cononinator/GeecPE2526/Simulation/LTSpice Hierarchical Design.docx

# LTSpice Hierarchical Design

I talked in the meeting about making a simulation for the Geec that can be expanded as need. Here’s a quick guide to how to make a hierarchical model in LTSpice (I’ve just spent the last 2 hours hitting my head against the wall for different parts).

# 1 Goal

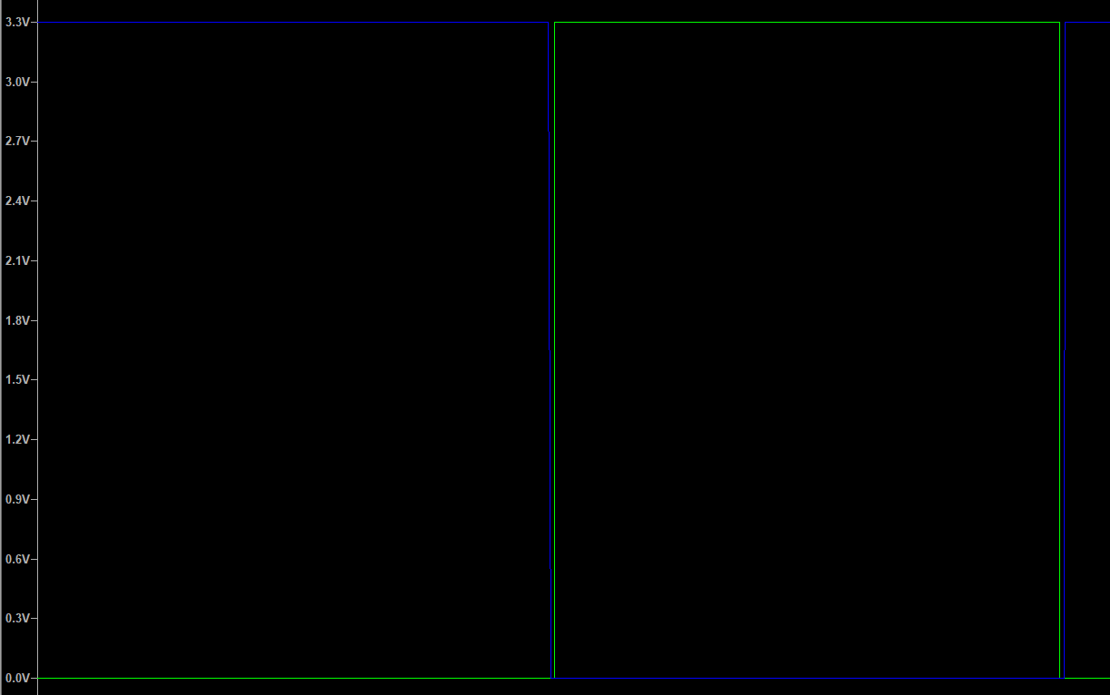
[picture p17: figure]

The goal for this part is to create a PWM generator, that will separate the high and low output signal by a short period of time (called Deadtime). This Electronic Stack Exchange (https://electronics.stackexchange.com/questions/644743/how-to-create-pwm-with-dead-time-on-ltspice) question details how the schematic should look.

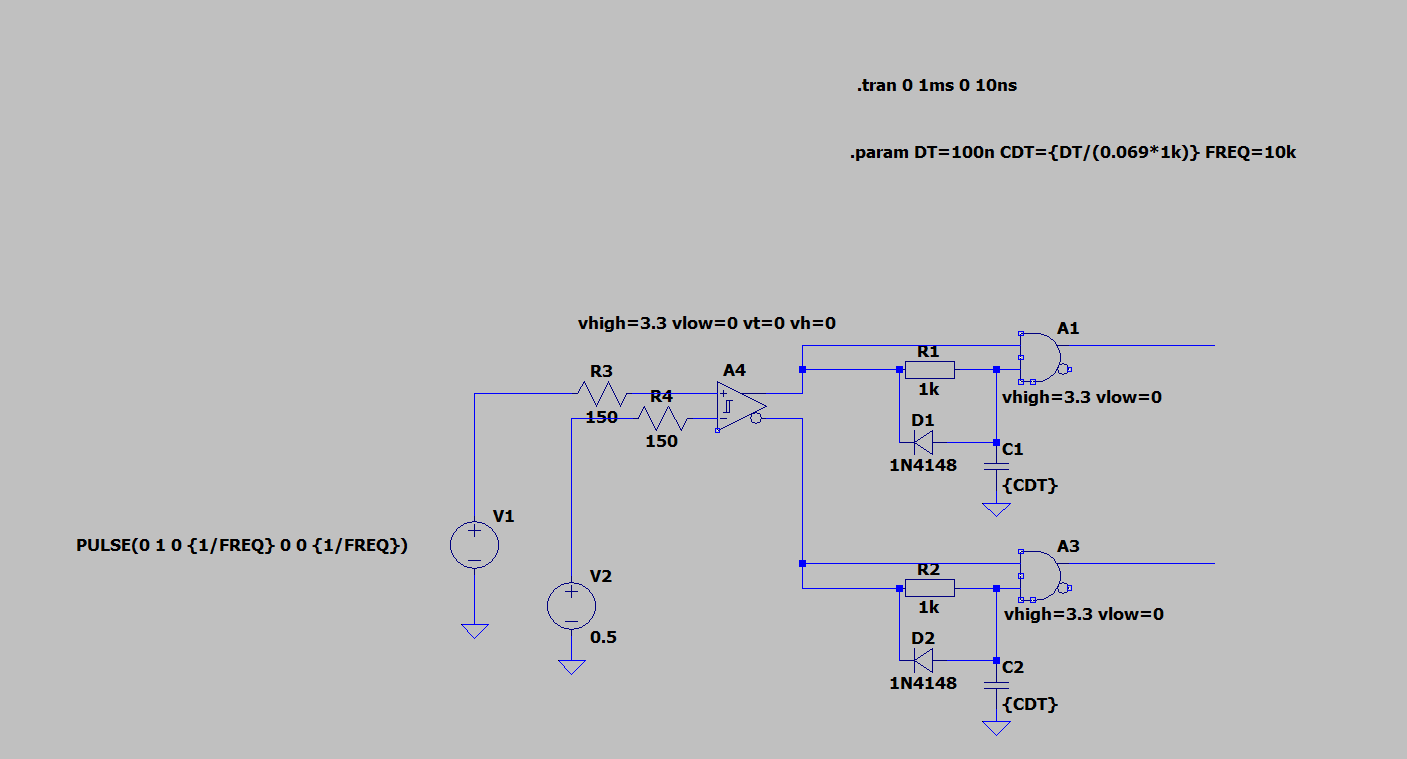
[picture p18: figure]

Here’s my implementation. V1 is a sawtooth wave, starting at 0V and going to 1V over a time of 1/FREQ. This connects to a comparator, where if V+ is greater than V- the output will be high. V2 connects to V- and sets the low limit.

Copy that file or create your own similar file. This one is called “PWMGen.asc”

FREQ is defined using the .PARAM SPICE directive.

# 2 Method

## 2.1 Replace inputs and outputs with net labels

In our case V2 should be replaced with an input pin that can go from 0-1V. Delete V2 and add a net label

Change the Port Type to input/output and change the name to something appropriate like Vset.

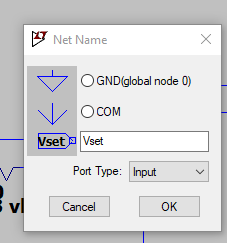
[picture p19: figure]

Repeat for PWMH and PWML

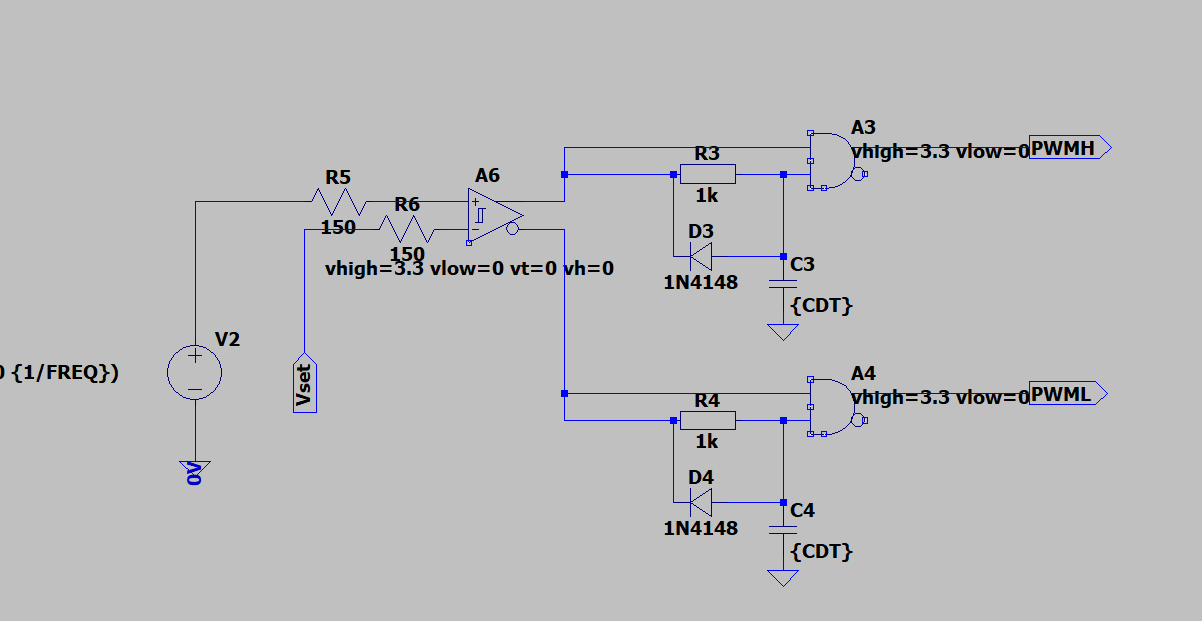
[picture p20: figure]

Resulting circuit should look like this.

## 2.2 Create a Symbol

Open or Generate this Sheet’s Symbol

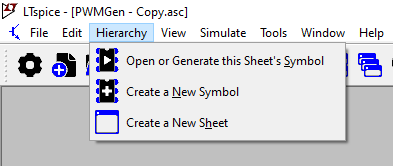
[picture p21: figure]

If you’re just creating a symbol a menu will appear, click Yes./

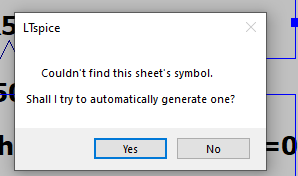
[picture p22: figure]

The auto generated symbol will appear like so:

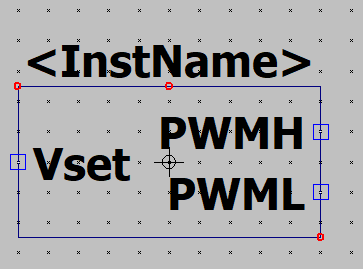
[picture p23: figure]

This is a little non-descript, so you can use the Draw menu to add some description or details to the symbol. I modified my symbol to look like so:

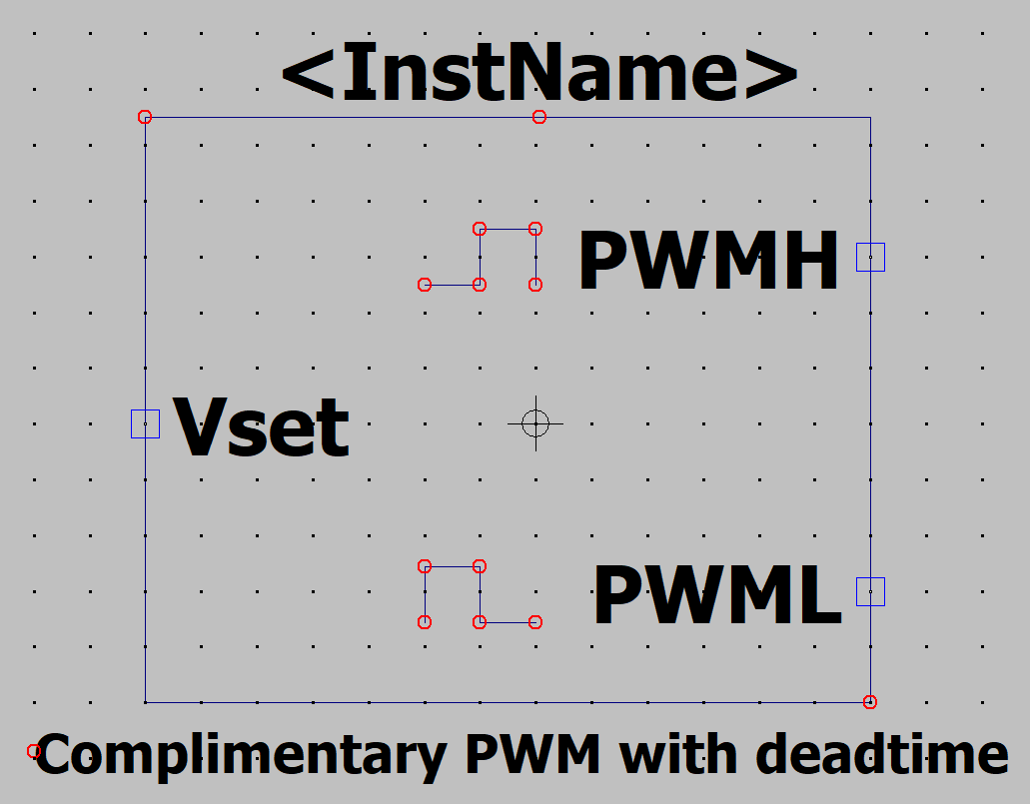
[picture p24: figure]

## 2.3 Importing into a new schematic

To add this block into a new schematic in LTSpice, create a new schematic in the same directory as the file created above. Add a part (shortcut P or the chip symbol in the hotbar).

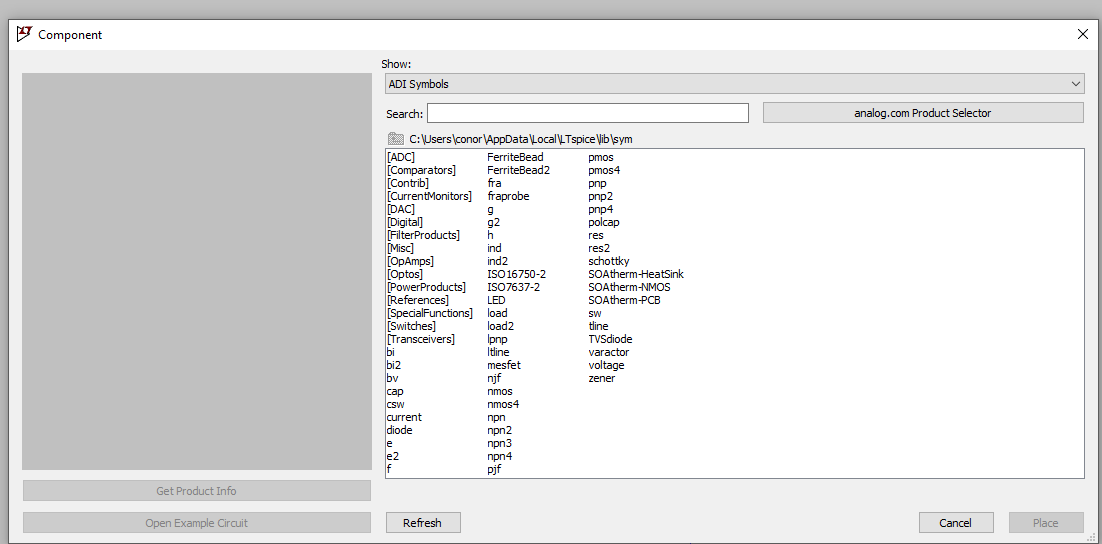
[picture p25: figure]

A menu like above will appear,

Change the Show menu to schematic directory.

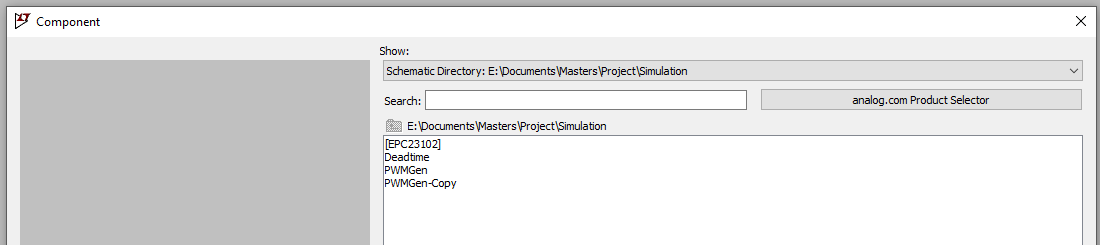
[picture p26: figure]

The part designed above should be available to add. You can then add the part to you schematic. I created this simple test schematic:

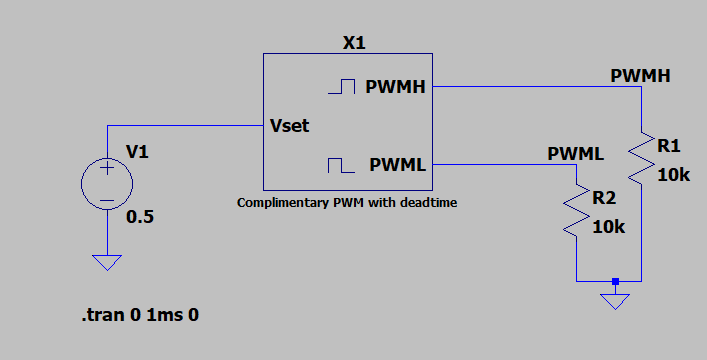
[picture p27: figure]

Which created the following graph:

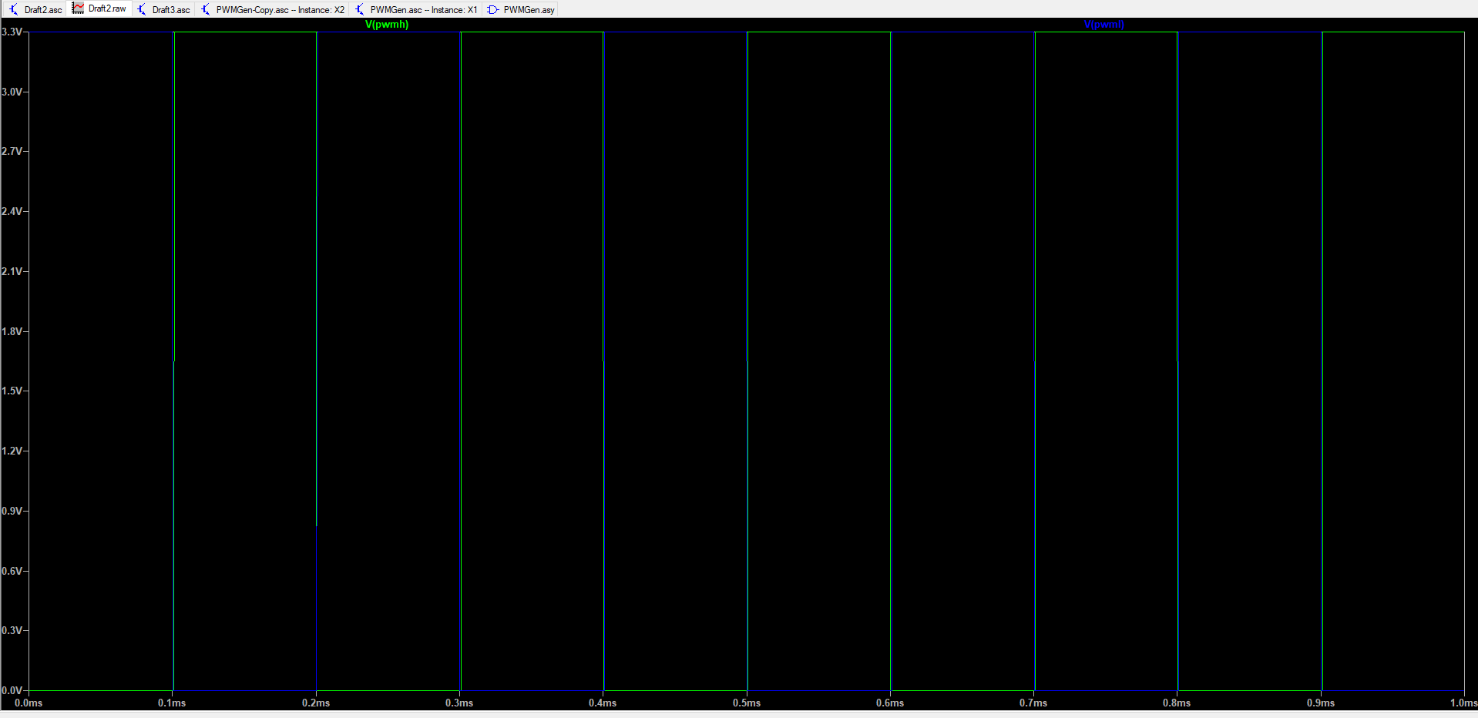
[picture p28: figure]

To keep files clearer you can also move the blocks to sub folders and still import them into LTSpice

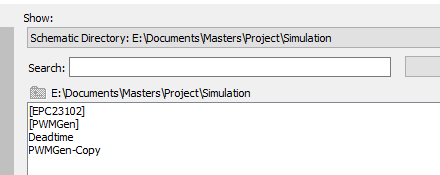
[picture p29: figure]

You need to move the symbol and schematic file into the sub folder i.e. “PWMGen.asc” & “PWMGen.asy”.
