cononinator/GeecPE2526/Write Ups/Conor Farrell Weekly Progress-07-02-26.pptx

## Conor Farrell Weekly Progress

06/02/26

## Power Electronics Bring Up

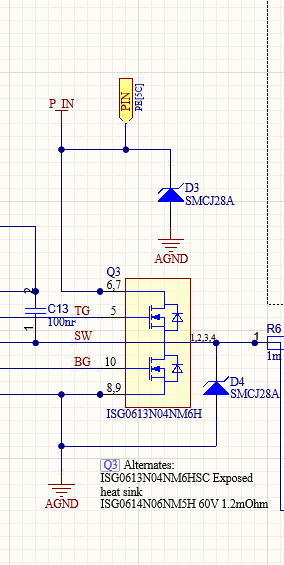
[picture p31: figure]

Problem
On power up, board went to constant current
~0.8V, 250mA(current limit)
Investigation
Checked hotspots with thermal camera. Saw U9 (Soft Start Gate Driver) was heating up.
Desoldered IC and the issue still appeared.
Checked Diode drop across TVS diodes (D3, D4) with multimeter. P_in -> AGND had a 0.6V drop, AGND->P_in was open circuit.
Solution
D3 and D4 desoldered and reorientated.

## LED Turn On

Power Rail LEDs:
- Red LEDs indicate 3.3V and 11V rails
- Power Supply drew 2mA on power up (with LEDs disconnected) @ 18V
Damage:
1 board missing U9 soft start IC. Shorted Soft Start resistor. Will use for testing as a sacrificial board.

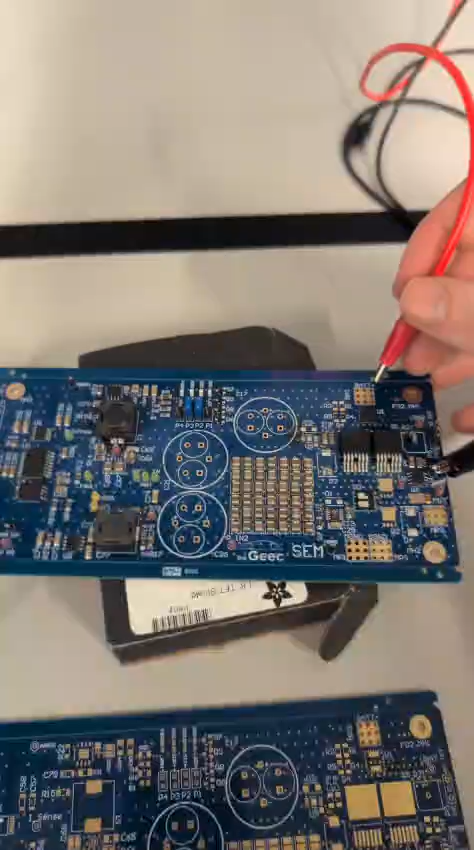
[picture p32: figure]
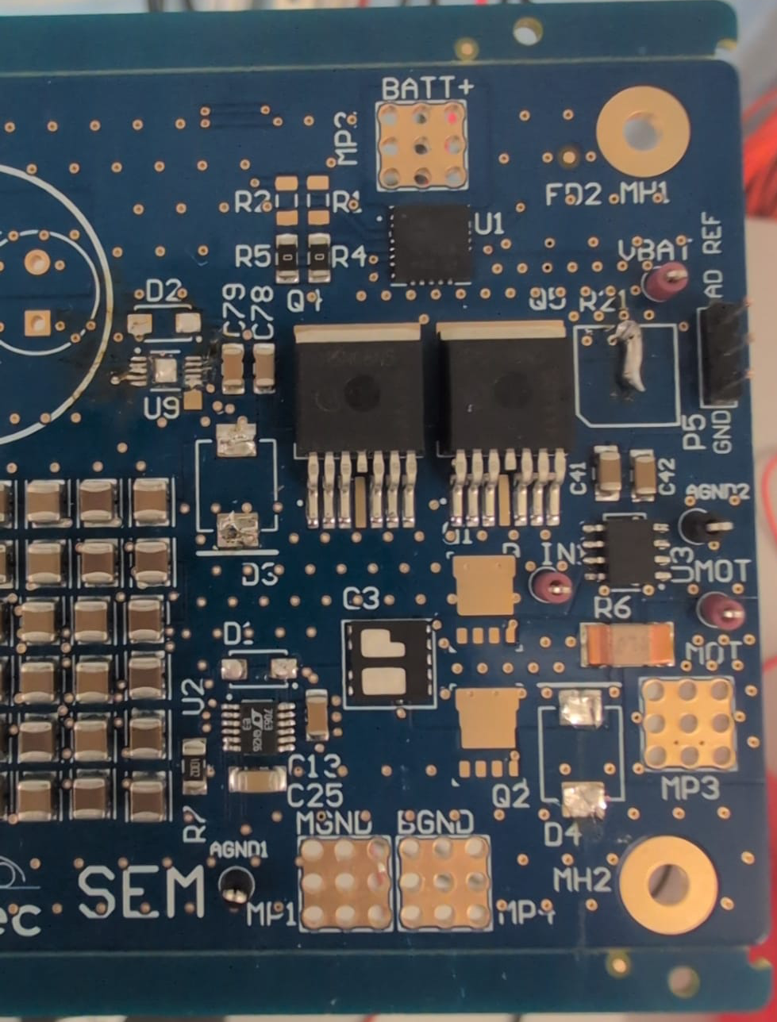
[picture p33: figure]

## Power Controller

- Circuit Design
- Altium Schematic Started, all components imported.

## Goal for Next Week

1. Track Test – (Monday) - No goals beside running the car well
2. Test Gate Drivers – Tuesday – No load Testing
3. Test Current Sensors – Thursday Morning – Minimum 2A load required
4. Build Current Controller on Breadboard – Tuesday, Wednesday, Thursday
5. Schematic Design – Finished End of Next Week
