cononinator/GeecPE2526/Write Ups/Midway Presentation.pptx

## Power Electronics For The Geec

Conor Farrell
2025-2026
MECE - 21359763

## Project Overview

- The GEEC (Galway Energy Efficient Car) is a participant in the Shell Eco Marathon.
- It’s entered in the prototype lithium-ion class.
- The highest score GEEC achieved was 354km/kWh or 23c to drive from here to Dublin.
Power Electronics Requirements:
- Drive an Electric Motor.
- Take Throttle input from the driver
- Fail Safe

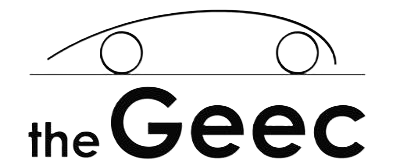
[picture p34: figure]
GEEC Logo

Notes: BG
GEEC – SEM prototype lithium ion
DAQ – voltage current power speed temp gps
Driver display
Benefit to mechanicals

## Current Power Electronics

- Inflexible
- Obsolete Components
- 2 Layer Design
- Large Loop Area, resulting in LC resonator
- Field Modifications

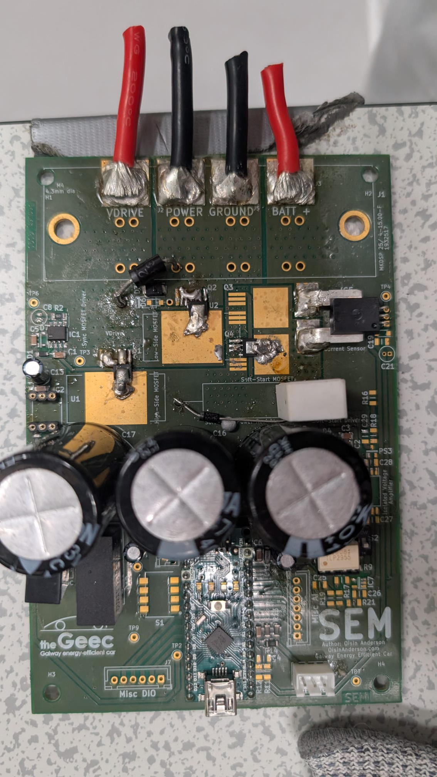
[picture p35: figure]

## The Project Scope

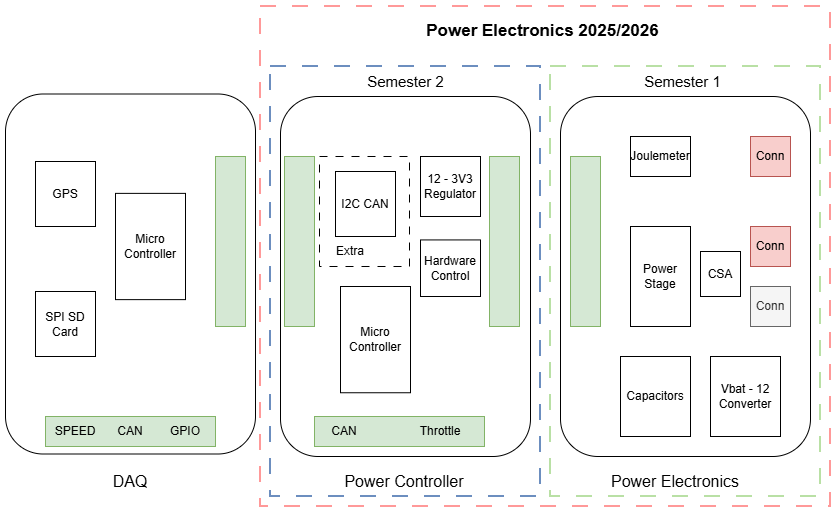
[picture p36: figure]

Semester 1:
Power Electronics
- 4 layer SMD
- Full isolation
Semester 2:
Power Controller
- 2 layer THT
- Closed Loop Feedback

## Brushless Motors

- Previous Projects Investigated Brushless Controllers & 48V control
- Theoretical Calculations show worse performance ~2%

## Current Control

- Hardware Limiting:
  - Cycle-by-Cycle (10-30kHz)
  - Latching
- Software Control:
  - ~10Hz
  - PID loop

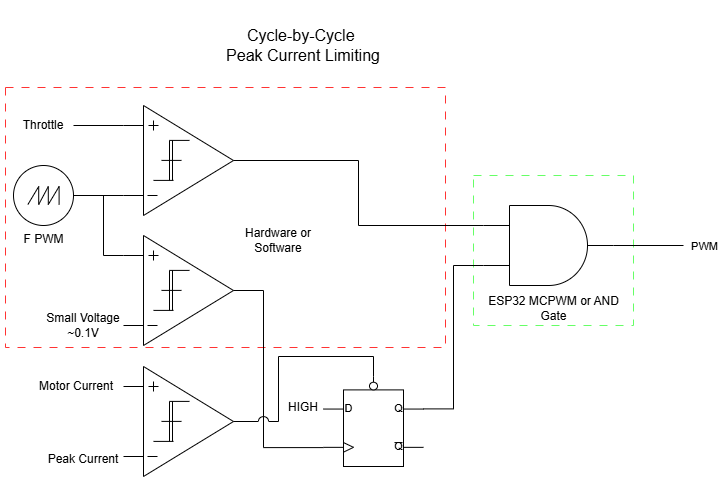
[picture p37: figure]
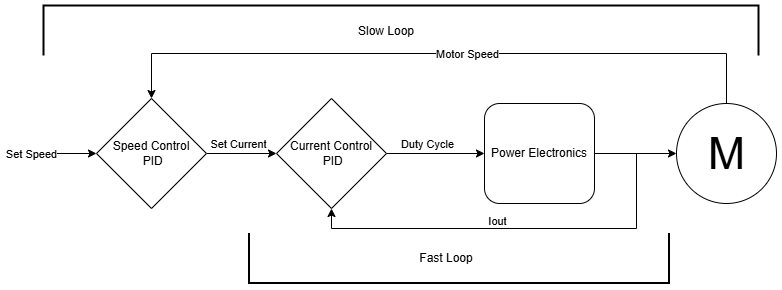
[picture p38: figure]

## Simulation

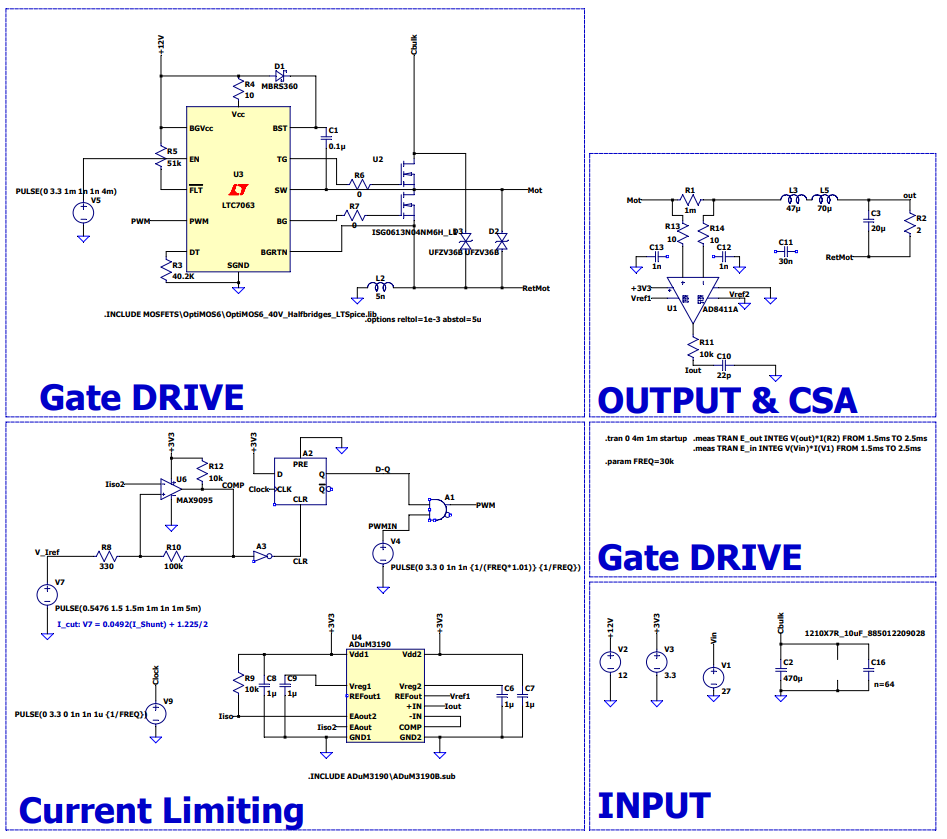
[picture p39: figure]

- Closed Loop Current Control
- Variable Current Limit

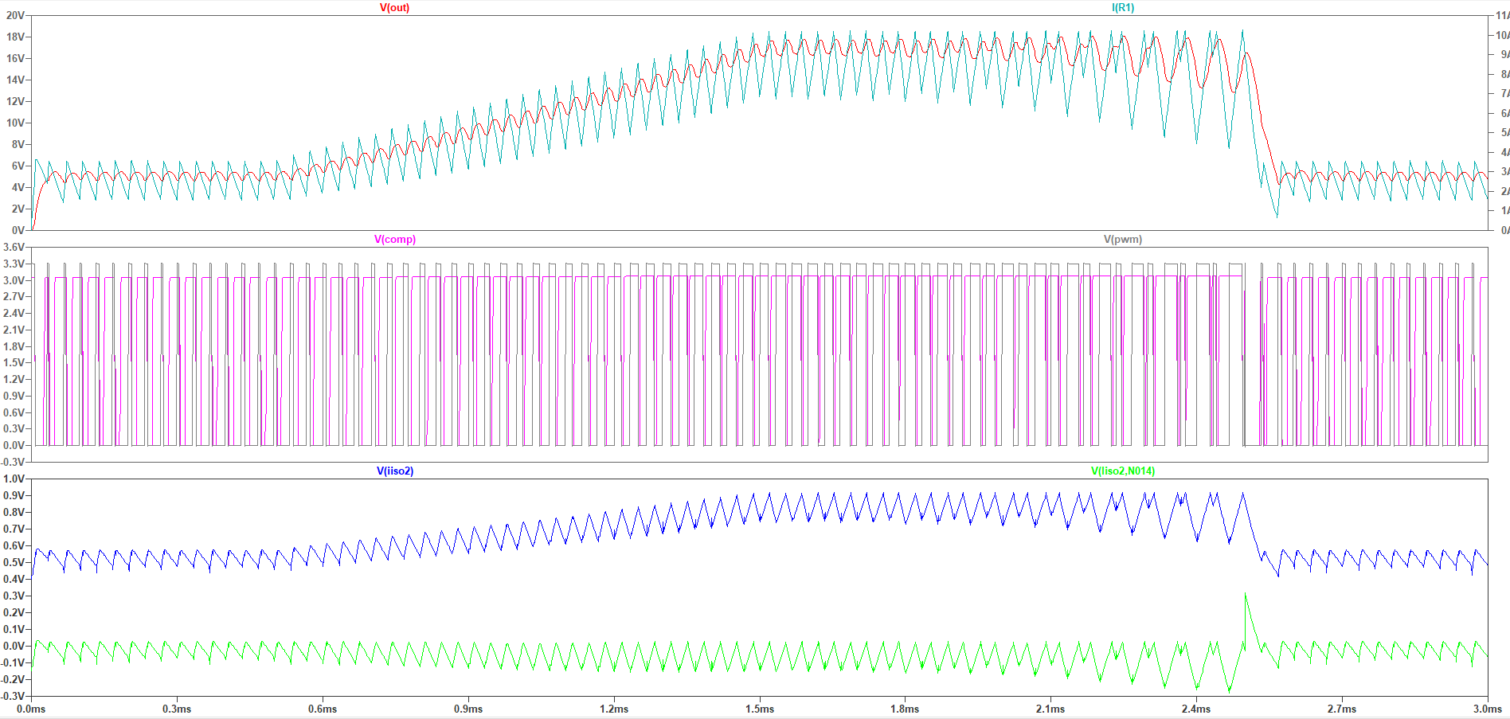
[picture p40: figure]

## Testing

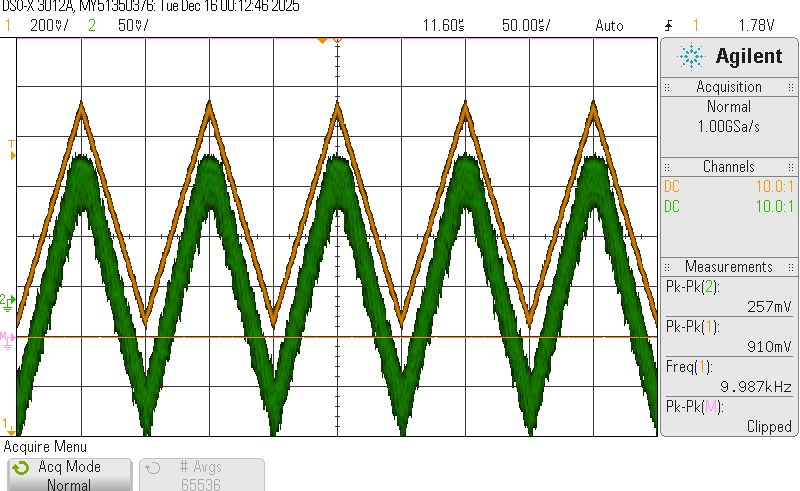
[picture p41: figure]

- Orange: AD8411A
- Green: ADuM3190  Expected AV: 1 Actual AV: 0.33
- Solution: Op-Amp (AV 2) and 800kHz low pass filter on Power Controller.

## Protection

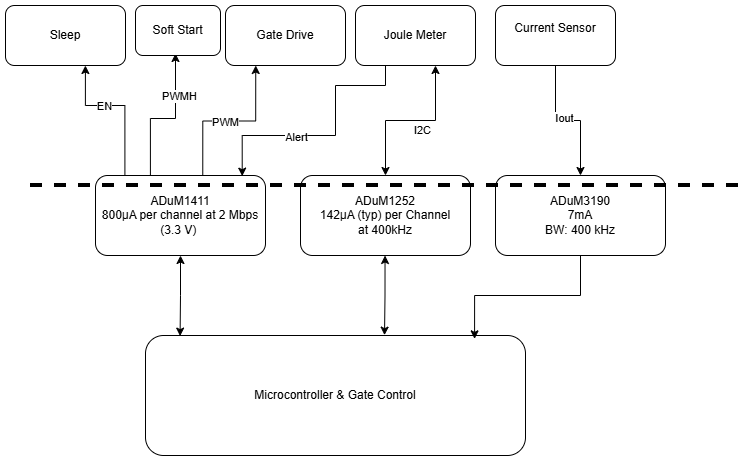
[picture p42: figure]

- Low power digital and analogue isolators.
  - Consumes 46mW
- TVS Diodes to shunt 15A at 38V

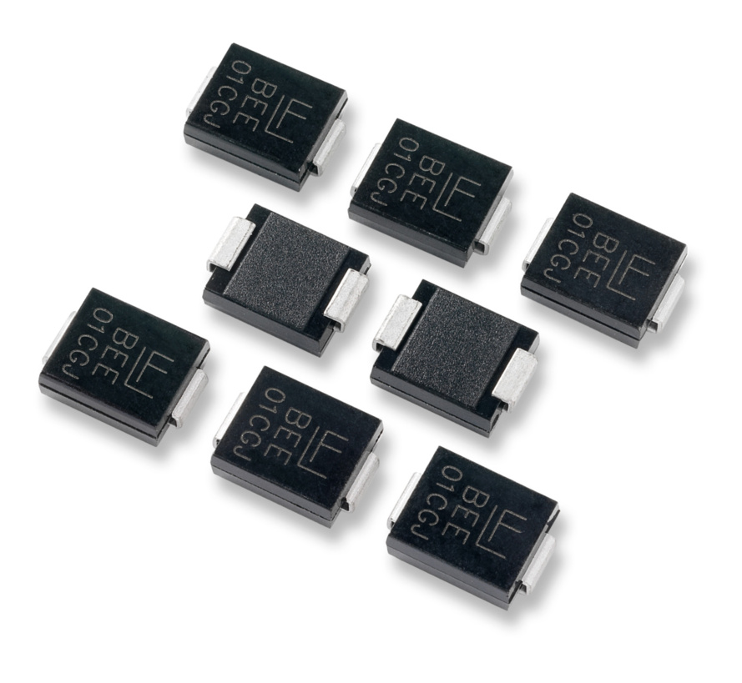
[picture p43: figure]
SMCJ30 | SMCJ Series Surface Mount | Littelfuse

## Schematic

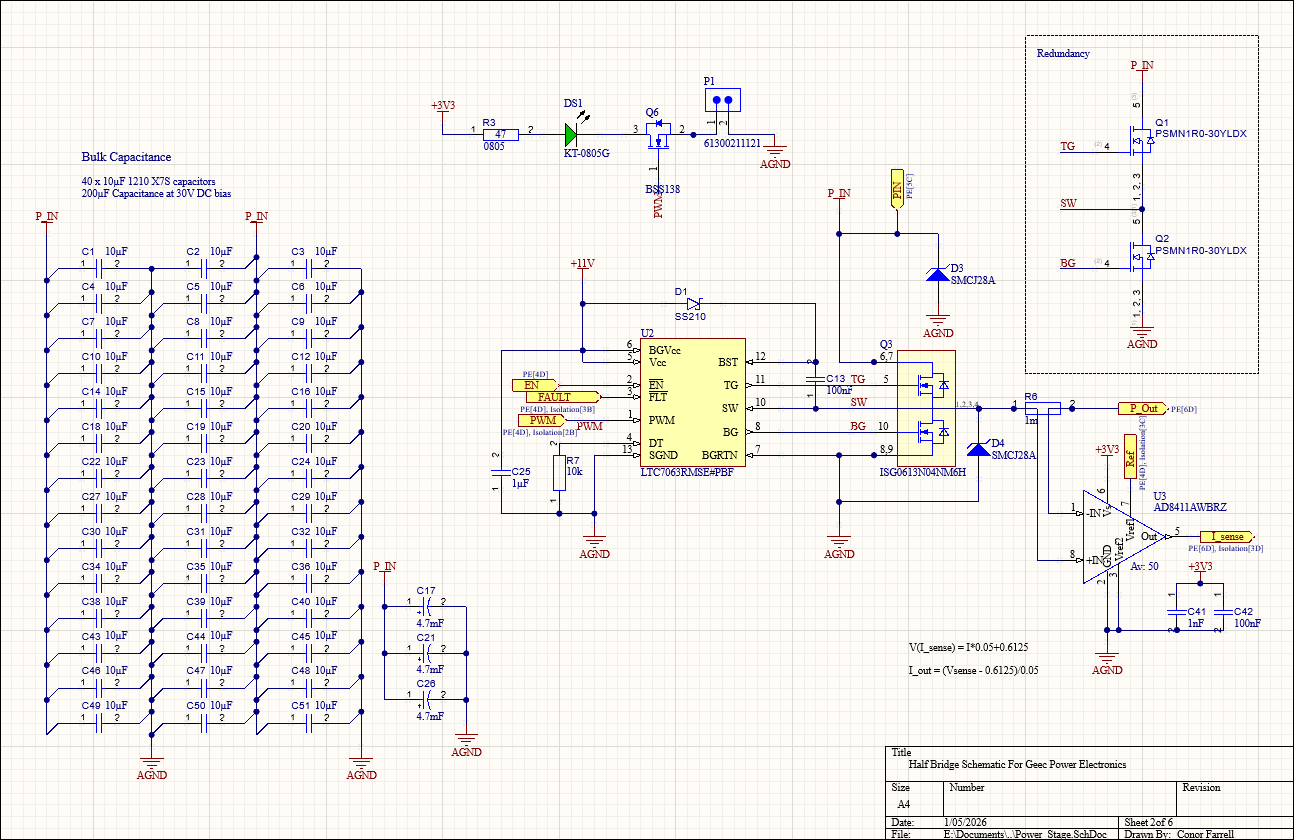
[picture p44: figure]

- Half Bridge Design
  - 40 10µF MLCC Capacitors & 3 4.7mF Electrolytic Capacitors
  - Redundant MOSFETS for easy Replacement
  - TVS Diodes Capable of shunting 15A @ 38V
  - Indicator LED with removable jumper.

## PCB Design

- 4 Layer Board, Isolated Ground planes
- Via Stitching on High current planes
- Minimisation of loop area and change in loop area
- Preliminary Design

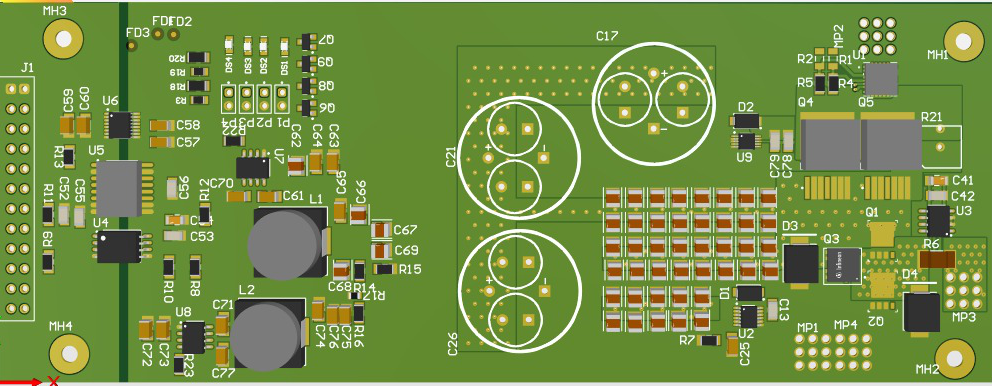
[picture p45: figure]

## This Semester

- Design Power Controller Board
- Assist in Design of DAQ Board
- Testing of Hardware
- Implement Control System
- Integrate the Design into the DAQ
- Determine Performance Improvement

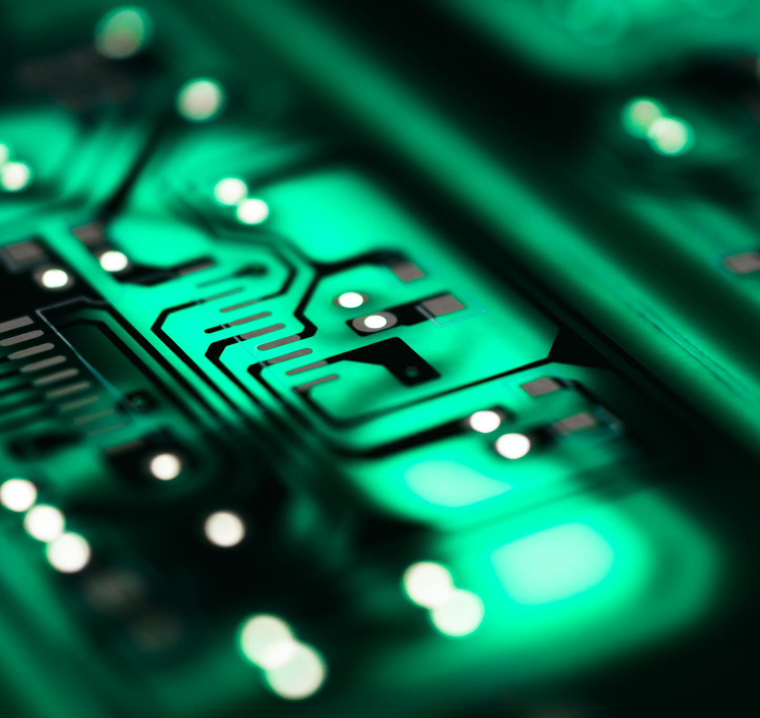
[picture p46: figure]
Close up of circuit board

## Thanks For Listening

Any Questions?
