cononinator/GeecPE2526/Simulation/ADuM3190/Notes for use of ADuM3190 LT Spice Improved Model.docx

ADuM3190.asy is the schematic symbol for ADuM3190.

ADuM3190B.sub is the sub-circuit model file.

Please store ADuM3190.asy in the LTspiceInstalledPath\lib\sym folder and ADuM3190.sub in LTspiceInstalledPath\lib\sub folder.

Open ADuM3190.asy with LTspice and click Edit Attributes button under Edit menu. Fill the path of ADuM3190.sub to the row of ModelFile.

Then ADuM3190 model can be selected and simulated with LTSpice.
