cononinator/GeecPE2526/Write Ups/Poster/Project Poster.pdf

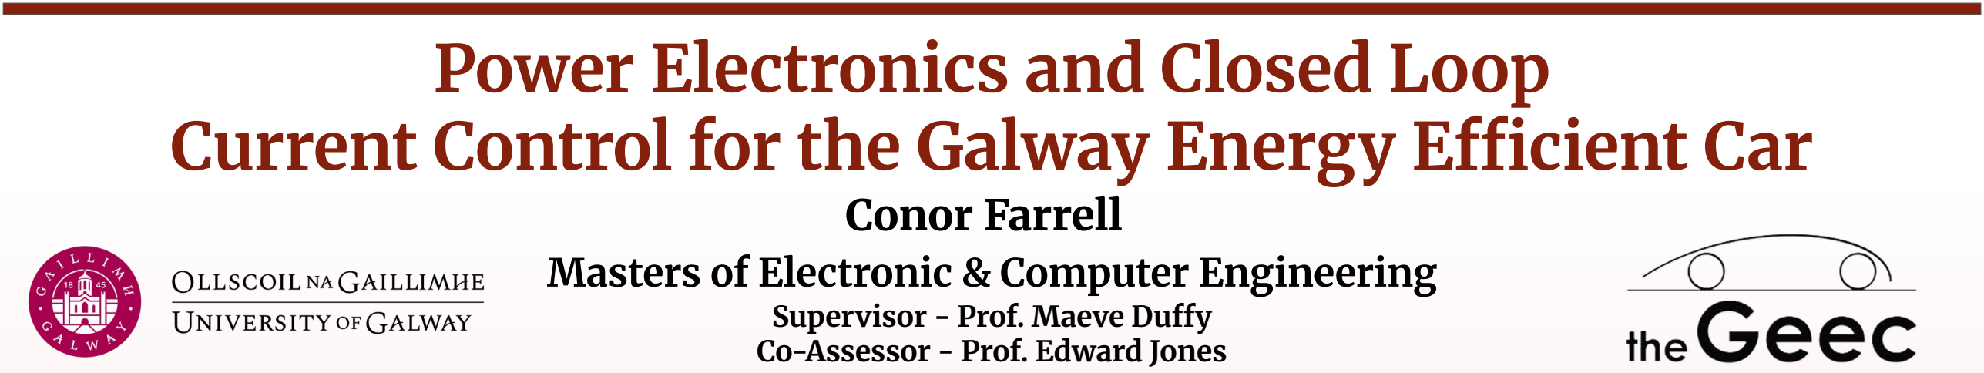
[picture p116: figure]
Power Electronics and Closed Loop; Conor Farrell; Supervisor - Prof. Maeve Duffy Co-Assessor - Prof. Edward Jones

# Current Control for the Galway Energy Efficient Car

## Masters of Electronic & Computer Engineering

Abstract | Hardware Current Control The Geec previously used open loop control with a fixed ramp rate to limit peak current. This relied on the driver to monitor the acceleration and caused high peak currents during acceleration. The new design uses a variable limit with a latching function to implement cycle-by-cycle peak current limiting. In real terms this allows for the removal of the ramp rate for acceleration, and relys on the peak current limit instead. The DC motor directly converts current to torque based on: Nm = Kt I

Working Principle
Instrument Amplifier: A high bandwidth current amplifier over a small resistor.
Comparator: Uses a fixed
hysteresis with VTL

: 1V and VTH

: 0.7V.

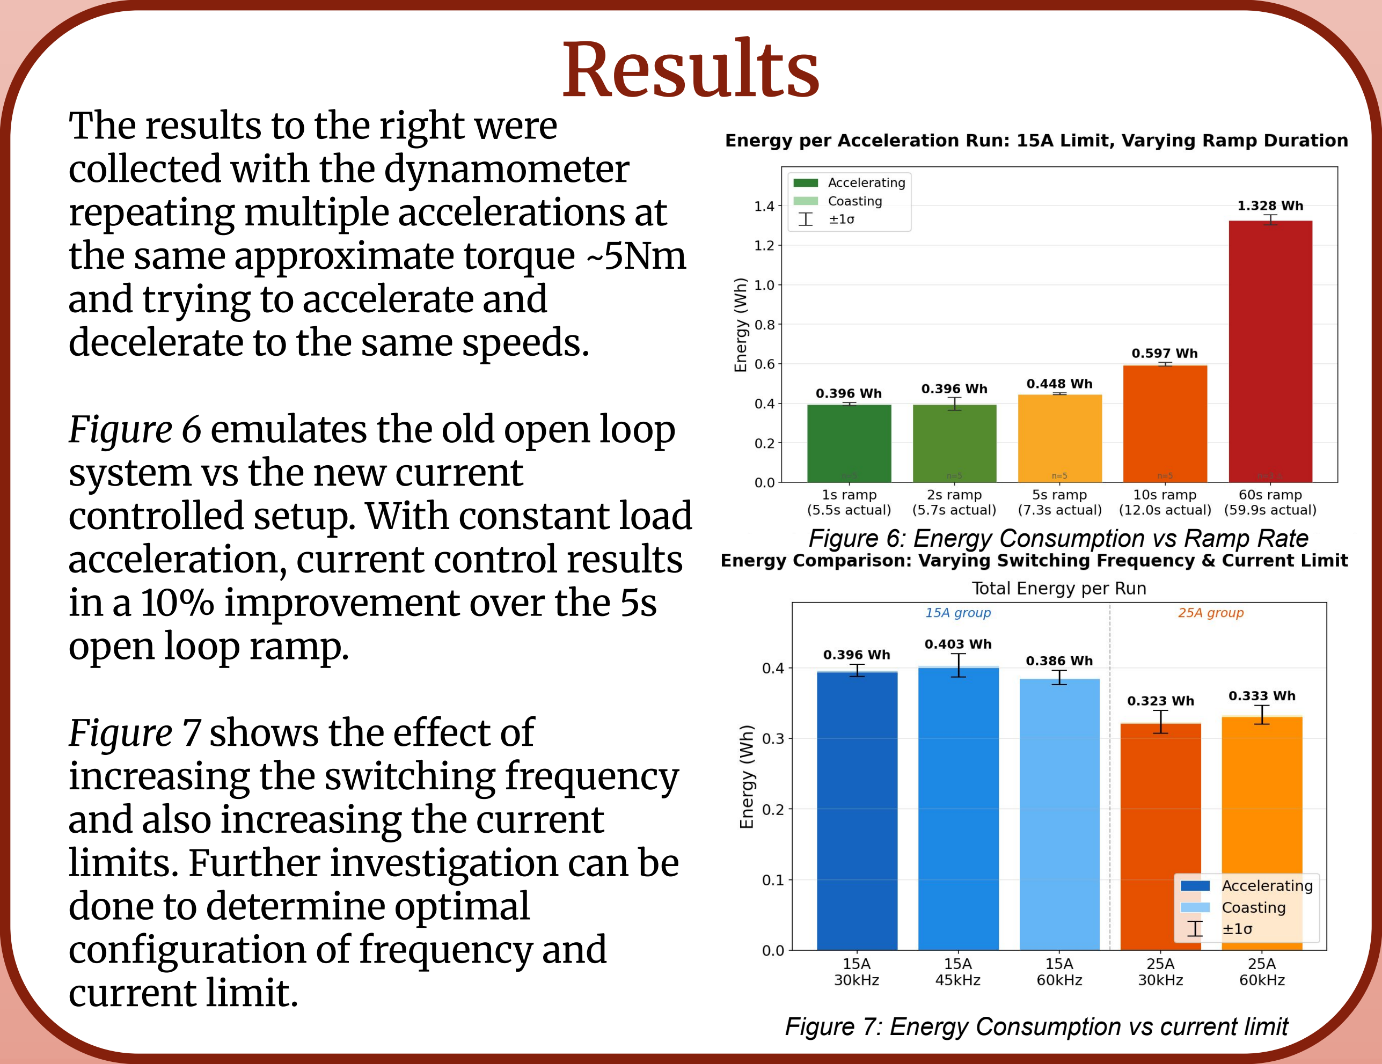
[picture p117: figure]
Results; The results to the right were collected with the dynamometer repeating multiple accelerations at the same approximate torque ~5Nm and trying to accelerate and decelerate to the same speeds.; Figure 6 emulates the old open loop system vs the new current controlled setup. With constant load acceleration, current control results in a 10% improvement over the 5s open loop ramp.; Figure 7 shows the effect of increasing the switching frequency and also increasing the current limits. Further investigation can be done to determine optimal configuration of frequency and current limit.
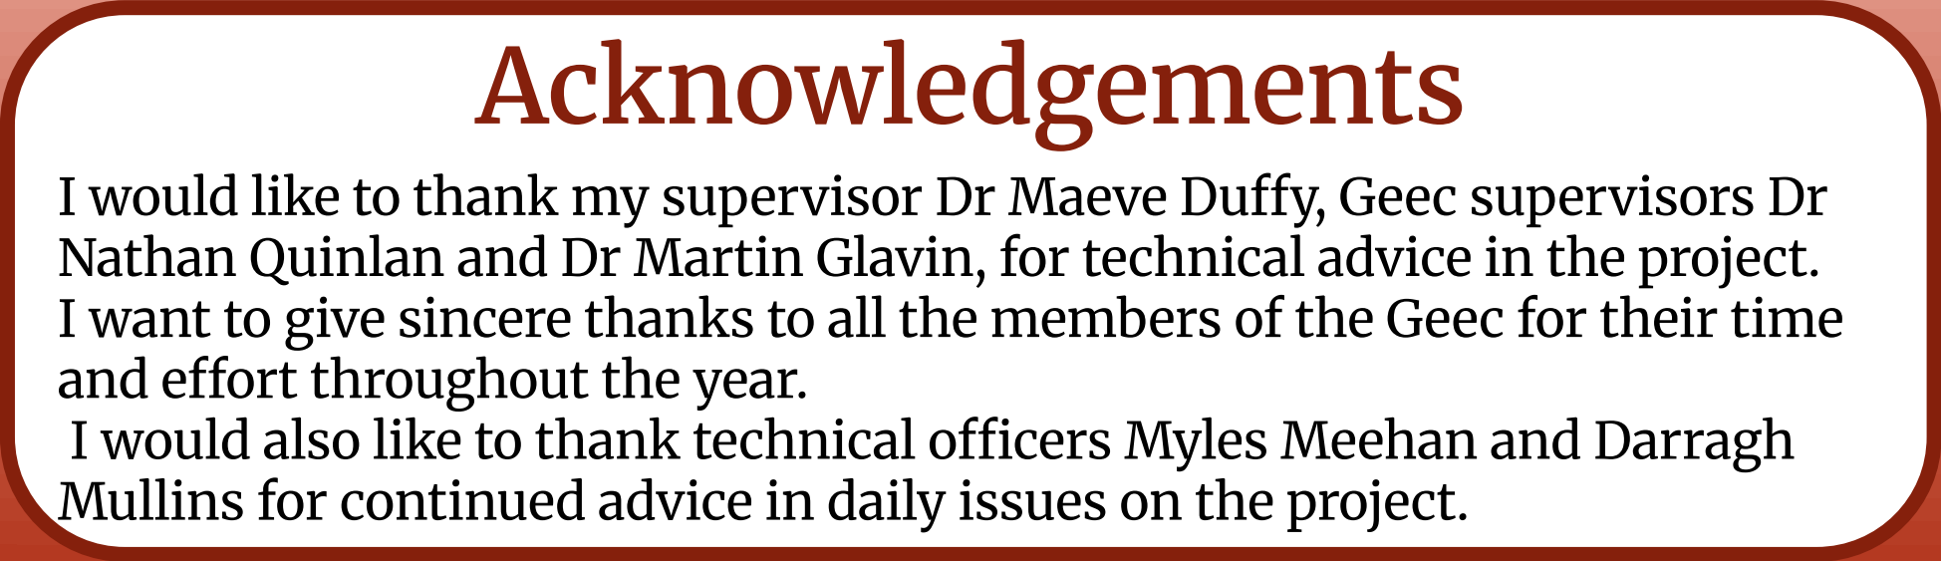
[picture p118: figure]
Acknowledgements; and effort throughout the year.

I would like to thank my supervisor Dr Maeve Duffy, Geec supervisors Dr Nathan Quinlan and Dr Martin Glavin, for technical advice in the project. I want to give sincere thanks to all the members of the Geec for their time

I would also like to thank technical officers Myles Meehan and Darragh Mullins for continued advice in daily issues on the project.

# PCB Design

Power Controller Board
The power controller primarily handles the implementation of hardware-based current control, and it also integrates:
CAN: This allows for messages to the DAQ and Steering Wheel, improving data analysis, feedback from sensors and improvements to driver information.
Motor Voltage Sensor: Another isolated amplifier with a low pass filter allows for an accurate voltage at the motor terminals.

Power Electronics Board
The power electronics board is a 4 layer PCB with several key elements: Press Fit Connector: High power M5 screw connector for ring terminals rated for 60-80A, chosen for its low-resistance.
Digital Joulemeter: I²C joulemeter with an integrated shunt resistor, allowing for immediate and constant measurement of energy, power current etc.
Functional Isolation: Using both digital and analog isolators to create a functional isolation between the microcontroller and the primary power electronics.
Indicator LED & Test Points: Optional LEDs to indicate power integrity and the activity of PWM and startup, important signals expose a testpoint

Throttle: The driver can directly control the duty cycle by the throttle. ESP32: This high performance μC integrates a hardware PWM controller with an 80MHz clock, a CAN peripheral and FreeRTOS integration allowing multiple concurrent tasks for CAN, throttle, data collection, etc.

Half-Bridge MOSFET:
Infineon MOSFET that
integrates both the high and low side MOSFET into one
IC.
Soft Start: 10Ω resistor to charge capacitor bank, with parallel MOSFETs.

Finished PCBs

Figure 1: Power Electronics Stackup

Figure 2: Power Controller Stackup.

Figure 3: Finished PCBs

Figure 5: PWM limited by comparator with latch.

Figure 4: Current Control Schematic.

Figure 6: Energy Consumption vs Ramp Rate

Figure 7: Energy Consumption vs current limit

Conclusion
On the race track the Geec will have to accelerate in a on flat ground, up hills and around corners. The fixed limit will regulate acceleration, even in dynamic conditions.

This project introduces a closed-loop current control system for the Galway Energy Efficient Car (Geec), in order to improve efficiency and create repeatable and improved accelerations.
This design is a buck-based brushed DC motor controller. It uses a high-frequency current sensor to implement cycle-by-cycle peak current limiting with a variable, latching limit, enabling dynamic regulation of motor current.
The hardware is divided between two PCBs, the power electronics board primarily a buck converter and the power controller board an isolated control board allowing communication with further devices in the vehicle.

Differential Amplifier: The rail-to-rail Op Amp, outputs 0V when DAC > Isense, and a gain of 6.8 on the difference between Isense and DAC.

DAC: The DAC can provide an output voltage up to 4V.

Flip Flop: The comparator pulls Reset low, Output Q is latched low, on the next clock cycle Q returns high, D is tied high.
