cononinator/GeecPE2526/Orders/PowerElectronicPCB.pdf

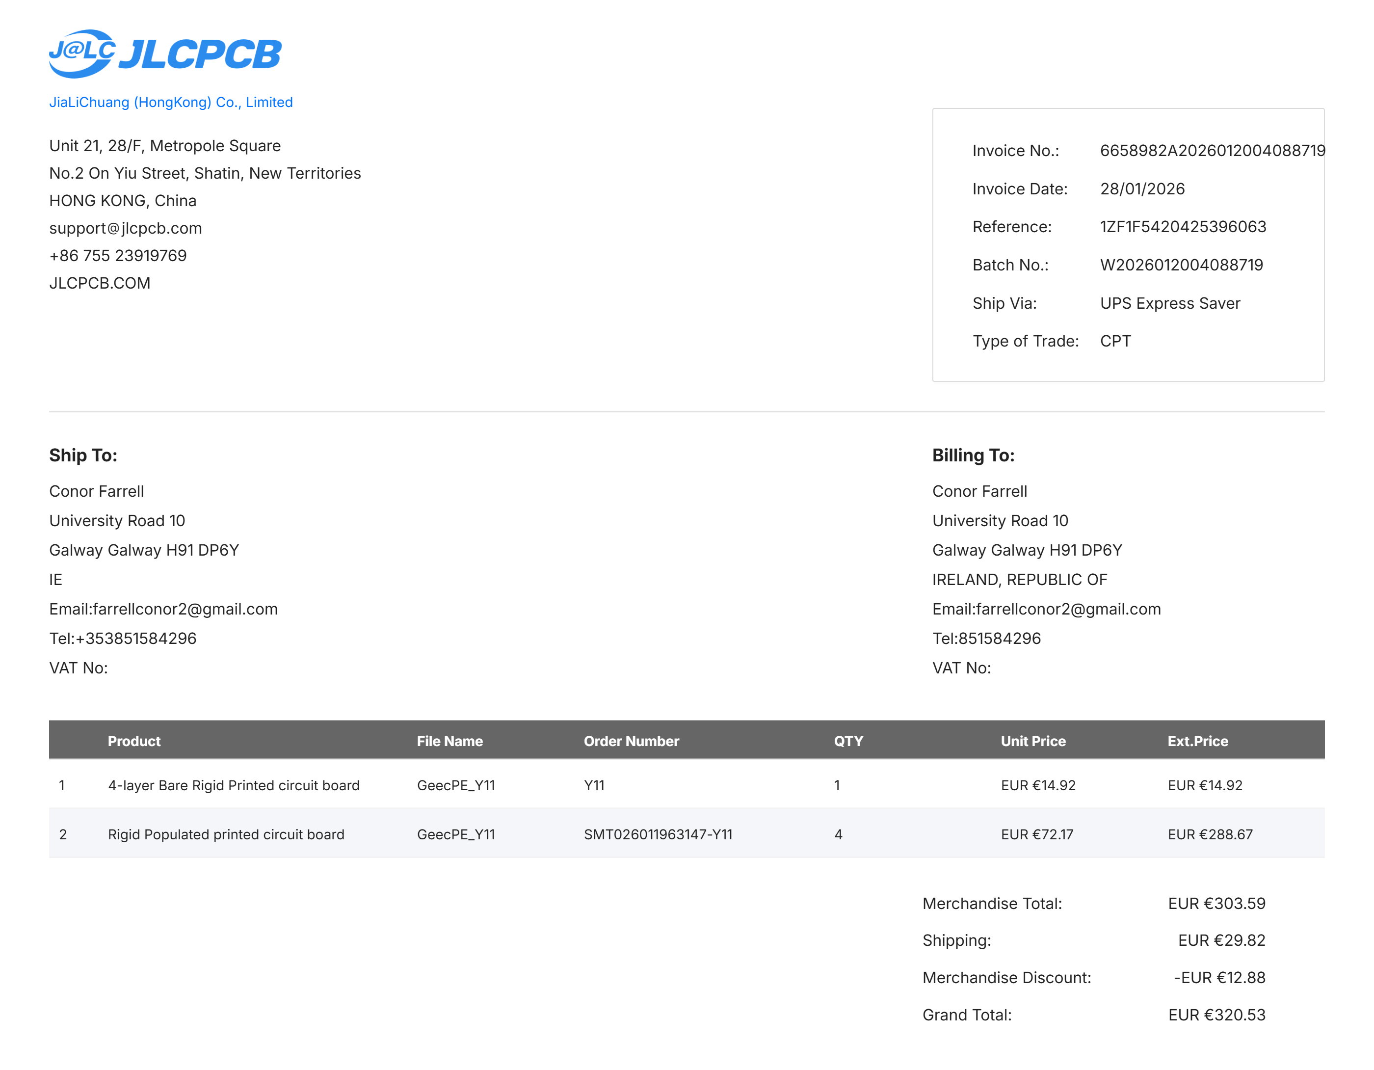
[picture p124: figure]
