cononinator/GeecPE2526/Write Ups/Poster/dyno_sweep_20260408-095354.csv

Voltage | Current | Power | Energy | Temperature | MotorVoltage | MotorCurrent | MeasuredDutyCycle | TargetDutyCycle | WheelSpeed | Phase | Repeat | CurrentLimit_A | Timestamp_s | Dyno_Timestamp_ms | Dyno_Speed_kmh | Car_Speed_kmh | Dyno_Torque_Nm | Dyno_Power_W
28.341 | 0.072 | 2.091 | 3185.871 | 17.62 | 0.204 | 3.8644 | 0.0 | 0.0 | 0.0 | Accelerating | 1.0 | 20.0 | 0.11863899230957031
28.341 | 0.067 | 1.904 | 3186.086 | 17.62 | 0.174 | 3.8529 | 0.0 | 0.0 | 0.0 | Accelerating | 1.0 | 20.0 | 0.21995139122009277
28.341 | 0.07 | 1.964 | 3186.301 | 17.62 | 0.174 | 3.8644 | 0.0 | 0.0 | 0.0 | Accelerating | 1.0 | 20.0 | 0.24214887619018555
28.341 | 0.067 | 1.883 | 0.169 | 17.62 | 0.279 | 3.8644 | 0.0 | 0.0 | 0.0 | Accelerating | 1.0 | 20.0 | 0.29845643043518066
28.328 | 0.329 | 9.306 | 0.737 | 17.62 | 2.707 | 5.7497 | 9.0 | 100.0 | 0.0 | Accelerating | 1.0 | 20.0 | 0.3592236042022705
28.256 | 2.093 | 56.101 | 5.384 | 17.62 | 4.521 | 18.3722 | 20.0 | 100.0 | 0.0 | Accelerating | 1.0 | 20.0 | 0.389859676361084
28.234 | 2.616 | 74.396 | 12.618 | 17.62 | 6.049 | 18.1537 | 30.0 | 100.0 | 0.0 | Accelerating | 1.0 | 20.0 | 0.4437415599822998
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
