cononinator/GeecPE2526/Write Ups/Poster/dyno_sweep_20260408-095658.csv

Voltage | Current | Power | Energy | Temperature | MotorVoltage | MotorCurrent | MeasuredDutyCycle | TargetDutyCycle | WheelSpeed | Phase | Repeat | CurrentLimit_A | Timestamp_s | Dyno_Timestamp_ms | Dyno_Speed_kmh | Car_Speed_kmh | Dyno_Torque_Nm | Dyno_Power_W
28.244 | 0.079 | 2.254 | 1987.476 | 17.87 | 0.264 | 3.8414 | 0.0 | 0.0 | 0.0 | Accelerating | 1.0 | 25.0 | 0.11753678321838379
28.244 | 0.067 | 1.915 | 1987.699 | 17.87 | 0.878 | 4.192 | 0.0 | 0.0 | 0.0 | Accelerating | 1.0 | 25.0 | 0.24315881729125977
28.244 | 0.072 | 2.063 | 1987.907 | 17.87 | -0.111 | 3.8644 | 0.0 | 0.0 | 0.0 | Accelerating | 1.0 | 25.0 | 0.28787708282470703
28.244 | 0.065 | 1.851 | 0.1 | 17.87 | 0.204 | 3.8529 | 0.0 | 0.0 | 0.0 | Accelerating | 1.0 | 25.0 | 0.3274381160736084
28.241 | 0.242 | 6.845 | 0.415 | 18.0 | 2.512 | 5.2439 | 5.0 | 100.0 | 0.0 | Accelerating | 1.0 | 25.0 | 0.3751547336578369
28.138 | 2.688 | 75.645 | 3.333 | 17.87 | 4.251 | 21.9129 | 16.0 | 100.0 | 0.0 | Accelerating | 1.0 | 25.0 | 0.4094715118408203
28.075 | 4.046 | 113.612 | 13.486 | 18.0 | 7.473 | 23.2004 | 27.0 | 100.0 | 0.0 | Accelerating | 1.0 | 25.0 | 0.4733703136444092
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
