cononinator/GeecPE2526/Write Ups/PowerElectronics/Current_Sense_Amplifier_Comparison_and_Error_Tool.xlsm

Sheet: Table of Contents
Worksheet | Description
Comparison | Allows the user to select between 2 and 5 of Texas Instruments standard current sense amplifiers
 | The tool will provide a table comparing the selected devices on basic parameters as well
 | as plotting the root-sum-square error based on user-provided system parameters
TI Parametric | Expanded parametric selection table listing the key accuracy and performance parameters
Selection | for each gain option of the products this tool supports.
About | General information about the calculator.
Help | How to use the calculator and where to get further support.
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
