cononinator/GeecPE2526/Write Ups/PowerElectronics/Efficiency Comparison.xlsx

Output Current | LMR33630 Vin=21.0V | LMR33630 Vin=28.5V | LMR33630 Vin=36.0V | LMR551625 Vin=21.0V | LMR551625 Vin=28.5V | LMR551625 Vin=36.0V
0.001 | 85.576 | 83.758 | 82.023 | 84.819 | 82.425 | 79.973
0.0015 | 89.454 | 87.854 | 86.318 | 88.772 | 86.557 | 84.239
0.002 | 91.528 | 90.056 | 88.639 | 90.89 | 88.783 | 86.548
0.0025 | 92.82 | 91.431 | 90.092 | 92.21 | 90.174 | 87.995
0.003 | 93.701 | 92.372 | 91.088 | 93.112 | 91.125 | 88.986
0.0035 | 94.341 | 93.055 | 91.813 | 93.766 | 91.818 | 89.709
0.004 | 94.827 | 93.575 | 92.364 | 94.263 | 92.344 | 90.258
0.0045 | 95.208 | 93.982 | 92.797 | 94.654 | 92.757 | 90.69
0.005 | 95.515 | 94.311 | 93.147 | 94.968 | 93.09 | 91.038
0.0055 | 95.768 | 94.582 | 93.435 | 95.227 | 93.365 | 91.326
0.006 | 95.979 | 94.809 | 93.676 | 95.444 | 93.595 | 91.566
0.0065 | 96.159 | 95.002 | 93.881 | 95.629 | 93.79 | 91.771
0.007 | 96.314 | 95.168 | 94.058 | 95.787 | 93.959 | 91.947
0.0075 | 96.448 | 95.312 | 94.212 | 95.925 | 94.105 | 92.1
0.008 | 96.566 | 95.439 | 94.346 | 96.046 | 94.233 | 92.235
0.0085 | 96.671 | 95.551 | 94.466 | 96.153 | 94.347 | 92.354
0.009 | 96.764 | 95.651 | 94.572 | 96.248 | 94.448 | 92.46
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
