cononinator/GeecPE2526/Write Ups/PowerElectronics/LoadRegulation.xlsx

xVout1 | Vout1 | Vin1 | xVin1 | Vin2 | xVin2 | Vout2 | xVout2
0 | 12.14643669 | 21 | 0 | 20.99811935 | 0 | 12.00610065 | 0
3.763940185 | 12.13871765 | 21 | 100.0000047 | 21 | 100.0000047 | 12.00557518 | 0.4659523256
4.164117854 | 12.13822937 | 26.40455818 | 103.6125468 | 21.1415596 | 100.1043711 | 12.0067091 | 1.080450602
4.264467862 | 12.13824558 | 26.40846443 | 103.6151662 | 21.42354965 | 100.2919744 | 12.00791073 | 1.464155503
5.073961802 | 12.14042091 | 26.41229439 | 103.6177273 | 21.42777061 | 100.2947683 | 12.00810528 | 1.736567356
5.842011888 | 12.1458149 | 26.4165802 | 103.6205795 | 21.43169022 | 100.2973877 | 12.00711727 | 2.199842129
6.32298179 | 12.15083027 | 26.42082977 | 103.6234316 | 21.43591499 | 100.3001817 | 12.00558567 | 2.837157808
7.092021406 | 12.15937901 | 26.42518997 | 103.6262838 | 21.44004822 | 100.3029174 | 12.00679016 | 3.623194061
7.765076589 | 12.16332436 | 26.42691231 | 103.627448 | 21.44432068 | 100.3057696 | 12.00808811 | 4.251196515
8.143659215 | 12.16401196 | 26.43488693 | 103.6328031 | 21.44831085 | 100.3084471 | 12.00596237 | 5.070993211
8.49267235 | 12.16367531 | 26.43640709 | 103.6337926 | 21.45279121 | 100.3114157 | 12.0055685 | 5.352310836
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
