cononinator/GeecPE2526/Investigations/Capacitor Requirements - Copy.xlsx

Sheet: Sheet1
Frequency | 50000 |  | Capacitance (F) | 0.004002 |  | Suitable Cap
Inductance | 7e-05 |  | Num 10uF @ 29V DC Bias | 800.3402807 |  | GCM32EC71H106KA03L |  |  |  |  |  |  |  | +80% Duty Cycle @ 10A 15kHz
Vin | 29.4 |  | Area of 1210 package | 14.7 |  |  |  |  |  |  |  |  |  | 0.5V Ripple
Irms | 20 |  | Board Area (mm2) | 11765.00213 |  |  |  |  |  |  |  |  |  | 200uF
Ripple Voltage | 0.025 |  |  |  |  |  |  |  |  |  |  |  |  | 40 Capacitors
Duty | Vout | Ripple Current (A) | Imin | Imax | Pout | Energy/Cycle | Time On | Idc | Edc | E Capacitor | Capacitor | Ein vs Eout | RMS Capacitor Current
0.005 | 0.147 | 0.04179 | 19.95821 | 20.04179 | 2.94 | 5.88e-05 | 1e-07 | 0.1 | 2.94e-07 | 5.8506e-05 | 7.963385793e-05 | 0 | 1.410672566
0.01 | 0.294 | 0.08316 | 19.91684 | 20.08316 | 5.88 | 0.0001176 | 2e-07 | 0.2 | 1.176e-06 | 0.000116424 | 0.0001584673756 | 0 | 1.989969082
0.015 | 0.441 | 0.12411 | 19.87589 | 20.12411 | 8.82 | 0.0001764 | 3e-07 | 0.3 | 2.646e-06 | 0.000173754 | 0.000236500553 | 0 | 2.431033316
0.02 | 0.588 | 0.16464 | 19.83536 | 20.16464 | 11.76 | 0.0002352 | 4e-07 | 0.4 | 4.704e-06 | 0.000230496 | 0.00031373339 | 0 | 2.79996773
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
