cononinator/GeecPE2526/Write Ups/PowerElectronics/amCharts (1).xlsx

Output Current | Efficiency (Log-Scale)@ Vin=21.0V | Efficiency (Log-Scale)@ Vin=28.5V | Efficiency (Log-Scale)@ Vin=36.0V
0.001 | 84.819 | 82.425 | 79.973
0.0015 | 88.772 | 86.557 | 84.239
0.002 | 90.89 | 88.783 | 86.548
0.0025 | 92.21 | 90.174 | 87.995
0.003 | 93.112 | 91.125 | 88.986
0.0035 | 93.766 | 91.818 | 89.709
0.004 | 94.263 | 92.344 | 90.258
0.0045 | 94.654 | 92.757 | 90.69
0.005 | 94.968 | 93.09 | 91.038
0.0055 | 95.227 | 93.365 | 91.326
0.006 | 95.444 | 93.595 | 91.566
0.0065 | 95.629 | 93.79 | 91.771
0.007 | 95.787 | 93.959 | 91.947
0.0075 | 95.925 | 94.105 | 92.1
0.008 | 96.046 | 94.233 | 92.235
0.0085 | 96.153 | 94.347 | 92.354
0.009 | 96.248 | 94.448 | 92.46
0.0095 | 96.333 | 94.539 | 92.555
0.01 | 96.41 | 94.621 | 92.64
0.015 | 96.901 | 95.142 | 93.187
0.02 | 97.148 | 95.404 | 93.462
0.025 | 97.297 | 95.563 | 93.628
0.03 | 97.396 | 95.668 | 93.739
0.035 | 97.467 | 95.744 | 93.818
0.04 | 97.521 | 95.801 | 93.877
0.045 | 97.563 | 95.845 | 93.924
0.05 | 97.596 | 95.88 | 93.96
0.055 | 97.623 | 95.909 | 93.99
0.06 | 97.646 | 95.933 | 94.016
0.065 | 97.665 | 95.953 | 94.037
0.07 | 97.682 | 95.971 | 94.055
0.075 | 97.696 | 95.986 | 94.07
0.08 | 97.709 | 95.999 | 94.084
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
