cononinator/GeecPE2526/Investigations/Power Electronics Delay/PrtSc019_view.png

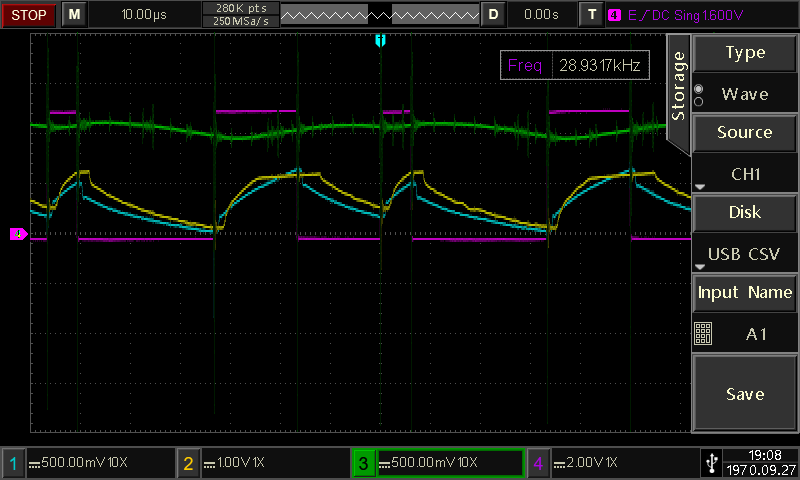
Investigations/Power Electronics Delay/PrtSc019_view.png
