cononinator/GeecPE2526/Investigations/Power Electronics Delay/PrtSc021.bmp

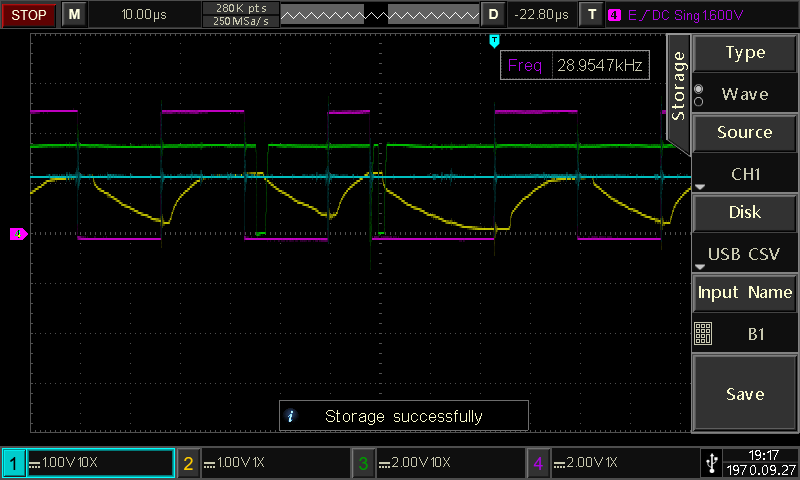
Investigations/Power Electronics Delay/PrtSc021.bmp
