cononinator/GeecPE2526/Investigations/Power Electronics Delay/PrtSc022.bmp

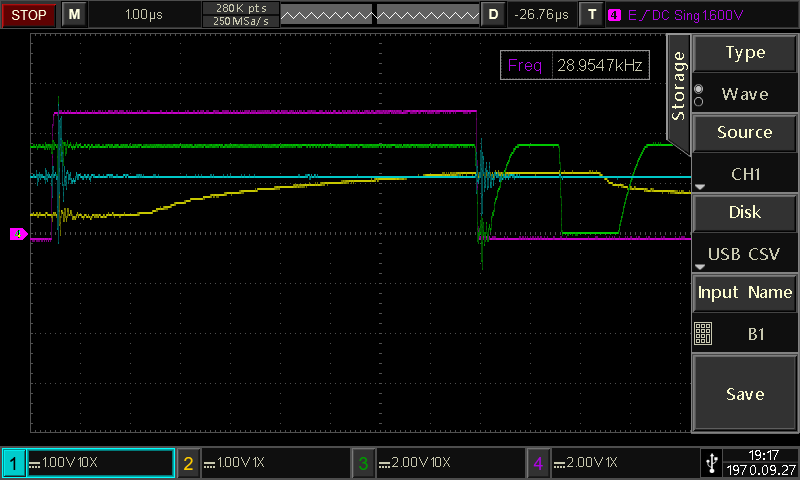
Investigations/Power Electronics Delay/PrtSc022.bmp
