cononinator/GeecPE2526/Investigations/Power Electronics Delay/PrtSc023.bmp

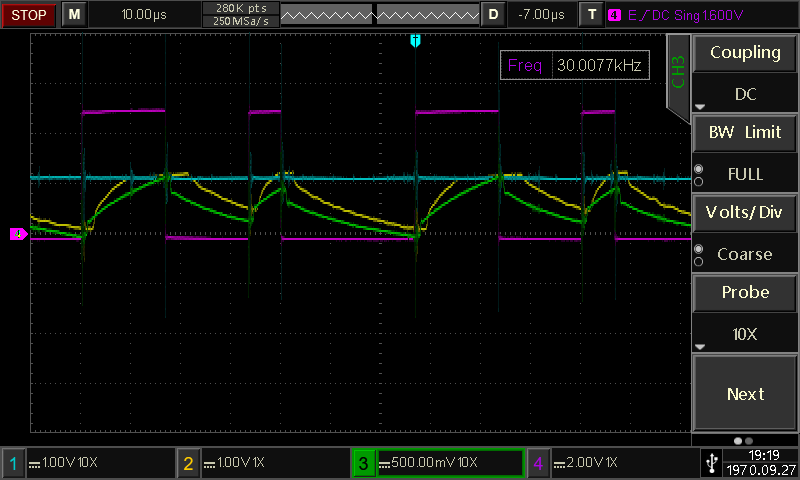
Investigations/Power Electronics Delay/PrtSc023.bmp
