cononinator/GeecPE2526/Oscilliscope/New Power Electronics/scope_25.png

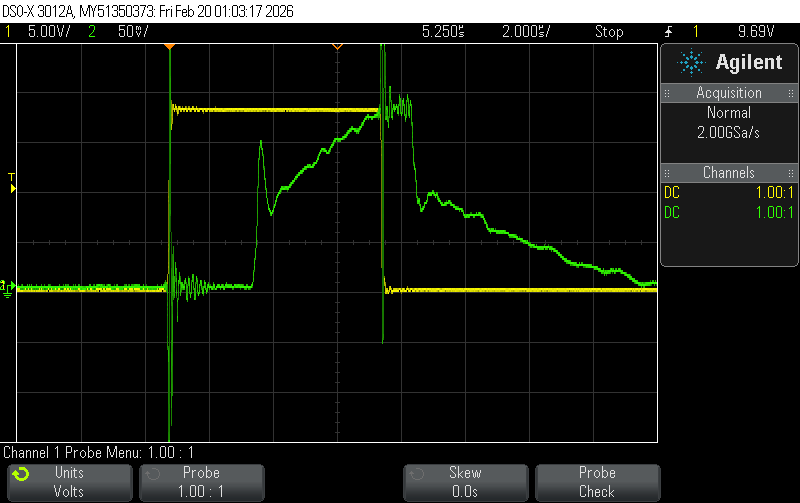
Oscilliscope/New Power Electronics/scope_25.png
