cononinator/GeecPE2526/Oscilliscope/New Power Electronics/Switching1.bmp

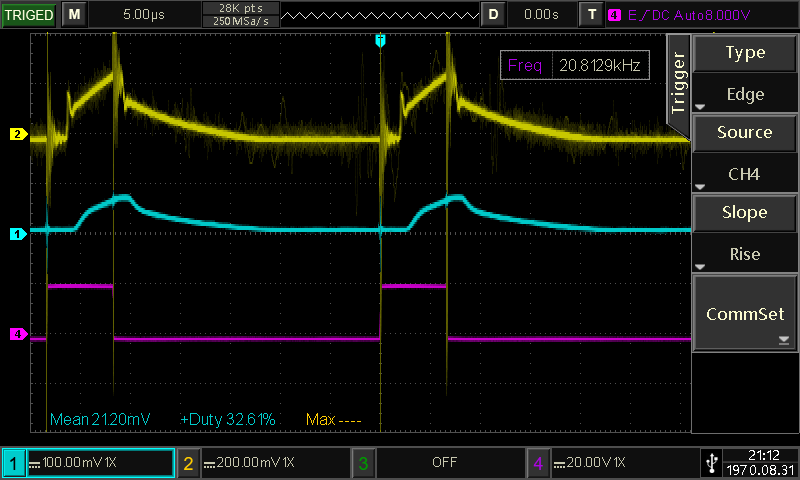
Oscilliscope/New Power Electronics/Switching1.bmp
