cononinator/GeecPE2526/Oscilliscope/New Power Electronics/Switching_1.bmp

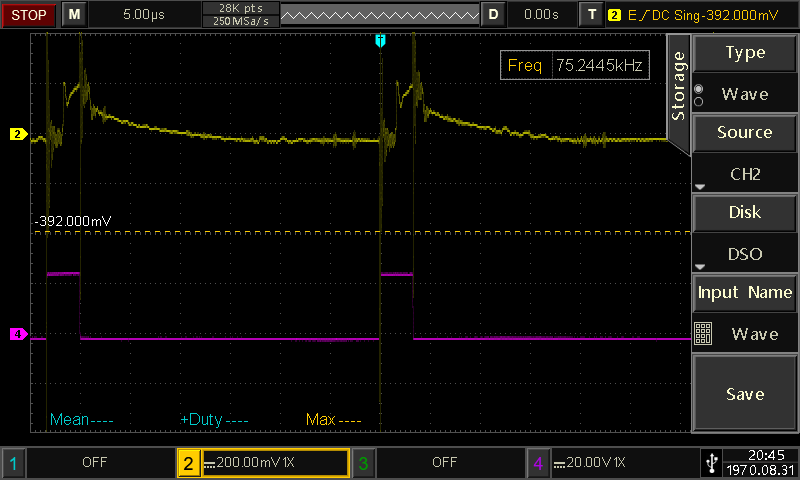
Oscilliscope/New Power Electronics/Switching_1.bmp
