cononinator/GeecPE2526/Oscilliscope/New Power Electronics/Switching_2.bmp

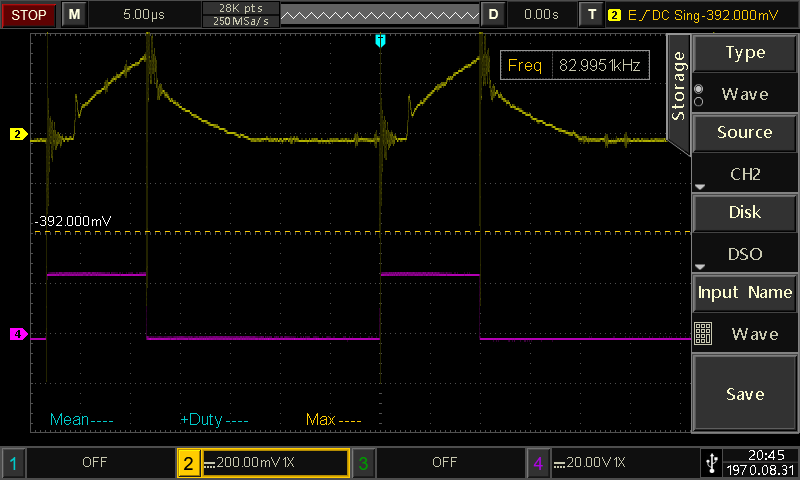
Oscilliscope/New Power Electronics/Switching_2.bmp
