cononinator/GeecPE2526/Oscilliscope/New Power Electronics/Switching_3.bmp

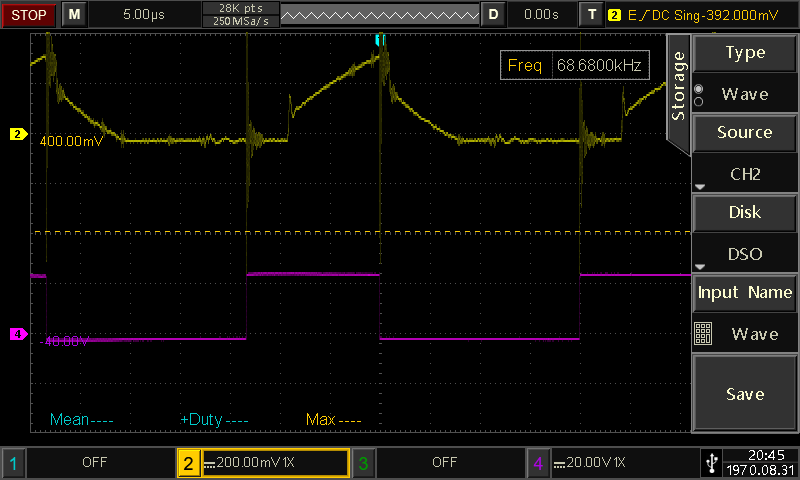
Oscilliscope/New Power Electronics/Switching_3.bmp
