cononinator/GeecPE2526/Oscilliscope/New Power Electronics/Switching_6.bmp

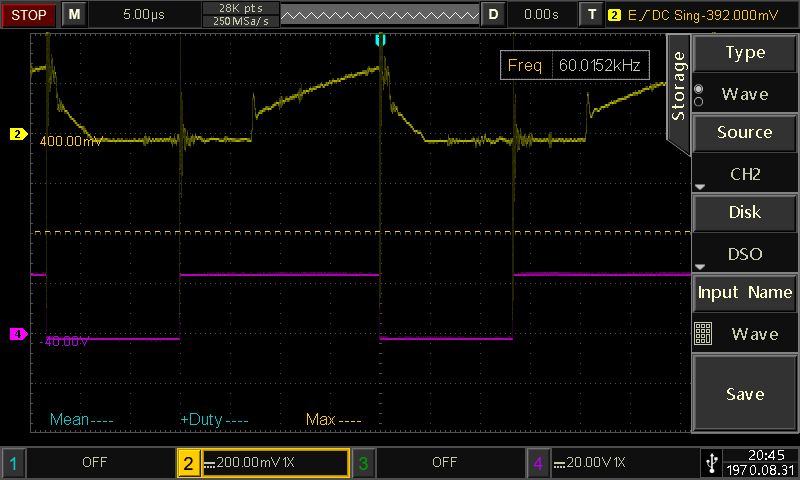
Oscilliscope/New Power Electronics/Switching_6.bmp
