cononinator/GeecPE2526/Oscilliscope/New Power Electronics/Switching_8.bmp

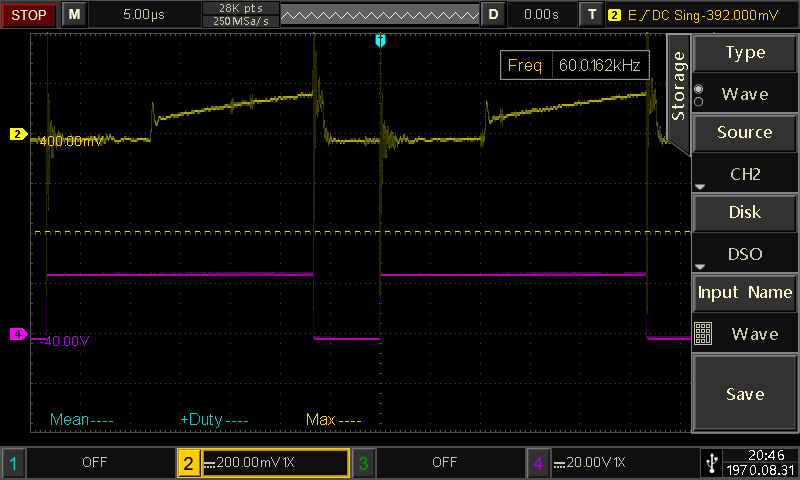
Oscilliscope/New Power Electronics/Switching_8.bmp
