cononinator/GeecPE2526/Oscilliscope/New Power Electronics/Switching_9.bmp

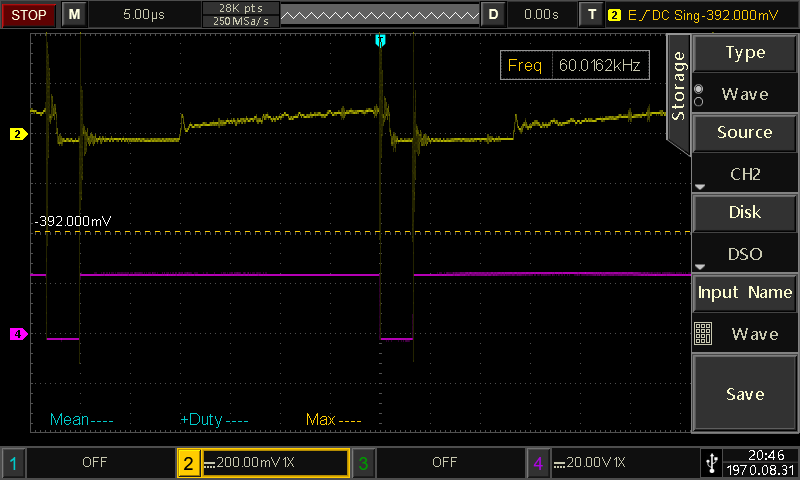
Oscilliscope/New Power Electronics/Switching_9.bmp
