cononinator/GeecPE2526/Oscilliscope/New Power Electronics/Switching_10.bmp

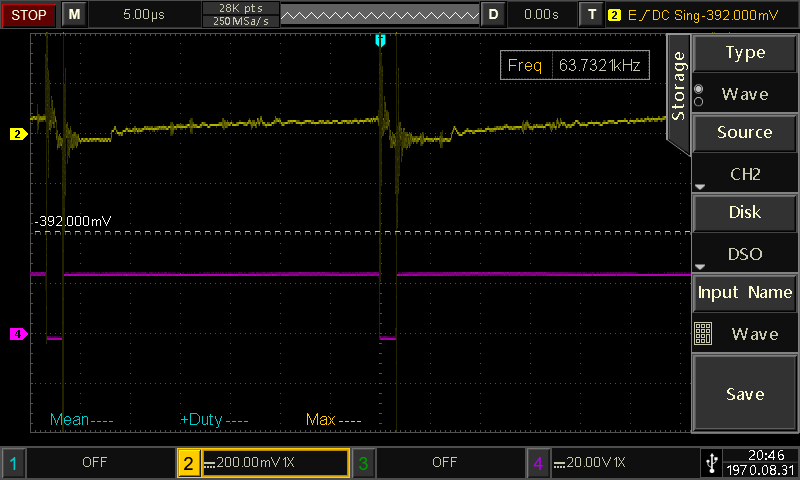
Oscilliscope/New Power Electronics/Switching_10.bmp
