cononinator/GeecPE2526/Oscilliscope/New Power Electronics/Switching_11.bmp

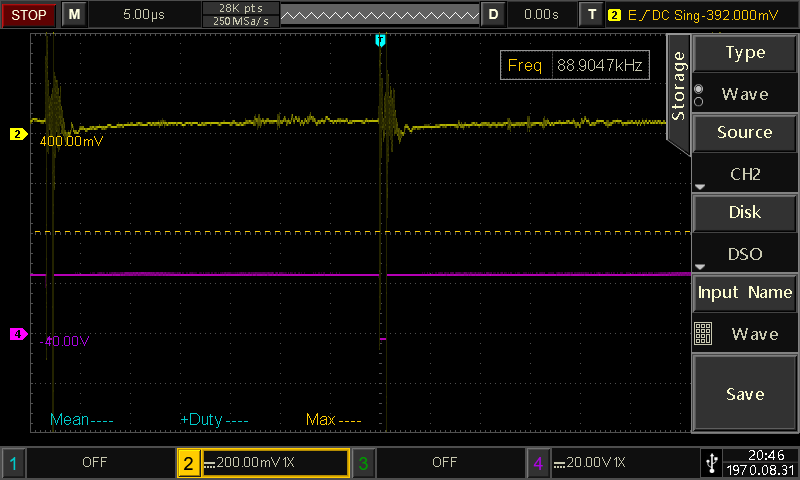
Oscilliscope/New Power Electronics/Switching_11.bmp
