cononinator/GeecPE2526/Write Ups/Hardware Current.drawio.png

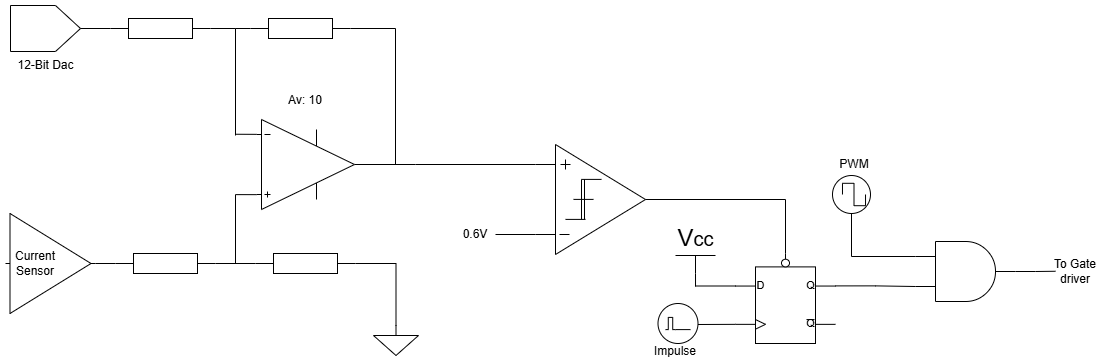
Write Ups/Hardware Current.drawio.png
