cononinator/GeecPE2526/Write Ups/Poster/dyno_sweep_20260408-095354_dyno_torque.png

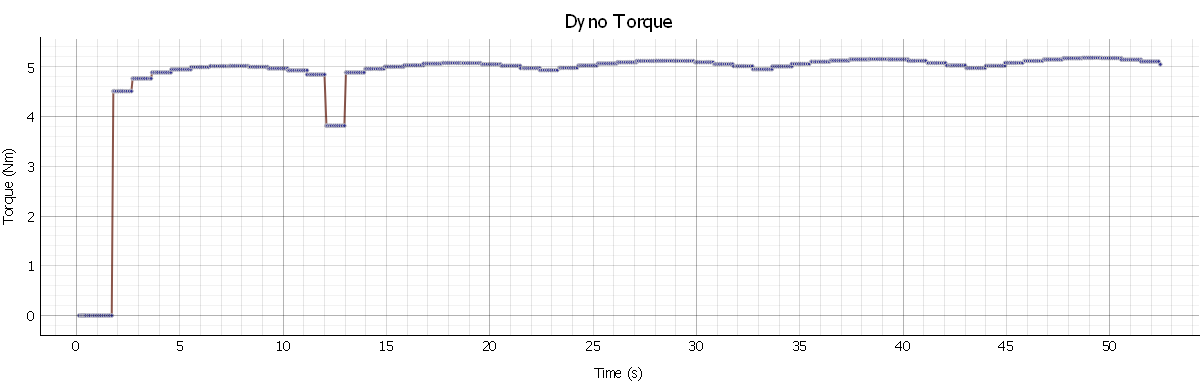
Write Ups/Poster/dyno_sweep_20260408-095354_dyno_torque.png
