cononinator/GeecPE2526/Write Ups/Poster/dyno_sweep_20260408-095354_power.png

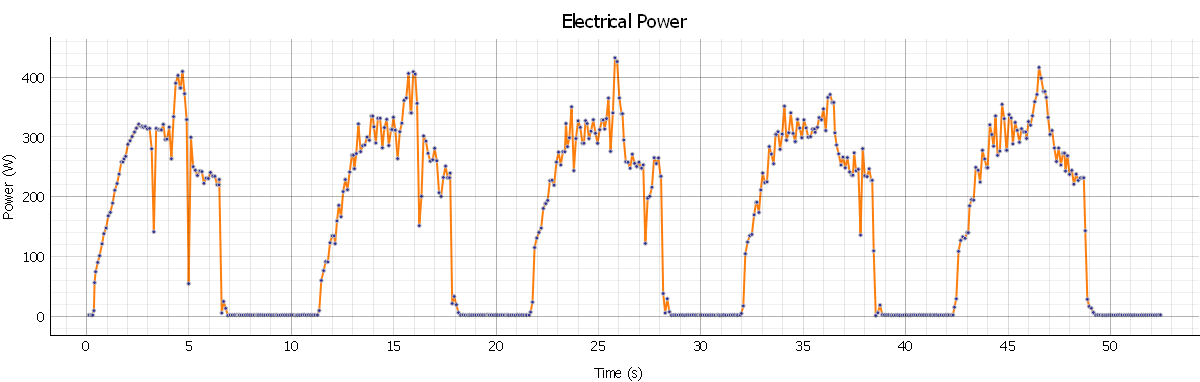
Write Ups/Poster/dyno_sweep_20260408-095354_power.png
