cononinator/GeecPE2526/Write Ups/Poster/dyno_sweep_20260408-095354_speed.png

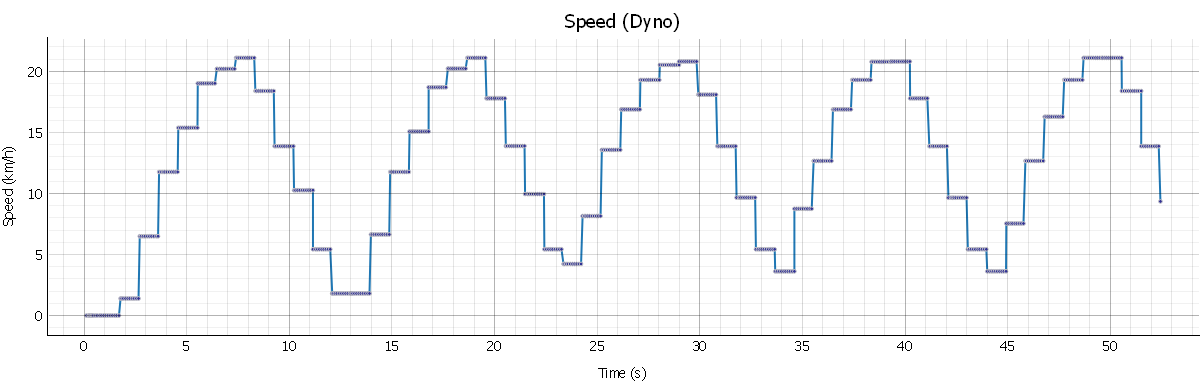
Write Ups/Poster/dyno_sweep_20260408-095354_speed.png
