cononinator/GeecPE2526/Write Ups/Poster/dyno_sweep_20260408-095658_power.png

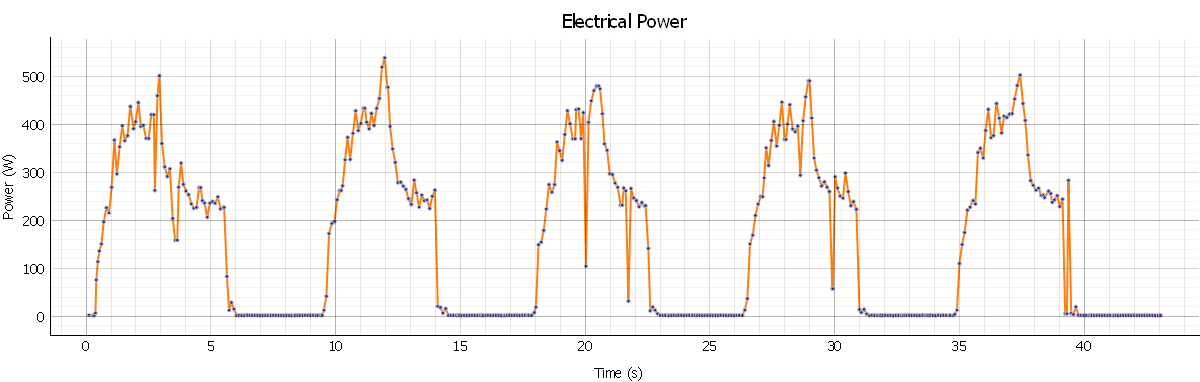
Write Ups/Poster/dyno_sweep_20260408-095658_power.png
