cononinator/GeecPE2526/Write Ups/PowerElectronics/Isolation Diagram.drawio.png

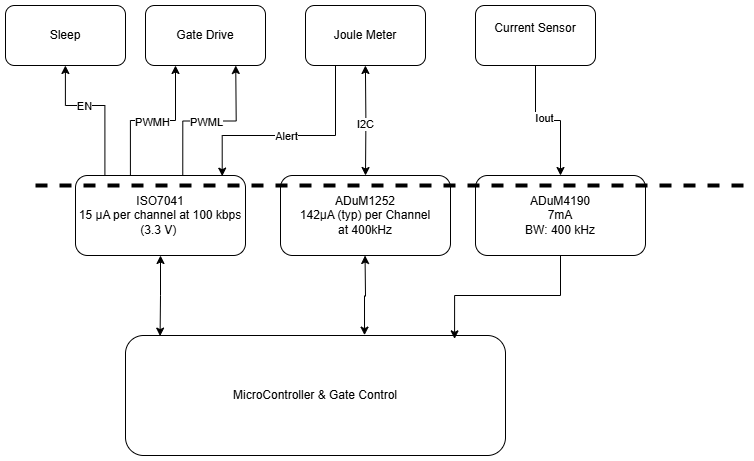
Write Ups/PowerElectronics/Isolation Diagram.drawio.png
