cononinator/GeecPE2526/Simulation/LM1210/LMG1210 Component Design Calculator and Schematic Review.xlsx

Sheet: Schematic Review Checklist
Texas Instruments
LMG1210 Schematic and Layout Checklist
Use this document as a supplemental checklist to be used with the driver's datasheet
System | Component | Purpose | Component Required | Typical Value | Additional Considerations | Connections | Layout Recommendations | Check if Complete | Comments
Bootstrap | Cboot | Build charge to drive high side gate | Yes | Based on system specs (sizing of Cboot and Cvdd is based on Qtot - check Sec 3.1 in link at the bottom) | 10V, Feedthru, SMD recommended | HS, HB | Place close to HS, HB pins | Open |  | Typical Application Schematic
 | Rboot | Limit Dboot current | No | 1Ω - 20Ω | Rboot must be able to withstand high power dissipation during the first charging sequence of the bootstrap capacitor (calculations can be found in Sec 3.4 in link at the bottom) | HB, Dboot | Minimize path length from supply to Cboot | Open
 | Dboot | Allow charging of Cboot when forward biased, and prevent Cboot charges flowing back to VDD when reverse biased | Yes |  | High Voltage (Voltage rating should be higher than the DC link), fast recovery diode or SiC Schottky diode with a low forward drop voltage and low junction capacitance | Rboot, VDD | Minimize path length from supply to Cboot | Open
Power supply | Vdd Large Bypass cap | Reduce VDD drop at switch on and replenish Cboot | Yes | 220nF - 10μF | 25V, MLCC, X7R recommended | VDD,GND | Place as close to VDD pin as possible, connect to Vss | Open
 | Vdd Small Bypass cap | Reduce noise on VDD pin | Yes | 100nF | 10V, Feedthru, SMD recommended | VDD,GND | Place as close to VDD pin as possible, connect to Vss | Open
 | Vin Bypass Capacitor | Reduce noise on Vin pin | Yes | 10μF | 25V - 50V, MLCC, X7R recommended |  | Place as close to Vin pin as possible, connect to Vss | Open
Dead Time Selection | DHL dead time resistor | Sets the dead time for a high-to-low transition in PWM mode | Yes (only in PWM mode) | 20kΩ - 1.8MΩ | For a desired dead time (tdt), the corresponding required resistance can be calculated with tdt in ns and Rext in kΩ by this formula: Rext = (900/tdt ) – 25 | DHL,VSS | DHL, GND (If using IIM this pin can be left floating, tied to GND, tied to VDD) | Open
 | DLH dead time resistor | Sets the dead time for a low-to-high transition in PWM mode | Yes (only in PWM mode) | 20kΩ - 1.8MΩ | For a desired dead time (tdt), the corresponding required resistance can be calculated with tdt in ns and Rext in kΩ by this formula: Rext = (900/tdt ) – 25 | DLH,VSS | DLH, GND (Tie to VDD to select IIM) | Open
Input Filtering | HI Resistor | Filter input noise | No | 0Ω - 100Ω | Have symetrical traces/component placement between HI and LI circuit. For applications with pulse widths in the single digit ns range avoid input filtering. | HI, Input | Place close to HI pin | Open
 | HI Cap | Filter input noise | No | 10pF-100pF |  | HI, GND | Place close to HI pin, connect to GND | Open
 | LI Resistor | Filter input noise | No | 0Ω - 100Ω |  | LI, Input | Place close to LI pin | Open
 | LI Cap | Filter input noise | No | 10pF-100pF |  | LI, GND | Place close to LI pin, connect to GND | Open
Outputs | HO Rgate | Adjust switching speed and reduce ringing | No | 0 - 5Ω |  | HO, High gate | Place between HO and gate with trace as short and wide as possible to minimize group loop | Open
 | LO Rgate | Adjust switching speed and reduce ringing | No | 0 - 5Ω |  | LO, Low Gate | Place between LO and gate with trace as short and wide as possible to minimize group loop | Open
Bootstrap Circuitry Selection for Half Bridge Configurations (https://www.ti.com/lit/an/slua887/slua887.pdf?ts=1655134470967)

Sheet: Bootstrap
 | Spec |  | Value | Unit | Spec |  | Value | Unit
User Inputs | Vdd | VDD | 7 | V | Vdd | VDD | 7 | V | Bootstrap resistance
Driver Datasheet Values | Bootstrap Diode Forward Voltage Drop | VDH | 1 | V | Bootstrap Diode Forward Voltage Drop | VDH | 1 | V
Outputs | HB Falling Threshold | VHBL | 4 | V | Bootstrap Diode peak current | Ipk | 2 | A
 | FET Gate Charge | QG | 52 | nC | Min Bootsrap resistance (if using external bootstrap diode) | Rboot | 3 | Ω
 | HB to VSS Leakage Current | IHBS | 2 | μA
 | Max duty cycle | DMAX | 80 | % | Bootstrap Voltage Change
 | switching frequency | fSW | 300 | kHz
 | HB quiescent current | IHB | 0.4 | mA
 | Max bootstrap ripple | ΔVHB | 2 | V | Bootstrap charge
 | Bootstrap charge | QTOTAL | 54 | nC
 | Min Bootstrap Capacitance | CBOOT(min) | 27 | nF
 | Target bootstrap ripple | ΔVHB | 0.5 | V | Bootstrap Capacitance
 | Recommended bootstrap capacitance | CBOOT | 108 | nF

Sheet: Power Dissipation
 | Spec |  | Value | Unit
Input System Value | Vdd | VDD | 7 | V
Input Datasheet Value | Gate Charge (Total) | QG | 52 | nC | Switching Power Loss
Output | Switching Frequency | fSW | 300 | kHz
 | FET internal gate resistance | RFET(int) | 0.75 | Ω
 | Driver pull up resistance | RDriver(int)(on) | 1 | Ω
 | Gate resistance (on) | RGATE(on) | 5 | Ω
 | Driver pull down resistance | RDriver(int)(off) | 0.85 | Ω | Quiescent Current Power Loss
 | Gate resistance (off) | RGATE(off) | 2 | Ω
 | Vdd quiescent current | IDD | 0.3 | mA
 | Diode voltage drop | VDH | 0.7 | V | Leakage Current Power Loss
 | HB quiescent current | IHB | 0.2 | mA
 | Is diode integrated in driver |  | yes
 | Diode reverse recovery current | IRR | 1 | mA | Diode Power Loss
 | Diode reverse recovery time | tRR | 1 | ns
 | Diode reverse voltage | VRR | 10 | V
 | HB to VSS quiescent current | IHBS | 2 | μA
 | HB max voltage | VHB(max) | 82 | V
 | duty cycle | DMAX | 50 | %
 | Switching Power Loss | PQG | 83.92 | mW
 | Quiescent Current Power Loss | PQC | 3.36 | mW
 | Diode Power Loss | PDF | 0.01092014 | mW
 | Low Side Leakage Power Loss | PIHBS | 8.2 | mW
 | Total Device Power Loss |  | 95.49 | mW
 | Thermal Resistance | Rθ | 118.3 | °C/W
 | Estimated Driver Temperature Increase | T | 11.296467 | °C

Sheet: Switching Times
 | Spec |  | Value | Unit
Input System Value | Gate Charge | QG | 52 | nC
Input Datasheet Value | Gate Charge Measurement Voltage | VQG | 10 | V
Output | FET internal gate resistance | RFET(int) | 0.75 | Ω | Switch time
 | Driver pull up resistance | RDriver(int)(on) | 1 | Ω
 | Gate resistance (on) | RGATE(on) | 5 | Ω
 | Driver pull down resistance | RDriver(int)(off) | 0.85 | Ω
 | Gate resistance (off) | RGATE(off) | 2 | Ω
 | turn on time | tON | 70 | ns
 | turn off time | tOFF | 37 | ns
