cononinator/GeecPE2526/Altium/NewPowerElec/GeecPE/Project Outputs for GeecPE/BOM/Bill of Materials-GeecPE(Assembly Variant).xlsx

Comment | Description | Designator | Footprint | LibRef | Quantity | Fitted | JLCPN
5000 | Cable Wrap, 1/2 Inch, Polyethylene, Natural, 50 Ft, Spirap Series | +3V3, +11V, 5V ISO, MOT, P IN1, P IN2, VBAT | FP-5000-MFG | CMP-00030-00004-2 | 1 | Not Fitted, Fitted
5001 | Test Point, Mini, Thm, Pc, .300 L, .100 Od, Heat Resistant Nylon 46, Black | AGND1, AGND2, AGND3, GND ISO | FP-5001-MFG | CMP-00030-00001-2 | 1 | Not Fitted, Fitted
GCM32EC71H106KA03L | 50V 10uF X7S ±10% 1210 Multilayer Ceramic Capacitors MLCC - SMD/SMT ROHS | C1, C2, C3, C4, C5, C6, C7, C8, C9, C10, C11, C12, C14, C15, C16, C18, C19, C20, C22, C23, C24, C27, C28, C29, C30, C31, C32, C34, C35, C36, C38, C39, C40, C43, C44, C45, C46, C47, C48, C49, C50, C51, C62, C66, C67, C68, C69 | FP-GCM32E-0_3-IPC_C | CMP-001-00085-1 | 47 | Fitted
C1206C104K1RACTU | Ceramic Capacitor, Multilayer, Ceramic, 200V, 10% +Tol, 10% -Tol, X7R, 15% TC, 0.01uF, 1206 | C13, C42, C52, C53, C55, C56, C78, C79 | CAPC3216X06N | CMP-001-00083-1 | 8 | Fitted
UVR1J472MRD | Radial Can ALUMINUM ELECTROLYTIC CAPACITOR UVR 63V 4700muF ±20% 0.866Dia 22.00mm | C17, C21, C26 | UVR1J472MRD-Footprint-1 | CMP-001-00084-4 | 0 | Not Fitted
CL31B105KBHNNNE | Ceramic Capacitor, Multilayer, Ceramic, 50V, 10% +Tol, 10% -Tol, X7R, +-15% TC, 1uF, Surface Mount, 1206 inch | C25, C57, C58, C59, C60, C70, C77 | CAPC3216X180X20ML20 | CMP-001-00086-1 | 7 | Fitted | C1848
CL31B102KGFNNNE | Ceramic Capacitor, Multilayer, Ceramic, 500V, 10% +Tol, 10% -Tol, X7R, +-15% TC, 1nF, Surface Mount, 1206 inch | C41, C54 | FP-CL31-IPC_A | CMP-001-00090-1 | 2 | Fitted
CL31B104KBCNNNC | 50V 100nF X7R ±10% 1206 Multilayer Ceramic Capacitors MLCC - SMD/SMT ROHS | C61, C63, C64, C65, C71, C72, C73, C74 | CAPC3216X190X55ML30T25 | CMP-001-00089-1 | 8 | Fitted | C24497
CL31A476MPHNNNE | Ceramic Capacitor, Multilayer, Ceramic, 10V, 20% +Tol, 20% -Tol, X5R, +-15% TC, 47uF, Surface Mount, 1206 inch | C75, C76 | CAPC3216X190X55LL30T25 | CMP-001-00087-1 | 2 | Fitted | C96123
SS210 | Rectifier Diode, Schottky, 1 Phase, 1 Element, 2A, 100V V(RRM), Silicon, DO-214AA | D1, D2 | DIOM4226X24N | CMP-004-00033-2 | 2 | Fitted | C14996
SMCJ28A | SMCJ Series 45.4 V 1.5 kW Surface Mount Uni-Directional TVS Diode - DO-214AB | D3, D4 | FAIR-DO-214AB-2_V | CMP-004-00035-1 | 2 | Fitted | C42371538
KT-0805G | -40℃~+85℃ 100mW 120° 2.6V~3.1V 430mcd 513nm~528nm 525nm 5mA Emerald Green 0805 LED Indication - Discrete ROHS | DS1, DS4 | WL-SMCW_0805_150080xx75000 | CMP-007-00037-1 | 2 | Fitted | C2297
NCD0805R1 | 25mA Colorless Transparent Lens 67mcd~195mcd -30℃~+85℃ 615nm~630nm Independent Diode Red 130° 65mW 1.6V~2.6V 0805 LED... | DS2, DS3 | Copy of WL-SMCW_0805_150080xx75000 | CMP-002-00586-1 | 2 | Fitted | C84256
5002 | Test Point, Mini, Thm, Pc, .300 L, .100 Od, Heat Resistant Nylon 46, White | EN, FAULT, I_Sense, PWM, SCL, SDA, SOFT | FP-5002-MFG | CMP-00030-00002-2 | 0 | Not Fitted
691309310012 | Terminal Block, 3.81MM Pitch, Horizontal With Coding Finger, Tht, 12 Pins | J1 | 691309310012 | CMP-002-00074-3 | 0 | Not Fitted
SRR1208-220ML | Inductor Power Shielded Wirewound 22uH 20% 1KHz 23Q-Factor Ferrite 3.5A 0.043Ohm DCR T/R | L1 | INDP127127X85N | CMP-006-00022-1 | 1 | Fitted | C2041332
SRR1260A-5R6Y | Ind Power Shielded Wirewound 5.6uH 30% 100KHz 19Q-Factor Ferrite 6.7A T/R | L2 | INDP125125X60N | CMP-006-00023-1 | 1 | Fitted | C2042812
SEM LOGO | SEM Logo Required for Power Electronics | LG1 | SEM LOGO-Footprint-1 | CMP-00028-00008-2 | 1 | Fitted
Geec Logo |  | LG2, LG2. | Geec Logo-Footprint-1 | CMP-00028-00009-2 | 2 | Fitted
7461001 | Pcb Terminal, Brass, Press-Fit Rohs Compliant: Yes | MP1, MP2, MP3, MP4 | 7461001_chemical surface | CMP-002-00075-3 | 0 | Not Fitted
61300211121 | WR-PHD Pin Header, THT, Vertical, pitch 2.54mm, 1 Row, 2P | P1, P2, P3, P4 | 61300211121 | CMP-002-00208-1 | 0 | Not Fitted
61300311121 | WR-PHD Pin Header, THT, Vertical, pitch 2.54mm, 1 Row, 3P | P5 | 61300311121 | CMP-002-00212-1 | 0 | Not Fitted
PSMN1R0-30YLDX | N-channel Logic Level MOSFET, 30 V, 300 A, -55 to 175 degC, 5-Pin SOT669, RoHS, Tape and Reel | Q1, Q2 | NXP-SOT669_L | CMP-013-00029-7 | 0 | Not Fitted
ISG0613N04NM6H | Small Signal Dual N-Channel Enhancement Transistor, Pin 1 Source, 2 Source, 3 Drain, 4 Drain, 5 Gate, 6 Drain, 7 Drain, 8 Source, 9 Source 10 Gate, 10 Pins | Q3 | IFX-PG-VITFN-10-1-V | CMP-007-000000-2 | 1 | Fitted
IPB014N06NATMA1 | Power MOSFET, N Channel, 60 V, 180 A, 0.0012 ohm, TO-263 (D2PAK), Surface Mount | Q4, Q5 | INF-PG-TO263-7-1_M | CMP-00000-5 | 2 | Fitted
BSS138 | N-Channel Logic Level Enhancement Mode Field Effect Transistor, 220 mA, 50 V, -55 to 150 degC, 3-Pin SOT-23, RoHS, Tape and Reel | Q6, Q7, Q8, Q9 | FAIR-SOT23-3_V | CMP-013-00021-4 | 4 | Fitted
1206W4F0000T5E | Thick Film Resistors - SMD RMC 1206 1/4W 1% T/R-5000 | R1, R2, R4, R5 | RESC3216X60X45NL15T20 | CMP-009-00183-1 | 2 | Not Fitted, Fitted | C17888
0805W8F470JT5E | Thick Film Resistors - SMD RMC 0805 1/8W 1% T/R-5000 | R3 | RESC2013X70X40ML20T20 | CMP-009-00191-2 | 1 | Fitted | C17714
CHSA2512R0010F | Fixed Resistor, Metal Strip, 5W, 1ohm, 0.0707V, 1% +/-Tol, 100ppm/Cel, Surface Mount, 2512 | R6 | RESC6331X09N | CMP-009-00182-2 | 1 | Fitted
1206W4F1002T5E | Res Thick Film 1206 10K Ohm 1% 0.25W(1/4W) ±100ppm/C Pad SMD T/R | R7, R8, R9, R10, R11, R12, R13, R15 | RESC3216X60X45ML15T20 | CMP-009-00184-2 | 8 | Fitted | C17902
1206W4F1003T5E | Fixed Resistor, Metal Glaze/thick Film, 0.25W, 100000ohm, 200V, 1% +/-Tol, 100ppm/Cel, Surface Mount, 1206 | R14, R16, R22, R23 | RESC3216X60X45NL15T20 | CMP-009-00185-1 | 4 | Fitted
0805W8F4302T5E | 125mW Thick Film Resistors 150V ±100ppm/℃ ±1% 43kΩ 0805 Chip Resistor - Surface Mount ROHS | R17 | RESC0805(2012)_L | CMP-009-00188-1 | 1 | Fitted | C17695
1206W4F3000T5E | 250mW Thick Film Resistors 200V ±100ppm/℃ ±1% 300Ω 1206 Chip Resistor - Surface Mount ROHS | R18, R20 | RESC3216X89X51NL25T25 | CMP-009-00190-1 | 2 | Fitted
0805W8F3901T5E | Res Thick Film 0805 3.9K Ohm 1% 0.125W(1/8W) ±100ppm/C Pad SMD T/R | R19 | RESC2013X60X35ML10T20 | CMP-009-00193-2 | 1 | Fitted | C17614
1623730-2 | Fixed Resistor, Wire Wound, 4W, 10ohm, 6.3246V, 5% +/-Tol, 400ppm/Cel, Through Hole Mount, 3228 | R21 | 1623730-2-Footprint-1 | CMP-009-00189-1 | 0 | Not Fitted
INA780BIDEKR | 85-V 16-bit I²C-output digital power monitor with 400-ÂµOhm EZShunt Technology 15-VQFN -40 to 125 | U1 | VQFN15_DEK_TEX | CMP-004-000000-8 | 1 | Fitted | C34740774
LTC7063RMSE#PBF | Driver 6A 2-OUT High Side/Low Side Half Brdg Inv/Non-Inv 12-Pin MSOP EP Tube | U2 | TSOP65P490X110_HS-13N | CMP-00024-00008-3 | 1 | Fitted
AD8411AWBRZ | SP Amp Current Sense Amp Single 5.5V 8-Pin SOIC N Tube Automotive AEC-Q100 | U3 | SOIC127P600X175-8N | CMP-014-00003-5 | 1 | Fitted | C20047590
ADUM1252AWA+ | Ultra-Low Power, Bidirectional I2C Isolator with Extended VDD, Idle-Bus Hot-Swap and Low VOL | U4 | SOIC127P1030X265-8N | CMP-016-00010-2 | 1 | Fitted | C44197888
ADUM1411BRWZ | Digital Isolator CMOS 4-CH 10Mbps 16-Pin SOIC W Tube / DGTL ISO 3.75KV GEN PURP 16SOIC | U5 | ADI-RW-16_M | CMP-015-00009-2 | 1 | Fitted | C660417
ADUM3190BRQZ | High Stability Isolated Error Amplifier | U6 | SOP64P600X175-16N | CMP-014-00002-3 | 1 | Fitted
LMR33630ADDAR | SIMPLE SWITCHER® 3.8V to 36V, 3A Synchronous Buck Converter With Ultra-Low EMI 8-SO PowerPAD -40 to 125 | U7, U8 | SOIC127P600X170_HS-9N | CMP-019-00051-2 | 2 | Fitted
LTC7004EMSE#PBF | RoHS Compliant PRODUCTION (Last Updated: 2weeks ago) MSOP IC Gate Driver | U9 | TSSOP50P490X110_HS-11N | CMP-00024-00007-2 | 1 | Fitted
