cononinator/GeecPE2526/Investigations/CFProject Budget.xlsx

Project Budget |  | Inc VAT | Inc Delivery | Ordered
BMS | €70.50 | Yes | Yes | TRUE
Geec Power Electronics | €320.35 | No | Yes | TRUE
Geec Power Controller | €100.00 | No |  | FALSE
Other PE Components | €40.00 | Yes | Yes | FALSE
Battery
3.5Ah | €208.00 | No |  | FALSE
4.5Ah | €244.00 | No |  | FALSE
4Ah | €244.00 | No |  | FALSE
5.2Ah Graphene | €316.00 | No |  | FALSE
5.45Ah | €316.00 | No |  | FALSE
 |  |  |  | FALSE
Motor |  |  |  | FALSE
RE50 | 614 | No |  | FALSE
