cononinator/GeecPE2526/Code/TestCode/CAD/Geec PE - Bottom Cover.dxf

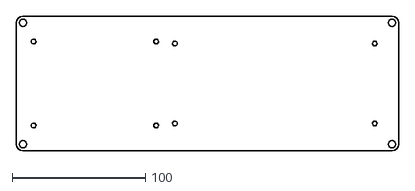
[picture p150: CAD file, 2026-03-26]
Code/TestCode/CAD/Geec PE - Bottom Cover.dxf
287.0 x 101.0
