cononinator/GeecPE2526/Code/TestCode/CAD/GeecPE - Top Cover.dxf

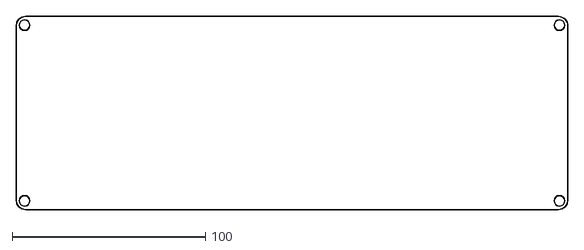
[picture p151: CAD file, 2026-03-26]
Code/TestCode/CAD/GeecPE - Top Cover.dxf
285.8 x 100.0
