cononinator/GeecPE2526/Altium/NewPowerElec/GeecPE/Project Outputs for GeecPE/AssemblyData/PCB 3D Print/PowerElec(Assembly Variant).png

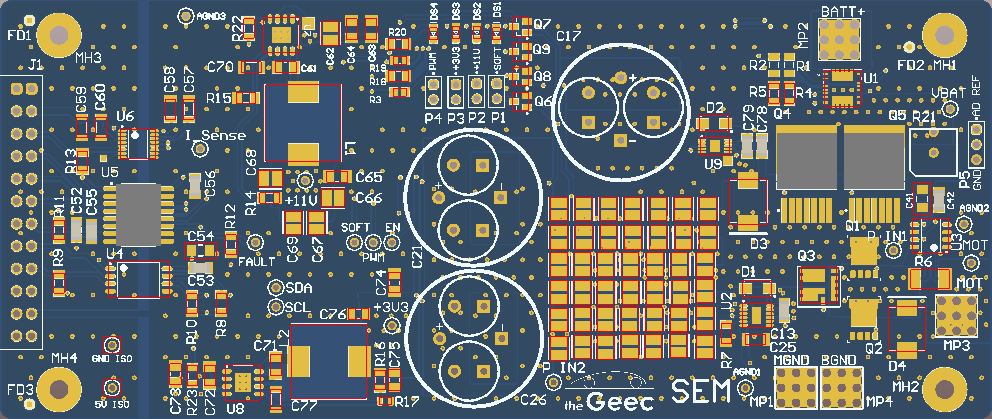
Altium/NewPowerElec/GeecPE/Project Outputs for GeecPE/AssemblyData/PCB 3D Print/PowerElec(Assembly Variant).png
