cononinator/GeecPE2526/Altium/NewPowerElec/GeecPE/Project Outputs for GeecPE/PCB 3D Print/PowerElec.png

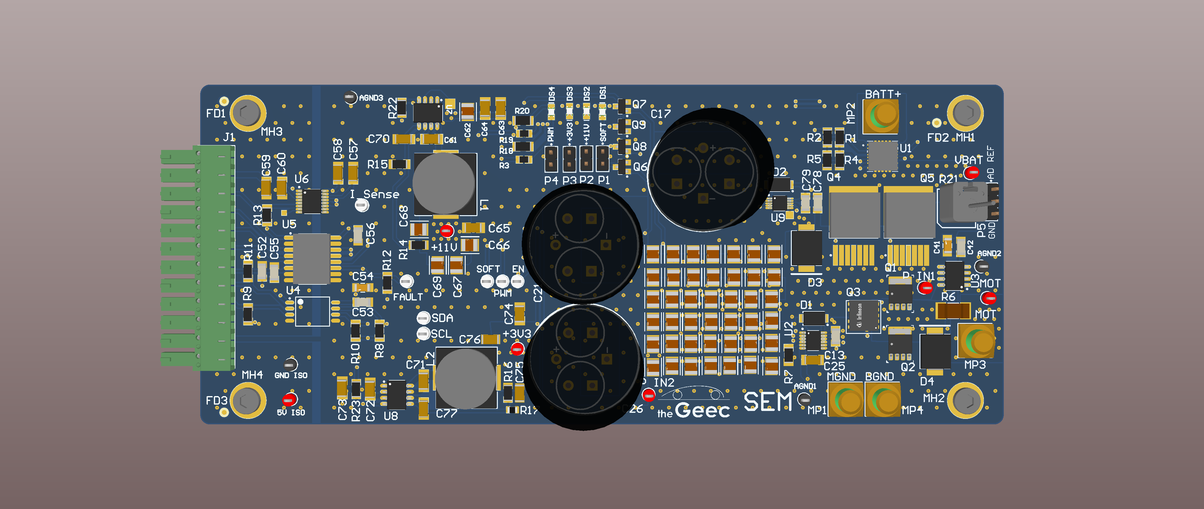
Altium/NewPowerElec/GeecPE/Project Outputs for GeecPE/PCB 3D Print/PowerElec.png
