cononinator/GeecPE2526/Investigations/ADuM3190 Performance.xlsx

Vin | 3.3
Vin Iso | 5V
Configuration | Voltage Follower
Output R | 12000
Equiv Current | Vin | EAOut2
0 | 0 | 0.392
2.14 | 0.107 | 0.401
3.52 | 0.176 | 0.493
4.02 | 0.201 | 0.554
5.28 | 0.264 | 0.719
5.96 | 0.298 | 0.8
7.04 | 0.352 | 0.94
8.02 | 0.401 | 1.06
9.14 | 0.457 | 1.203
10.04 | 0.502 | 1.32
11.14 | 0.557 | 1.459
11.82 | 0.591 | 1.54
14.4 | 0.72 | 1.89
15.8 | 0.79 | 2.05
17.88 | 0.894 | 2.32
19.8 | 0.99 | 2.56
22.44 | 1.122 | 2.9
24.2 | 1.21 | 3.12
26 | 1.3 | 3.36
28.4 | 1.42 | 3.65
30 | 1.5 | 3.87
32.2 | 1.61 | 4.16
33.8 | 1.69 | 4.35
36.2 | 1.81 | 4.66
38.2 | 1.91 | 4.9
39.8 | 1.99 | 4.938
42.8 | 2.14 | 4.939
