cononinator/GeecPE2526/Investigations/Motor Voltage Calibration.xlsx

vin | vout
0 | 0.153
0.25 | 0.16
0.34 | 0.165
1.75 | 0.222
2.65 | 0.26
3.93 | 0.305
5.37 | 0.361
6.81 | 0.42
7.21 | 0.437
8.04 | 0.474
9.51 | 0.546
10.75 | 0.621
12.17 | 0.719
14.18 | 0.897
15.72 | 0.974
17.53 | 1.054
18.81 | 1.157
19.54 | 1.213
21.14 | 1.262
22.1 | 1.32
24 | 1.427
25.94 | 1.538
27.29 | 1.6147
28.88 | 1.706
29.25 | 1.7216
