cononinator/GeecPE2526/Code/TestCode/Dyno Investigation/Dyno Test 2 Plan.xlsx

Sheet: Test structure
 | kn | 237.3
 | km | 40.3
 | R | 0.103
 | G | 22 |  |  |  |  |  |  |  |  |  | Above Motor Nominal Current / Torque!
 | Current [A]
Voltage [V] | 0.88 | 1.76 | 2.64 | 3.52 | 4.4 | 5.28 | 6.16 | 7.04 | 7.92 | 8.8 | 9.68 | 10.56 | 11.44 | 12.32 | 13.2 | 14.08 | 14.96 | 15.84 | 16.72 | 17.6
5
10
15
20
22
24
26
28
 | Motor Torque [mNm]
No LoadMotor Speed [rpm] | 35.464 | 70.928 | 106.392 | 141.856 | 177.32 | 212.784 | 248.248 | 283.712 | 319.176 | 354.64 | 390.104 | 425.568 | 461.032 | 496.496 | 531.96 | 567.424 | 602.888 | 638.352 | 673.816 | 709.28
1165.022376
2351.522376
3538.022376
4724.522376
5199.122376
5673.722376
6148.322376
6622.922376
 | Dyno Torque [Nm]
No Load Speed [rpm] | 0.780208 | 1.560416 | 2.340624 | 3.120832 | 3.90104 | 4.681248 | 5.461456 | 6.241664 | 7.021872 | 7.80208 | 8.582288 | 9.362496 | 10.142704 | 10.922912 | 11.70312 | 12.483328 | 13.263536 | 14.043744 | 14.823952 | 15.60416
52.95556255
106.8873807
160.8191989
214.7510171
236.3237444
257.8964716
279.4691989
301.0419262
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
