cononinator/GeecPE2526/Code/TestCode/Dyno Investigation/SummaryResults.csv

Run | Throttle % | Current [A] | Tacho speed | Torque [Nm] | Line start accel | Line Finish accel | Line start ss | Line Finish ss | File
1 | 20 | 0.85 | 59 | 0.56 | 4690 | 4704 | 4705 | 4946 | ILTESTr016.txt
2 | 20 | 0.9 | 59 | 0.66 | 388 | 401 | 402 | 547 | ILTESTr017.txt
3 | 20 | 1 | 57.5 | 1.12 | 771 | 784 | 785 | 1004 | ILTESTr017.txt
4 | 20 | 1.05 | 56.7 | 1.41 | 1232 | 1245 | 1246 | 1401 | ILTESTr017.txt
5 | 20 | 1.2 | 55.4 | 1.84 | 2009 | 2023 | 2024 | 2174 | ILTESTr017.txt
6 | 20 | 1.3 | 54.5 | 2.24 | 2268 | 2283 | 2284 | 2402 | ILTESTr017.txt
7 | 20 | 1.35 | 53.7 | 2.53 | 2517 | 2531 | 2532 | 2663 | ILTESTr017.txt
8 | 20 | 1.4 | 53 | 2.77 | 176 | 194 | 195 | 287 | ILTESTr018.txt
9 | 20 | 1.4 | 52.4 | 2.99 | 578 | 594 | 595 | 676 | ILTESTr018.txt
10 | 20 | 1.6 | 51.4 | 3.38 | 1214 | 1228 | 1229 | 1308 | ILTESTr018.txt
11 | 20 | 1.7 | 50 | 3.99 | 137 | 150 | 151 | 228 | ILTESTr019.txt
12 | 20 | 2 | 47 | 5.2 | 32 | 45 | 46 | 99 | ILTESTr020.txt
13 | 20 | 2.2 | 43.7 | 6.4 | 57 | 71 | 72 | 181 | ILTESTr021.txt
14 | 20 | 2.6 | 37.2 | 9 | 114 | 126 | 127 | 178 | ILTESTr022.txt
15 | 41 | 1.65 | 126.1 | 0.49 | 1605 | 1633 | 1634 | 1678 | ILTESTr022.txt
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
