cononinator/GeecPE2526/Code/DynoTesting/dist/dyno_sweep_20260407-170950.csv

Voltage | Current | Power | Energy | Temperature | MotorVoltage | MotorCurrent | MeasuredDutyCycle | TargetDutyCycle | WheelSpeed | Phase | Repeat | CurrentLimit_A | Timestamp_s | Dyno_Timestamp_ms | Dyno_Speed_kmh | Car_Speed_kmh | Dyno_Torque_Nm | Dyno_Power_W
26.869 | 0.082 | 2.168 | 4779.333 | 20.37 | 0.204 | 0.61 | 0.0 | 0.0 | 0.0 | Accelerating | 1.0 | 20.0 | 0.11531329154968262
26.872 | 0.077 | 2.088 | 4779.525 | 20.37 | 0.309 | 0.5875 | 0.0 | 0.0 | 0.0 | Accelerating | 1.0 | 20.0 | 0.27353763580322266
26.872 | 0.07 | 1.991 | 4779.74 | 20.37 | 0.204 | 0.5842 | 0.0 | 0.0 | 0.0 | Accelerating | 1.0 | 20.0 | 0.3211207389831543
26.872 | 0.072 | 1.91 | 0.192 | 20.5 | 0.219 | 0.5842 | 0.0 | 0.0 | 0.0 | Accelerating | 1.0 | 20.0 | 0.3810863494873047
26.856 | 0.482 | 12.94 | 0.891 | 20.37 | 3.217 | 0.797 | 10.0 | 100.0 | 0.0 | Accelerating | 1.0 | 20.0 | 0.47939181327819824
26.775 | 2.755 | 73.732 | 4.493 | 20.37 | 4.401 | 2.5199 | 21.0 | 100.0 | 0.0 | Accelerating | 1.0 | 20.0 | 0.5091102123260498
26.775 | 2.767 | 68.235 | 10.399 | 20.5 | 2.092 | 0.8486 | 32.0 | 100.0 | 0.0 | Accelerating | 1.0 | 20.0 | 0.5528745651245117
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
