cononinator/GeecPE2526/Code/DynoTesting/dist/dyno_sweep_20260420-132728.csv

Voltage | Current | Power | Energy | Temperature | MotorVoltage | MotorCurrent | MeasuredDutyCycle | TargetDutyCycle | WheelSpeed | Phase | Repeat | CurrentLimit_A | Timestamp_s | Dyno_Timestamp_ms | Dyno_Speed_kmh | Car_Speed_kmh | Dyno_Torque_Nm | Dyno_Power_W
28.522 | 0.07 | 2.013 | 678.597 | 17.12 | -0.036 | 3.5885 | 0.0 | 0.0 | 0.0 | Accelerating | 1.0 | 20.0 | 0.11415600776672363
28.522 | 0.07 | 2.013 | 678.812 | 17.12 | 0.144 | 3.8529 | 0.0 | 0.0 | 0.0 | Accelerating | 1.0 | 20.0 | 0.28572845458984375
28.522 | 0.07 | 1.968 | 679.02 | 17.12 | -0.336 | 3.8529 | 0.0 | 0.0 | 0.0 | Accelerating | 1.0 | 20.0 | 0.3351578712463379
28.522 | 0.074 | 2.088 | 0.169 | 17.12 | 0.204 | 3.8701 | 0.0 | 0.0 | 0.0 | Accelerating | 1.0 | 20.0 | 0.38610172271728516
28.5 | 0.42 | 11.99 | 0.684 | 17.12 | 2.542 | 5.2094 | 8.0 | 100.0 | 0.0 | Accelerating | 1.0 | 20.0 | 0.43337488174438477
28.366 | 2.146 | 60.848 | 4.792 | 17.25 | 4.835 | 18.1537 | 19.0 | 100.0 | 0.0 | Accelerating | 1.0 | 20.0 | 0.45314574241638184
28.322 | 2.83 | 80.117 | 11.973 | 17.25 | 5.54 | 18.3952 | 29.0 | 100.0 | 0.0 | Accelerating | 1.0 | 20.0 | 0.5006809234619141
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
