cononinator/GeecPE2526/Code/DynoTesting/dist/dyno_sweep_20260420-134159.csv

Voltage | Current | Power | Energy | Temperature | MotorVoltage | MotorCurrent | MeasuredDutyCycle | TargetDutyCycle | WheelSpeed | Phase | Repeat | CurrentLimit_A | Timestamp_s | Dyno_Timestamp_ms | Dyno_Speed_kmh | Car_Speed_kmh | Dyno_Torque_Nm | Dyno_Power_W
28.413 | 0.074 | 2.097 | 2920.765 | 17.62 | 0.174 | 3.8586 | 0.0 | 0.0 | 0.0 | Accelerating | 1.0 | 20.0 | 0.11813545227050781
28.416 | 0.072 | 1.781 | 2920.973 | 17.62 | 0.099 | 3.8471 | 0.0 | 0.0 | 0.0 | Accelerating | 1.0 | 20.0 | 0.24546241760253906
28.416 | 0.074 | 2.118 | 2921.18 | 17.62 | 0.174 | 3.8414 | 0.0 | 0.0 | 0.0 | Accelerating | 1.0 | 20.0 | 0.4306755065917969
28.413 | 0.065 | 1.824 | 0.031 | 17.62 | 0.084 | 3.8529 | 0.0 | 0.0 | 0.0 | Accelerating | 1.0 | 20.0 | 0.49488162994384766
28.413 | 0.134 | 3.835 | 0.261 | 17.62 | 0.668 | 4.7495 | 2.0 | 100.0 | 0.0 | Accelerating | 1.0 | 20.0 | 0.5927133560180664
28.378 | 0.607 | 17.223 | 1.229 | 17.62 | 3.321 | 6.0543 | 13.0 | 100.0 | 0.0 | Accelerating | 1.0 | 20.0 | 0.6440062522888184
28.247 | 2.386 | 67.355 | 7.043 | 17.62 | 4.461 | 17.9123 | 23.0 | 100.0 | 0.0 | Accelerating | 1.0 | 20.0 | 0.6999354362487793
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
