cononinator/GeecPE2526/Code/DynoTesting/dist/dyno_sweep_20260420-142344.csv

Voltage | Current | Power | Energy | Temperature | MotorVoltage | MotorCurrent | MeasuredDutyCycle | TargetDutyCycle | WheelSpeed | Phase | Repeat | CurrentLimit_A | Timestamp_s | Dyno_Timestamp_ms | Dyno_Speed_kmh | Car_Speed_kmh | Dyno_Torque_Nm | Dyno_Power_W
28.263 | 0.043 | 1.195 | 3840.791 | 18.62 | 0.054 | 3.7781 | 0.0 | 0.0 | 0.0 | Accelerating | 1.0 | 15.0 | 0.11601519584655762
28.263 | 0.041 | 1.051 | 3840.914 | 18.62 | 0.174 | 3.7839 | 0.0 | 0.0 | 0.0 | Accelerating | 1.0 | 15.0 | 0.3023543357849121
28.263 | 0.046 | 1.28 | 3841.021 | 18.62 | -0.111 | 3.8471 | 0.0 | 0.0 | 0.0 | Accelerating | 1.0 | 15.0 | 0.3502678871154785
28.263 | 0.038 | 1.072 | 0.084 | 18.62 | 0.084 | 3.7954 | 0.0 | 0.0 | 0.0 | Accelerating | 1.0 | 15.0 | 0.42559099197387695
28.247 | 0.247 | 6.961 | 0.392 | 18.62 | 2.092 | 6.0831 | 7.0 | 100.0 | 0.0 | Accelerating | 1.0 | 15.0 | 0.495577335357666
28.163 | 1.44 | 40.576 | 3.41 | 18.62 | 3.157 | 13.8888 | 17.0 | 100.0 | 0.0 | Accelerating | 1.0 | 15.0 | 0.53452467918396
28.156 | 1.529 | 43.031 | 7.956 | 18.75 | 4.73 | 13.8428 | 28.0 | 100.0 | 0.0 | Accelerating | 1.0 | 15.0 | 0.6066162586212158
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
