cononinator/GeecPE2526/Code/DynoTesting/dyno_sweep_20260327-153340.csv

Voltage | Current | Power | Energy | Temperature | MotorVoltage | MotorCurrent | MeasuredDutyCycle | TargetDutyCycle | WheelSpeed | Phase | Repeat | CurrentLimit_A | Timestamp_s
28.228 | 0.072 | 2.053 | 781.21 | 20.0 | 6.449 | 0.5842 | 0.0 | 0.0 | 0.0 | Accelerating | 1 | 15.0 | 0.11547160148620605
28.228 | 0.074 | 2.074 | 781.425 | 20.0 | 6.754 | 0.6084 | 0.0 | 0.0 | 0.0 | Accelerating | 1 | 15.0 | 0.1961193084716797
28.228 | 0.072 | 2.022 | 781.632 | 20.0 | 6.74 | 0.6052 | 0.0 | 0.0 | 0.0 | Accelerating | 1 | 15.0 | 0.32340049743652344
28.228 | 0.062 | 1.787 | 0.023 | 20.0 | 6.841 | 0.61 | 0.0 | 0.0 | 0.0 | Accelerating | 1 | 15.0 | 0.3800089359283447
28.228 | 0.086 | 2.426 | 0.238 | 20.0 | 6.856 | 0.6777 | 1.0 | 100.0 | 0.0 | Accelerating | 1 | 15.0 | 0.42670106887817383
28.197 | 0.97 | 27.341 | 1.16 | 20.0 | 10.231 | 1.1725 | 12.0 | 100.0 | 0.0 | Accelerating | 1 | 15.0 | 0.43869519233703613
28.181 | 1.253 | 35.316 | 4.362 | 20.0 | 12.98 | 1.0726 | 22.0 | 100.0 | 0.0 | Accelerating | 1 | 15.0 | 0.46555233001708984
28.159 | 2.016 | 56.771 | 9.638 | 20.12 | 15.802 | 1.0259 | 33.0 | 100.0 | 0.0 | Accelerating | 1 | 15.0 | 0.4963715076446533
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
