cononinator/GeecPE2526/Code/DynoTesting/dyno_sweep_20260407-162331.csv

Voltage | Current | Power | Energy | Temperature | MotorVoltage | MotorCurrent | MeasuredDutyCycle | TargetDutyCycle | WheelSpeed | Phase | Repeat | CurrentLimit_A | Timestamp_s | Dyno_Timestamp_ms | Dyno_Speed_kmh | Car_Speed_kmh | Dyno_Torque_Nm | Dyno_Power_W
27.1 | 0.084 | 2.26 | 3155.336 | 18.62 | 0.189 | 0.5826 | 0.0 | 0.0 | 0.0 | Accelerating | 1.0 | 20.0 | 0.11707019805908203
27.1 | 0.079 | 1.833 | 3155.543 | 18.62 | 0.294 | 0.5842 | 0.0 | 0.0 | 0.0 | Accelerating | 1.0 | 20.0 | 0.26383090019226074
27.1 | 0.06 | 1.654 | 3155.75 | 18.62 | 0.174 | 0.5923 | 0.0 | 0.0 | 0.0 | Accelerating | 1.0 | 20.0 | 0.2838139533996582
27.1 | 0.082 | 2.199 | 0.131 | 18.5 | 0.264 | 0.5875 | 0.0 | 0.0 | 0.0 | Accelerating | 1.0 | 20.0 | 0.3357813358306885
27.094 | 0.293 | 7.949 | 0.476 | 18.62 | 1.613 | 0.7124 | 6.0 | 100.0 | 0.0 | Accelerating | 1.0 | 20.0 | 0.37238073348999023
27.025 | 2.062 | 53.258 | 3.218 | 18.5 | 4.101 | 2.5457 | 17.0 | 100.0 | 0.0 | Accelerating | 1.0 | 20.0 | 0.4113881587982178
26.984 | 2.83 | 76.367 | 9.976 | 18.62 | 6.499 | 2.6424 | 27.0 | 100.0 | 0.0 | Accelerating | 1.0 | 20.0 | 0.43869543075561523
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
