cononinator/GeecPE2526/Code/DynoTesting/dist/dyno_sweep_20260407-170950_motor_voltage.png

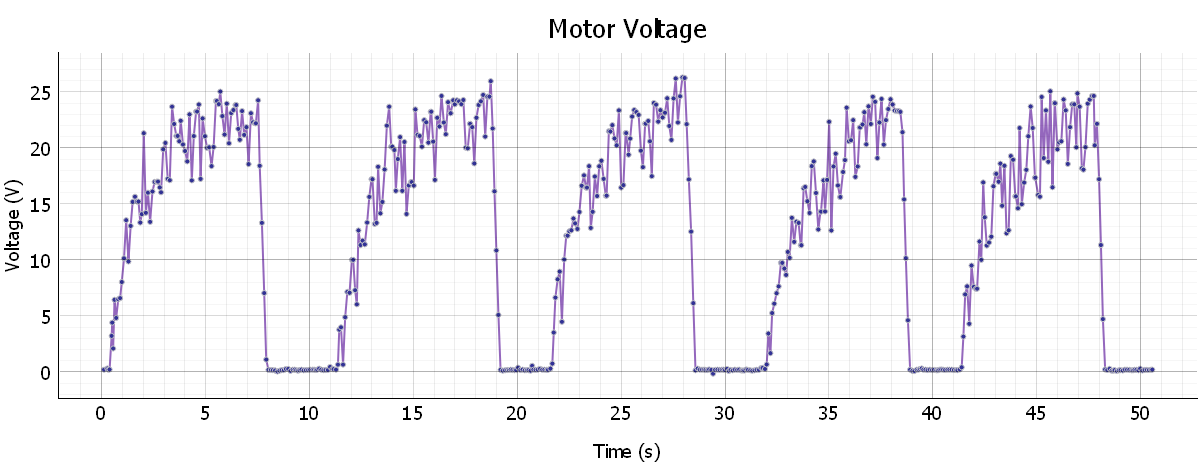
Code/DynoTesting/dist/dyno_sweep_20260407-170950_motor_voltage.png
