cononinator/GeecPE2526/Code/DynoTesting/dist/dyno_sweep_20260407-170950_speed.png

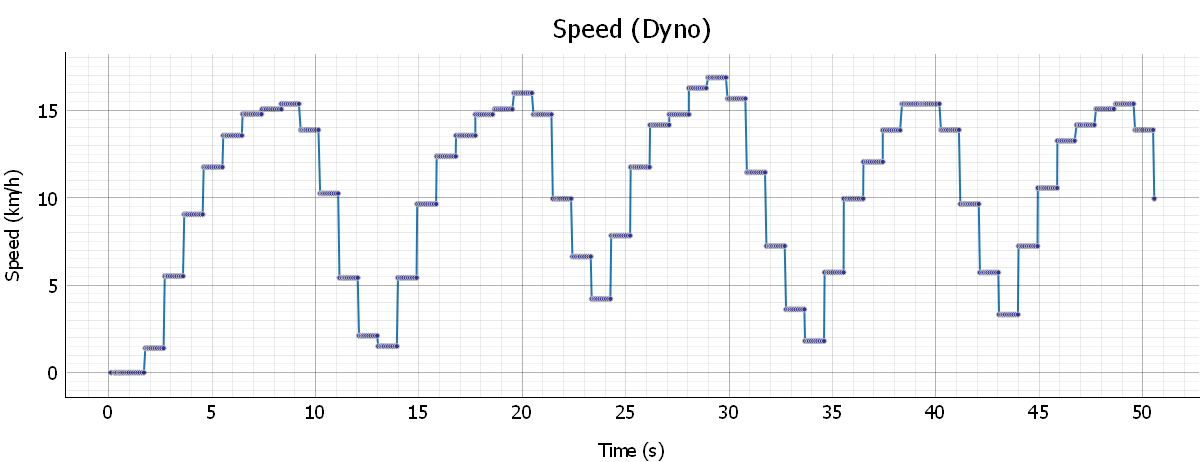
Code/DynoTesting/dist/dyno_sweep_20260407-170950_speed.png
