cononinator/GeecPE2526/Code/DynoTesting/dist/dyno_sweep_20260420-132728_motor_voltage.png

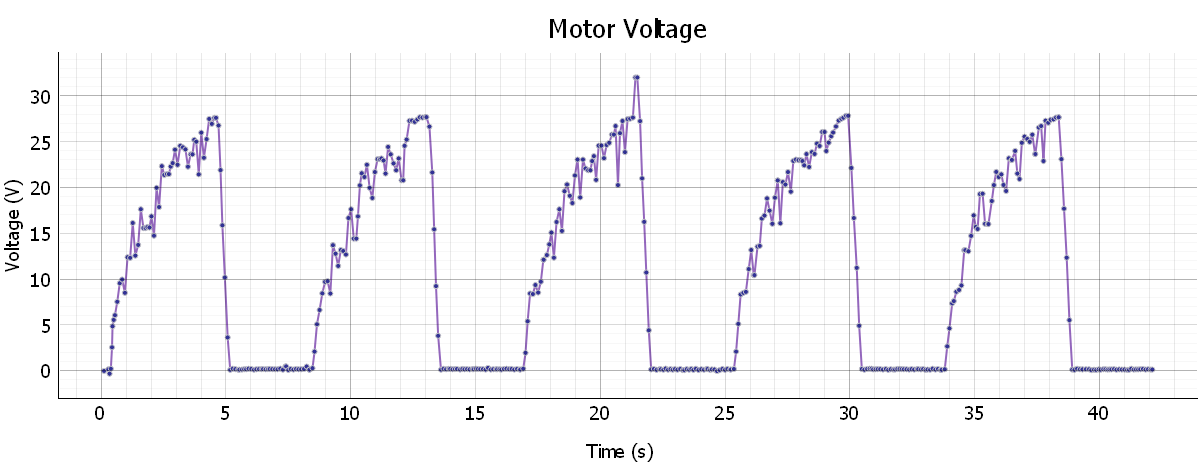
Code/DynoTesting/dist/dyno_sweep_20260420-132728_motor_voltage.png
