cononinator/GeecPE2526/Code/DynoTesting/dist/dyno_sweep_20260420-132728_speed.png

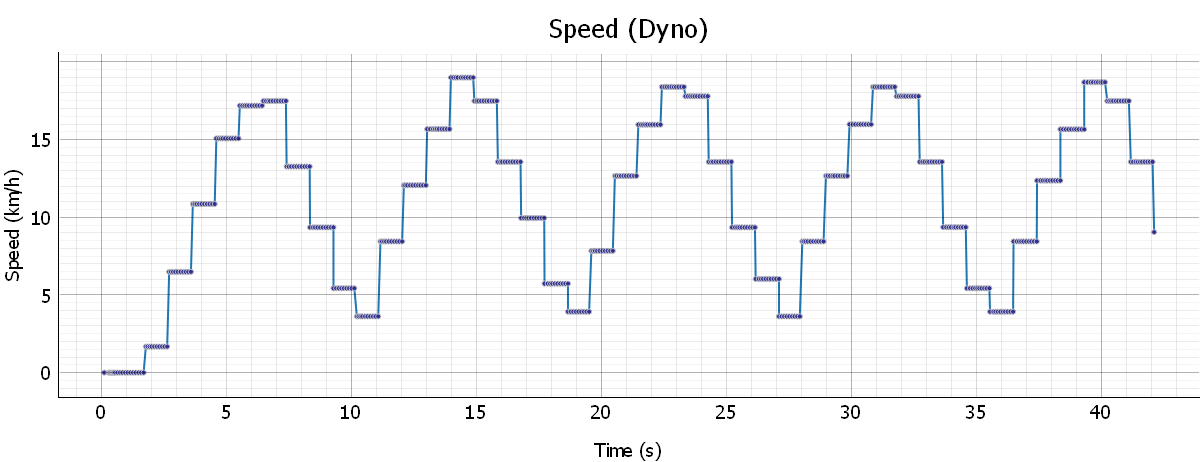
Code/DynoTesting/dist/dyno_sweep_20260420-132728_speed.png
