cononinator/GeecPE2526/Code/DynoTesting/dist/dyno_sweep_20260420-142344_power.png

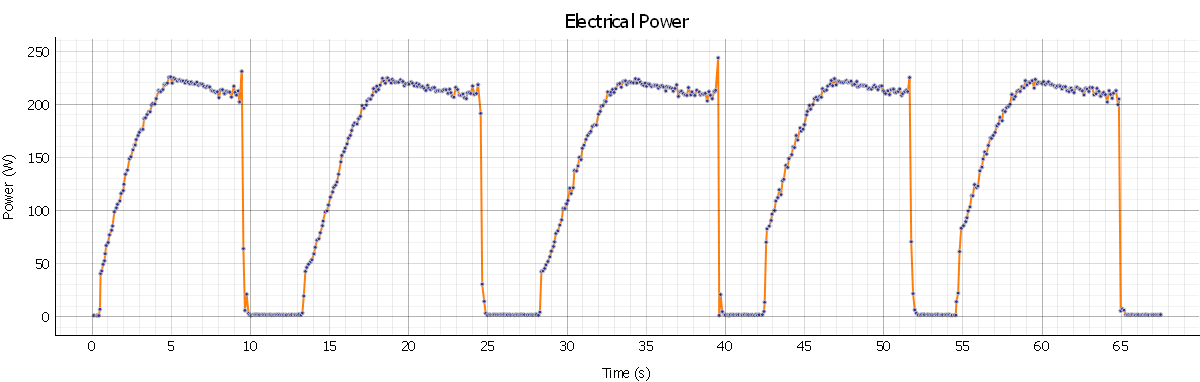
Code/DynoTesting/dist/dyno_sweep_20260420-142344_power.png
