cononinator/GeecPE2526/Code/DynoTesting/dist/run_dyno_sweep_gui/dyno_sweep_20260326-201657_dyno_power.png

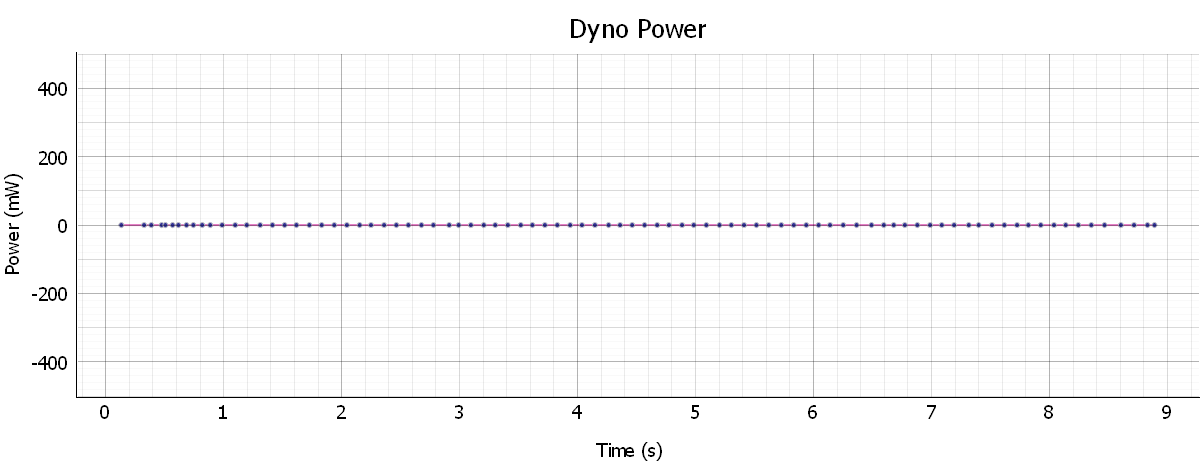
Code/DynoTesting/dist/run_dyno_sweep_gui/dyno_sweep_20260326-201657_dyno_power.png
