cononinator/GeecPE2526/Code/DynoTesting/dyno_sweep_20260327-153340_dyno_torque.png

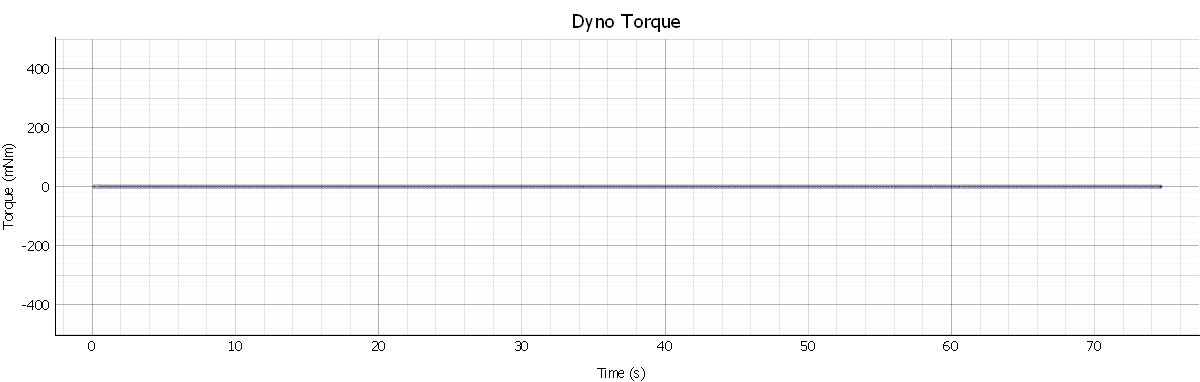
Code/DynoTesting/dyno_sweep_20260327-153340_dyno_torque.png
