cononinator/GeecPE2526/Code/DynoTesting/dyno_sweep_20260327-153340_speed.png

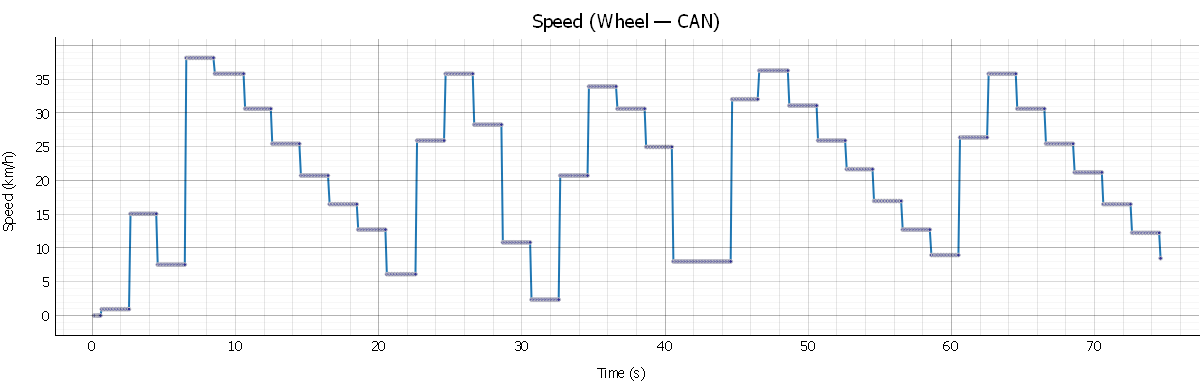
Code/DynoTesting/dyno_sweep_20260327-153340_speed.png
