cononinator/GeecPE2526/Code/DynoTesting/dyno_sweep_20260407-162331_dyno_torque.png

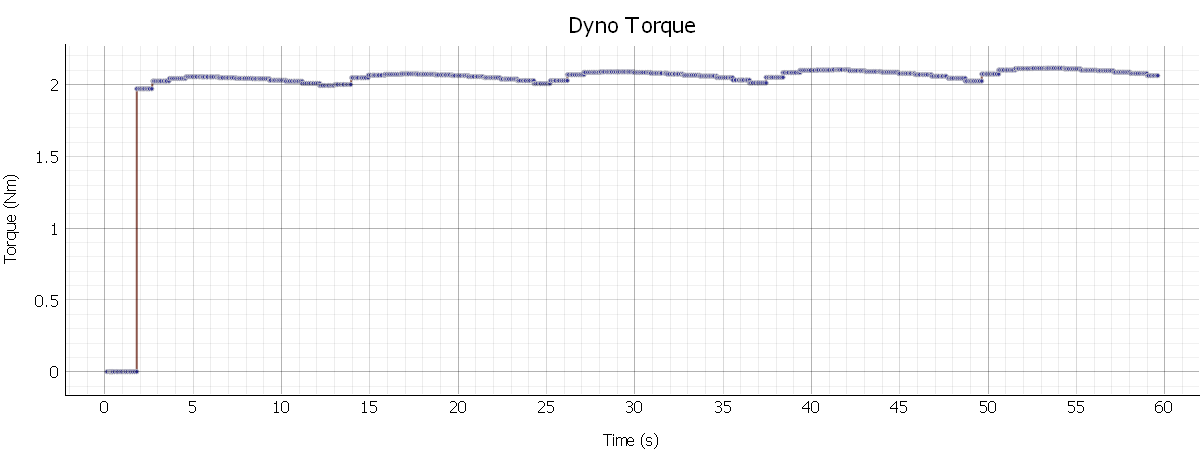
Code/DynoTesting/dyno_sweep_20260407-162331_dyno_torque.png
