cononinator/GeecPE2526/Code/DynoTesting/dyno_sweep_20260407-162331_power.png

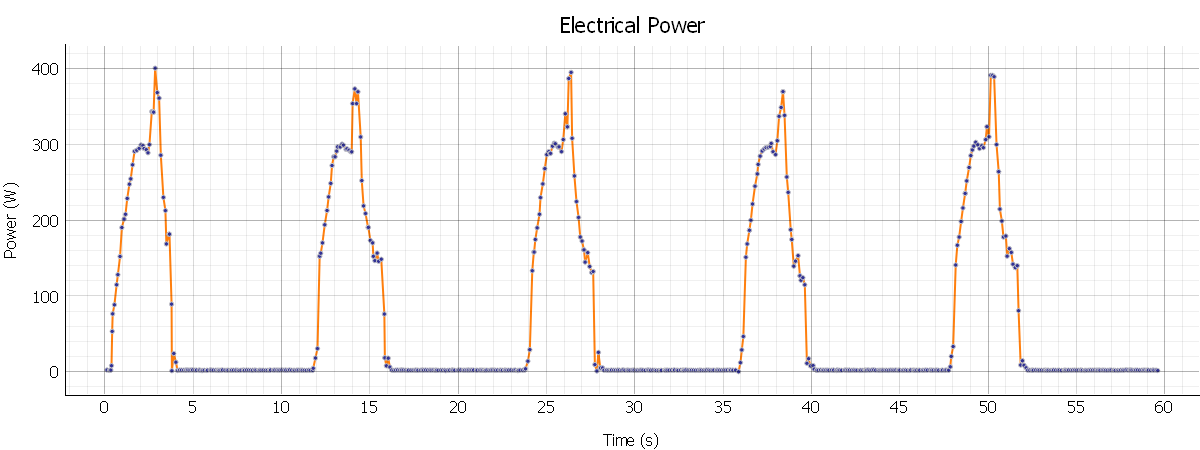
Code/DynoTesting/dyno_sweep_20260407-162331_power.png
