cononinator/GeecPE2526/Code/DynoTesting/dyno_sweep_20260407-163411_motor_voltage.png

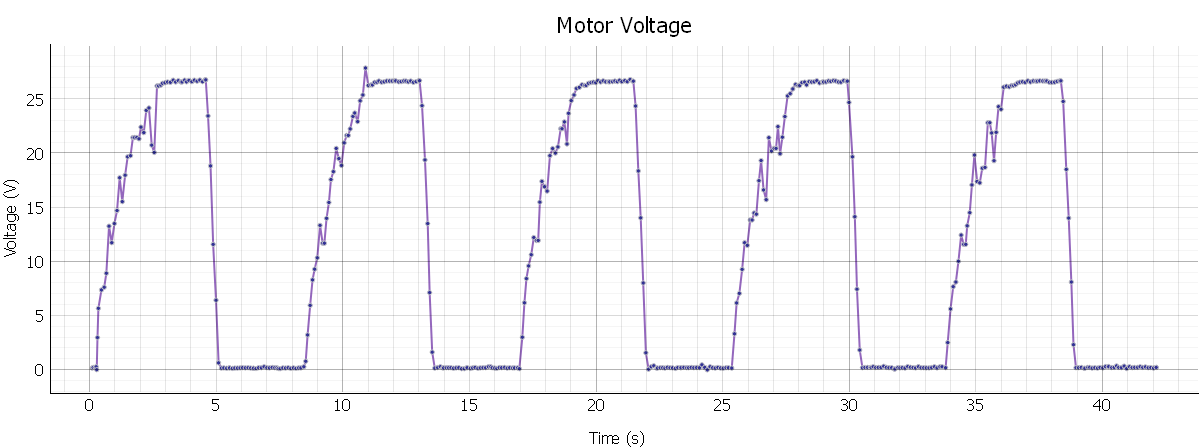
Code/DynoTesting/dyno_sweep_20260407-163411_motor_voltage.png
