cononinator/GeecPE2526/Code/DynoTesting/dyno_sweep_20260407-163411_power.png

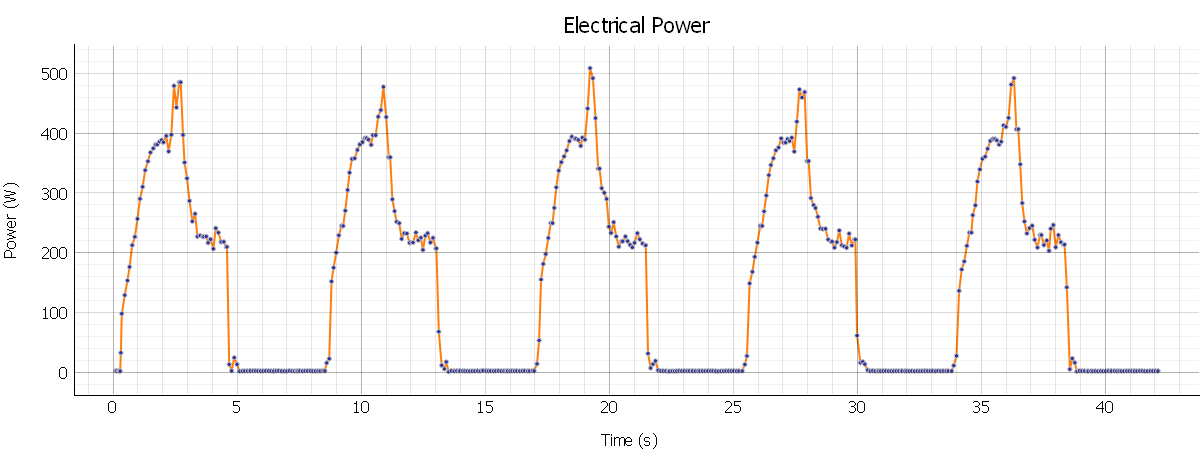
Code/DynoTesting/dyno_sweep_20260407-163411_power.png
