cononinator/GeecPE2526/Code/DynoTesting/dyno_sweep_20260408-094049_current.png

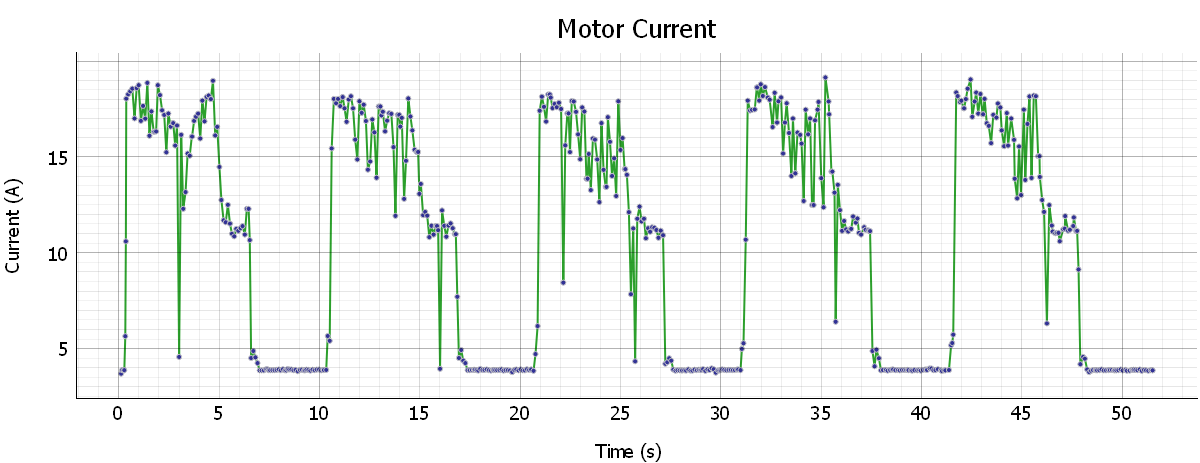
Code/DynoTesting/dyno_sweep_20260408-094049_current.png
