cononinator/GeecPE2526/Code/DynoTesting/dyno_sweep_20260408-094049_dyno_power.png

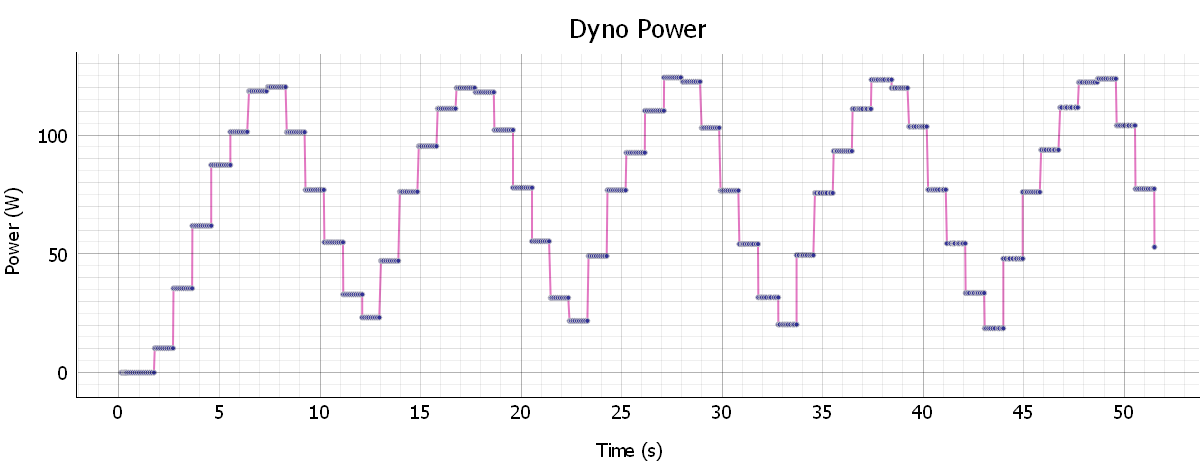
Code/DynoTesting/dyno_sweep_20260408-094049_dyno_power.png
