cononinator/GeecPE2526/Code/TestCode/ClosedLoopTest/Other_Results/dyno_sweep_20260320-165921_temp.png

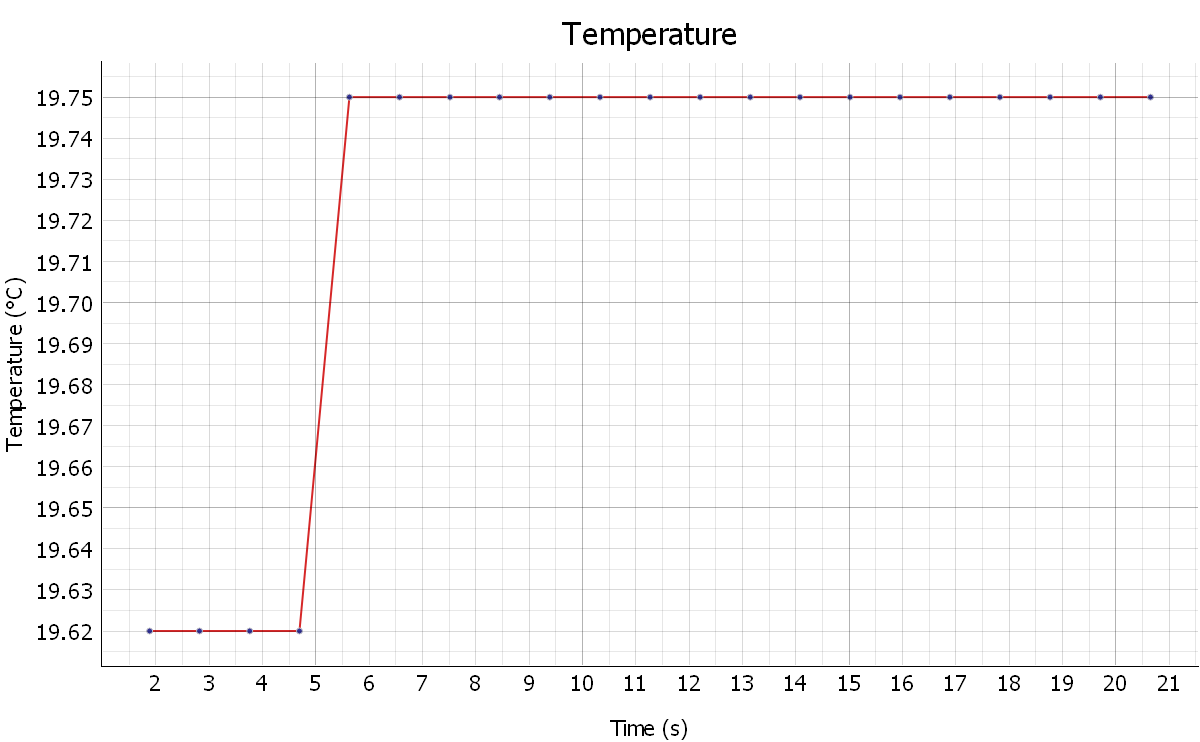
Code/TestCode/ClosedLoopTest/Other_Results/dyno_sweep_20260320-165921_temp.png
