cononinator/GeecPE2526/Code/TestCode/ClosedLoopTest/Other_Results/dyno_sweep_20260320-165957_power.png

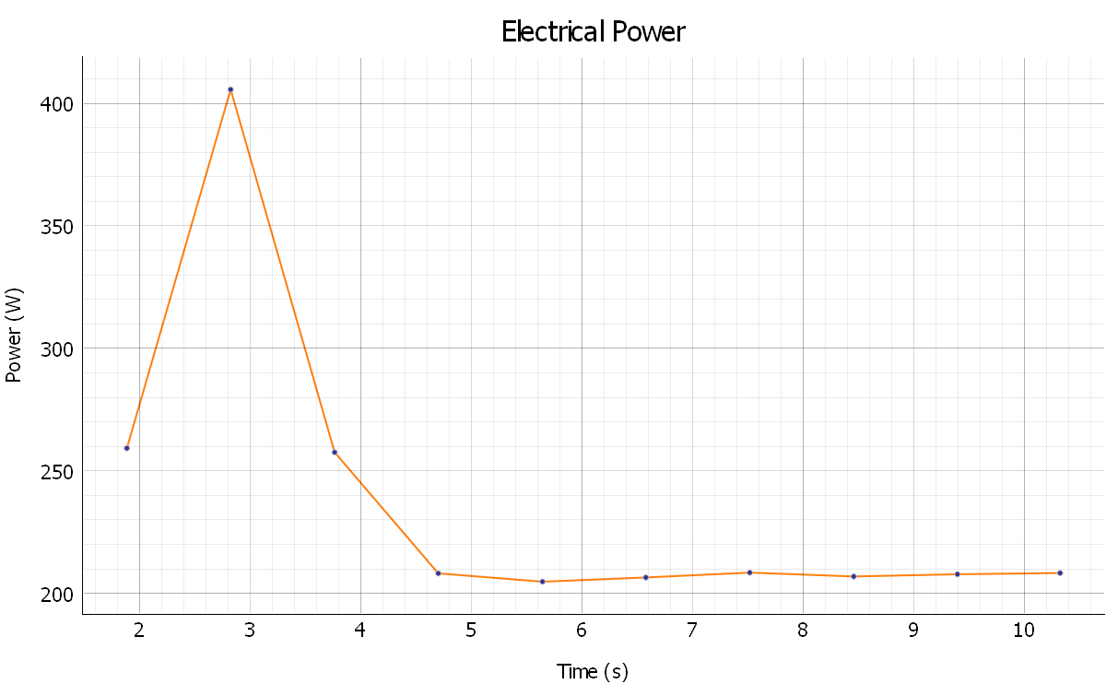
Code/TestCode/ClosedLoopTest/Other_Results/dyno_sweep_20260320-165957_power.png
