cononinator/GeecPE2526/Code/TestCode/ClosedLoopTest/Other_Results/dyno_sweep_20260320-170233_power.png

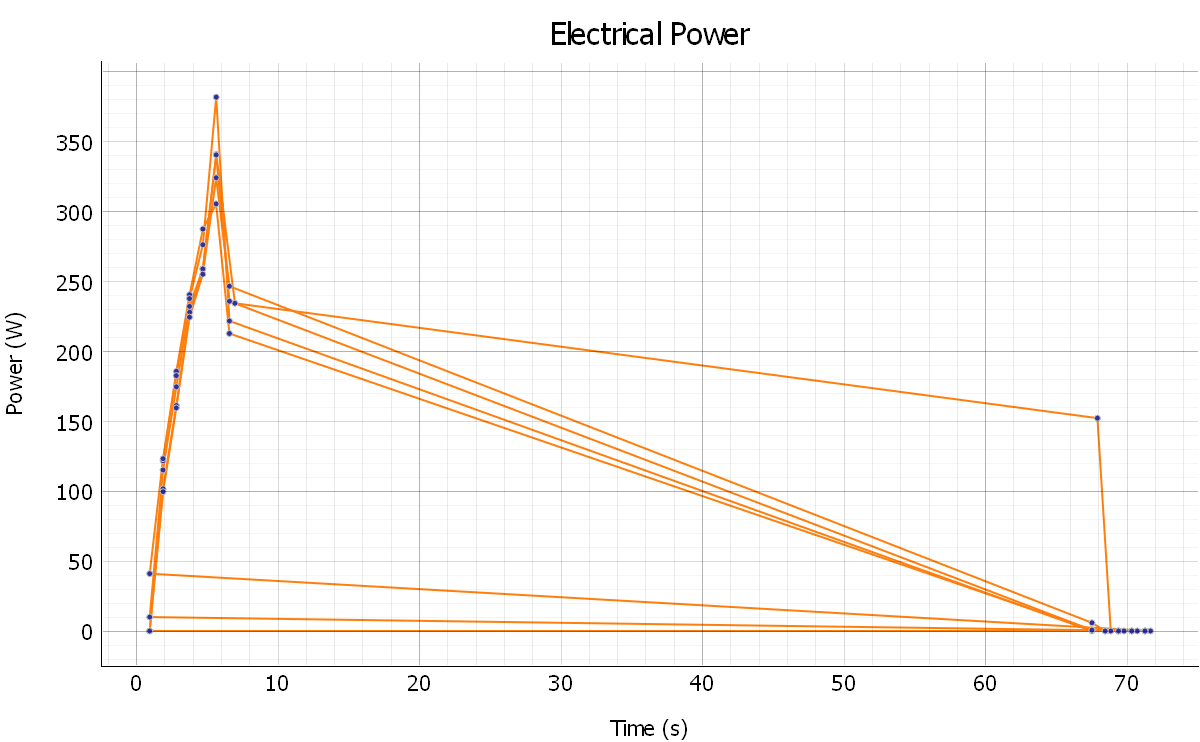
Code/TestCode/ClosedLoopTest/Other_Results/dyno_sweep_20260320-170233_power.png
