cononinator/GeecPE2526/Code/TestCode/ClosedLoopTest/Other_Results/dyno_sweep_20260320-170233_speed.png

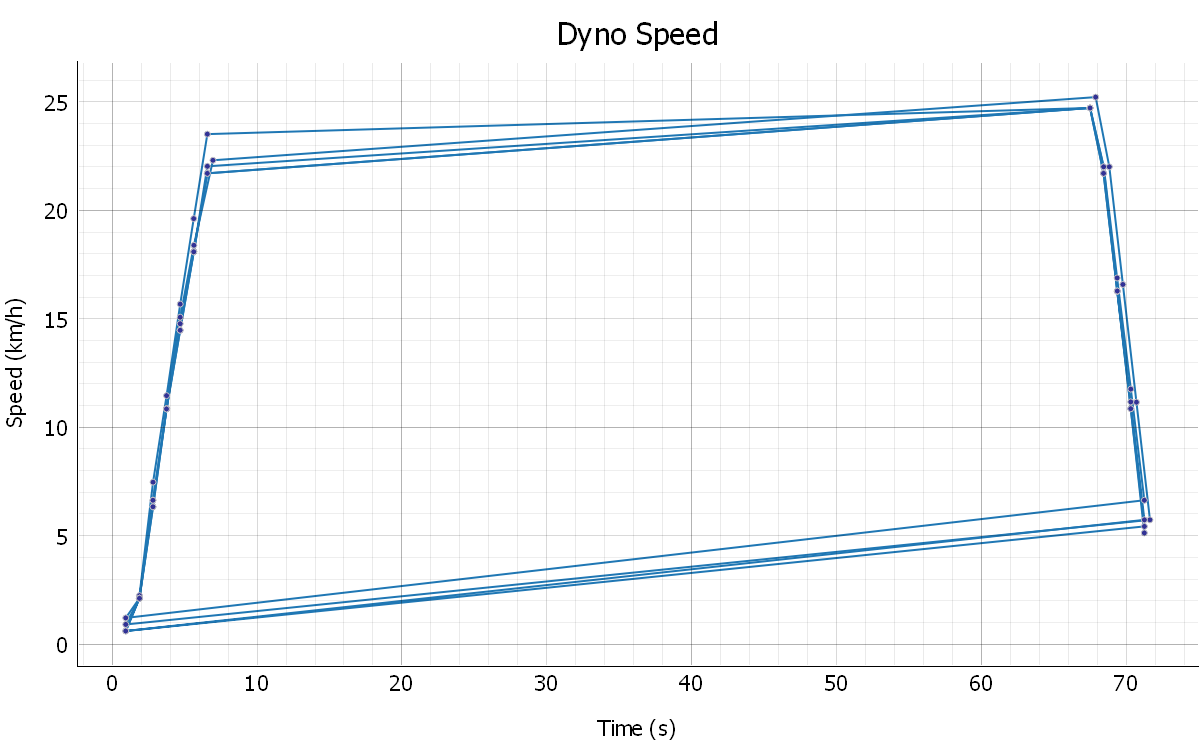
Code/TestCode/ClosedLoopTest/Other_Results/dyno_sweep_20260320-170233_speed.png
