cononinator/GeecPE2526/Code/TestCode/ClosedLoopTest/Other_Results/dyno_sweep_20260323-113517_current.png

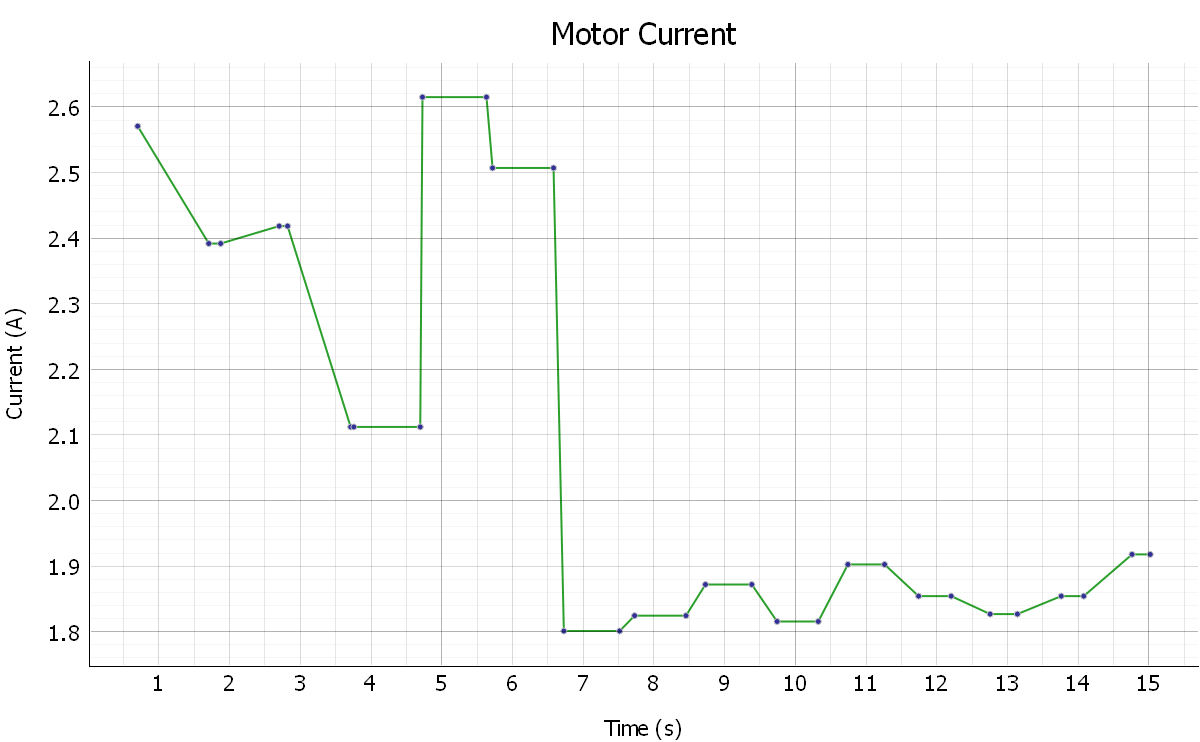
Code/TestCode/ClosedLoopTest/Other_Results/dyno_sweep_20260323-113517_current.png
