cononinator/GeecPE2526/Code/TestCode/ClosedLoopTest/Other_Results/dyno_sweep_20260323-113628_speed.png

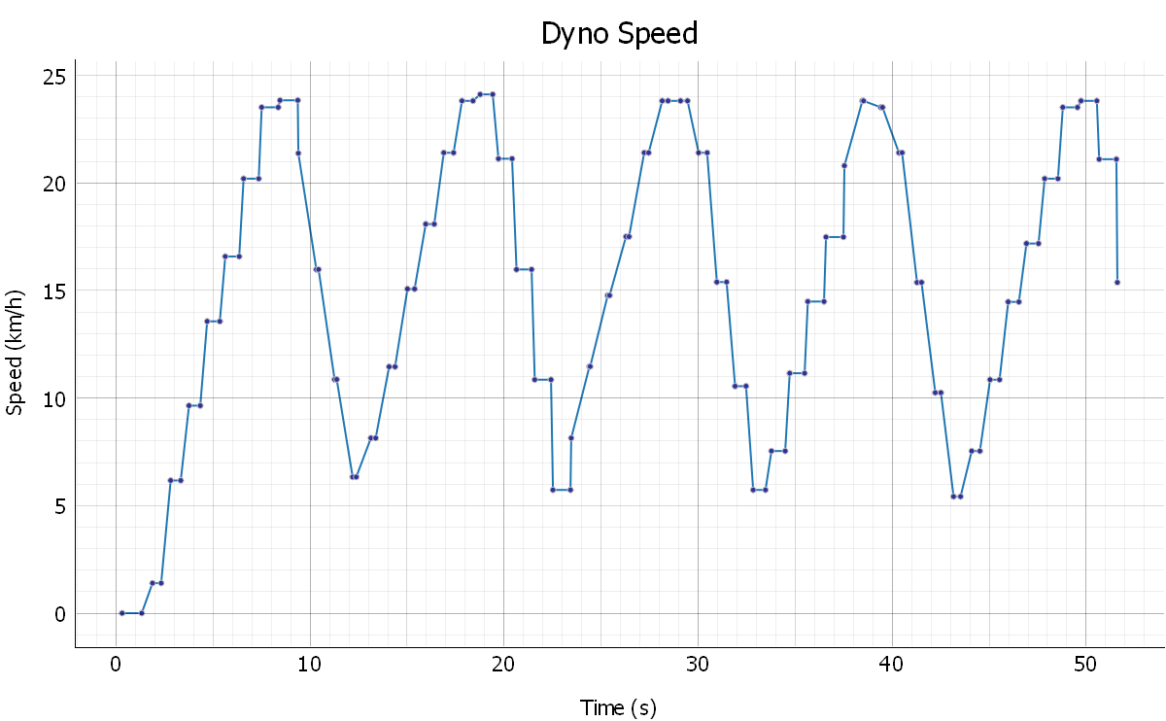
Code/TestCode/ClosedLoopTest/Other_Results/dyno_sweep_20260323-113628_speed.png
