cononinator/GeecPE2526/Code/TestCode/ClosedLoopTest/Other_Results/dyno_sweep_20260323-114722_temp.png

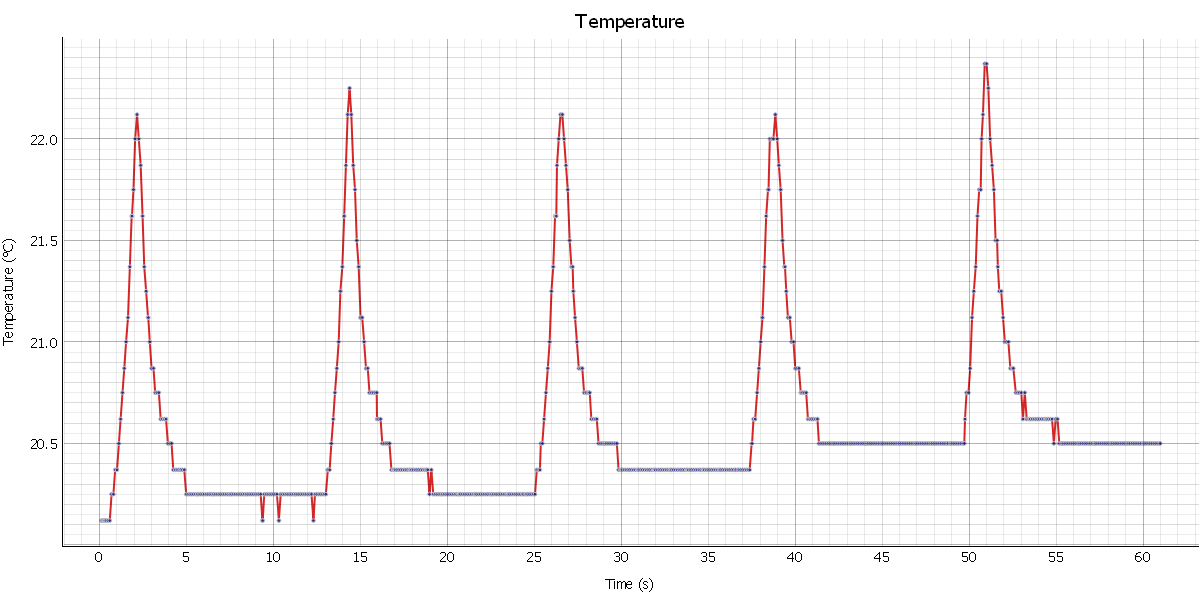
Code/TestCode/ClosedLoopTest/Other_Results/dyno_sweep_20260323-114722_temp.png
