cononinator/GeecPE2526/Code/TestCode/ClosedLoopTest/Other_Results/dyno_sweep_20260323-114831_power.png

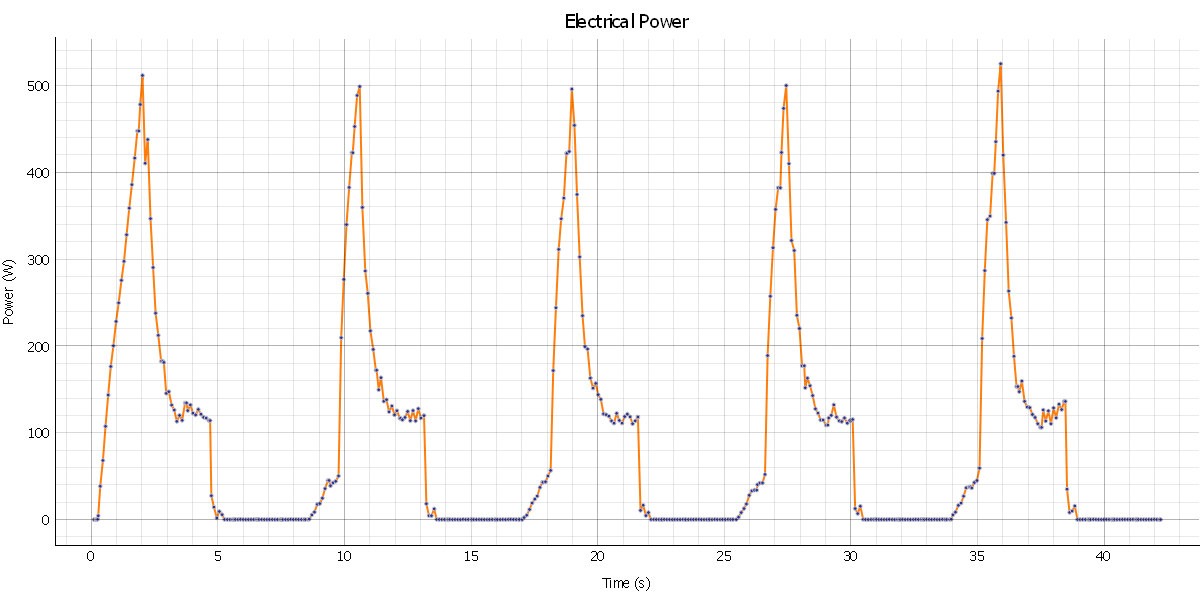
Code/TestCode/ClosedLoopTest/Other_Results/dyno_sweep_20260323-114831_power.png
