cononinator/GeecPE2526/Code/TestCode/ClosedLoopTest/Other_Results/dyno_sweep_20260323-114946_current.png

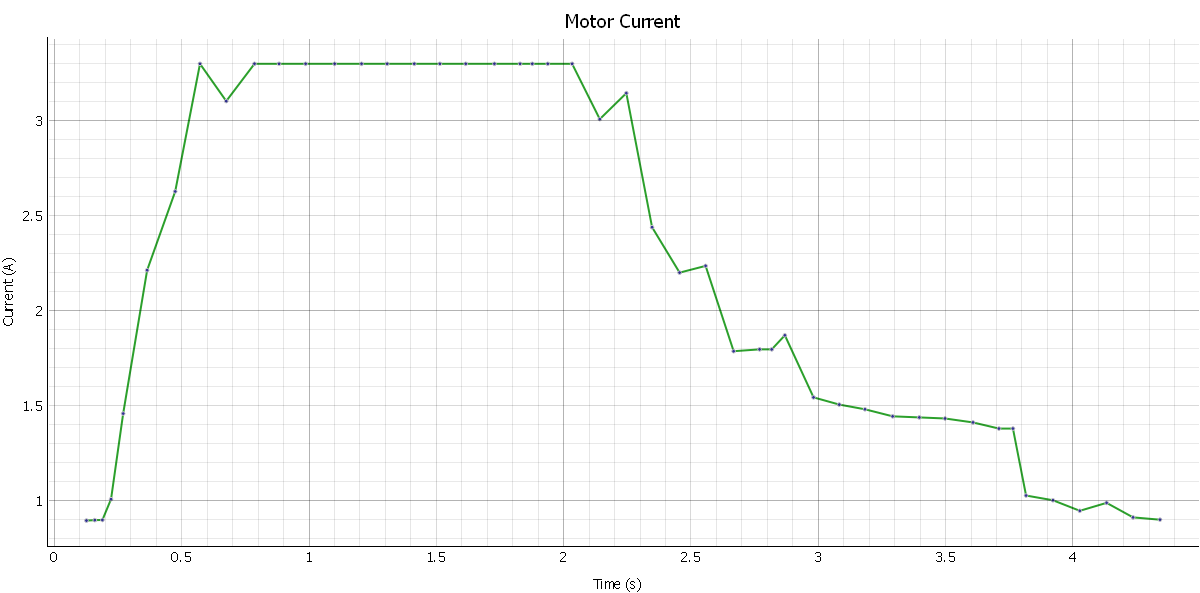
Code/TestCode/ClosedLoopTest/Other_Results/dyno_sweep_20260323-114946_current.png
