cononinator/GeecPE2526/Code/TestCode/ClosedLoopTest/Other_Results/dyno_sweep_20260323-115205_temp.png

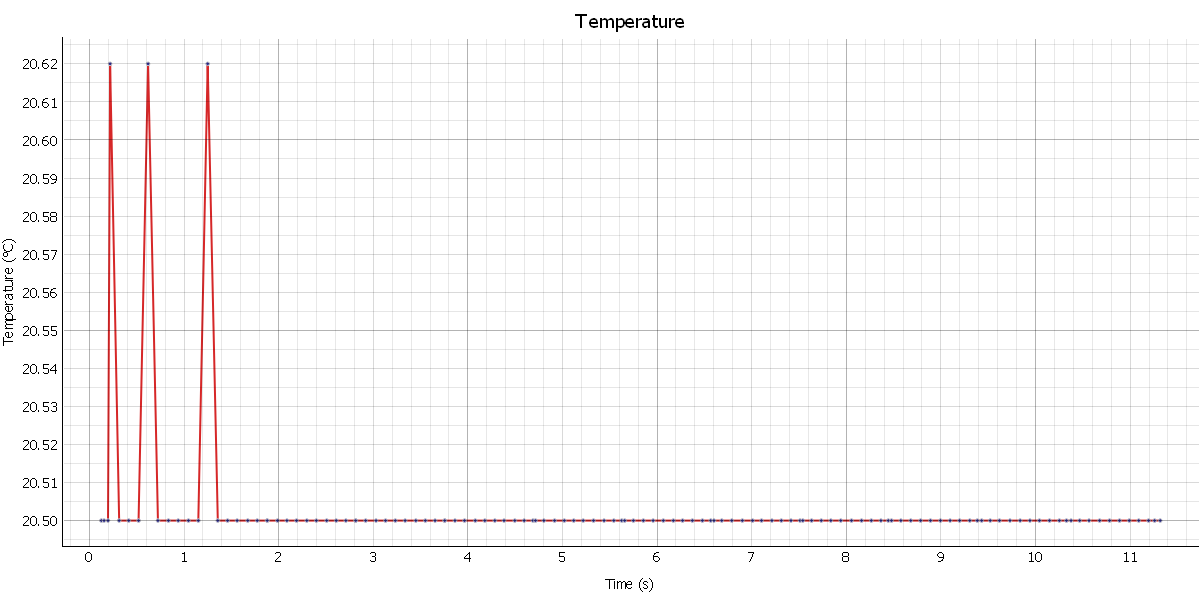
Code/TestCode/ClosedLoopTest/Other_Results/dyno_sweep_20260323-115205_temp.png
