cononinator/GeecPE2526/Code/TestCode/ClosedLoopTest/Other_Results/dyno_sweep_20260323-120101_current.png

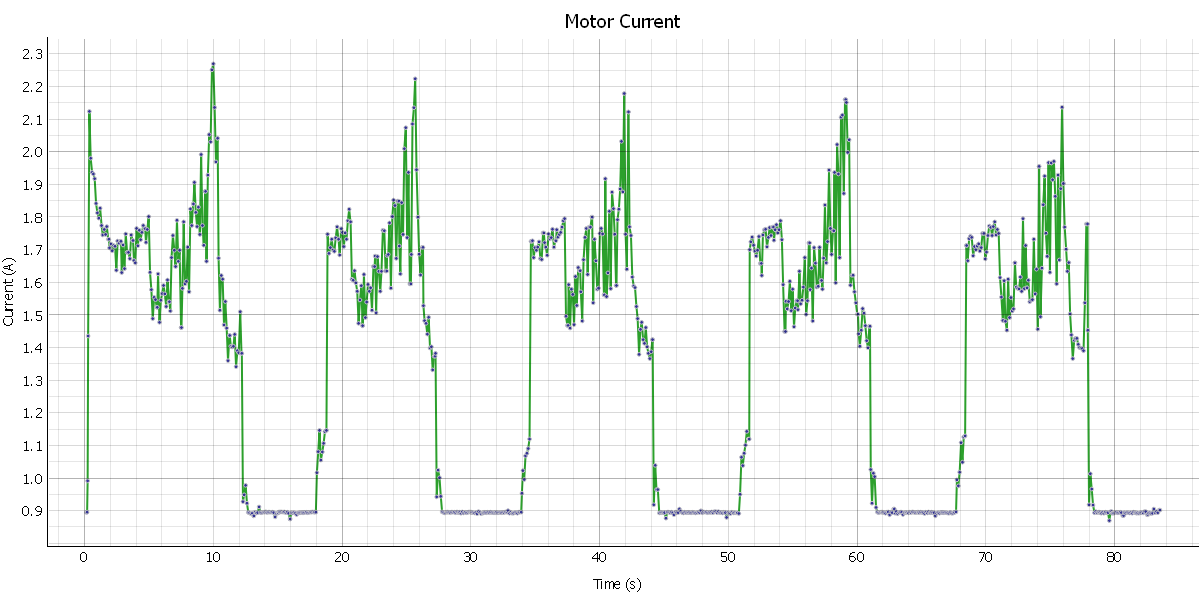
Code/TestCode/ClosedLoopTest/Other_Results/dyno_sweep_20260323-120101_current.png
