cononinator/GeecPE2526/Code/TestCode/ClosedLoopTest/Other_Results/dyno_sweep_20260323-120808_temp.png

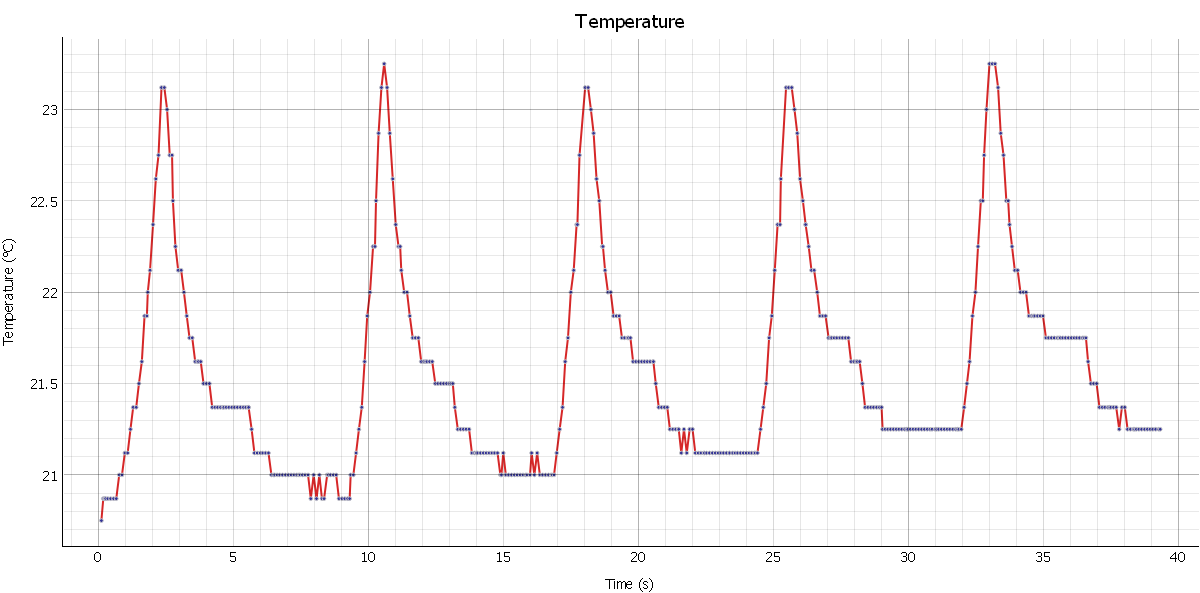
Code/TestCode/ClosedLoopTest/Other_Results/dyno_sweep_20260323-120808_temp.png
