cononinator/GeecPE2526/Code/TestCode/ClosedLoopTest/TestScript/dyno_sweep_20260324-094810_temp.png

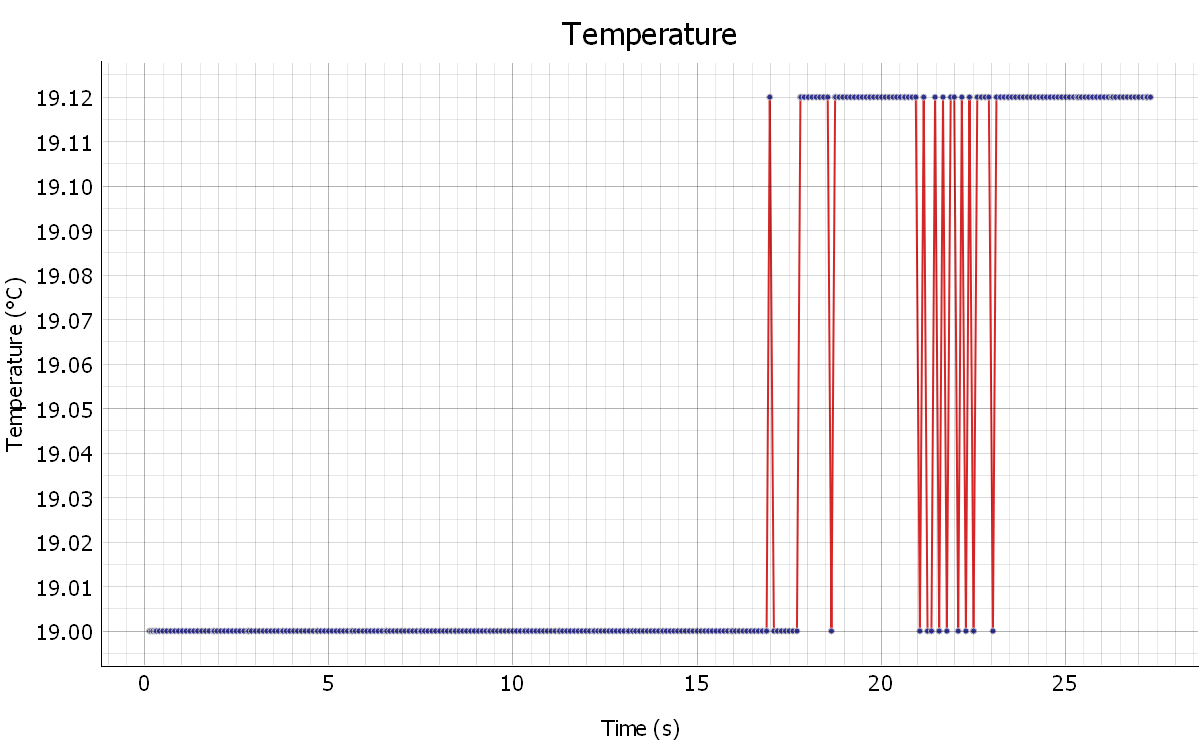
Code/TestCode/ClosedLoopTest/TestScript/dyno_sweep_20260324-094810_temp.png
