cononinator/GeecPE2526/Code/TestCode/ClosedLoopTest/TestScript/dyno_sweep_20260324-095655_temp.png

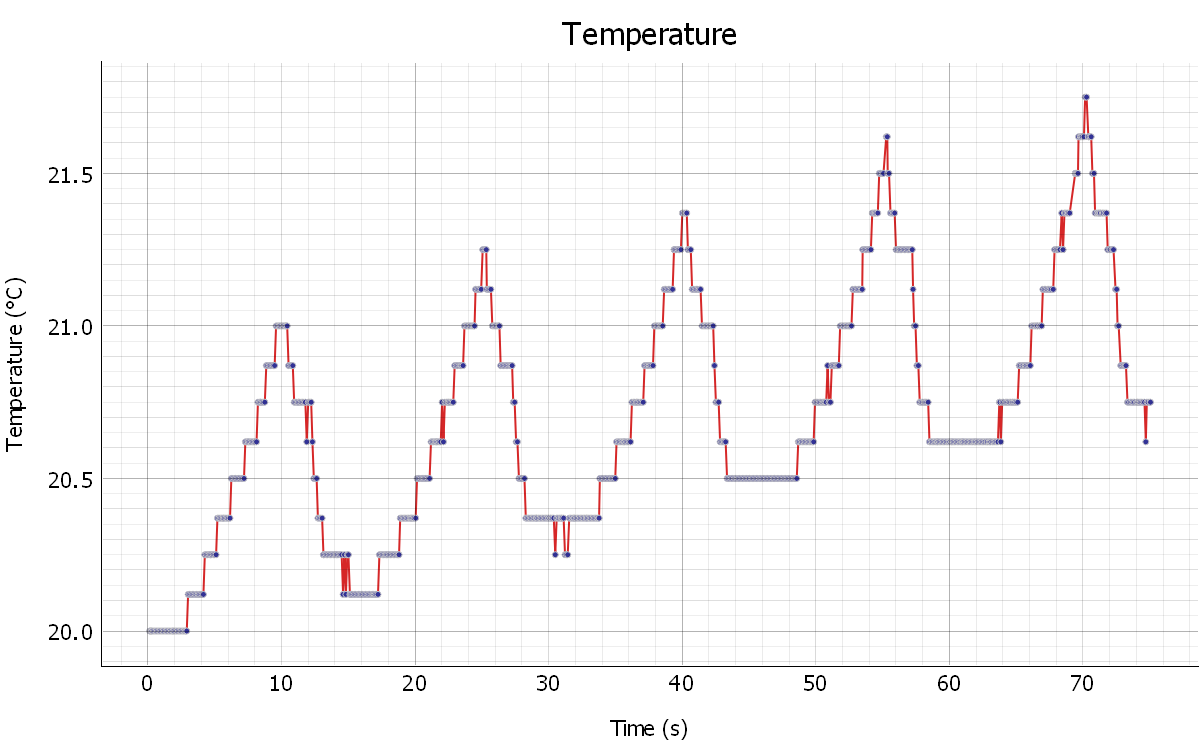
Code/TestCode/ClosedLoopTest/TestScript/dyno_sweep_20260324-095655_temp.png
