cononinator/GeecPE2526/Code/TestCode/ClosedLoopTest/TestScript/dyno_sweep_20260324-095732_power.png

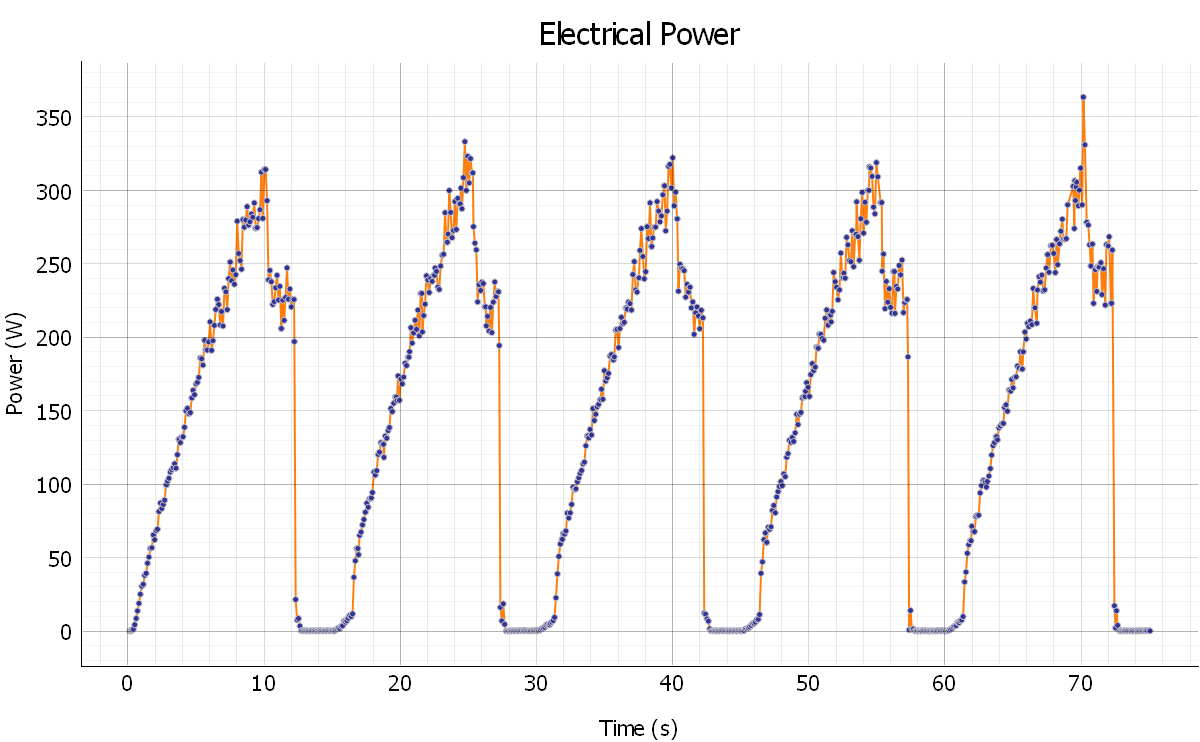
Code/TestCode/ClosedLoopTest/TestScript/dyno_sweep_20260324-095732_power.png
