cononinator/GeecPE2526/Code/TestCode/ClosedLoopTest/TestScript/dyno_sweep_20260324-095732_speed.png

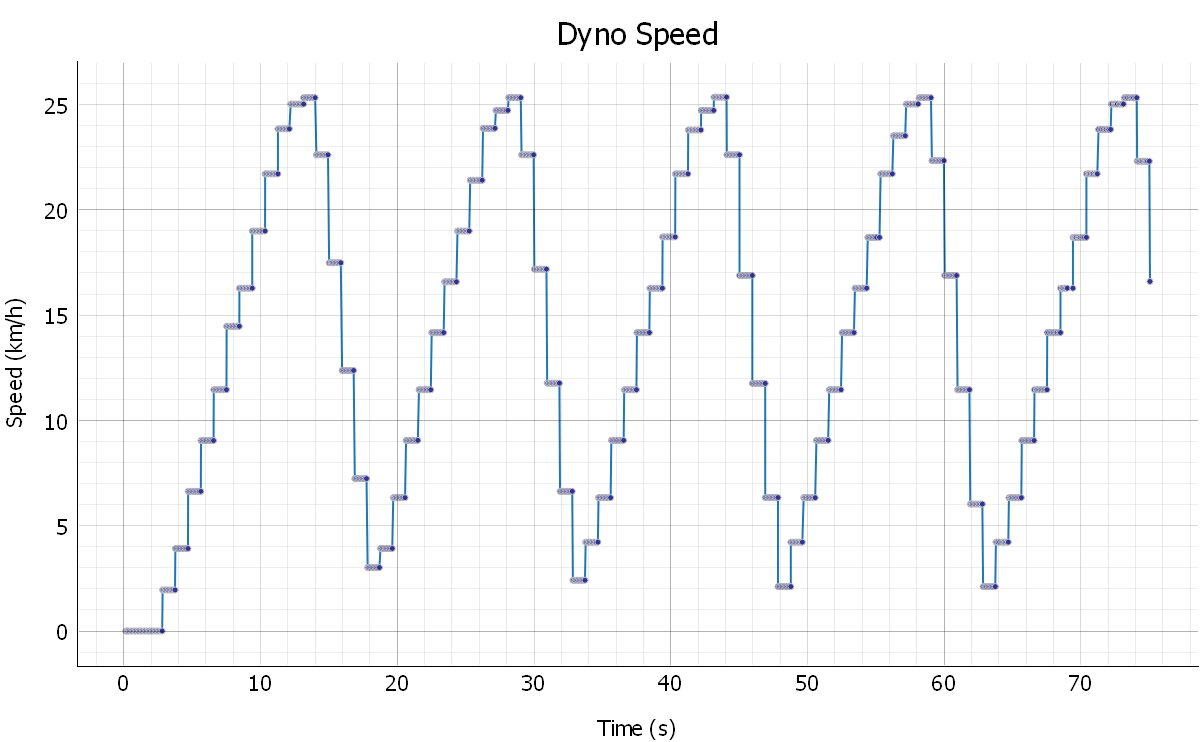
Code/TestCode/ClosedLoopTest/TestScript/dyno_sweep_20260324-095732_speed.png
