cononinator/GeecPE2526/Code/TestCode/ClosedLoopTest/TestScript/ramp_energy_comparison.png

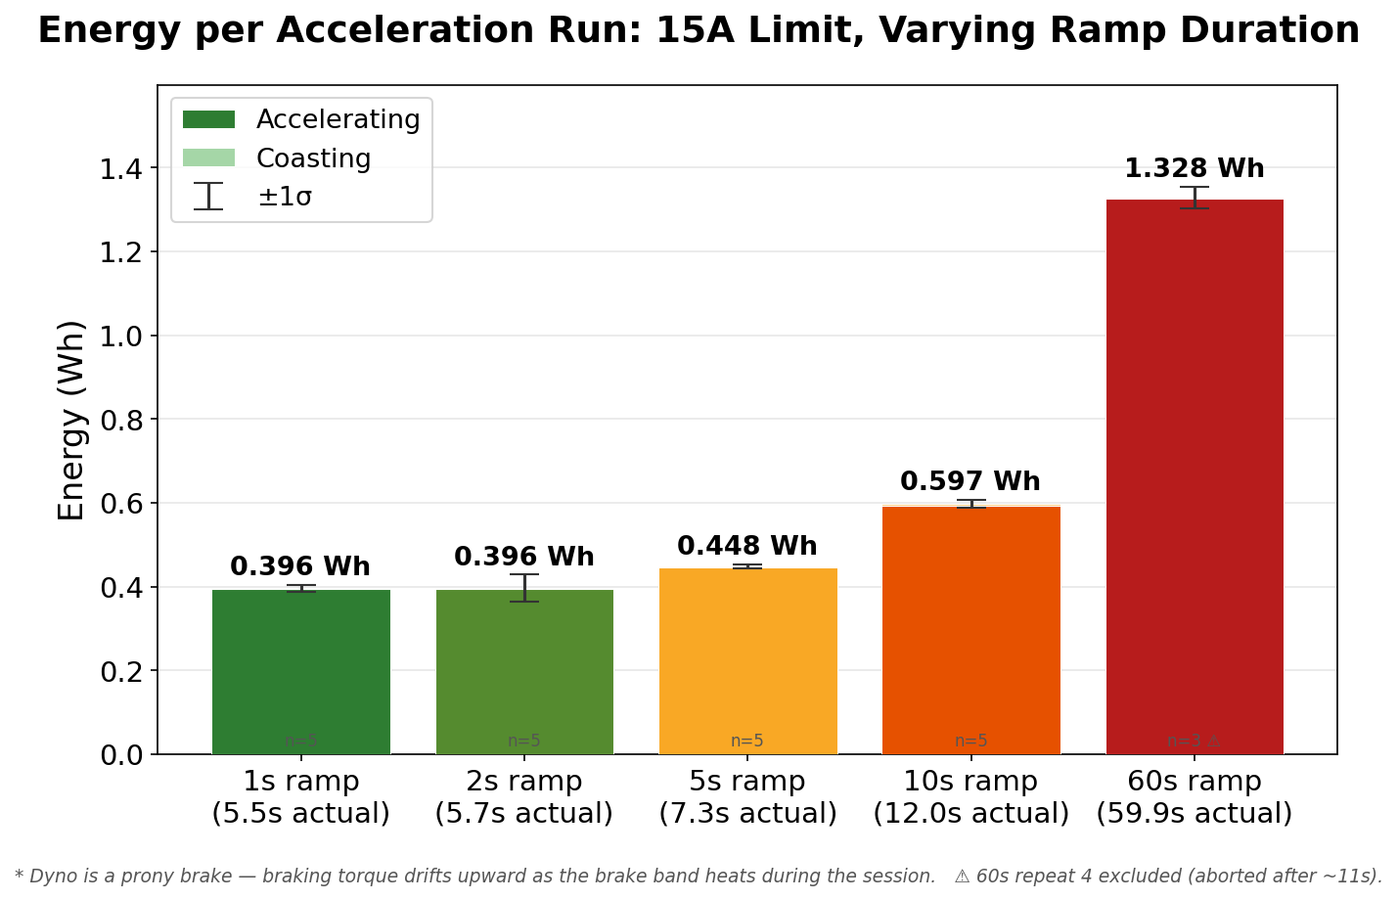
Code/TestCode/ClosedLoopTest/TestScript/ramp_energy_comparison.png
