cononinator/GeecPE2526/Code/TestCode/ClosedLoopTest/TestScript/Test-1s_ramp_15A_45kHz_power.png

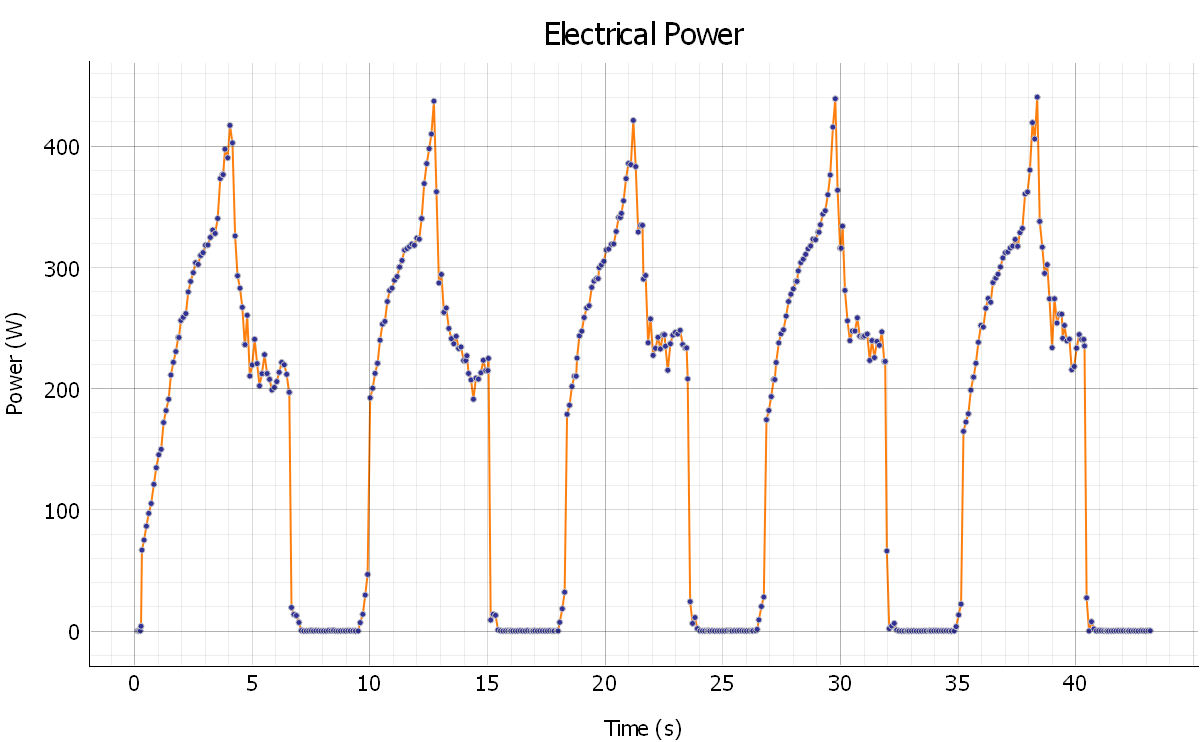
Code/TestCode/ClosedLoopTest/TestScript/Test-1s_ramp_15A_45kHz_power.png
