cononinator/GeecPE2526/Code/TestCode/ClosedLoopTest/TestScript/Test-1s_ramp_15A_60kHz_speed.png

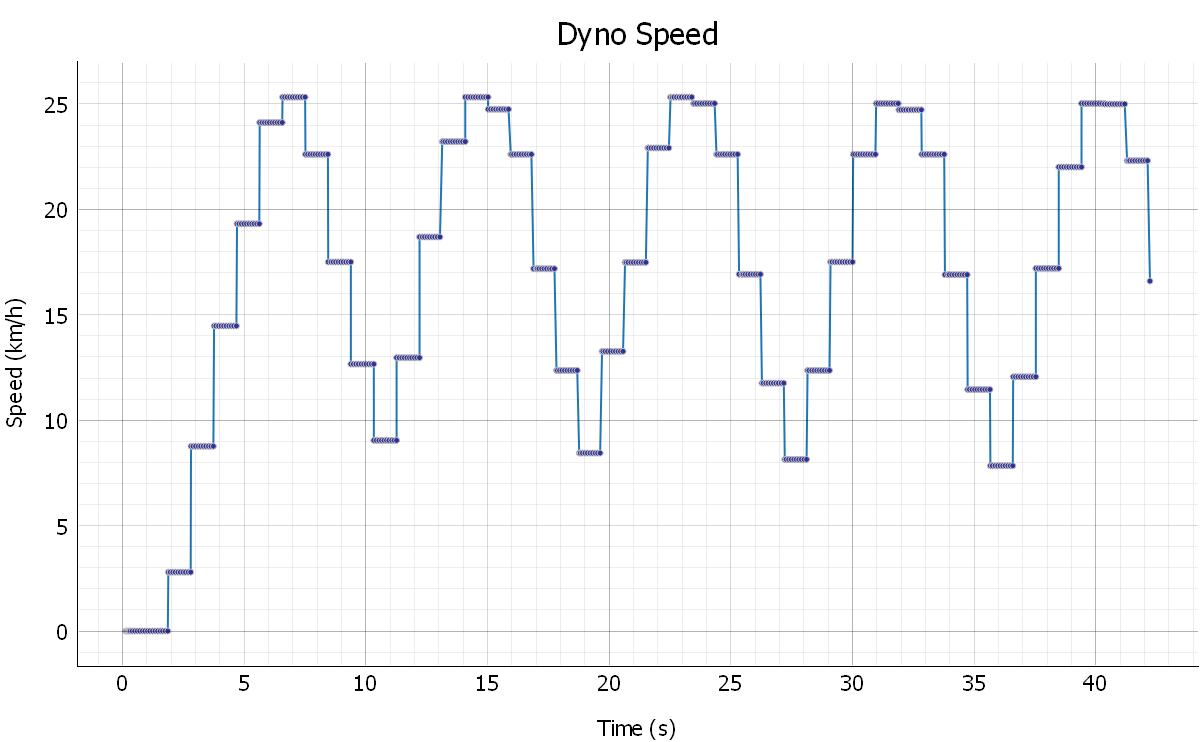
Code/TestCode/ClosedLoopTest/TestScript/Test-1s_ramp_15A_60kHz_speed.png
