cononinator/GeecPE2526/Code/TestCode/ClosedLoopTest/TestScript/Test-1s_ramp_25A_30kHzz_current.png

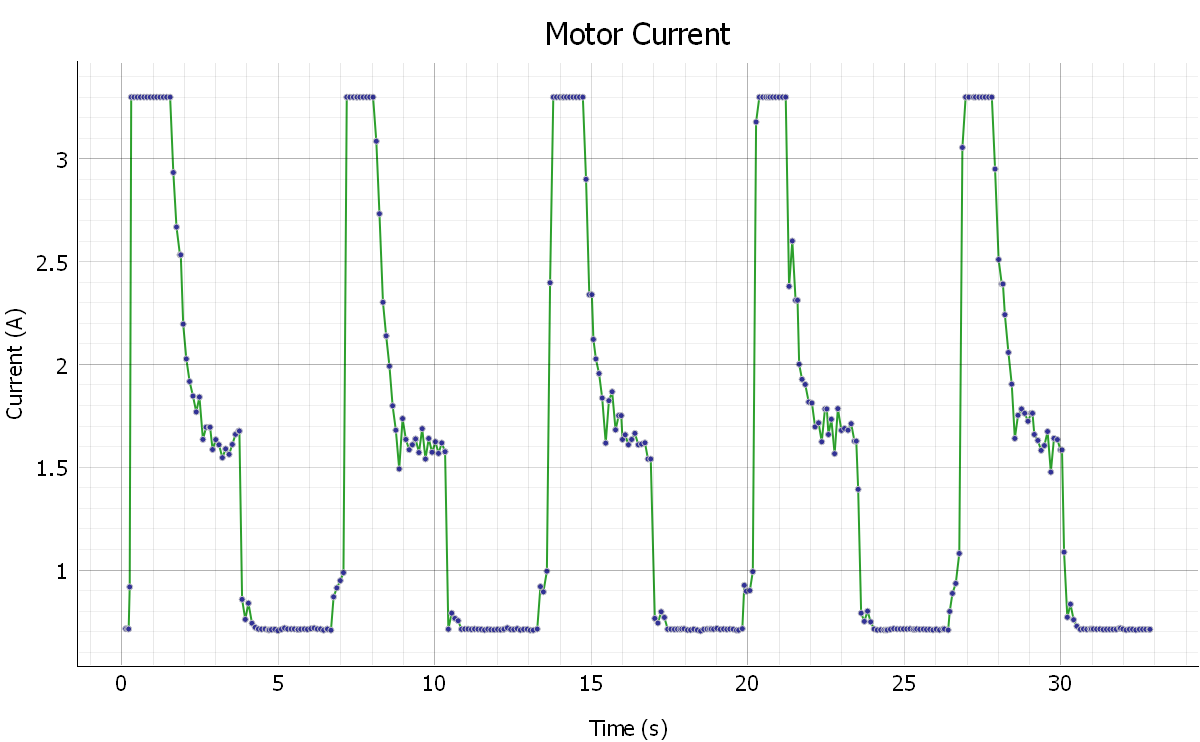
Code/TestCode/ClosedLoopTest/TestScript/Test-1s_ramp_25A_30kHzz_current.png
