cononinator/GeecPE2526/Code/TestCode/ClosedLoopTest/TestScript/Test-1s_ramp_25A_60kHz_power.png

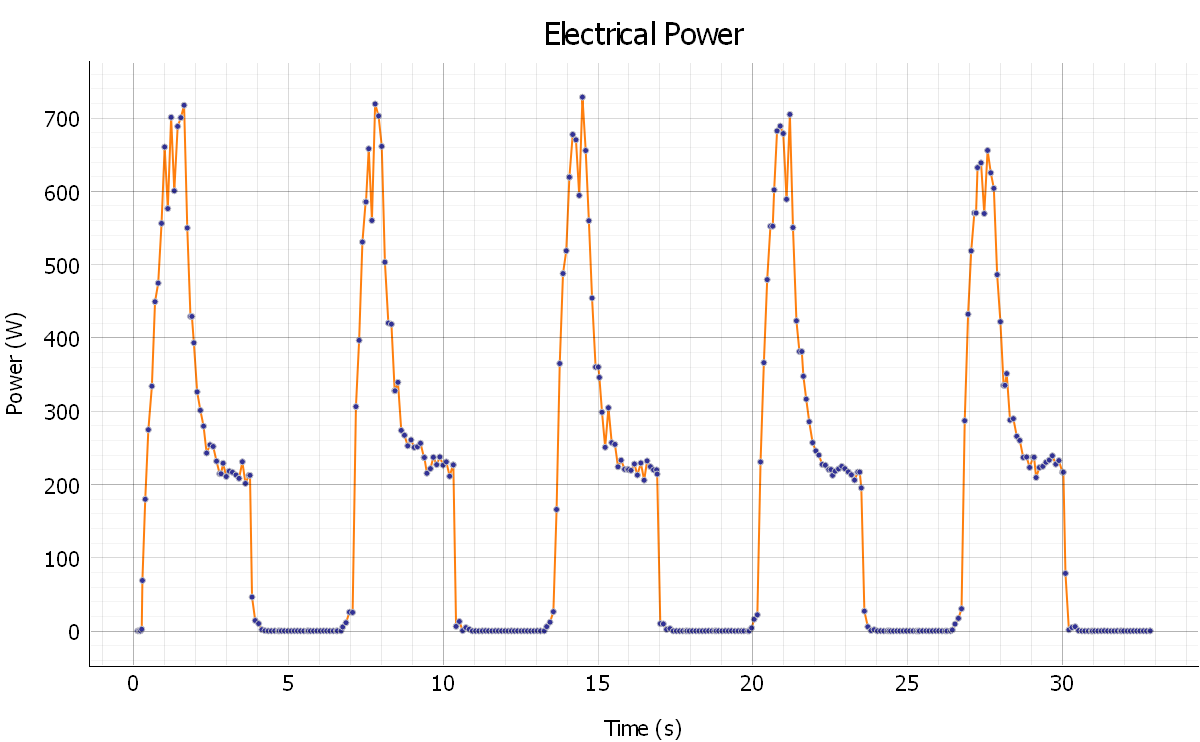
Code/TestCode/ClosedLoopTest/TestScript/Test-1s_ramp_25A_60kHz_power.png
