cononinator/GeecPE2526/Code/TestCode/ClosedLoopTest/TestScript/Test-2s_ramp_15A_current.png

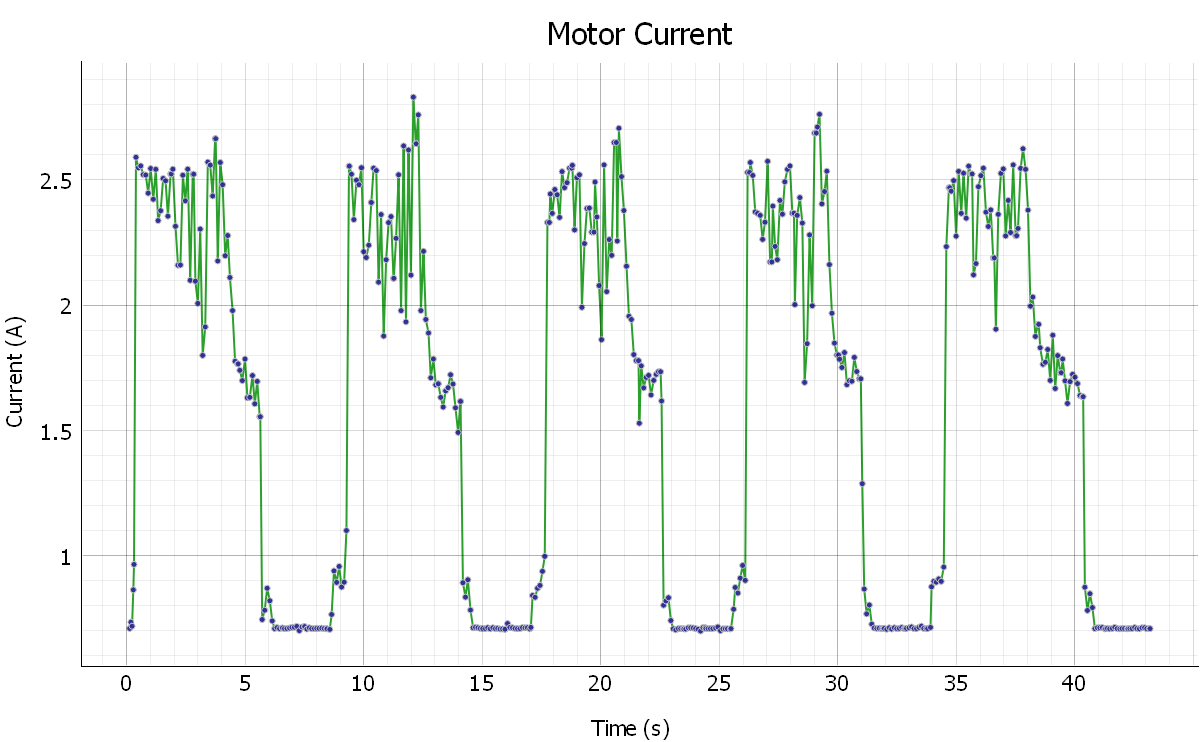
Code/TestCode/ClosedLoopTest/TestScript/Test-2s_ramp_15A_current.png
