cononinator/GeecPE2526/Code/TestCode/ClosedLoopTest/TestScript/Test-5s_ramp_15A_temp.png

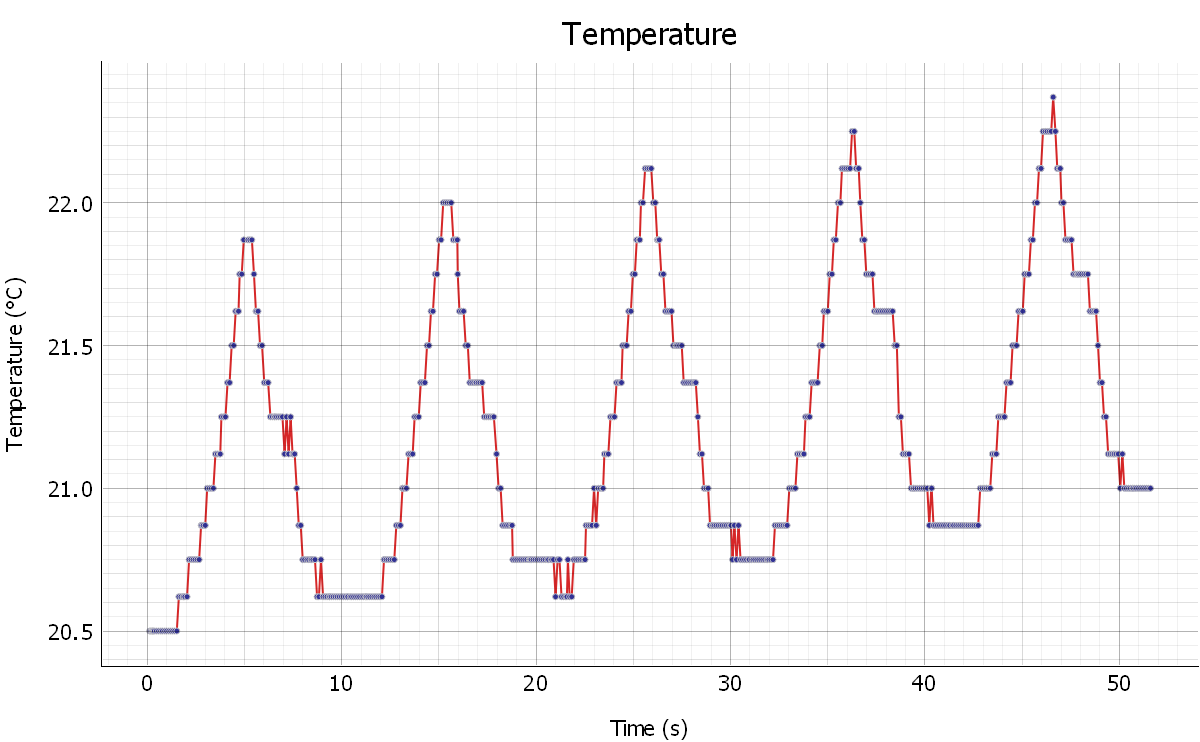
Code/TestCode/ClosedLoopTest/TestScript/Test-5s_ramp_15A_temp.png
