cononinator/GeecPE2526/Code/TestCode/ClosedLoopTest/TestScript/Test-60s_ramp_15A_speed.png

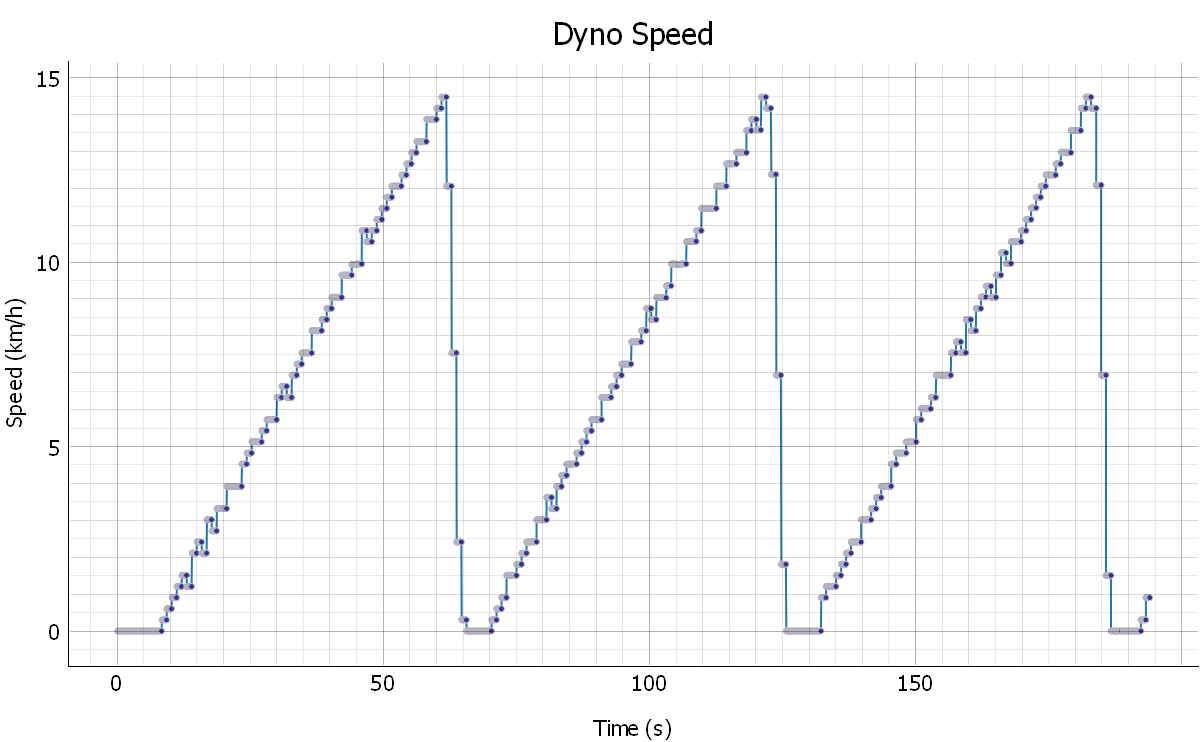
Code/TestCode/ClosedLoopTest/TestScript/Test-60s_ramp_15A_speed.png
