cononinator/GeecPE2526/Code/TestCode/ClosedLoopTest/TestScript/torque_all_ramps.png

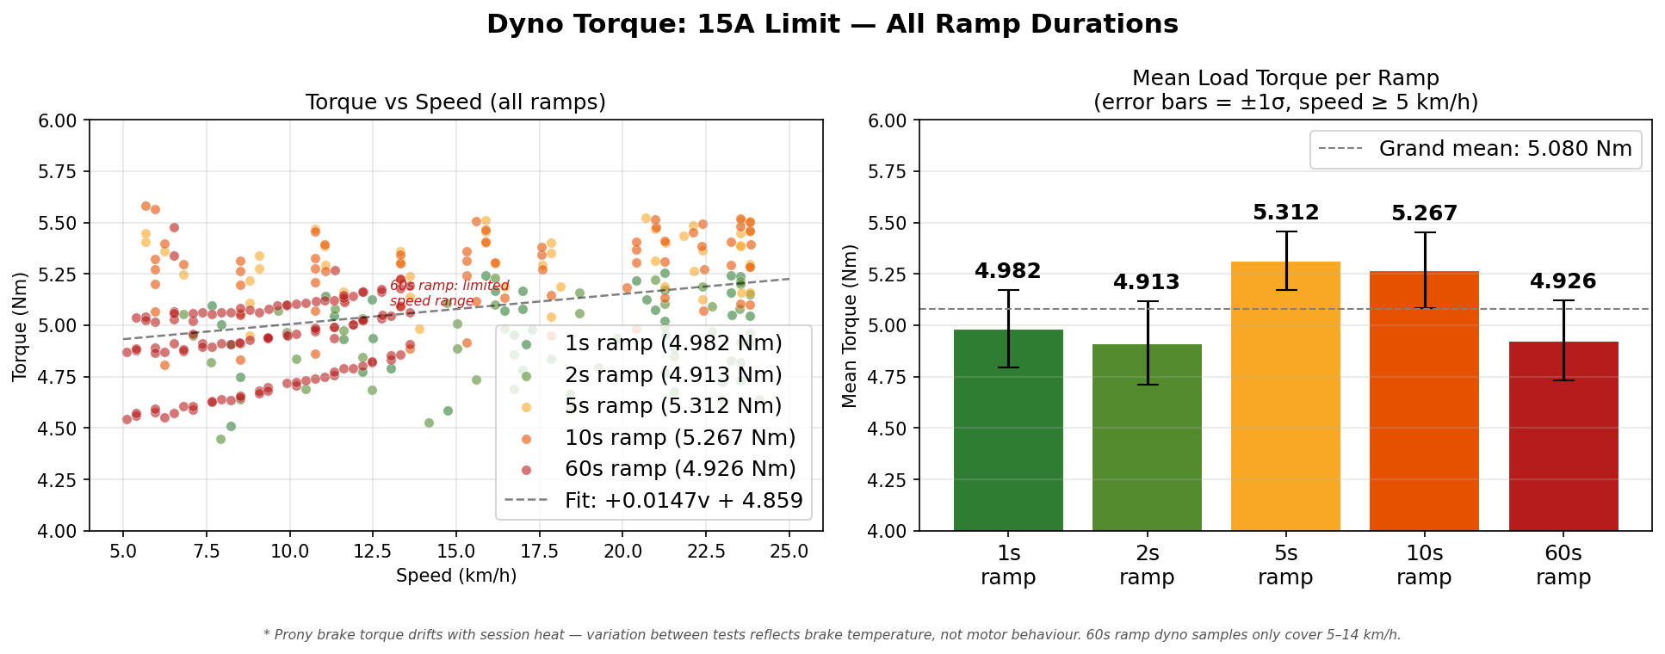
Code/TestCode/ClosedLoopTest/TestScript/torque_all_ramps.png
