cononinator/GeecPE2526/Code/TestCode/ClosedLoopTest/TestScript/torque_comparison.png

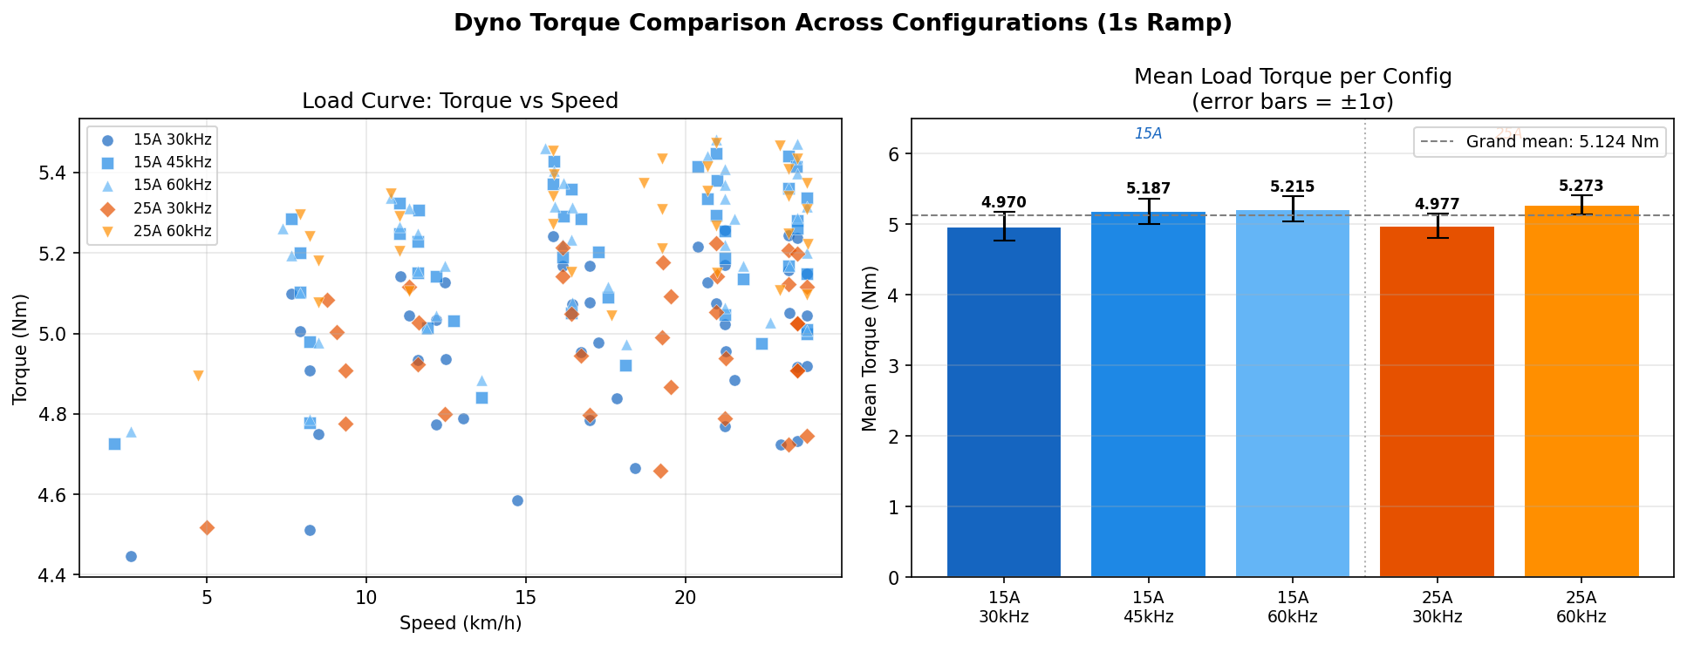
Code/TestCode/ClosedLoopTest/TestScript/torque_comparison.png
