cononinator/GeecPE2526/Code/TestCode/DutyCycleSweep/duty_sweep_results_20260226-102921_elec_power.png

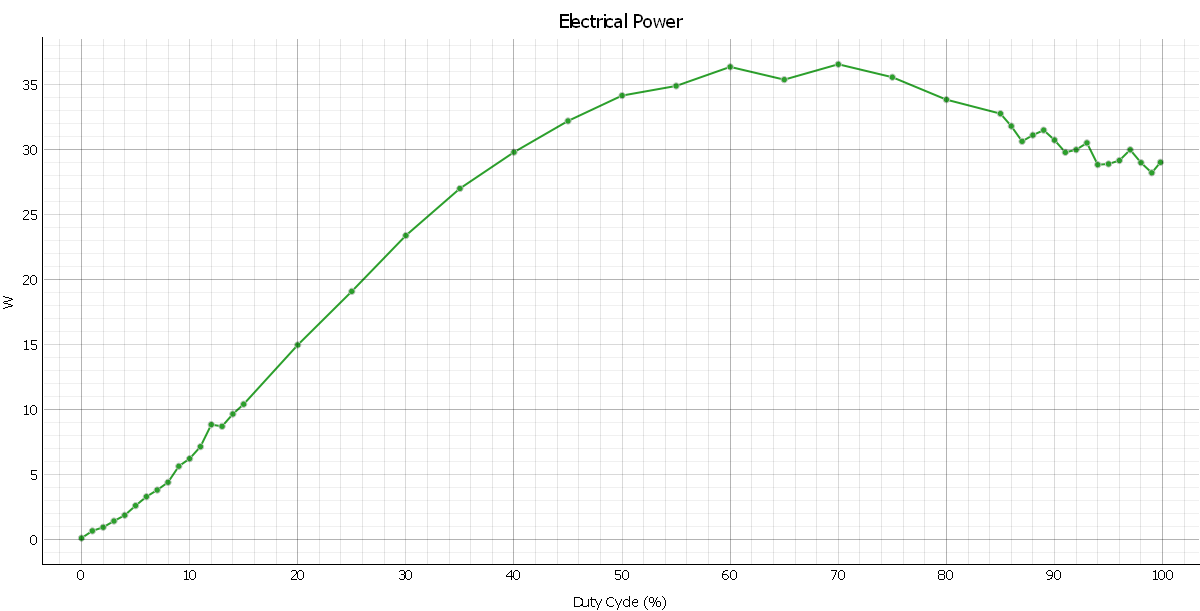
Code/TestCode/DutyCycleSweep/duty_sweep_results_20260226-102921_elec_power.png
