cononinator/GeecPE2526/Code/TestCode/DutyCycleSweep/results/duty_sweep_results_20260226-113415_bus_voltage.png

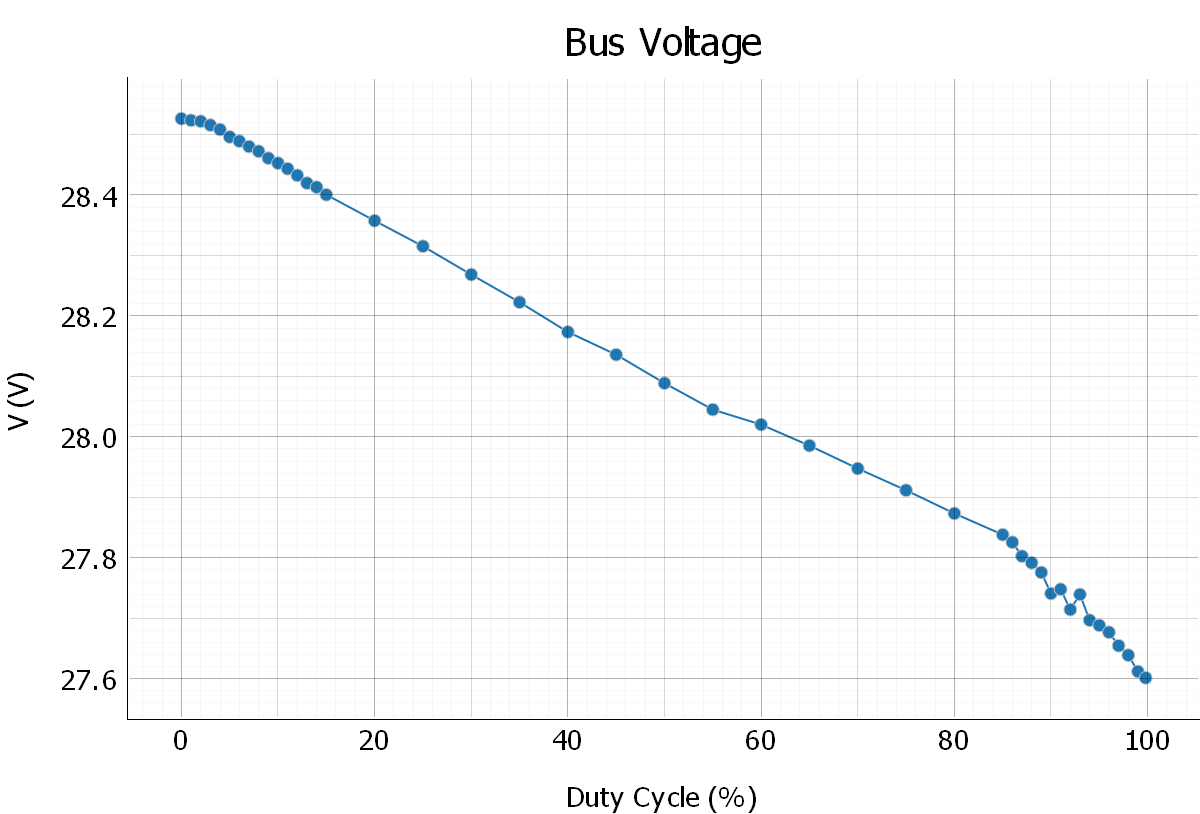
Code/TestCode/DutyCycleSweep/results/duty_sweep_results_20260226-113415_bus_voltage.png
