cononinator/GeecPE2526/Code/TestCode/DutyCycleSweep/results/duty_sweep_results_20260226-115720_bus_voltage.png

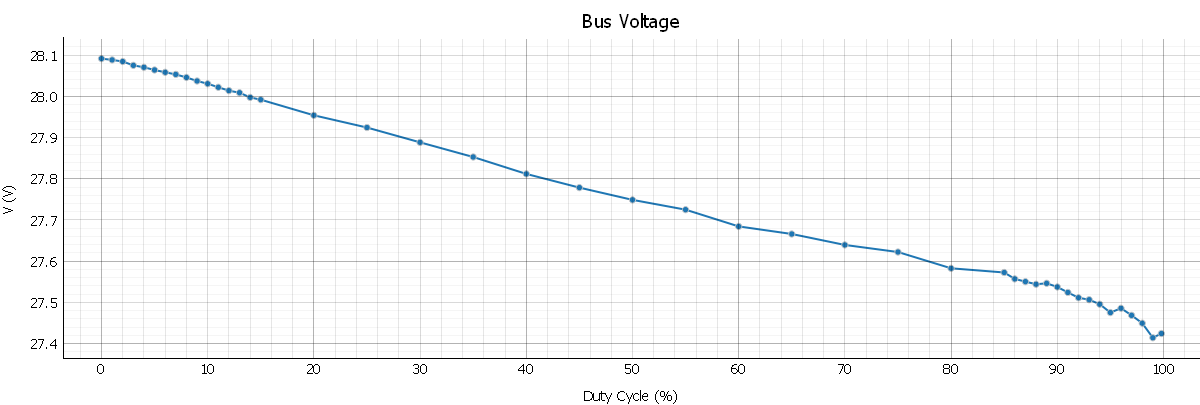
Code/TestCode/DutyCycleSweep/results/duty_sweep_results_20260226-115720_bus_voltage.png
