cononinator/GeecPE2526/Code/TestCode/DutyCycleSweep/results/duty_sweep_results_20260226-123738_ina_current.png

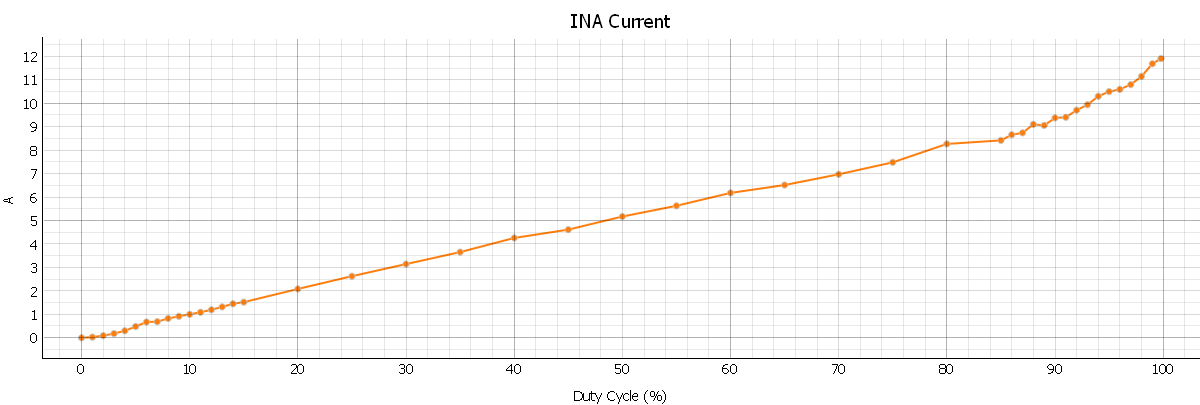
Code/TestCode/DutyCycleSweep/results/duty_sweep_results_20260226-123738_ina_current.png
