cononinator/GeecPE2526/Code/TestCode/DutyCycleSweep/results/duty_sweep_results_20260226-131941_ina_current.png

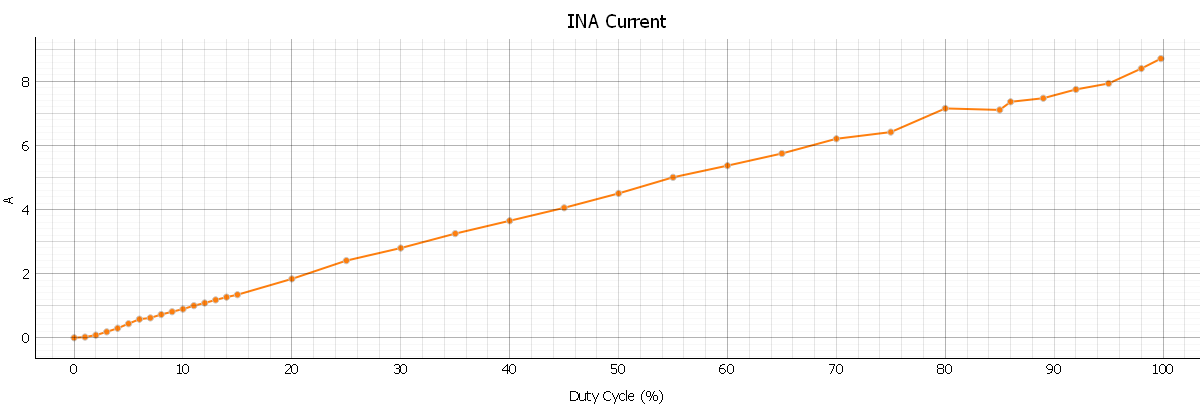
Code/TestCode/DutyCycleSweep/results/duty_sweep_results_20260226-131941_ina_current.png
