cononinator/GeecPE2526/Code/TestCode/DutyCycleSweep/results/duty_sweep_results_20260226-132654_torque.png

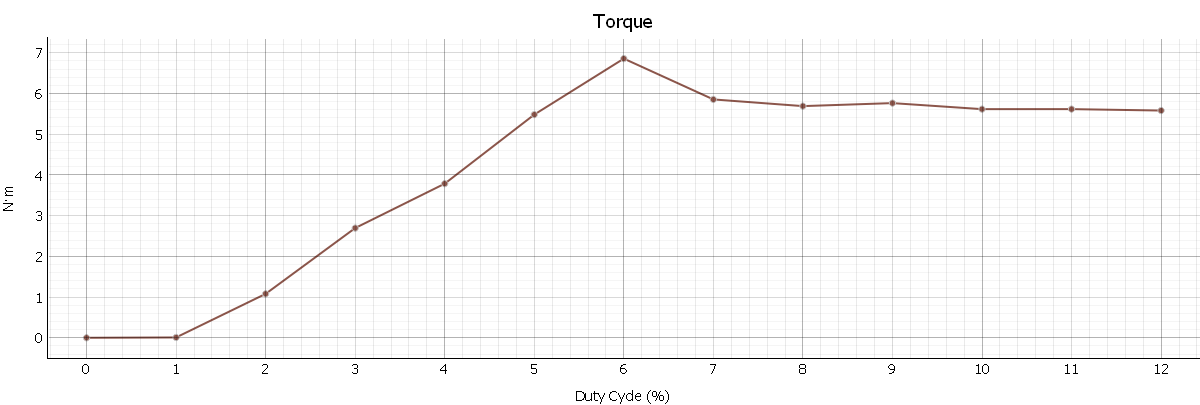
Code/TestCode/DutyCycleSweep/results/duty_sweep_results_20260226-132654_torque.png
