cononinator/GeecPE2526/Code/TestCode/Investigation/Efficiency.png

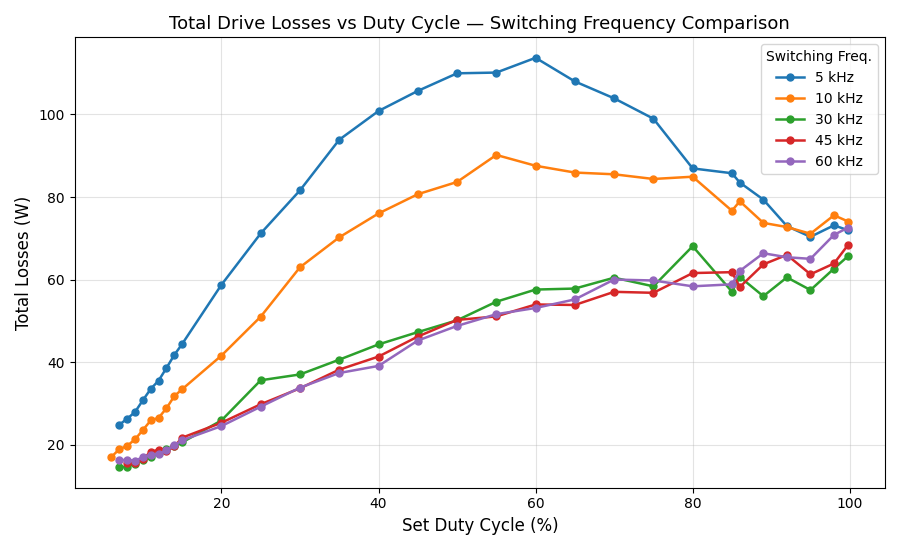
Code/TestCode/Investigation/Efficiency.png
