cononinator/GeecPE2526/Code/TestCode/Investigation/effvsShafgtSpeed.png

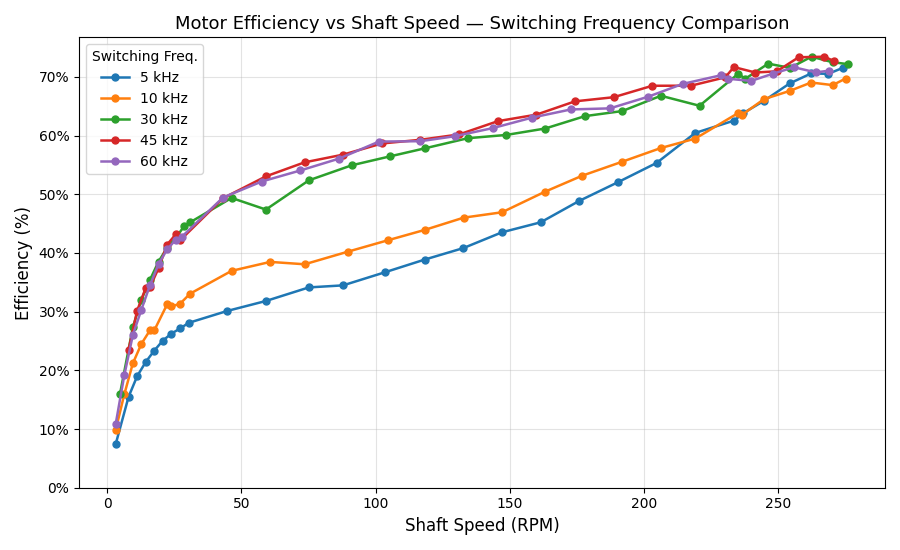
Code/TestCode/Investigation/effvsShafgtSpeed.png
