cononinator/GeecPE2526/Code/TestCode/Investigation/Figure_1.png

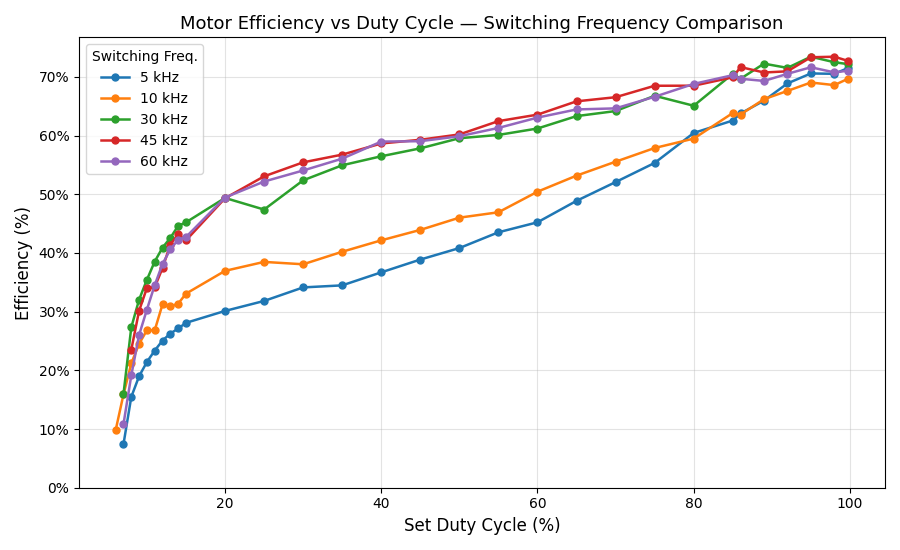
Code/TestCode/Investigation/Figure_1.png
