cononinator/GeecPE2526/Code/TestCode/Investigation/TorqueandCurrent.png

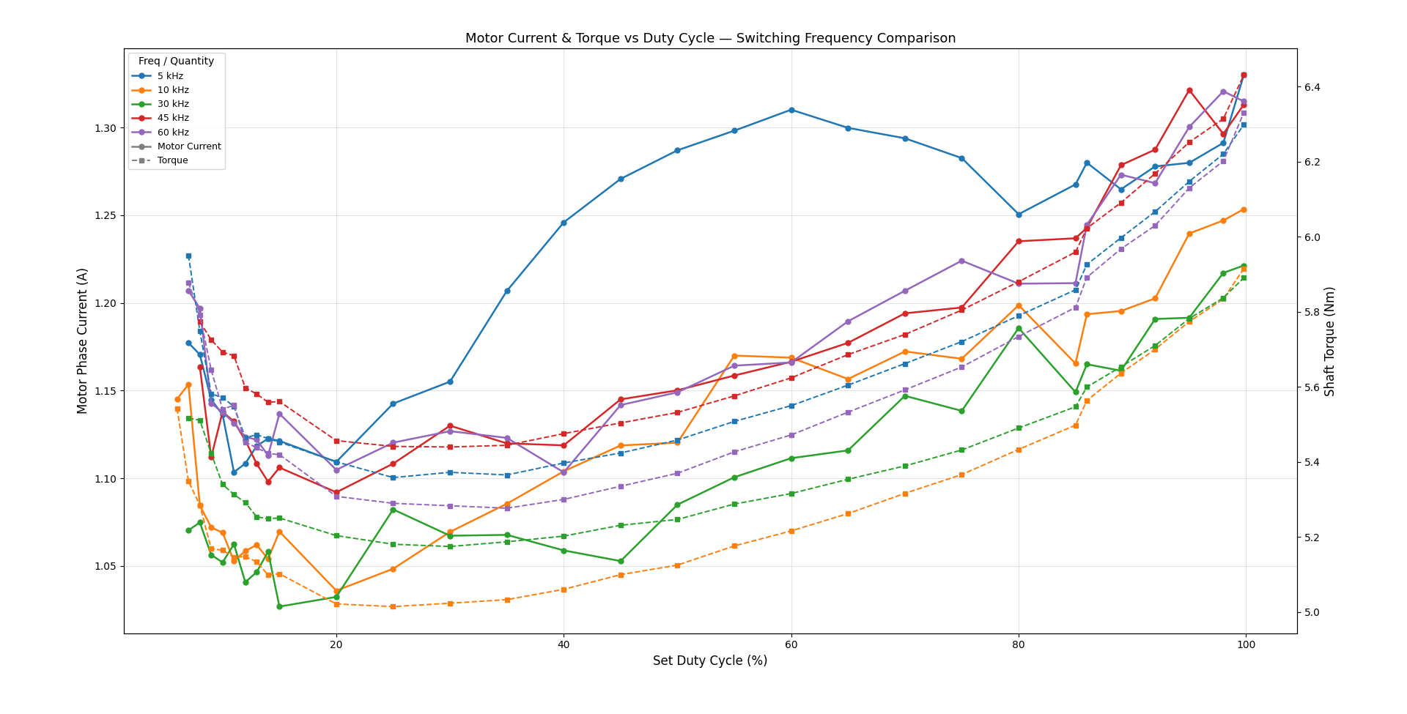
Code/TestCode/Investigation/TorqueandCurrent.png
