cononinator/GeecPE2526/Oscilliscope/ADuM3190 Test/scope_12.png

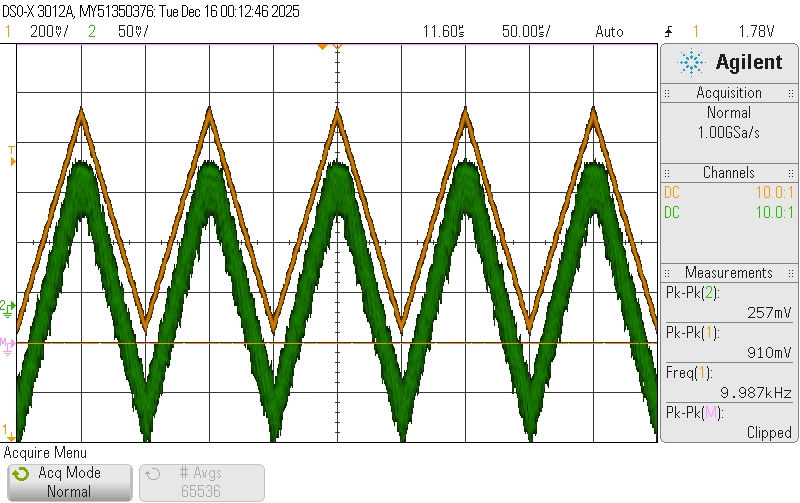
Oscilliscope/ADuM3190 Test/scope_12.png
