cononinator/GeecPE2526/Oscilliscope/DynoTest-20260226/PrtSc001.bmp

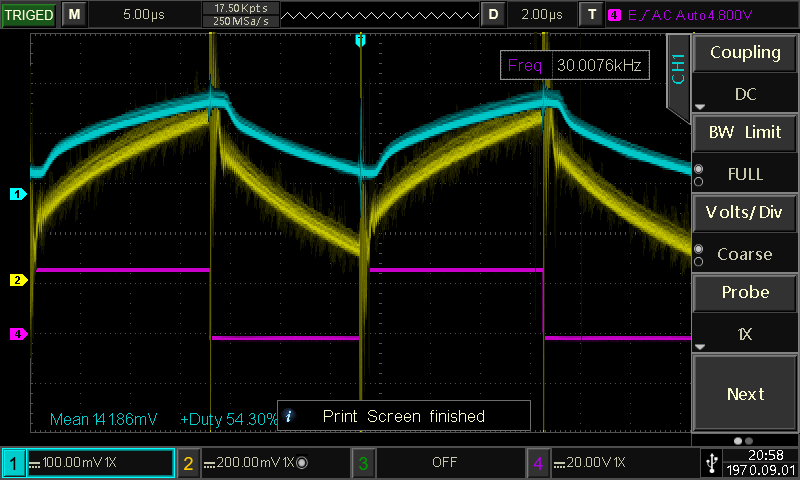
Oscilliscope/DynoTest-20260226/PrtSc001.bmp
