cononinator/GeecPE2526/Oscilliscope/DynoTest-20260226/PrtSc003.bmp

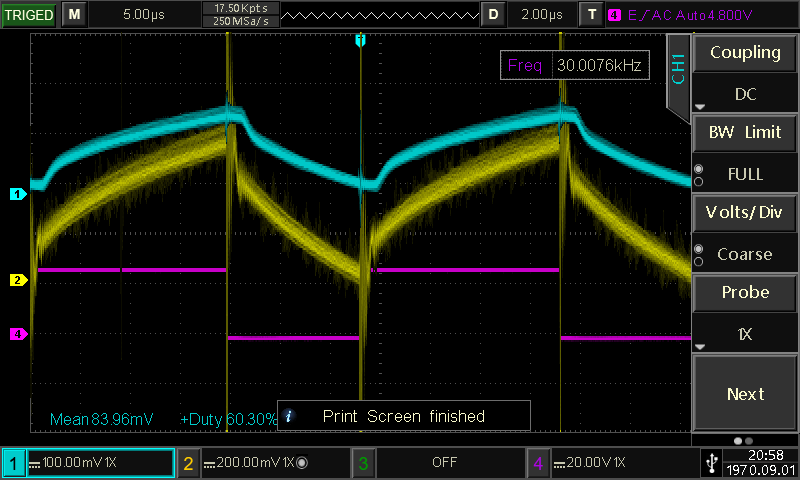
Oscilliscope/DynoTest-20260226/PrtSc003.bmp
