cononinator/GeecPE2526/Oscilliscope/DynoTest-20260226/PrtSc004.bmp

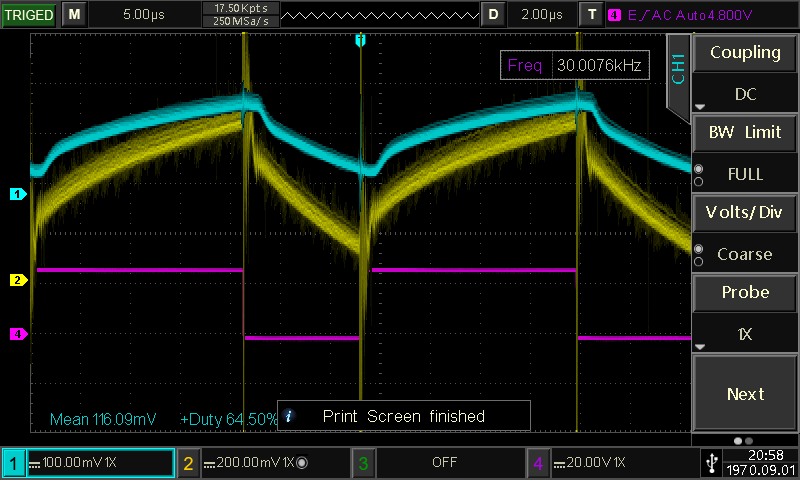
Oscilliscope/DynoTest-20260226/PrtSc004.bmp
