cononinator/GeecPE2526/Oscilliscope/DynoTest-20260226/PrtSc008.bmp

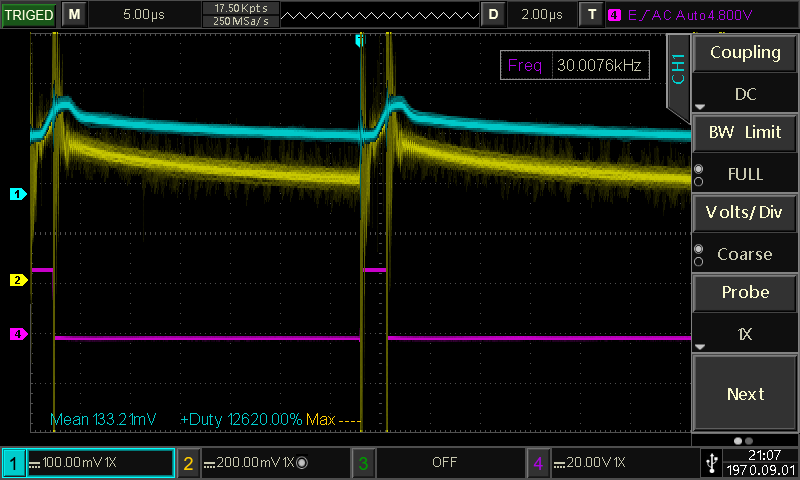
Oscilliscope/DynoTest-20260226/PrtSc008.bmp
