cononinator/GeecPE2526/Oscilliscope/DynoTest-20260226/PrtSc015.bmp

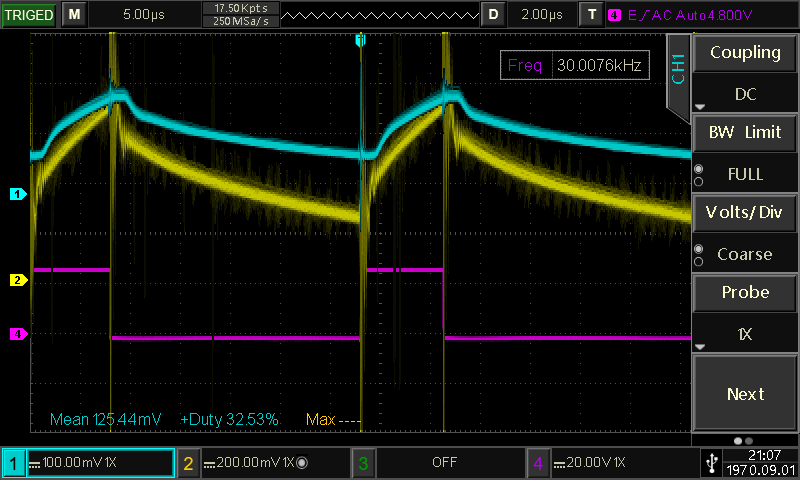
Oscilliscope/DynoTest-20260226/PrtSc015.bmp
