cononinator/GeecPE2526/Oscilliscope/DynoTest-20260226/PrtSc017.bmp

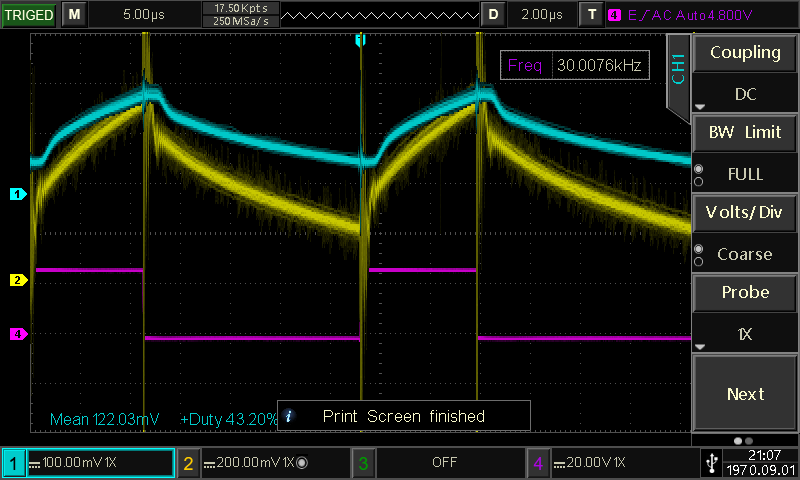
Oscilliscope/DynoTest-20260226/PrtSc017.bmp
