cononinator/GeecPE2526/Oscilliscope/DynoTest-20260226/PrtSc019.bmp

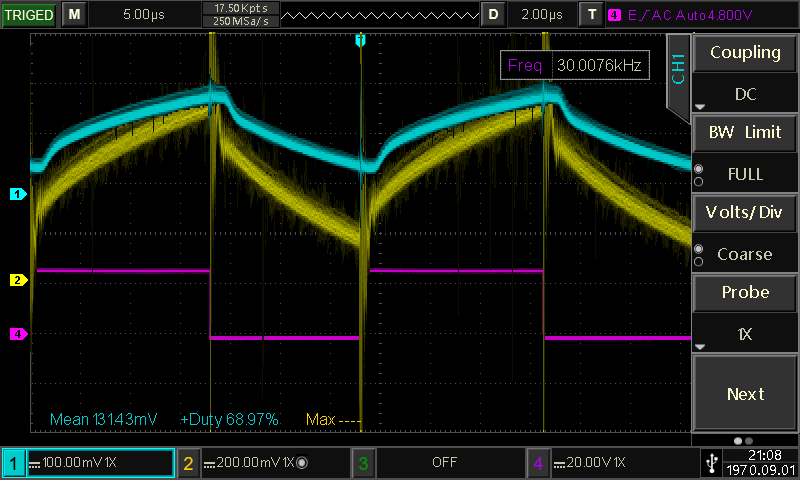
Oscilliscope/DynoTest-20260226/PrtSc019.bmp
