cononinator/GeecPE2526/Oscilliscope/DynoTest-20260226/PrtSc023.bmp

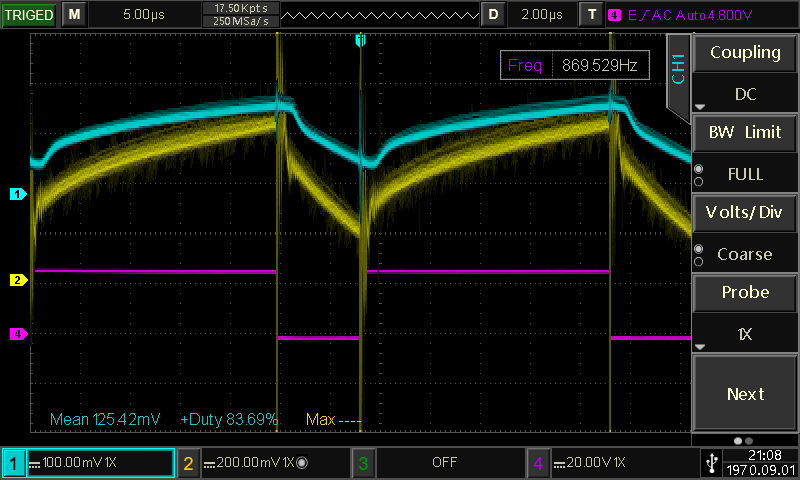
Oscilliscope/DynoTest-20260226/PrtSc023.bmp
