cononinator/GeecPE2526/Oscilliscope/DynoTest-20260226/PrtSc024.bmp

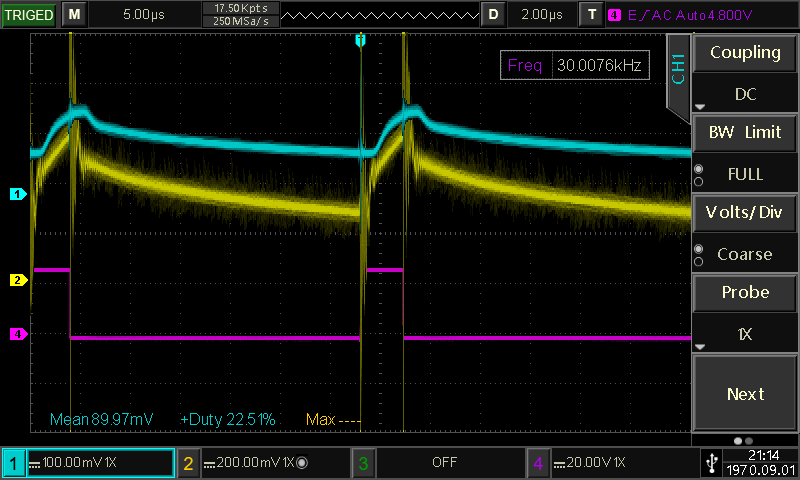
Oscilliscope/DynoTest-20260226/PrtSc024.bmp
