cononinator/GeecPE2526/Oscilliscope/DynoTest-20260226/PrtSc025.bmp

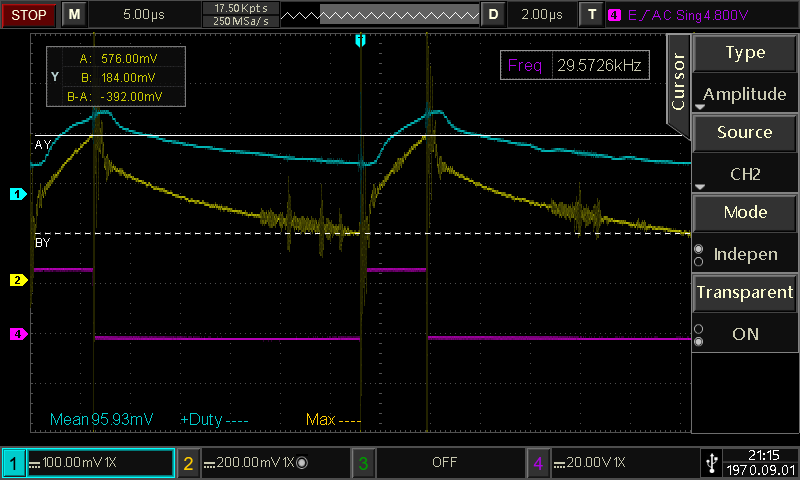
Oscilliscope/DynoTest-20260226/PrtSc025.bmp
