cononinator/GeecPE2526/Oscilliscope/DynoTest-20260226/PrtSc027.bmp

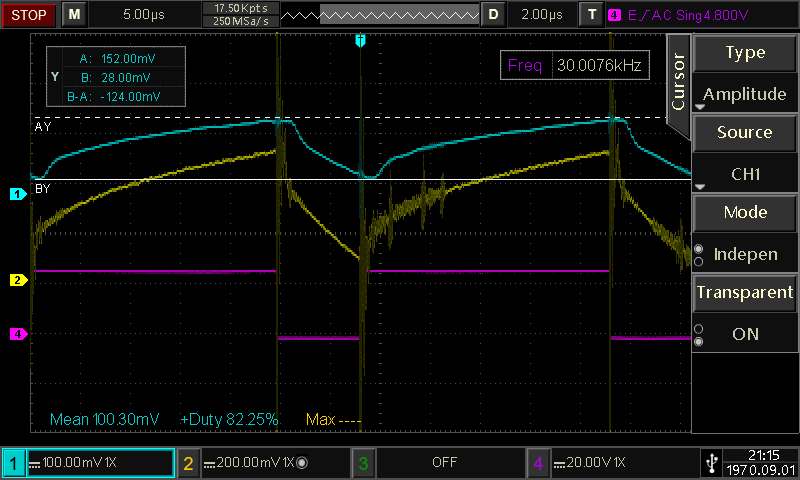
Oscilliscope/DynoTest-20260226/PrtSc027.bmp
