cononinator/GeecPE2526/Oscilliscope/DynoTest-20260226/PrtSc033.bmp

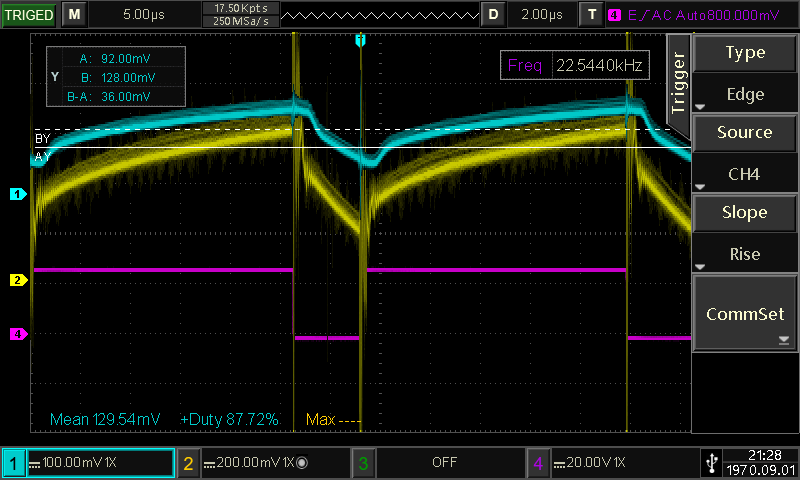
Oscilliscope/DynoTest-20260226/PrtSc033.bmp
