cononinator/GeecPE2526/Oscilliscope/DynoTest-20260226/PrtSc035.bmp

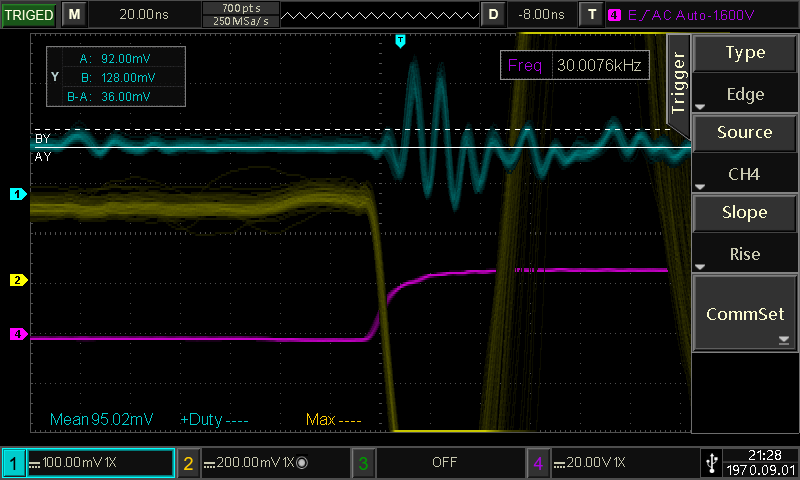
Oscilliscope/DynoTest-20260226/PrtSc035.bmp
