cononinator/GeecPE2526/Oscilliscope/DynoTest-20260226/PrtSc049.bmp

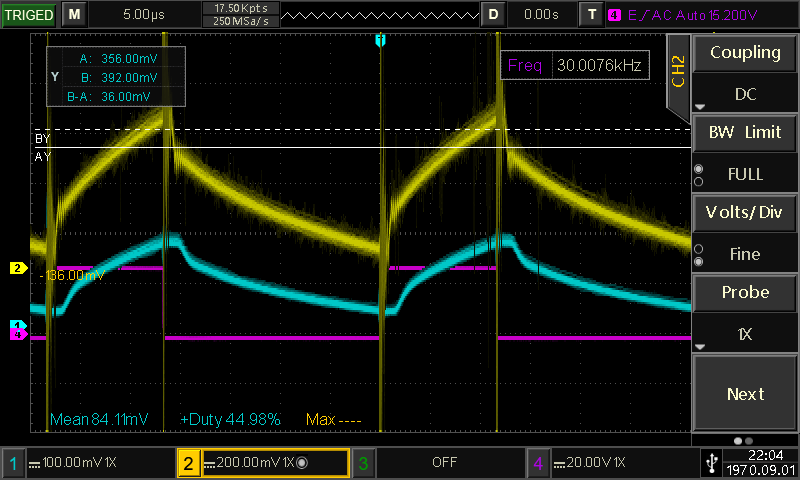
Oscilliscope/DynoTest-20260226/PrtSc049.bmp
