cononinator/GeecPE2526/Oscilliscope/DynoTest-20260226/PrtSc057.bmp

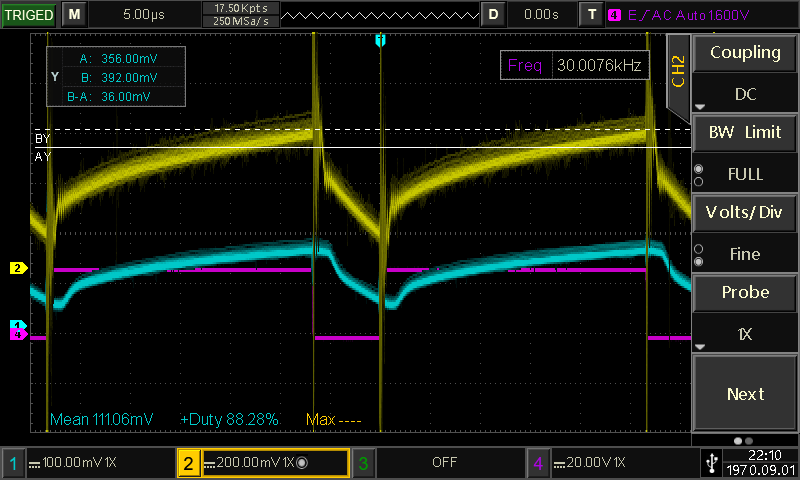
Oscilliscope/DynoTest-20260226/PrtSc057.bmp
