cononinator/GeecPE2526/Oscilliscope/DynoTest-20260226/PrtSc063.bmp

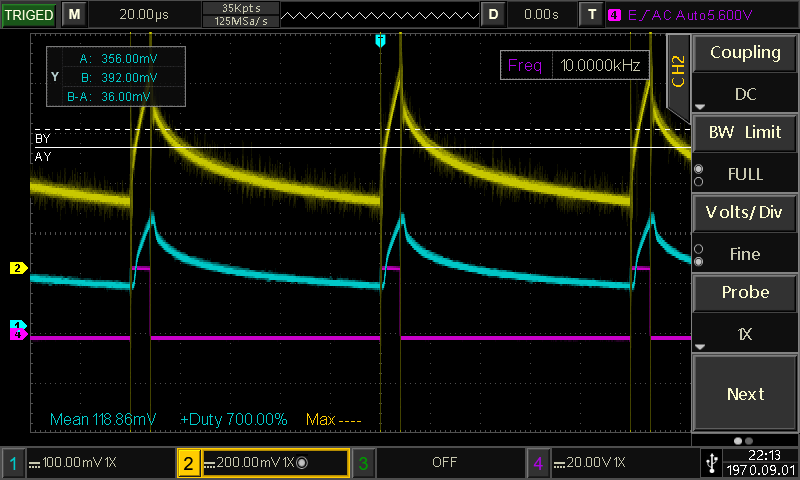
Oscilliscope/DynoTest-20260226/PrtSc063.bmp
