cononinator/GeecPE2526/Oscilliscope/DynoTest-20260226/PrtSc070.bmp

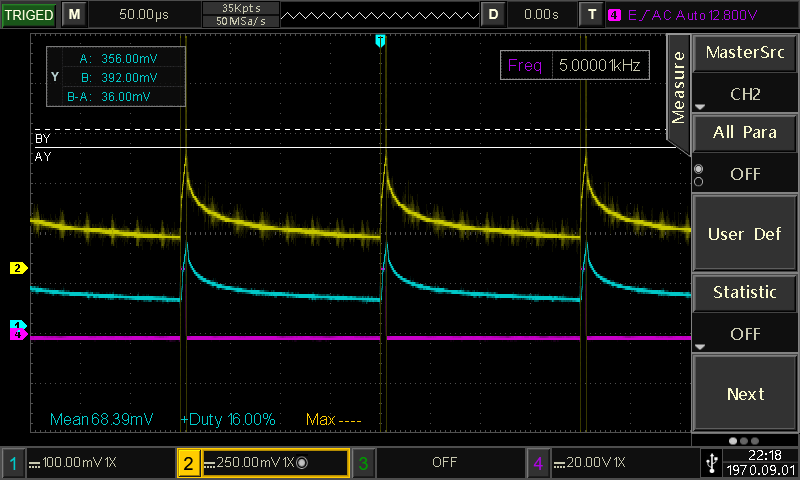
Oscilliscope/DynoTest-20260226/PrtSc070.bmp
