cononinator/GeecPE2526/Oscilliscope/DynoTest-20260226/PrtSc071.bmp

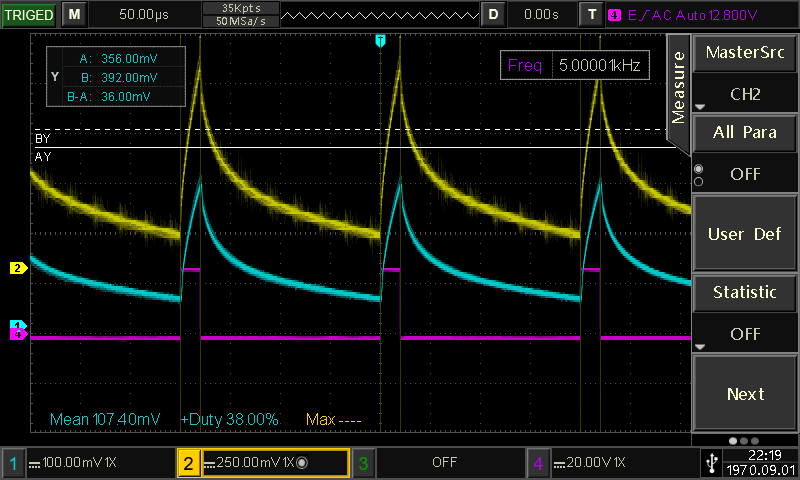
Oscilliscope/DynoTest-20260226/PrtSc071.bmp
