cononinator/GeecPE2526/Oscilliscope/DynoTest-20260226/PrtSc075.bmp

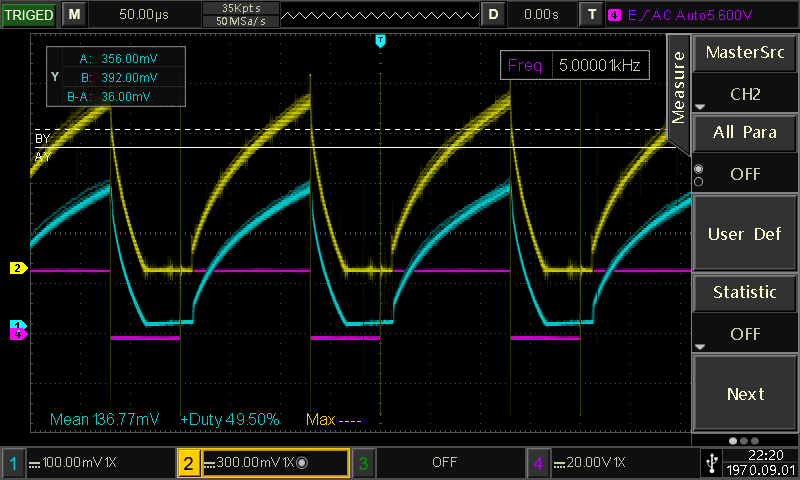
Oscilliscope/DynoTest-20260226/PrtSc075.bmp
