cononinator/GeecPE2526/Oscilliscope/DynoTest-20260226/PrtSc086.bmp

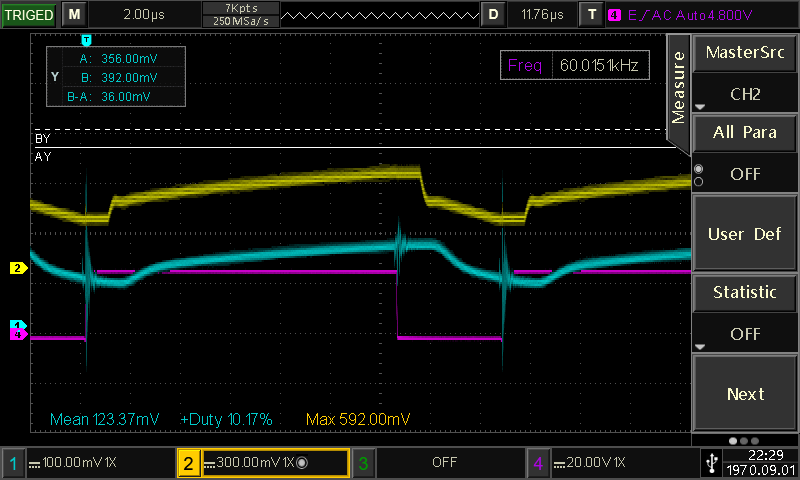
Oscilliscope/DynoTest-20260226/PrtSc086.bmp
