cononinator/GeecPE2526/Oscilliscope/DynoTest-20260226/PrtSc087.bmp

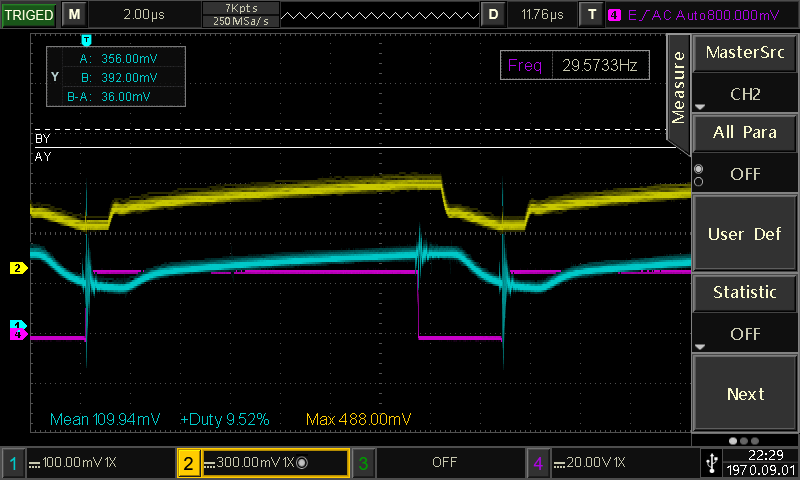
Oscilliscope/DynoTest-20260226/PrtSc087.bmp
