cononinator/GeecPE2526/Oscilliscope/DynoTest-20260226/PrtSc089.bmp

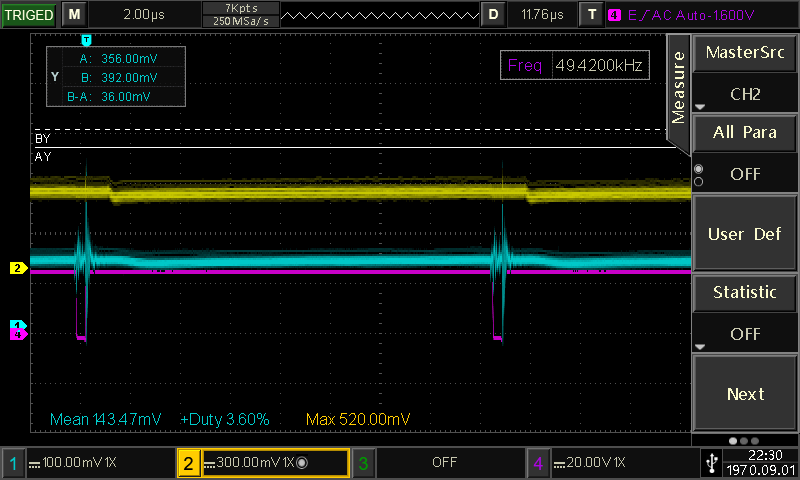
Oscilliscope/DynoTest-20260226/PrtSc089.bmp
