cononinator/GeecPE2526/Simulation/1EDN7116U/Model/results/demo_testbench.png

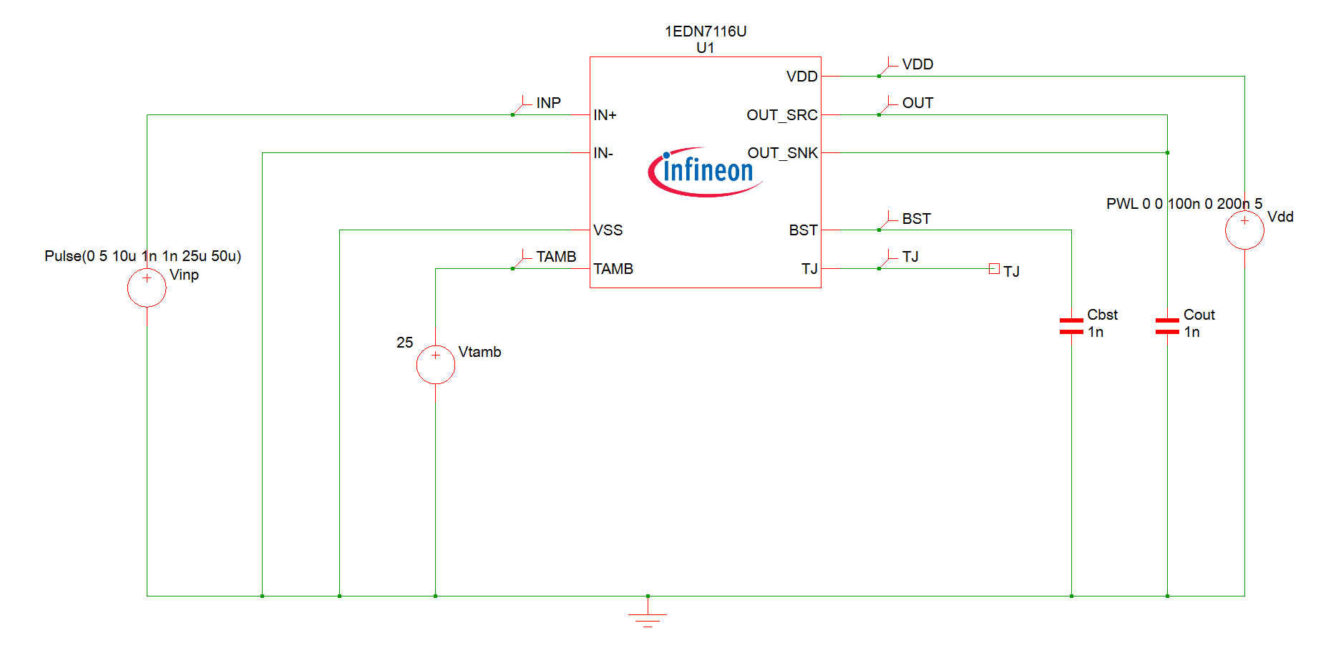
Simulation/1EDN7116U/Model/results/demo_testbench.png
