cononinator/GeecPE2526/Simulation/1EDN7116U/Model/results/waveforms.png

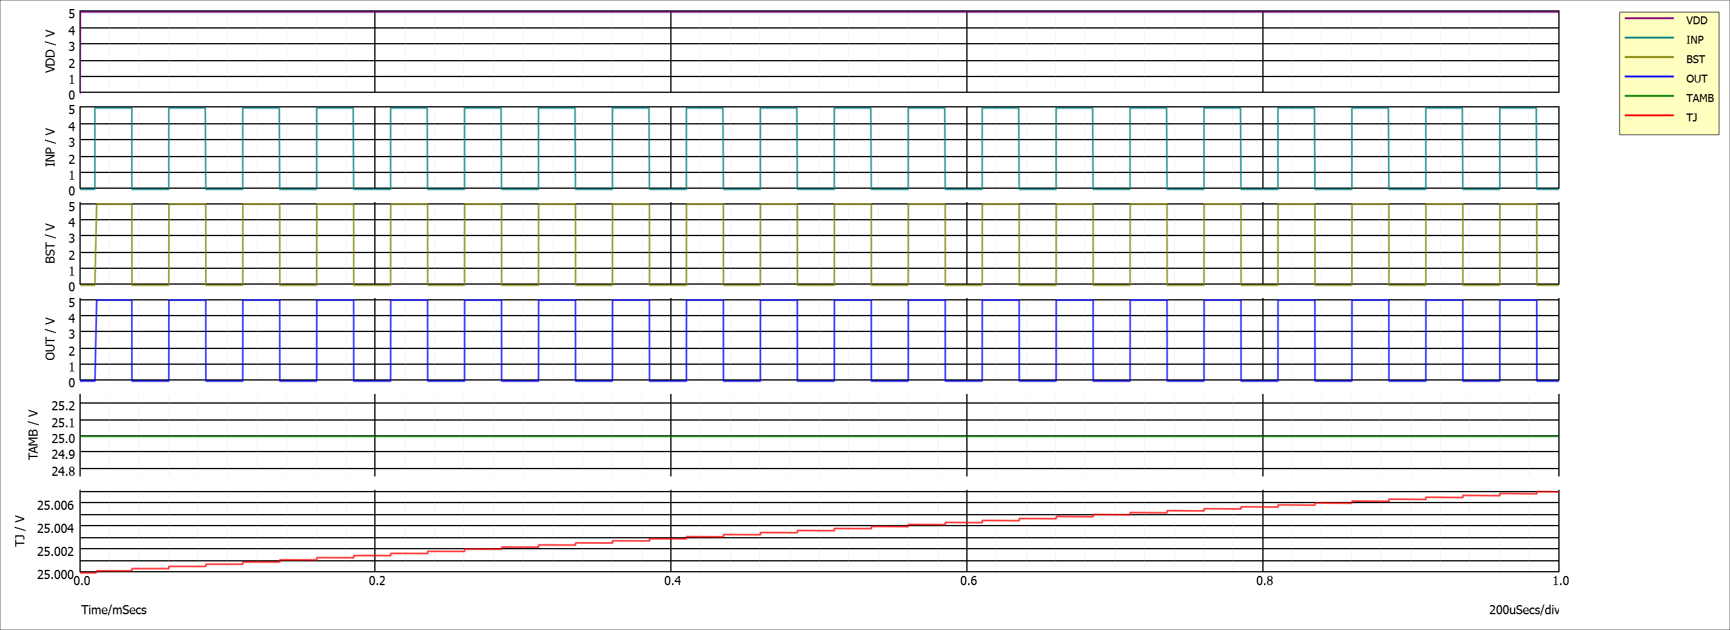
Simulation/1EDN7116U/Model/results/waveforms.png
