cononinator/GeecPE2526/Simulation/Half-bridge Print.pdf

# out Vin

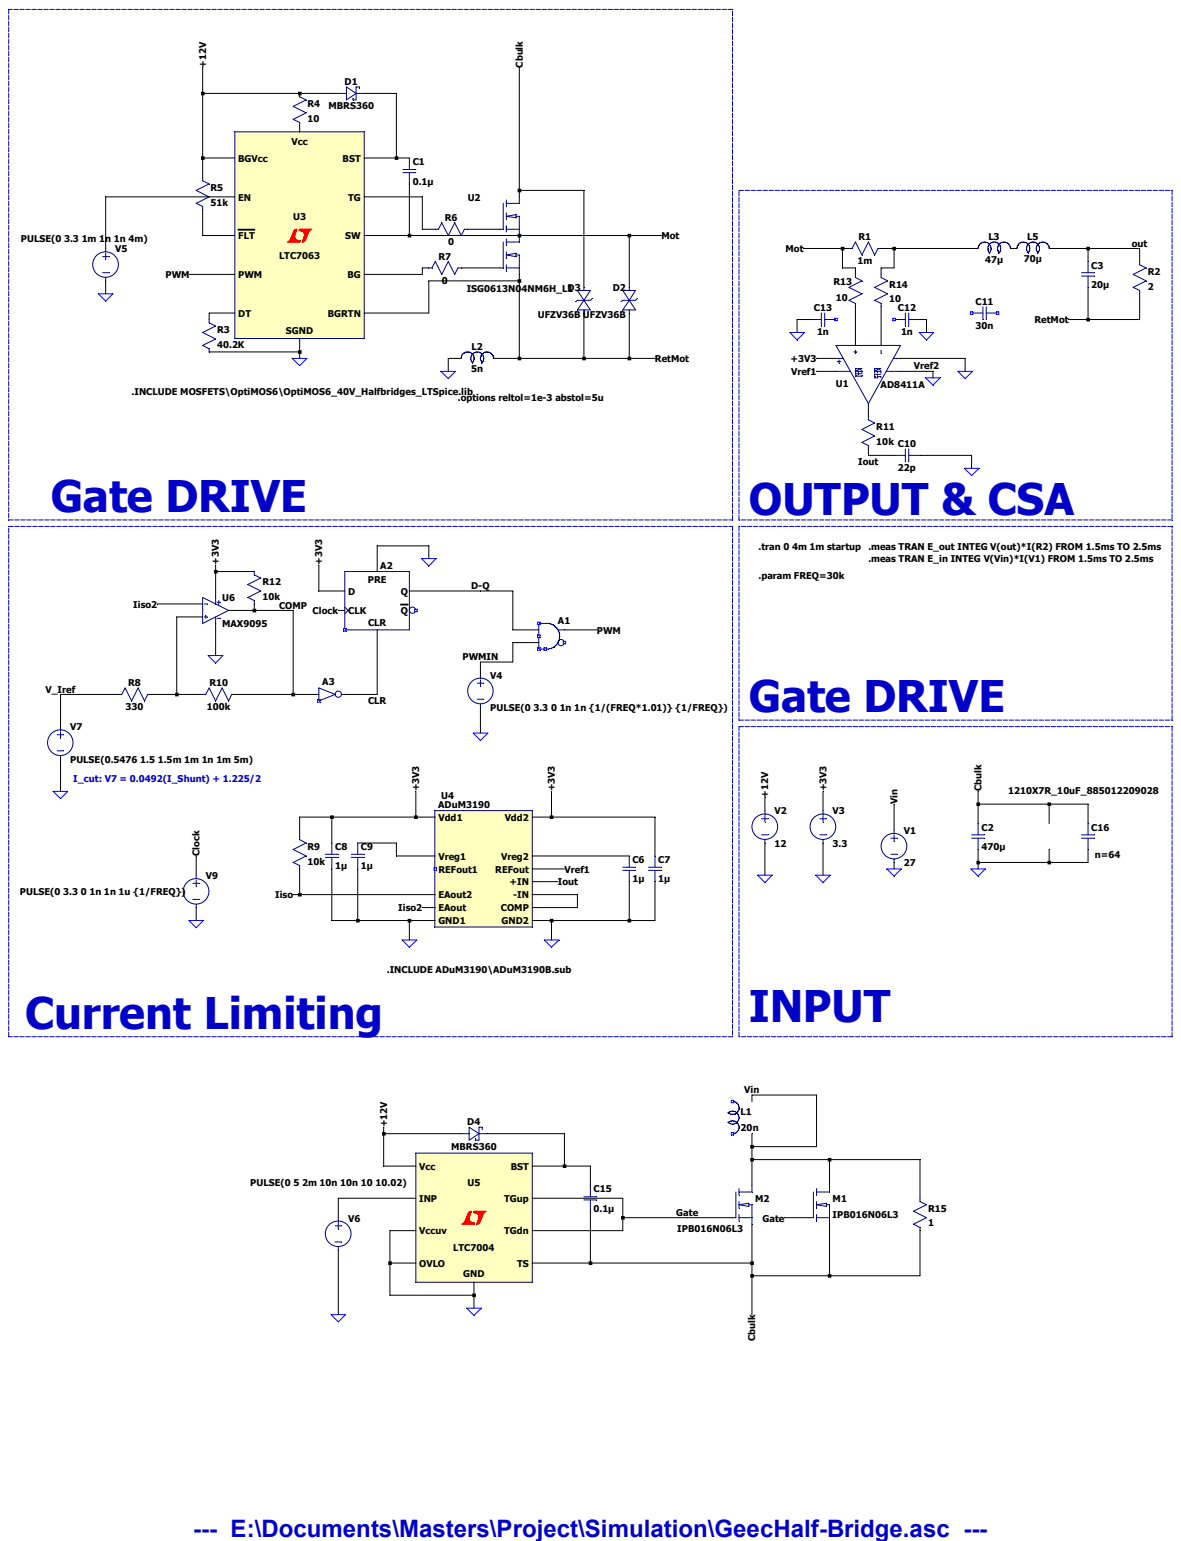
[picture p376: page 1]

.INCLUDE MOSFETS\OptiMOS6\OptiMOS6_40V_Halfbridges_LTSpice.lib .options reltol=1e-3 abstol=5u

.meas TRAN E_out INTEG V(out)*I(R2) FROM 1.5ms TO 2.5ms
.meas TRAN E_in INTEG V(Vin)*I(V1) FROM 1.5ms TO 2.5ms

--- E:\Documents\Masters\Project\Simulation\GeecHalf-Bridge.asc ---
