cononinator/GeecPE2526/Write Ups/PowerElectronics/12V-3V3_nonIso.pdf

## WEBENCH ® Design Report

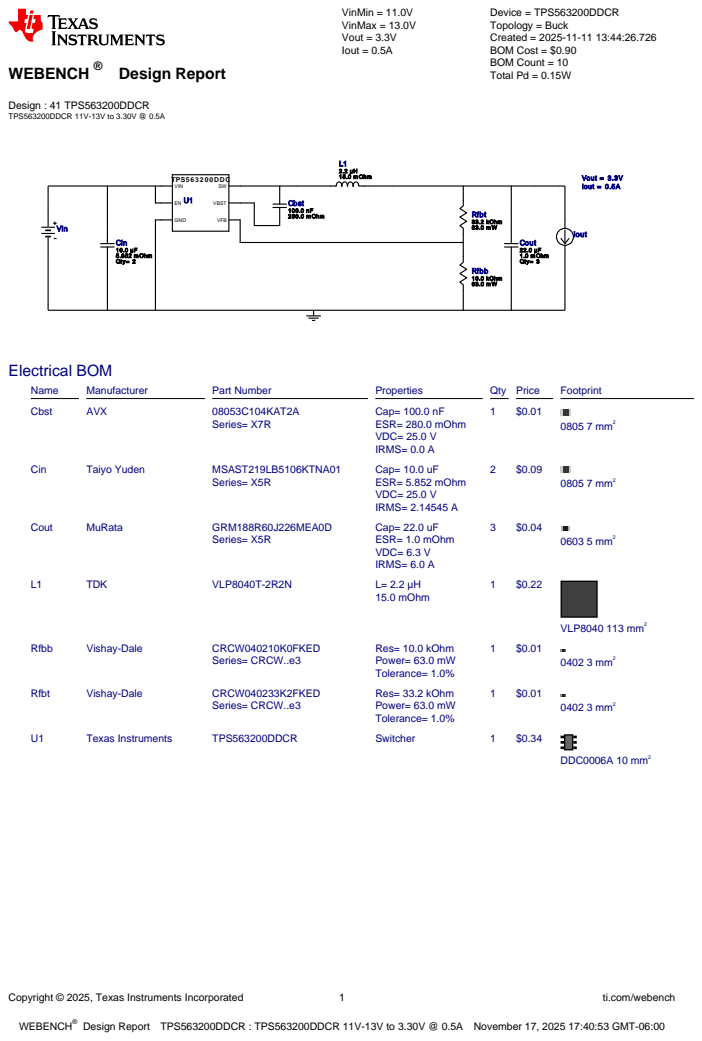
[picture p377: page 1]
Copyright © 2025, Texas Instruments Incorporated; ti.com/webench; WEBENCH®; Design : 41 TPS563200DDCR TPS563200DDCR 11V-13V to 3.30V @ 0.5A; VinMin = 11.0V VinMax = 13.0V Vout = 3.3V Iout = 0.5A; Device = TPS563200DDCR Topology = Buck Created = 2025-11-11 13:44:26.726 BOM Cost = $0.90 BOM Count = 10 Total Pd = 0.15W; Rfbt 33.2 kOhm 63.0 m W; Cout 22.0 µF 1.0 m Ohm Qty= 3; Vout = 3.3V Iout = 0.5A; L1 2.2 µH 15.0 m Ohm; Rfbb 10.0 kOhm 63.0 m W; Cin 10.0 µF 5.852 m Ohm Qty= 2; TPS5 6 3 2 0 0 DDC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

Design Report TPS563200DDCR : TPS563200DDCR 11V-13V to 3.30V @ 0.5A November 17, 2025 17:40:53 GMT-06:00

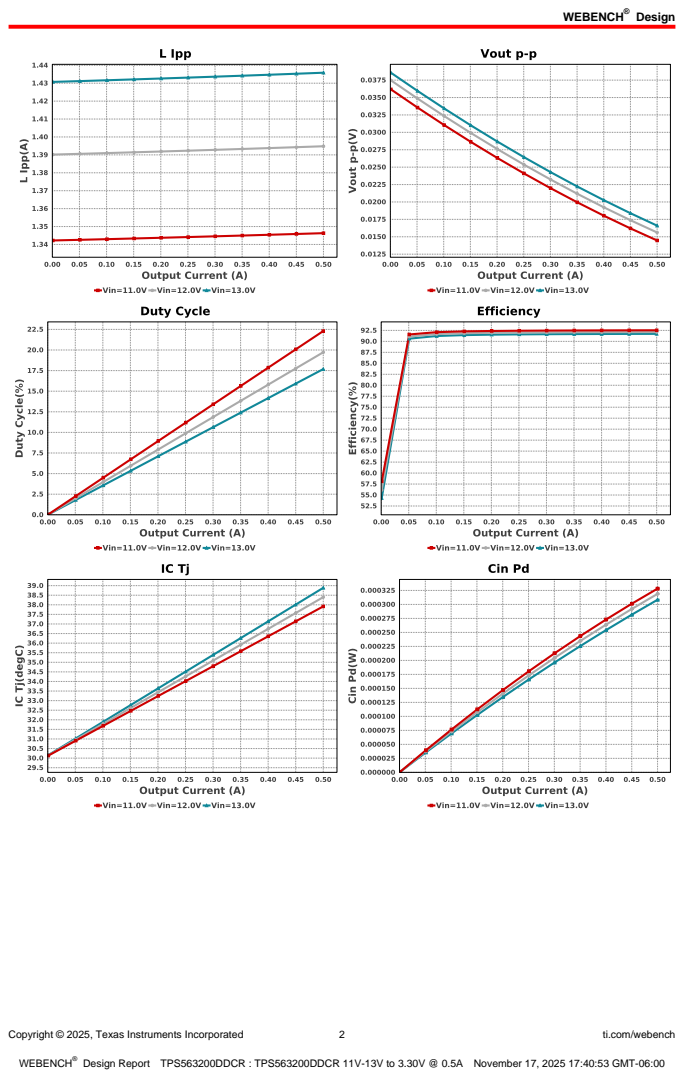
[picture p378: page 2]
Design; Copyright © 2025, Texas Instruments Incorporated; ti.com/webench

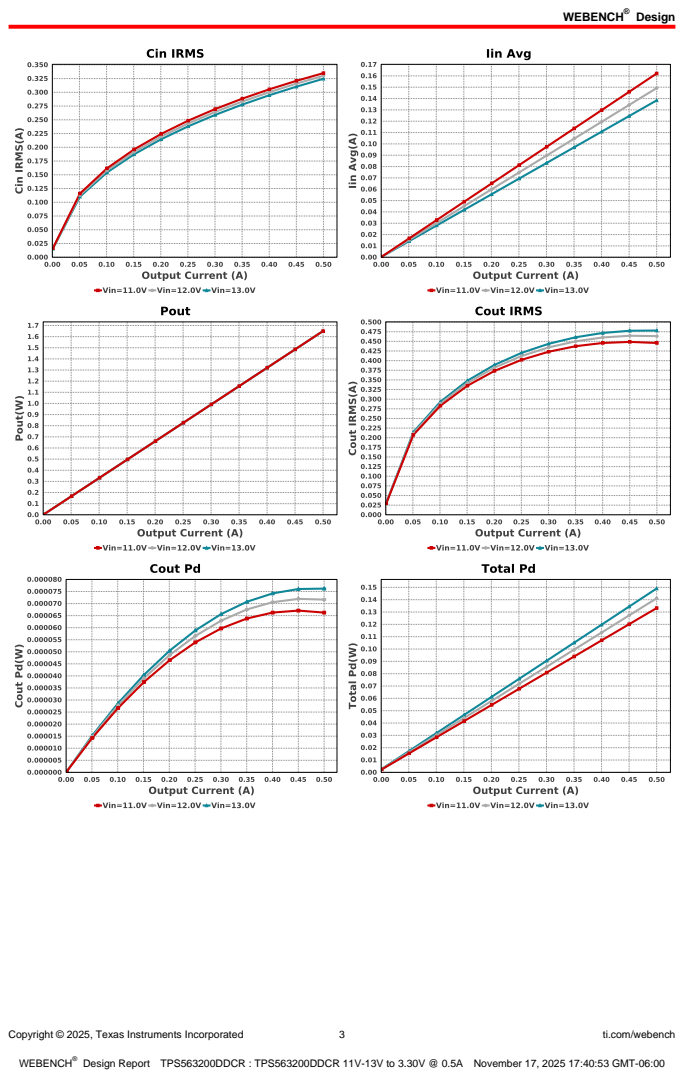
[picture p379: page 3]
Copyright © 2025, Texas Instruments Incorporated; ti.com/webench

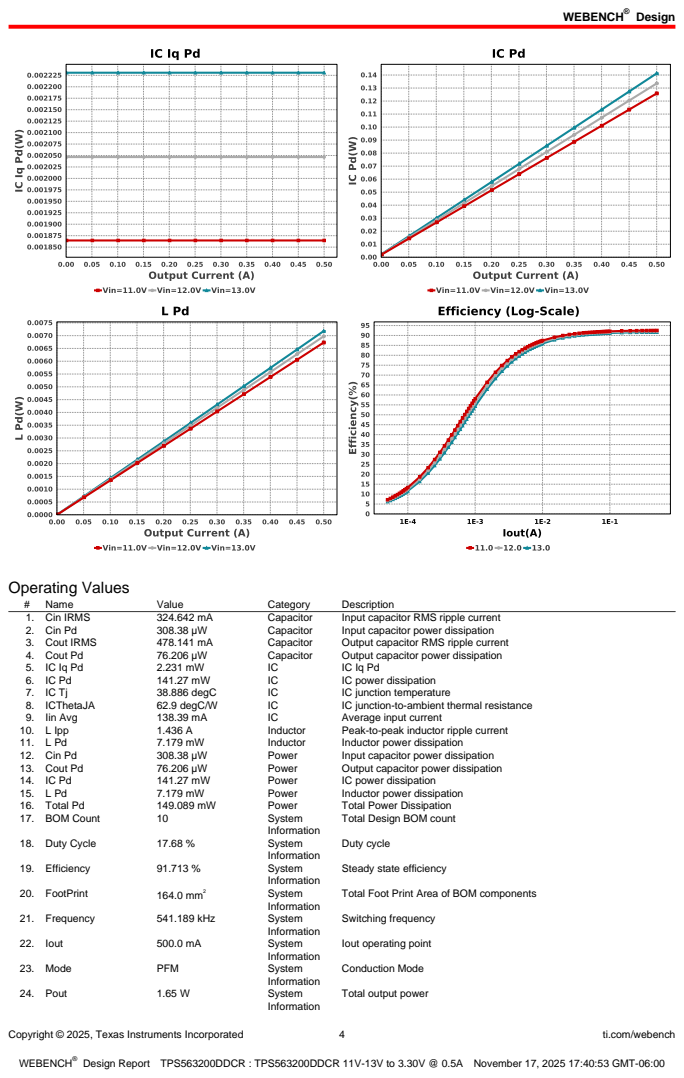
[picture p380: page 4]
Copyright © 2025, Texas Instruments Incorporated; ti.com/webench; Operating Values; Name; Value; Category; Description; 1. Cin IRMS; Capacitor; Input capacitor RMS ripple current; 2. Cin Pd; Input capacitor power dissipation; 3. Cout IRMS; Output capacitor RMS ripple current; 4. Cout Pd; Output capacitor power dissipation; IC power dissipation; 38.886 degC; IC junction temperature; 8. ICThetaJA; 62.9 degC/W; IC junction-to-ambient thermal resistance; 9. Iin Avg; Average input current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

Total Design BOM count

Steady state efficiency

Total Foot Print Area of BOM components

Iout operating point

Total output power

Copyright © 2025, Texas Instruments Incorporated | 5 | ti.com/webench
# | Name | Value | Category | Description

25. Total BOM | $0.9 | System
| | | Information | Total BOM Cost
26. Vin | 13.0 V | System
| | | Information | Vin operating point
27. Vout | 3.3 V | System
| | | Information | Operational Output Voltage
28. Vout Actual | 3.283 V | System
| | | Information | Vout Actual calculated based on selected voltage divider resistors
29. Vout Tolerance | 2.889 % | System
| | | Information | Vout Tolerance based on IC Tolerance (no load) and voltage divider resistors if applicable
30. Vout p-p | 16.595 mV | System
| | | Information | Peak-to-peak output ripple voltage

## Design Inputs

Name | Value | Description
| Iout | | 500.0 m | Maximum Output Current
VinMax | 13.0 | Maximum input voltage
VinMin | 11.0 | Minimum input voltage
VinTyp | 12.0 | Typical input voltage
Vout | 3.3 | Output Voltage
| base_pn | | TPS563200 | Base Product Number
source | DC | Input Source Type
Ta | 30.0 | Ambient temperature


Copyright © 2025, Texas Instruments Incorporated | 6 | ti.com/webench

## Assembly

## Component Testing

Some published data on components in datasheets such as Capacitor ESR and Inductor DC resistance is based on conservative values that will guarantee that the components always exceed the specification. For design purposes it is usually better to work with typical values. Since this data is not always available it is a good practice to measure the Capacitance and ESR values of Cin and Cout, and the inductance and DC resistance of L1 before assembly of the board. Any large discrepancies in values should be electrically simulated in WEBENCH to check for instabilities and thermally simulated in WebTHERM to make sure critical temperatures are not exceeded.

## Soldering Component to Board

If board assembly is done in house it is best to tack down one terminal of a component on the board then solder the other terminal. For surface mount parts with large tabs, such as the DPAK, the tab on the back of the package should be pre-tinned with solder, then tacked into place by one of the pins. To solder the tab town to the board place the iron down on the board while resting against the tab, heating both surfaces simultaneously. Apply light pressure to the top of the plastic case until the solder flows around the part and the part is flush with the PCB. If the solder is not flowing around the board you may need a higher wattage iron (generally 25W to 30W is enough).

## Initial Startup of Circuit

It is best to initially power up the board by setting the input supply voltage to the lowest operating input voltage 11.0V and set the input supply's current limit to zero. With the input supply off connect up the input supply to Vin and GND. Connect a digital volt meter and a load if needed to set the minimum Iout of the design from Vout and GND. Turn on the input supply and slowly turn up the current limit on the input supply.
If the voltage starts to rise on the input supply continue increasing the input supply current limit while watching the output voltage. If the current increases on the input supply, but the voltage remains near zero, then there may be a short or a component misplaced on the board. Power down the board and visually inspect for solder bridges and recheck the diode and capacitor polarities. Once the power supply circuit is operational then more extensive testing may include full load testing, transient load and line tests to compare with simulation results.

## Load Testing

The setup is the same as the initial startup, except that an additional digital voltmeter is connected between Vin and GND, a load is connected between Vout and GND and a current meter is connected in series between Vout and the load. The load must be able to handle at least rated output power + 50% ( 7.5 watts for this design). Ideally the load is supplied in the form of a variable load test unit. It can also be done in the form of suitably large power resistors. When using an oscilloscope to measure waveforms on the prototype board, the ground leads of the oscilloscope probes should be as short as possible and the area of the loop formed by the ground lead should be kept to a minimum. This will help reduce ground lead inductance and eliminate EMI noise that is not actually present in the circuit.

## Design Assistance

1. Master key : 5FFB4611713714A73A2F511ACDE4AFEF[v1]
2. TPS563200 Product Folder : http://www.ti.com/product/TPS563200 : contains the data sheet and other resources.

Copyright © 2025, Texas Instruments Incorporated | 7 | ti.com/webench

Important Notice and Disclaimer

TI provides technical and reliability data (including datasheets), design resources (including reference designs), application or other design advice, web tools, safety information, and other resources AS IS and with all faults, and disclaims all warranties. These resources are intended for skilled developers designing with TI products. You are solely responsible for (1) selecting the appropriate TI products for your application, (2) designing, validating and testing your application, and (3) ensuring your application meets applicable standards, and any other safety, security, or other requirements.

These resources are subject to change without notice. TI grants you permission to use these resources only for development of an application that uses the TI products described in the resource. Other reproduction and display of these resources is prohibited. No license is granted to any other TI intellectual property right or to any third party intellectual property right. TI disclaims responsibility for, and you will fully indemnify TI and its representatives against, any claims, damages, costs, losses, and liabilities arising out of your use of these resources.

Providing these resources does not expand or otherwise alter TI's applicable Terms of Sale or other applicable terms available either on ti.com or provided in conjunction with TI products.
