cononinator/GeecPE2526/Write Ups/PowerElectronics/GeecBuck.pdf

## WEBENCH ® Design Report

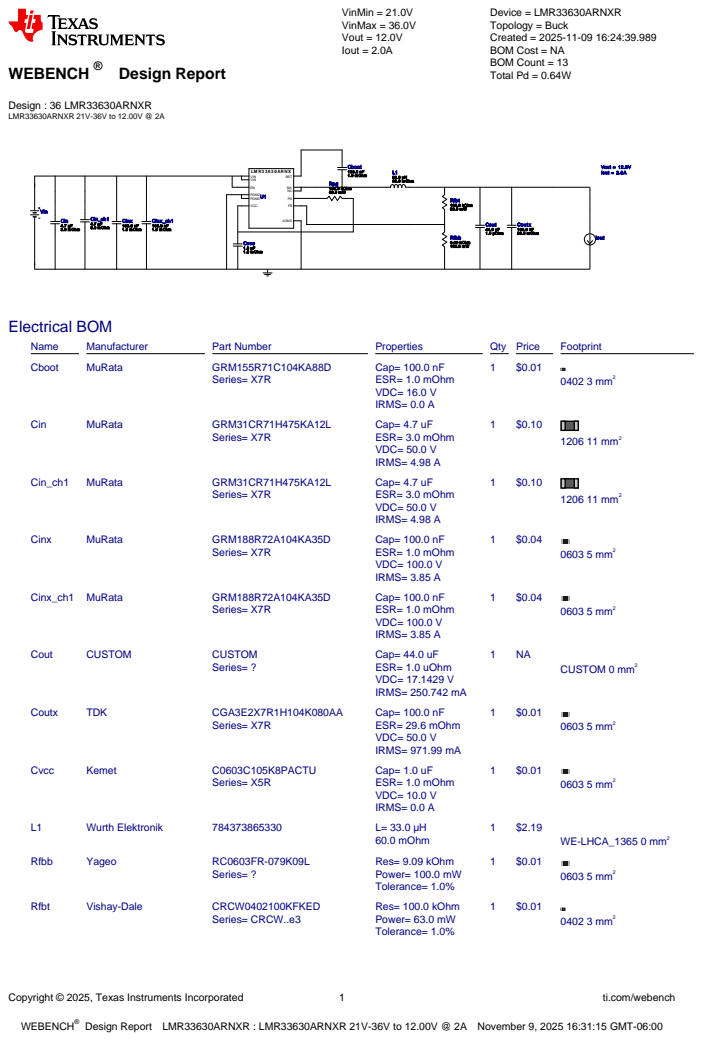
[picture p396: page 1]
Copyright © 2025, Texas Instruments Incorporated; ti.com/webench; WEBENCH®; Design : 36 LMR33630ARNXR LMR33630ARNXR 21V-36V to 12.00V @ 2A; VinMin = 21.0V VinMax = 36.0V Vout = 12.0V Iout = 2.0A; Vout = 12.0V Iout = 2.0A; Cinx 100.0 nF 1.0 m Ohm; LM R3 3 6 3 0 ARNX; PGND; VIN; BST; VCC; AGND; Cin_ch1 4.7 µF 3.0 m Ohm; L1 33.0 µH 60.0 m Ohm; Cinx_ch1 100.0 nF; 1.0 m Ohm; Cout 44.0 µF; 1.0 µOhm; Coutx 100.0 nF 29.6 m Ohm; Cboot 100.0 nF; Cin 4.7 µF 3.0 m Ohm; Rpg 100.0 kOhm 63.0 m W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

Device = LMR33630ARNXR
Topology = Buck
Created = 2025-11-09 16:24:39.989
BOM Cost = NA
BOM Count = 13
Total Pd = 0.64W

Design Report LMR33630ARNXR : LMR33630ARNXR 21V-36V to 12.00V @ 2A November 9, 2025 16:31:15 GMT-06:00

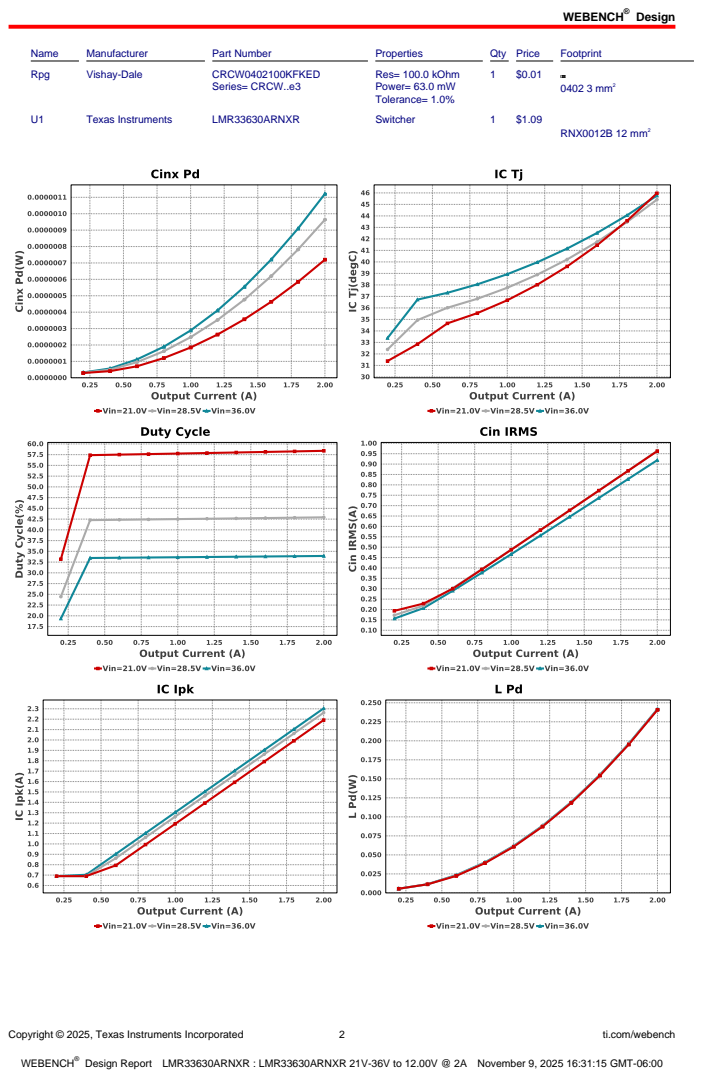
[picture p397: page 2]
Design; Copyright © 2025, Texas Instruments Incorporated; ti.com/webench; Name; Manufacturer; Part Number; Properties; Qty Price; Footprint; Rpg; Vishay-Dale; CRCW0402100KFKED; Series= CRCW..e3; Res= 100.0 kOhm Power= 63.0 mW Tolerance= 1.0%; 0402 3 mm²; Texas Instruments; LMR33630ARNXR; Switcher; RNX0012B 12 mm²

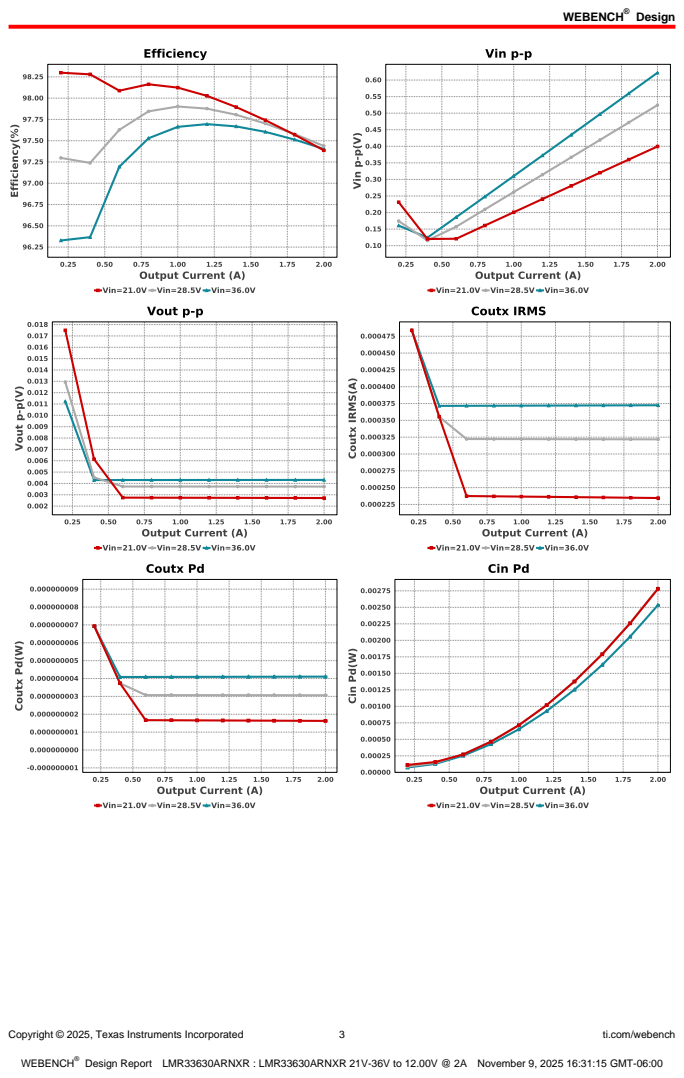
[picture p398: page 3]
Copyright © 2025, Texas Instruments Incorporated; ti.com/webench

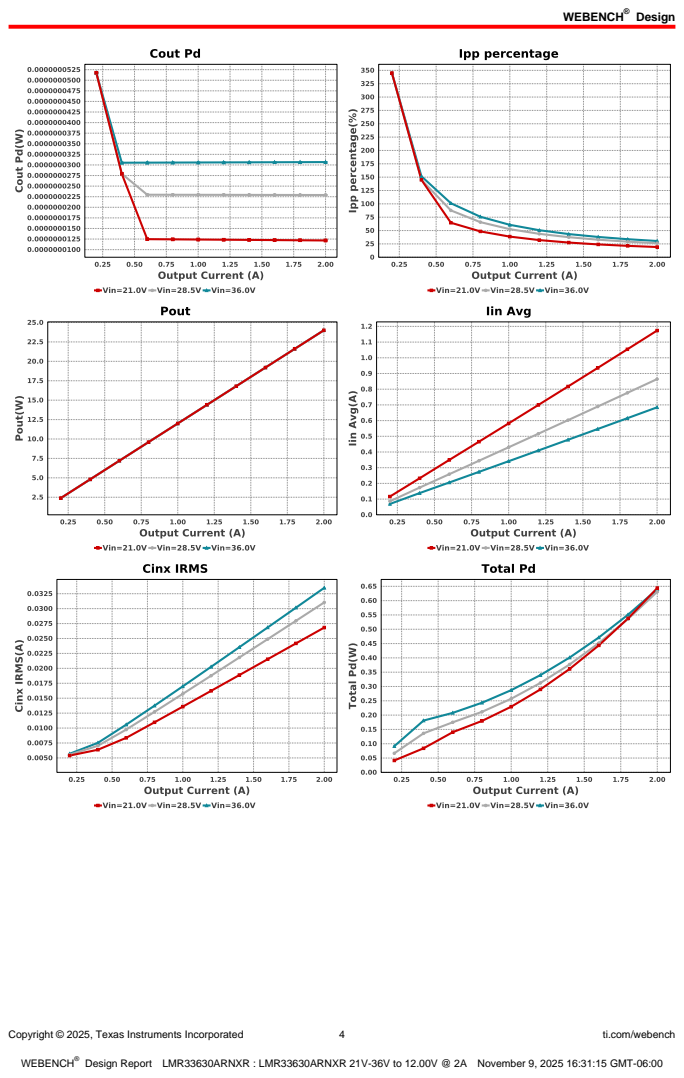
[picture p399: page 4]
Copyright © 2025, Texas Instruments Incorporated; ti.com/webench

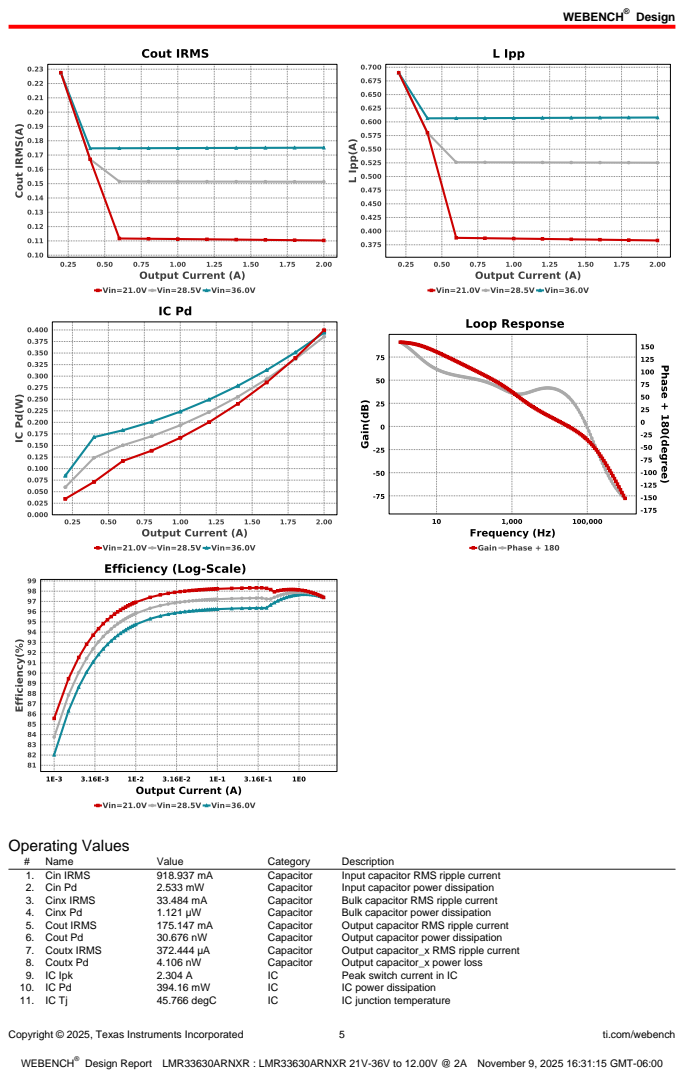
[picture p400: page 5]
Copyright © 2025, Texas Instruments Incorporated; ti.com/webench; Operating Values; Name; Value; Category; Description; 1. Cin IRMS; Capacitor; Input capacitor RMS ripple current; 2. Cin Pd; Input capacitor power dissipation; 3. Cinx IRMS; Bulk capacitor RMS ripple current; 4. Cinx Pd; Bulk capacitor power dissipation; 5. Cout IRMS; Output capacitor RMS ripple current; 6. Cout Pd; Output capacitor power dissipation; 7. Coutx IRMS; Output capacitor_x RMS ripple current; 8. Coutx Pd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

Copyright © 2025, Texas Instruments Incorporated | 6 | ti.com/webench
# | Name | Value | Category | Description

12. IC Tolerance | 15.0 mV | IC | IC Feedback Tolerance
13. ICThetaJA Effective | 40.0 degC/W | IC | Effective IC Junction-to-Ambient Thermal Resistance
14. Iin Avg | 684.44 mA | IC | Average input current
15. Ipp percentage | 30.401 % | Inductor | Inductor ripple current percentage (with respect to average inductor
| | | | current)
16. L Ipp | 608.02 mA | Inductor | Peak-to-peak inductor ripple current
17. L Pd | 241.85 mW | Inductor | Inductor power dissipation
18. Cin Pd | 2.533 mW | Power | Input capacitor power dissipation
19. Cinx Pd | 1.121 µW | Power | Bulk capacitor power dissipation
20. Cout Pd | 30.676 nW | Power | Output capacitor power dissipation
21. Coutx Pd | 4.106 nW | Power | Output capacitor_x power loss
22. IC Pd | 394.16 mW | Power | IC power dissipation
23. L Pd | 241.85 mW | Power | Inductor power dissipation
24. Total Pd | 639.897 mW | Power | Total Power Dissipation
25. BOM Count | 13 | System
| | | Information | Total Design BOM count
26. Cross Freq | 31.706 kHz | System
| | | Information | Bode plot crossover frequency
27. Duty Cycle | 33.926 % | System
| | | Information | Duty cycle
28. Efficiency | 97.403 % | System
| | | Information | Steady state efficiency
29. FootPrint | 506.0 mm² | System
| | | Information | Total Foot Print Area of BOM components
30. Frequency | 400.0 kHz | System
| | | Information | Switching frequency
31. Gain Marg | -12.202 dB | System
| | | Information | Bode Plot Gain Margin
32. Iout | 2.0 A | System
| | | Information | Iout operating point
33. Low Freq Gain | 91.073 dB | System
| | | Information | Gain at 1Hz
34. Mode | CCM | System
| | | Information | Conduction Mode
35. Phase Marg | 50.475 deg | System
| | | Information | Bode Plot Phase Margin
36. Pout | 24.0 W | System
| | | Information | Total output power
37. Total BOM | NA | System
| | | Information | Total BOM Cost
38. Vin | 36.0 V | System
| | | Information | Vin operating point
39. Vin p-p | 622.168 mV | System
| | | Information | Peak-to-peak input voltage
40. Vout | 12.0 V | System
| | | Information | Operational Output Voltage
41. Vout Actual | 12.001 V | System
| | | Information | Vout Actual calculated based on selected voltage divider resistors
42. Vout Tolerance | 3.38 % | System
| | | Information | Vout Tolerance based on IC Tolerance (no load) and voltage divider resistors if applicable
43. Vout p-p | 4.309 mV | System
| | | Information | Peak-to-peak output ripple voltage

## Design Inputs

Name | Value | Description
Iout | 2.0 | Maximum Output Current
VinMax | 36.0 | Maximum input voltage
VinMin | 21.0 | Minimum input voltage
Vout | 12.0 | Output Voltage
| base_pn | | LMR33630A-WSON | Base Product Number
source | DC | Input Source Type
Ta | 30.0 | Ambient temperature


Copyright © 2025, Texas Instruments Incorporated | 7 | ti.com/webench

## Assembly

## Component Testing

Some published data on components in datasheets such as Capacitor ESR and Inductor DC resistance is based on conservative values that will guarantee that the components always exceed the specification. For design purposes it is usually better to work with typical values. Since this data is not always available it is a good practice to measure the Capacitance and ESR values of Cin and Cout, and the inductance and DC resistance of L1 before assembly of the board. Any large discrepancies in values should be electrically simulated in WEBENCH to check for instabilities and thermally simulated in WebTHERM to make sure critical temperatures are not exceeded.

## Soldering Component to Board

If board assembly is done in house it is best to tack down one terminal of a component on the board then solder the other terminal. For surface mount parts with large tabs, such as the DPAK, the tab on the back of the package should be pre-tinned with solder, then tacked into place by one of the pins. To solder the tab town to the board place the iron down on the board while resting against the tab, heating both surfaces simultaneously. Apply light pressure to the top of the plastic case until the solder flows around the part and the part is flush with the PCB. If the solder is not flowing around the board you may need a higher wattage iron (generally 25W to 30W is enough).

## Initial Startup of Circuit

It is best to initially power up the board by setting the input supply voltage to the lowest operating input voltage 21.0V and set the input supply's current limit to zero. With the input supply off connect up the input supply to Vin and GND. Connect a digital volt meter and a load if needed to set the minimum Iout of the design from Vout and GND. Turn on the input supply and slowly turn up the current limit on the input supply.
If the voltage starts to rise on the input supply continue increasing the input supply current limit while watching the output voltage. If the current increases on the input supply, but the voltage remains near zero, then there may be a short or a component misplaced on the board. Power down the board and visually inspect for solder bridges and recheck the diode and capacitor polarities. Once the power supply circuit is operational then more extensive testing may include full load testing, transient load and line tests to compare with simulation results.

## Load Testing

The setup is the same as the initial startup, except that an additional digital voltmeter is connected between Vin and GND, a load is connected between Vout and GND and a current meter is connected in series between Vout and the load. The load must be able to handle at least rated output power + 50% ( 7.5 watts for this design). Ideally the load is supplied in the form of a variable load test unit. It can also be done in the form of suitably large power resistors. When using an oscilloscope to measure waveforms on the prototype board, the ground leads of the oscilloscope probes should be as short as possible and the area of the loop formed by the ground lead should be kept to a minimum. This will help reduce ground lead inductance and eliminate EMI noise that is not actually present in the circuit.

## Design Assistance

1. Master key : 5FFB4611713714A73A2F511ACDE4AFEF[v1]
2. LMR33630A-WSON Product Folder : http://www.ti.com/product/LMR33630 : contains the data sheet and other resources.

Copyright © 2025, Texas Instruments Incorporated | 8 | ti.com/webench

Important Notice and Disclaimer

TI provides technical and reliability data (including datasheets), design resources (including reference designs), application or other design advice, web tools, safety information, and other resources AS IS and with all faults, and disclaims all warranties. These resources are intended for skilled developers designing with TI products. You are solely responsible for (1) selecting the appropriate TI products for your application, (2) designing, validating and testing your application, and (3) ensuring your application meets applicable standards, and any other safety, security, or other requirements.

These resources are subject to change without notice. TI grants you permission to use these resources only for development of an application that uses the TI products described in the resource. Other reproduction and display of these resources is prohibited. No license is granted to any other TI intellectual property right or to any third party intellectual property right. TI disclaims responsibility for, and you will fully indemnify TI and its representatives against, any claims, damages, costs, losses, and liabilities arising out of your use of these resources.

Providing these resources does not expand or otherwise alter TI's applicable Terms of Sale or other applicable terms available either on ti.com or provided in conjunction with TI products.
