cononinator/GeecPE2526/Altium/NewPowerElec/GeecPE/Project Outputs for GeecPE/PDF/PowerElectronics.pdf

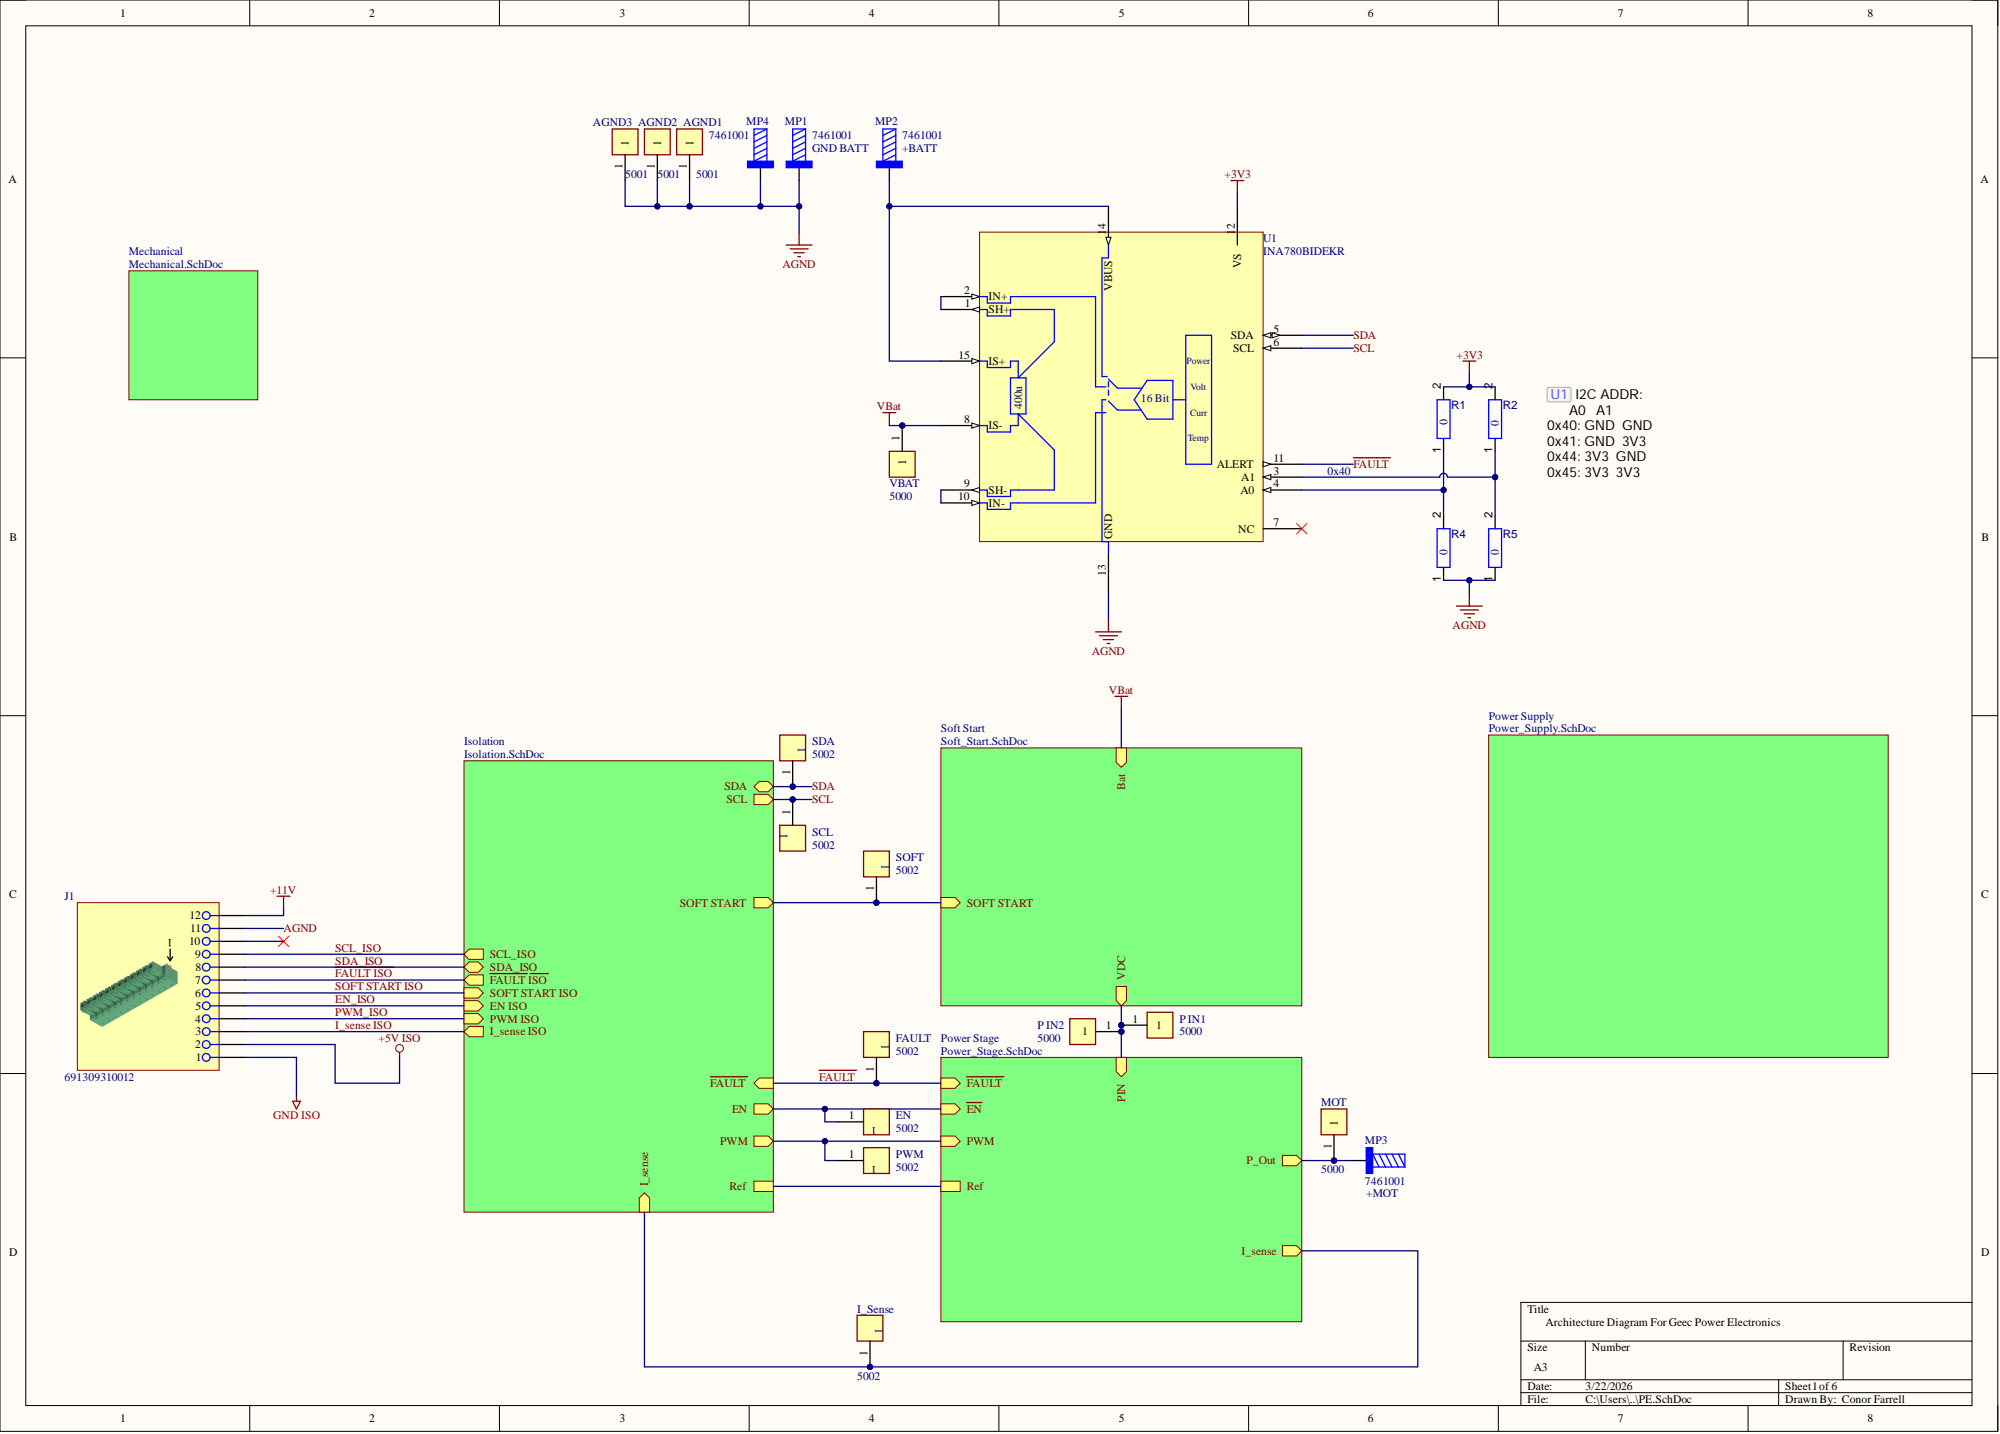
[picture p401: page 1]

Title
Architecture Diagram For Geec Power Electronics

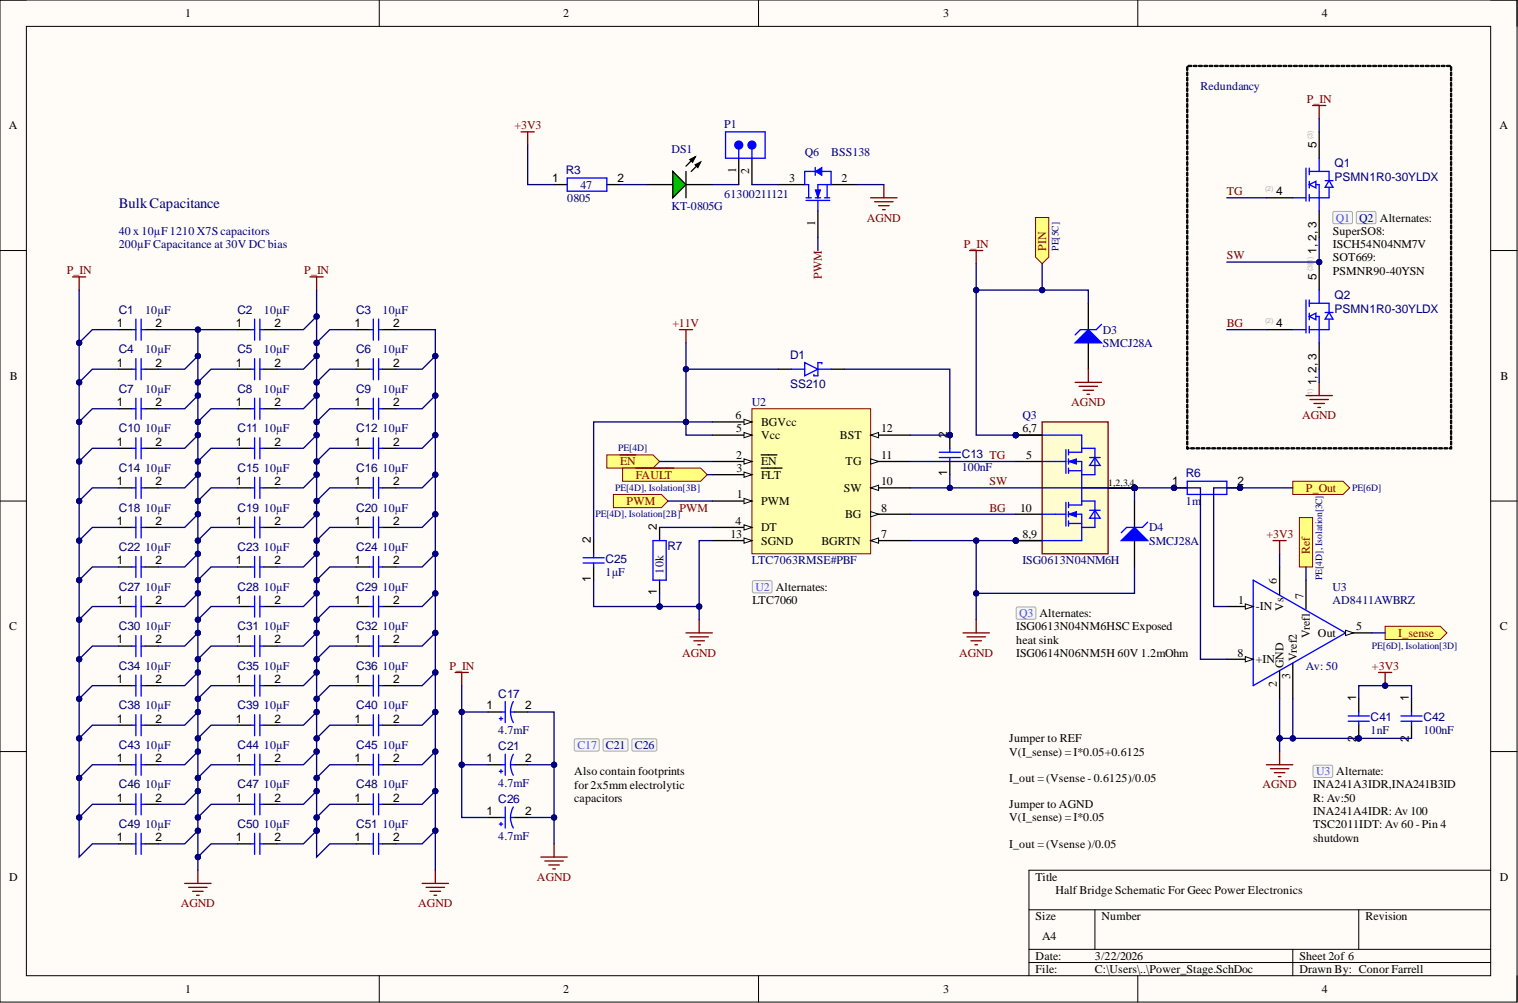
[picture p402: page 2]

C 2 5 | | ISG

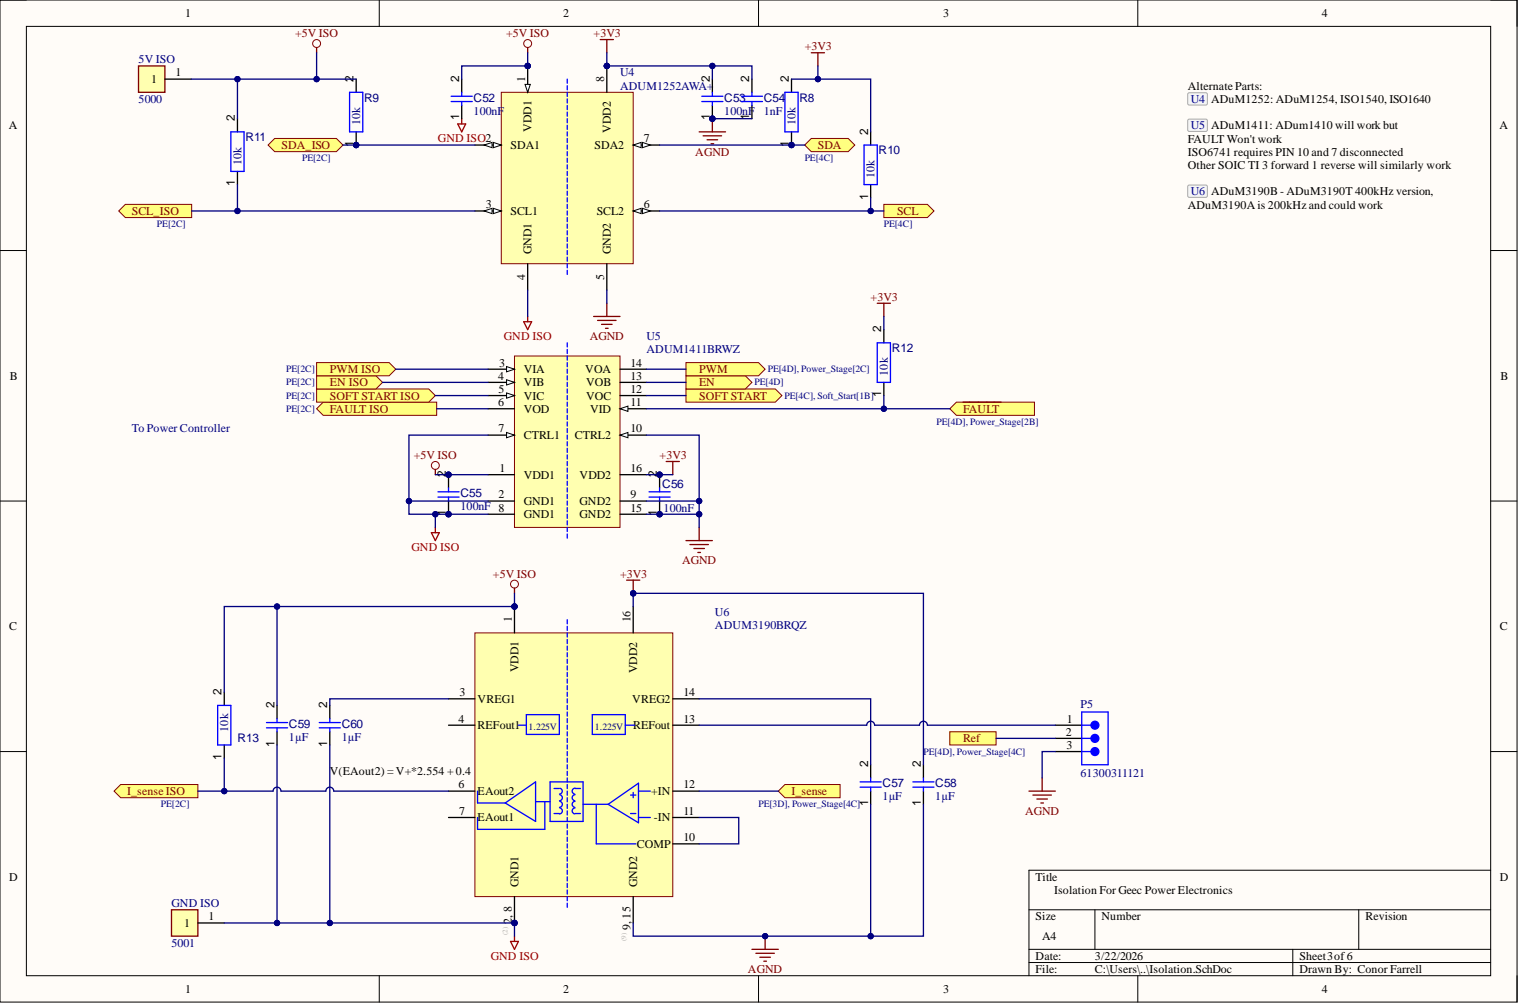
[picture p403: page 3]

U5 ADuM1411: ADum1410 will work but
FAULT Won't work
ISO6741 requires PIN 10 and 7 disconnected
Other SOIC TI 3 forward 1 reverse will similarly work

U6 ADuM3190B - ADuM3190T 400kHz version,
ADuM3190A is 200kHz and could work

U6 ADUM3190BRQZ

VREG1 3

Title
Isolation For Geec Power Electronics

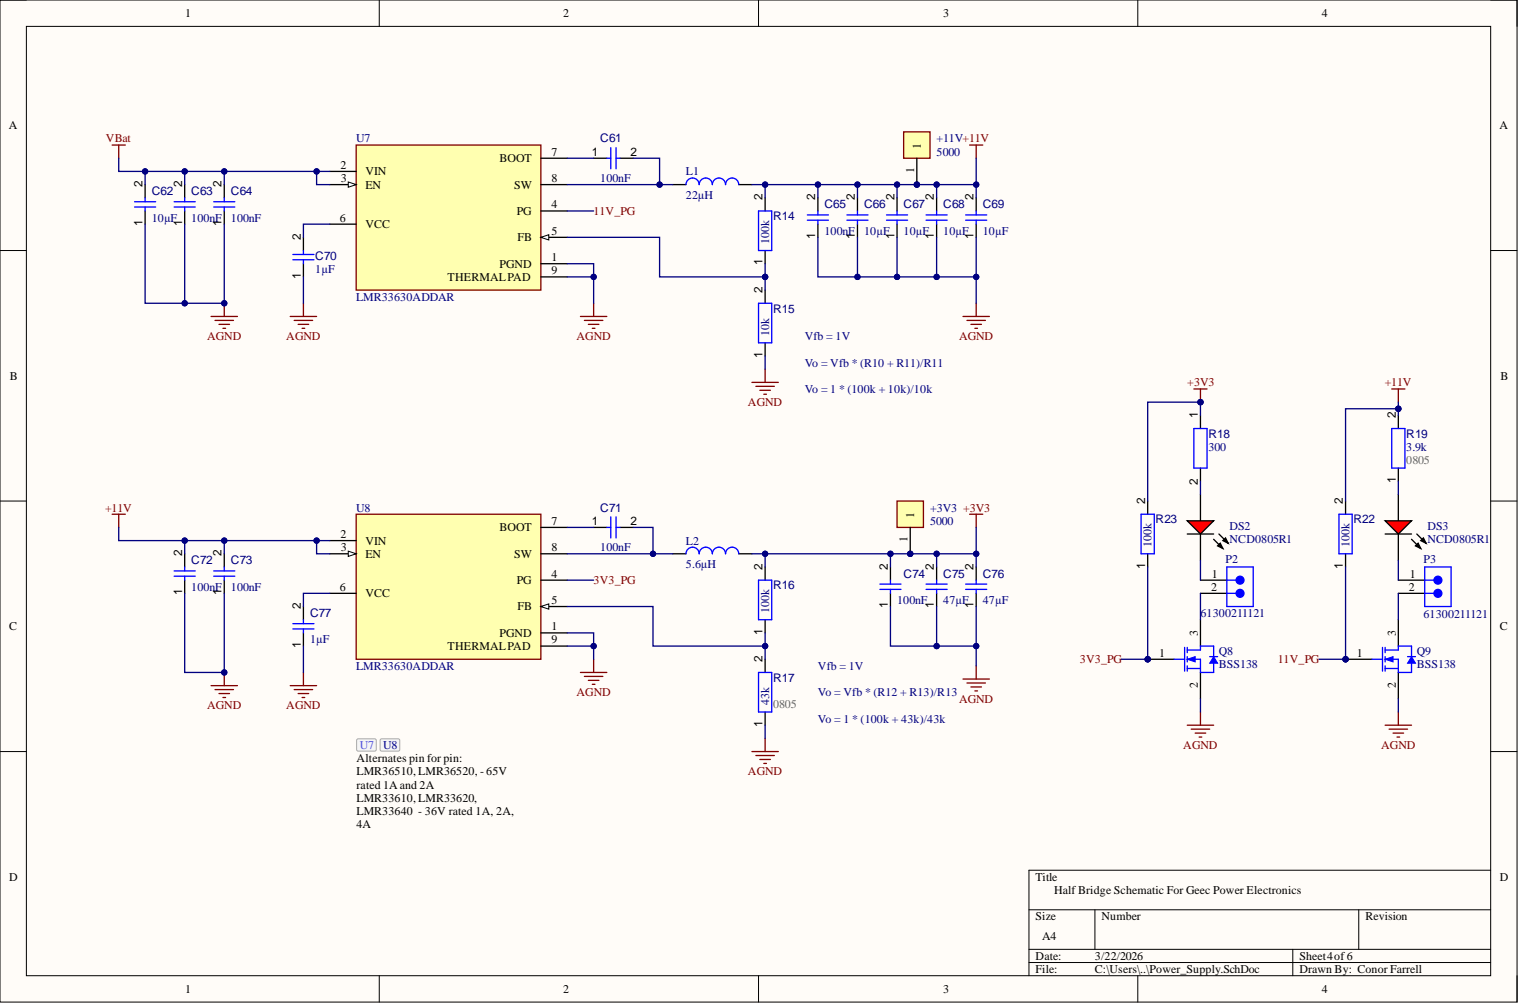
[picture p404: page 4]

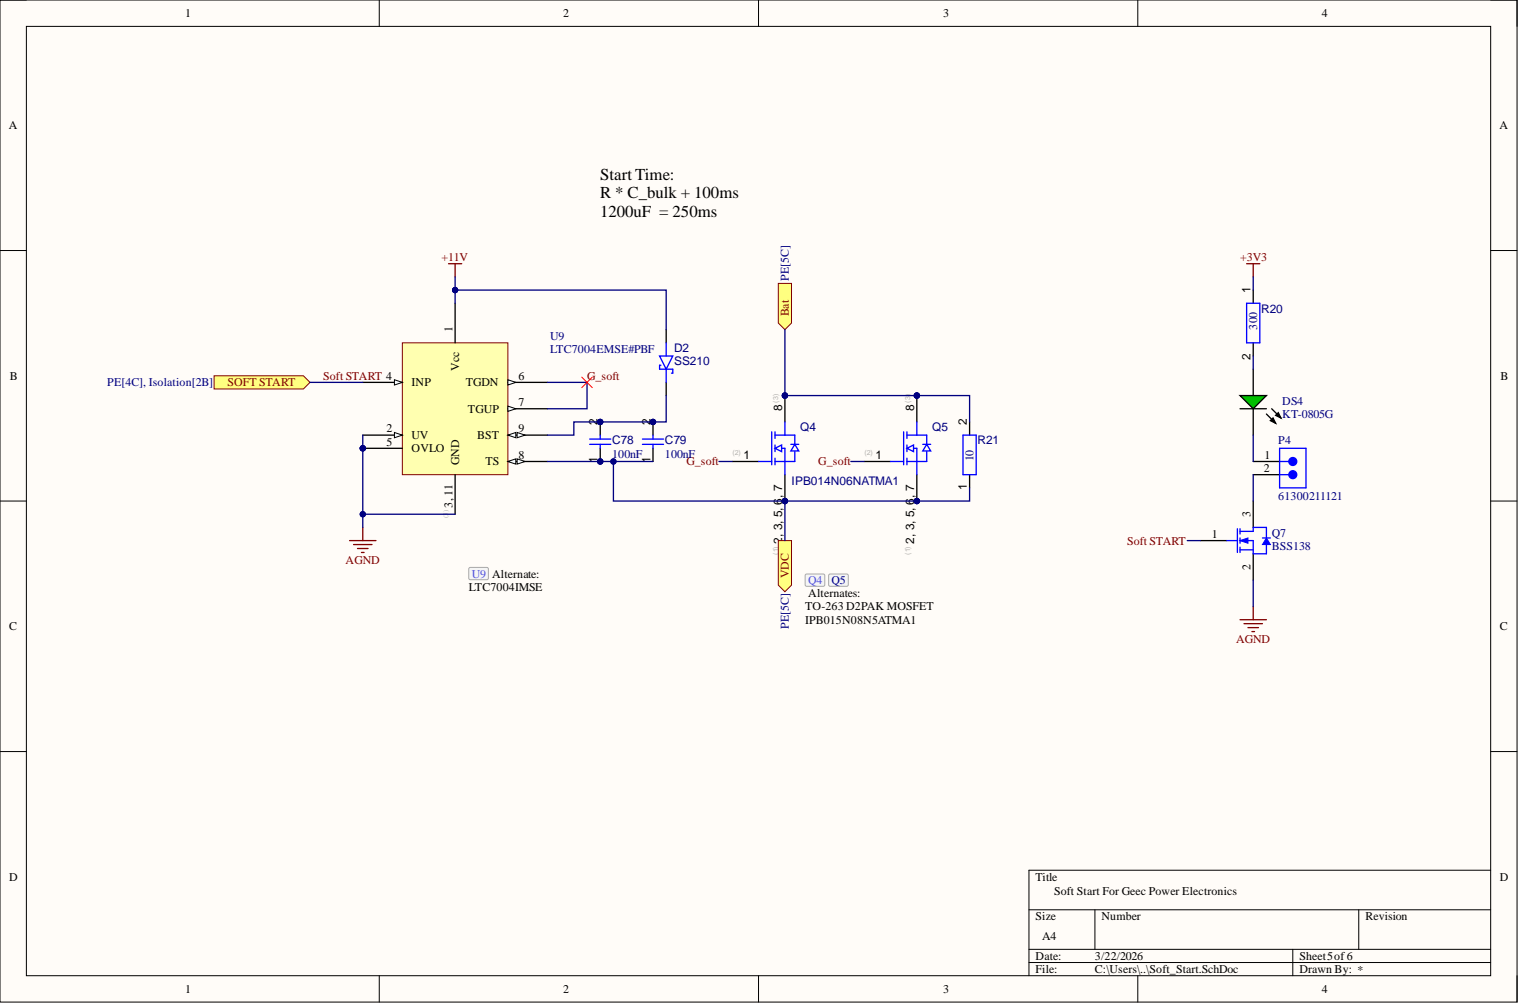
[picture p405: page 5]

Bat PE[5C] VDC PE[5C]

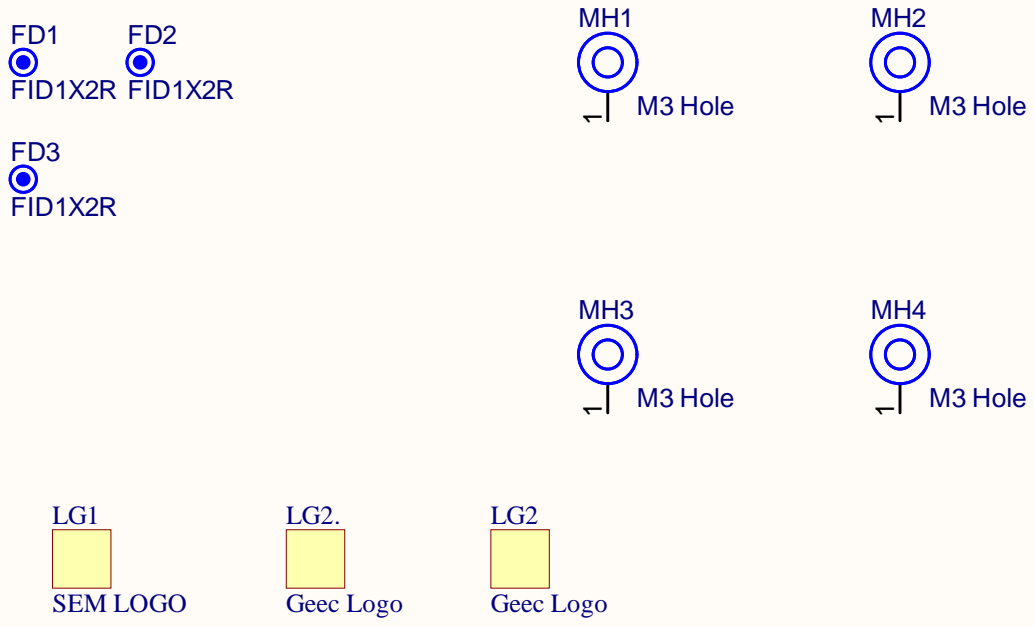
[picture p406: page 6]

Title
Mechanical For Geec Power Electronics

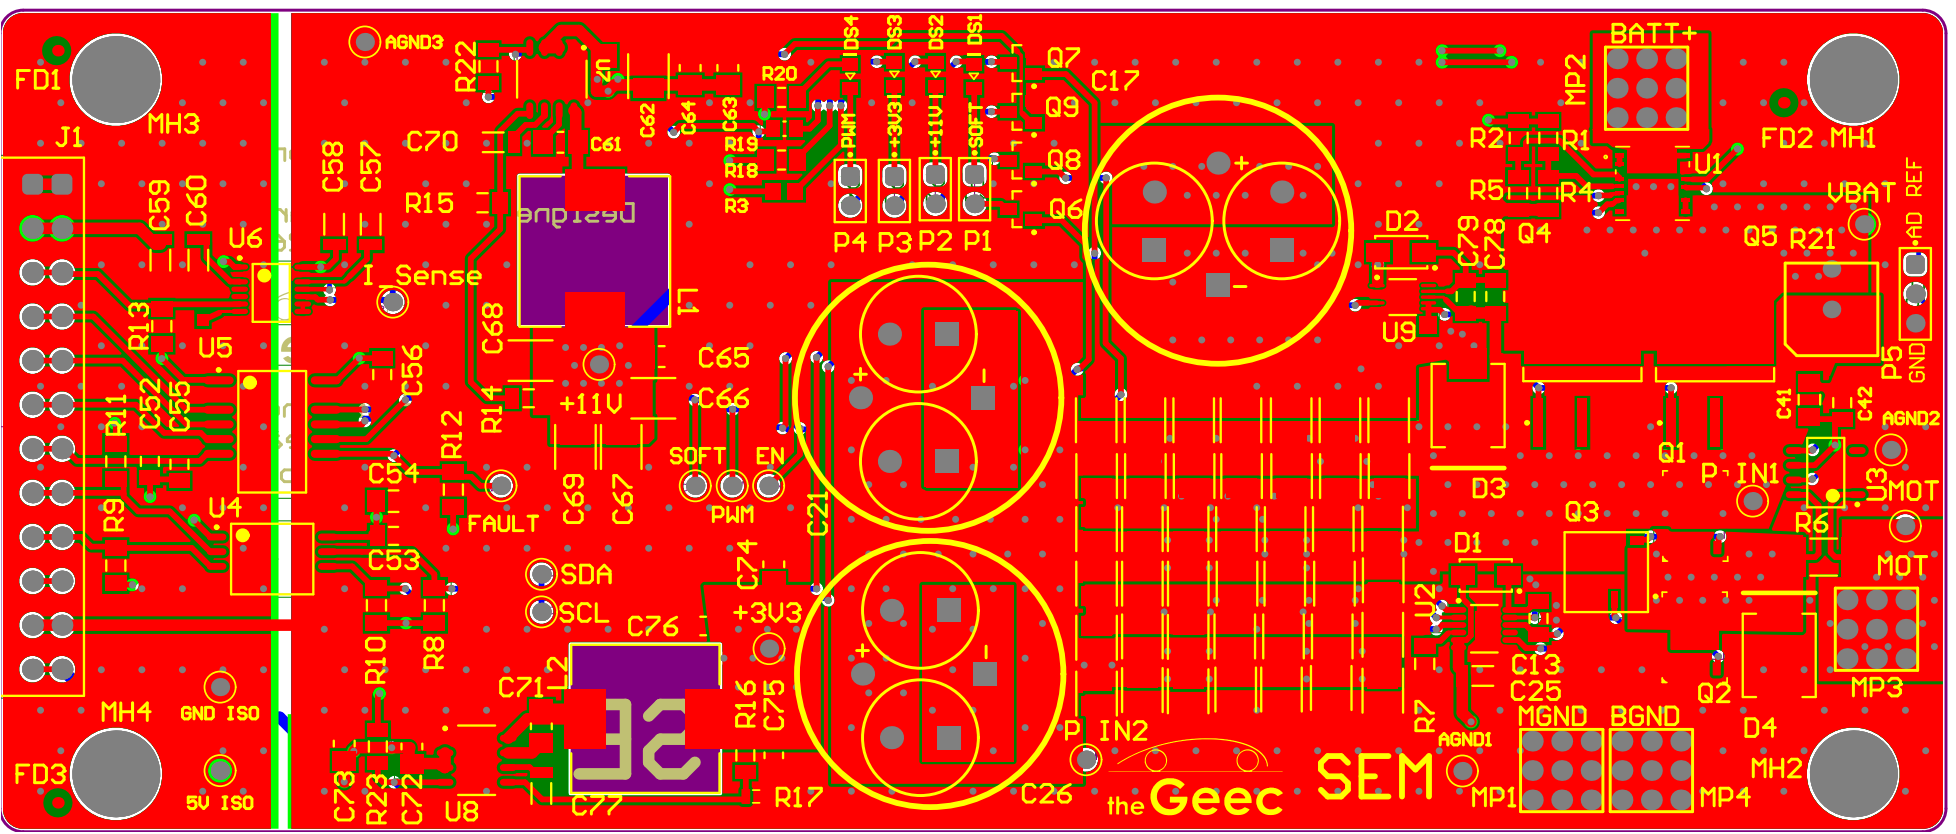
[picture p407: page 7]

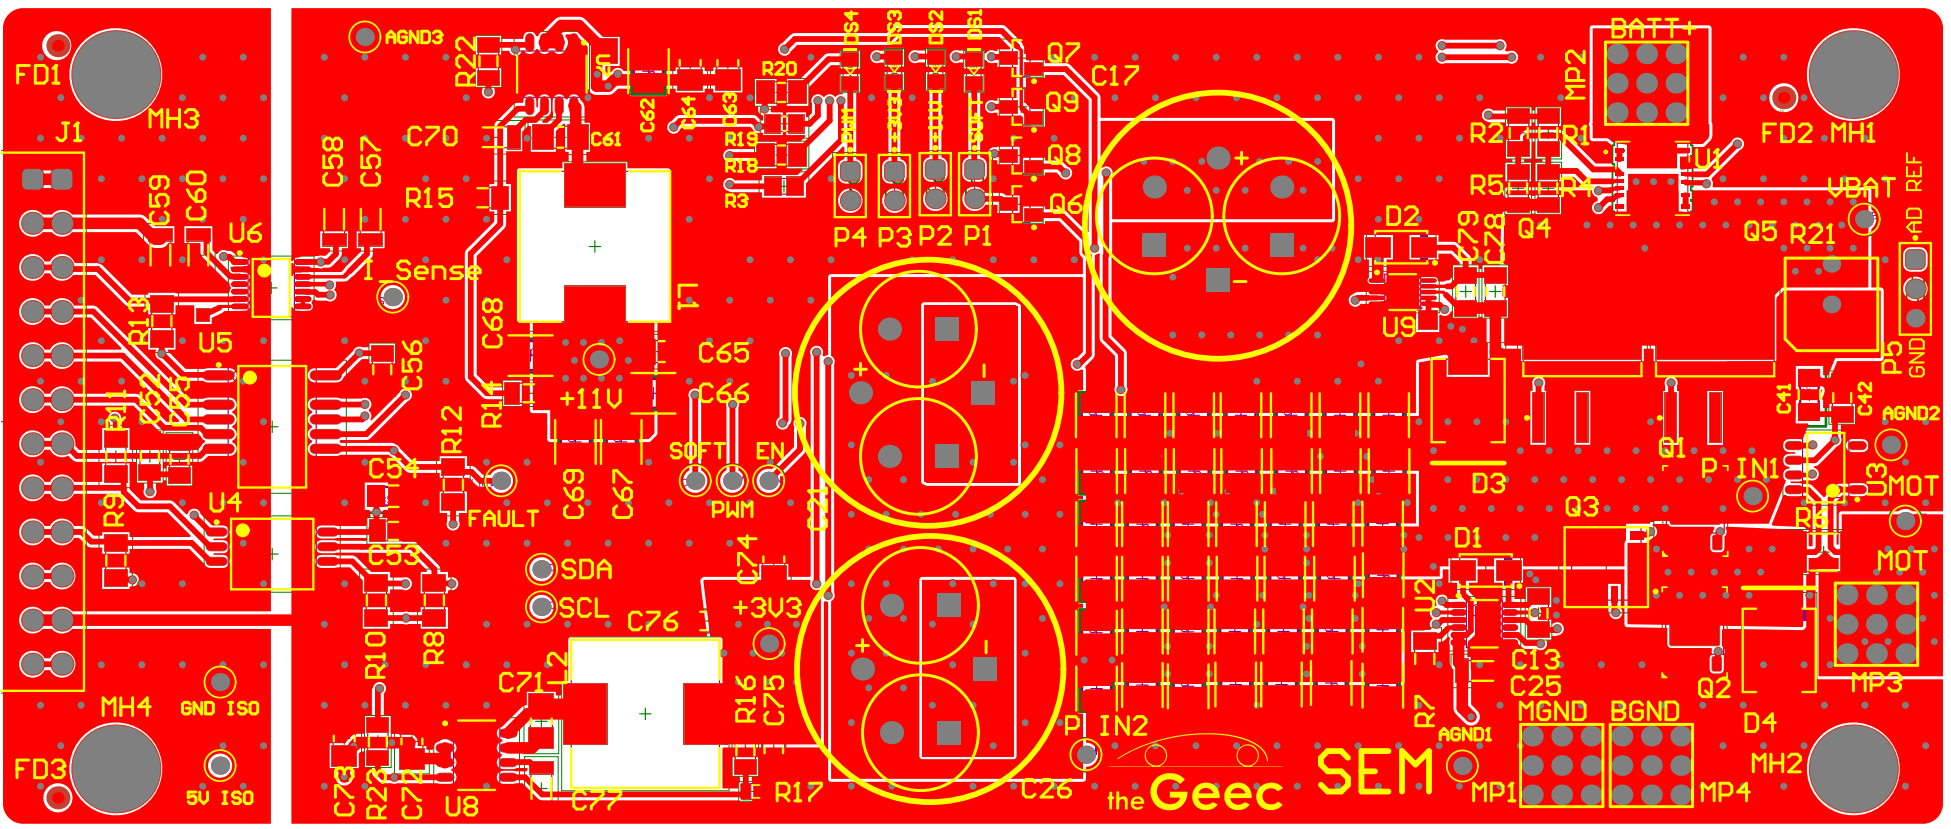
[picture p408: page 8]

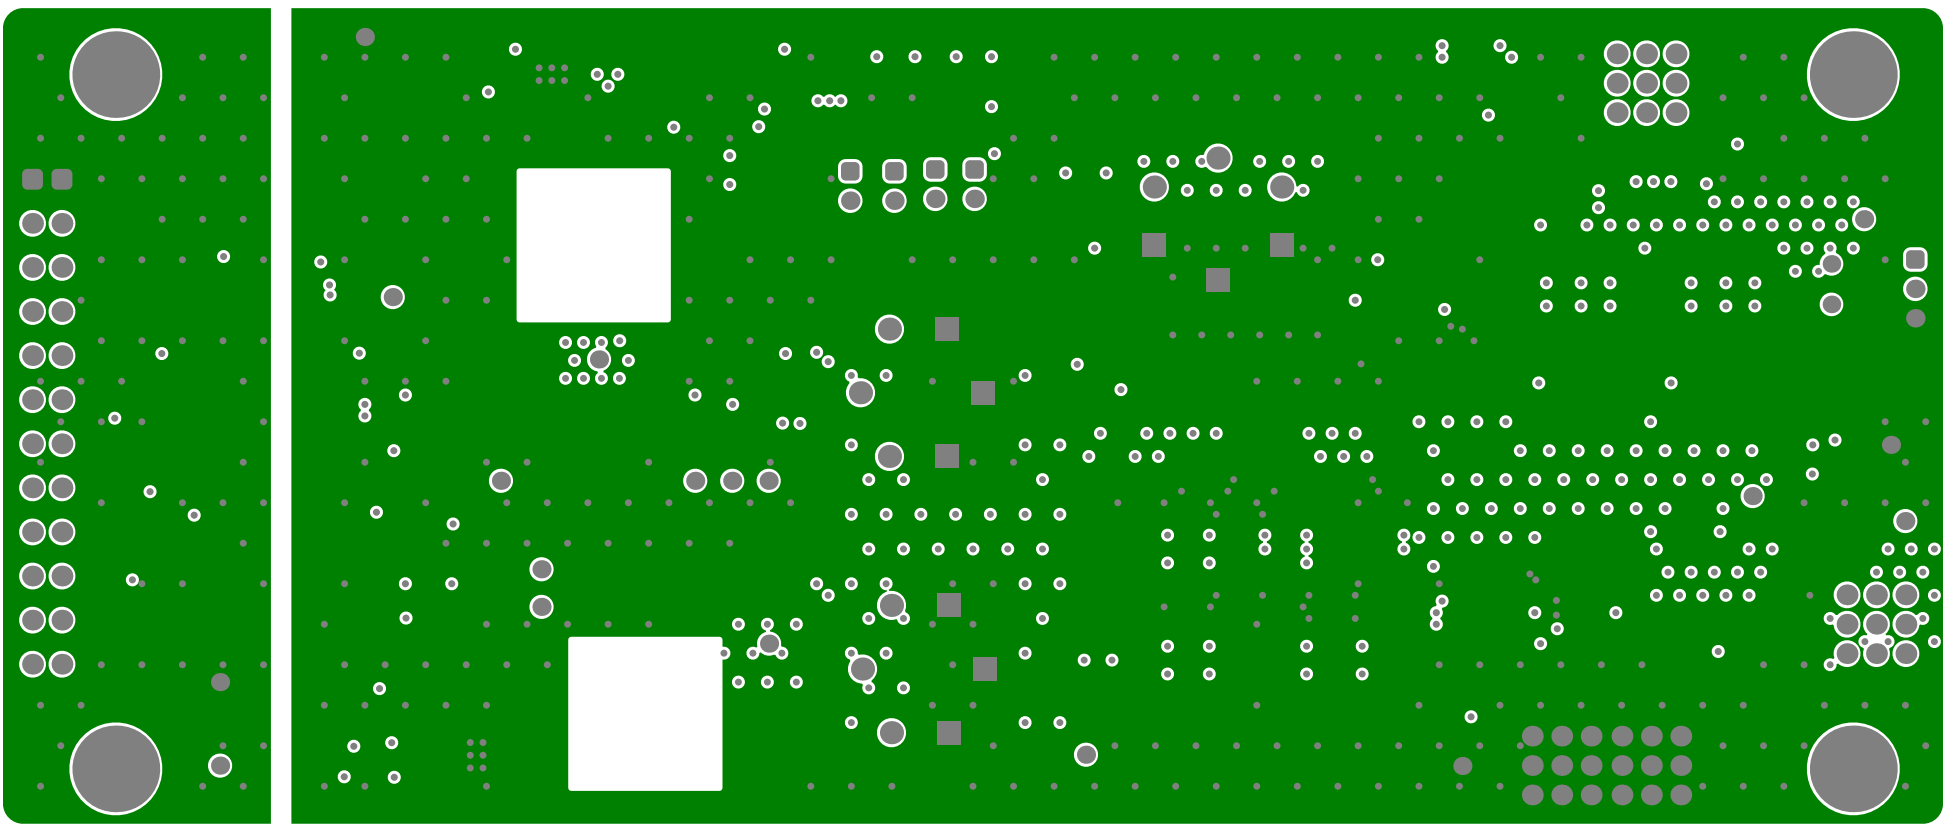
[picture p409: page 9]

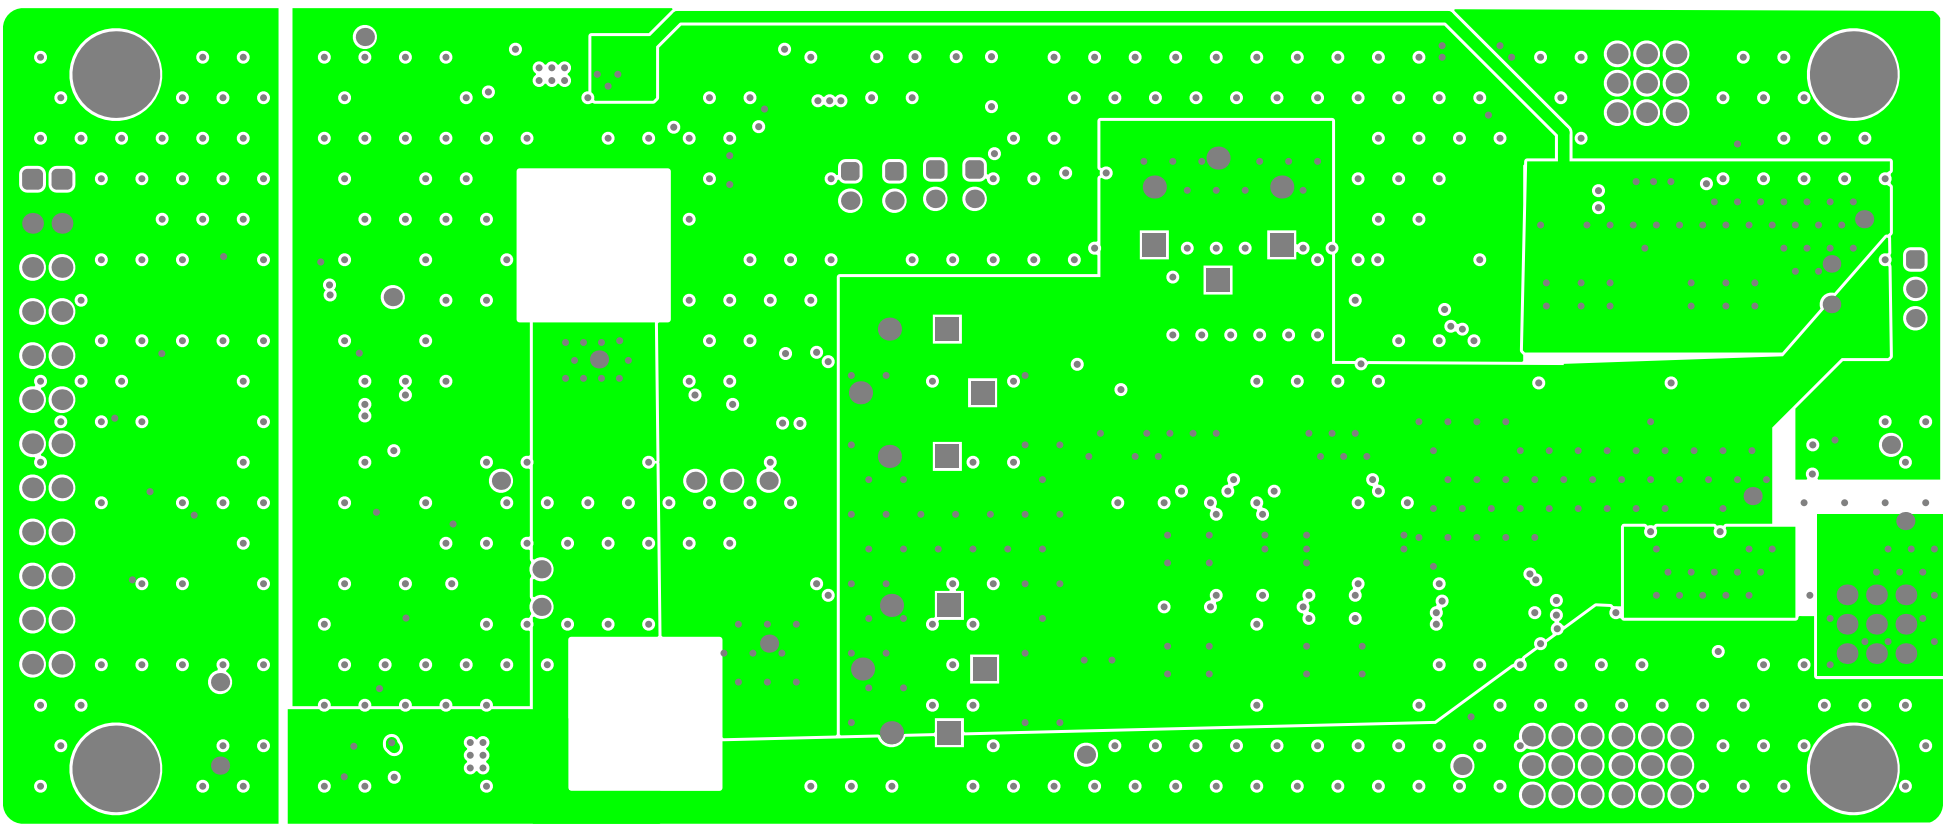
[picture p410: page 10]

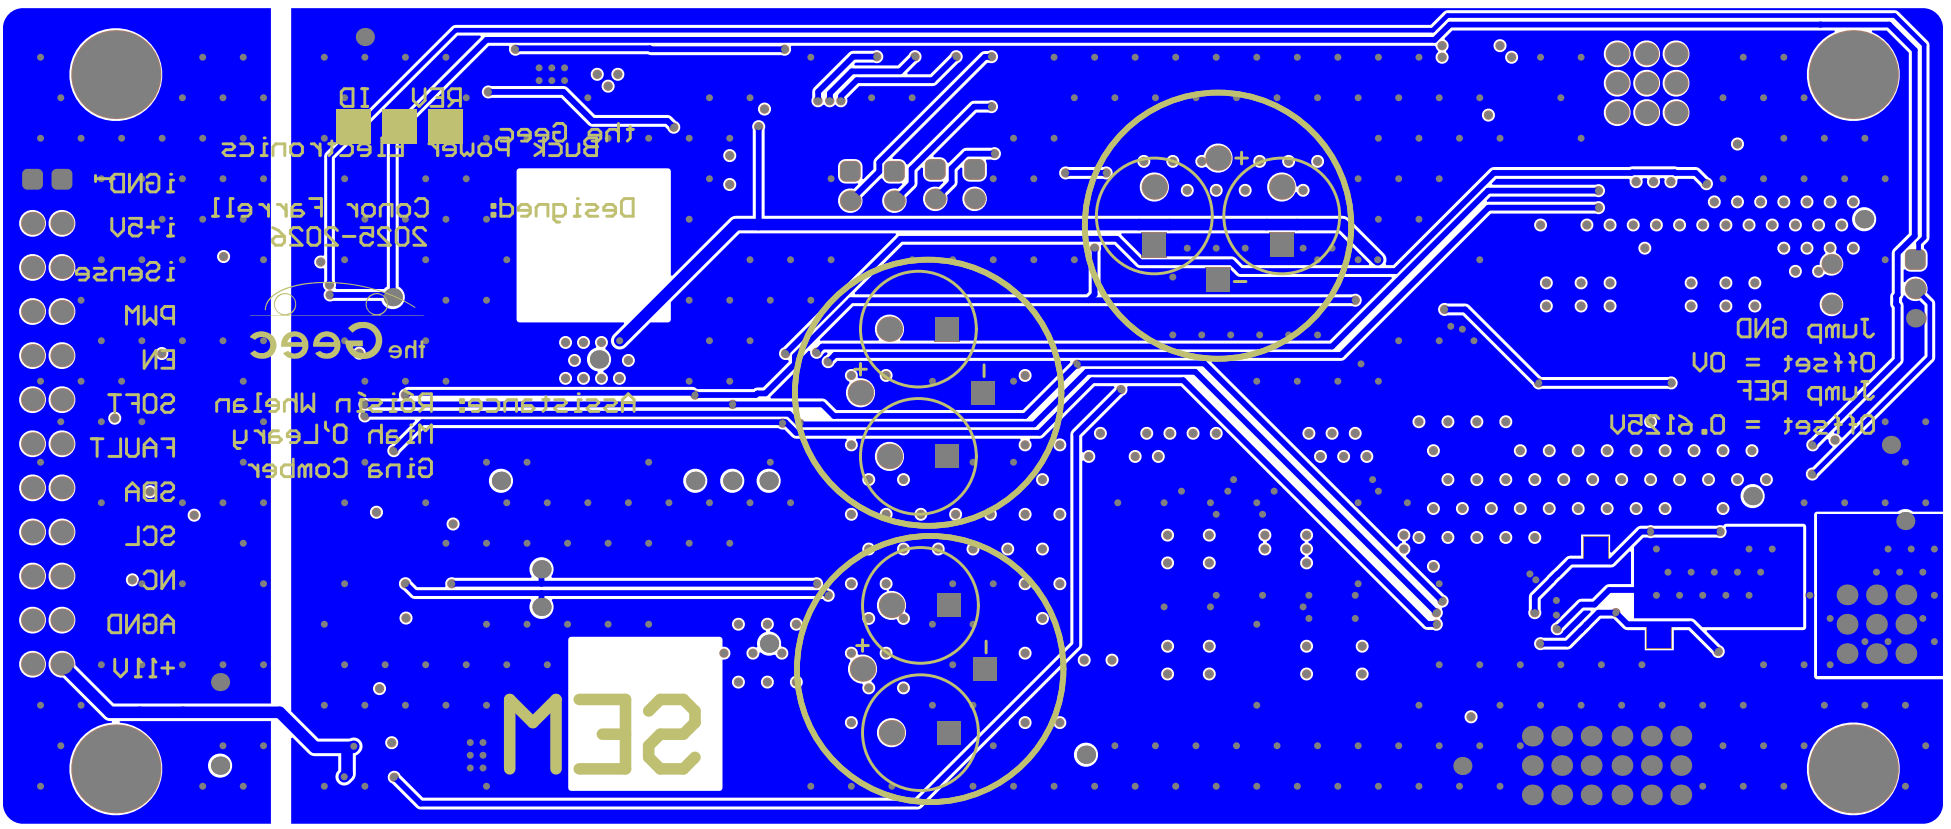
[picture p411: page 11]

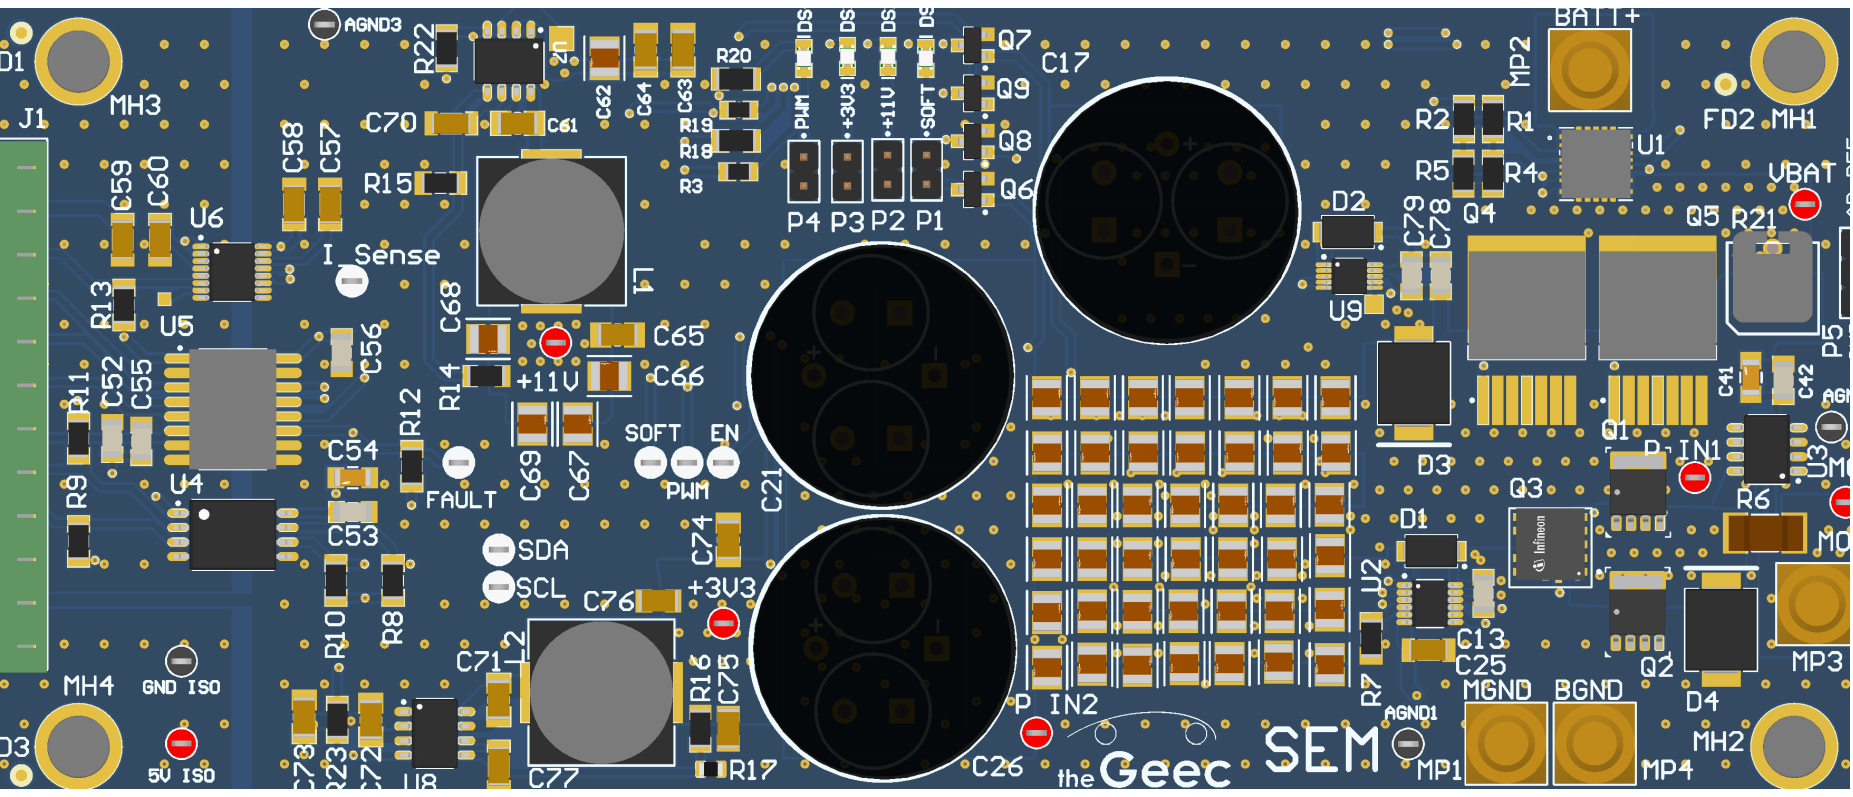
[picture p412: page 12]
