cononinator/GeecPE2526/SMD_Sync_Buck_Controller.pdf

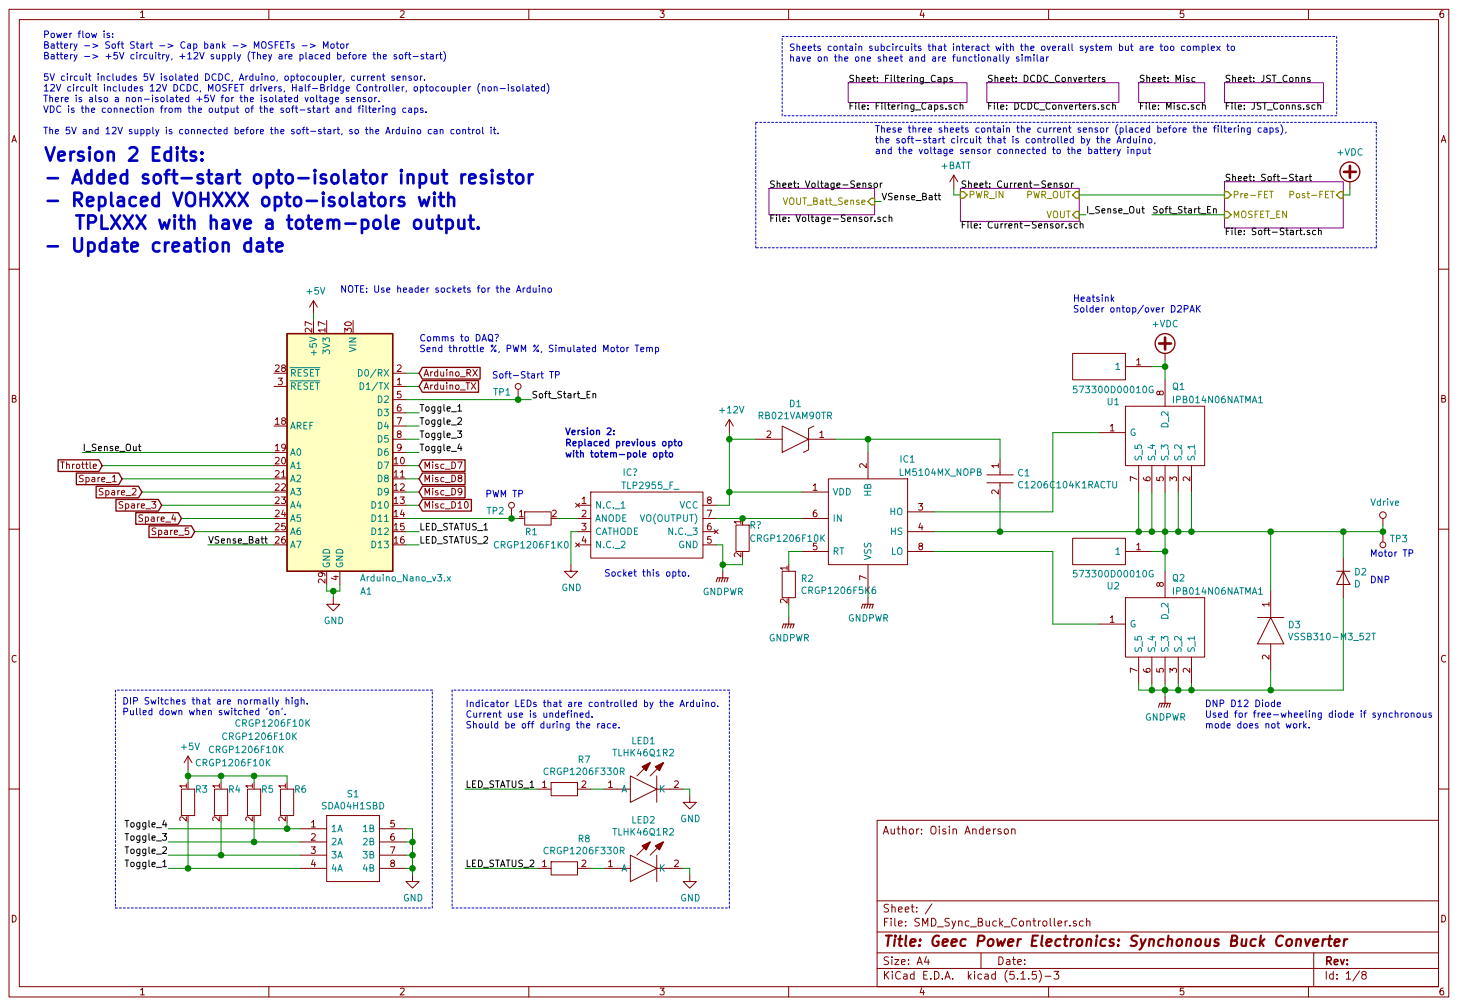
[picture p413: page 1]

Power flow is: Battery -> Soft Start -> Cap bank -> MOSFETs -> Motor

Battery -> +5V circuitry, +12V supply (They are placed before the soft-start)

Sheets contain subcircuits that interact with the overall system but are too complex to

have on the one sheet and are functionally similar Comms to DAQ? Send throttle %, PWM %, Simulated Motor Temp

5V circuit includes 5V isolated DCDC, Arduino, optocoupler, current sensor.
12V circuit includes 12V DCDC, MOSFET drivers, Half-Bridge Controller, optocoupler (non-isolated)
There is also a non-isolated +5V for the isolated voltage sensor.
VDC is the connection from the output of the soft-start and filtering caps.

These three sheets contain the current sensor (placed before the filtering caps),
the soft-start circuit that is controlled by the Arduino,

The 5V and 12V supply is connected before the soft-start, so the Arduino can control it.
- Added soft-start opto-isolator input resistor
- Replaced VOHXXX opto-isolators with
TPLXXX with have a totem-pole output.
- Update creation date

Version 2: Replaced previous opto

with totem-pole opto
LM5104MX_NOPB GND

DIP Switches that are normally high. Pulled down when switched 'on'.

Indicator LEDs that are controlled by the Arduino. Current use is undefined. Should be off during the race.

File: SMD_Sync_Buck_Controller.sch Sheet: / Author: Oisin Anderson

Id: 1/8 Title: Geec Power Electronics: Synchonous Buck Converter

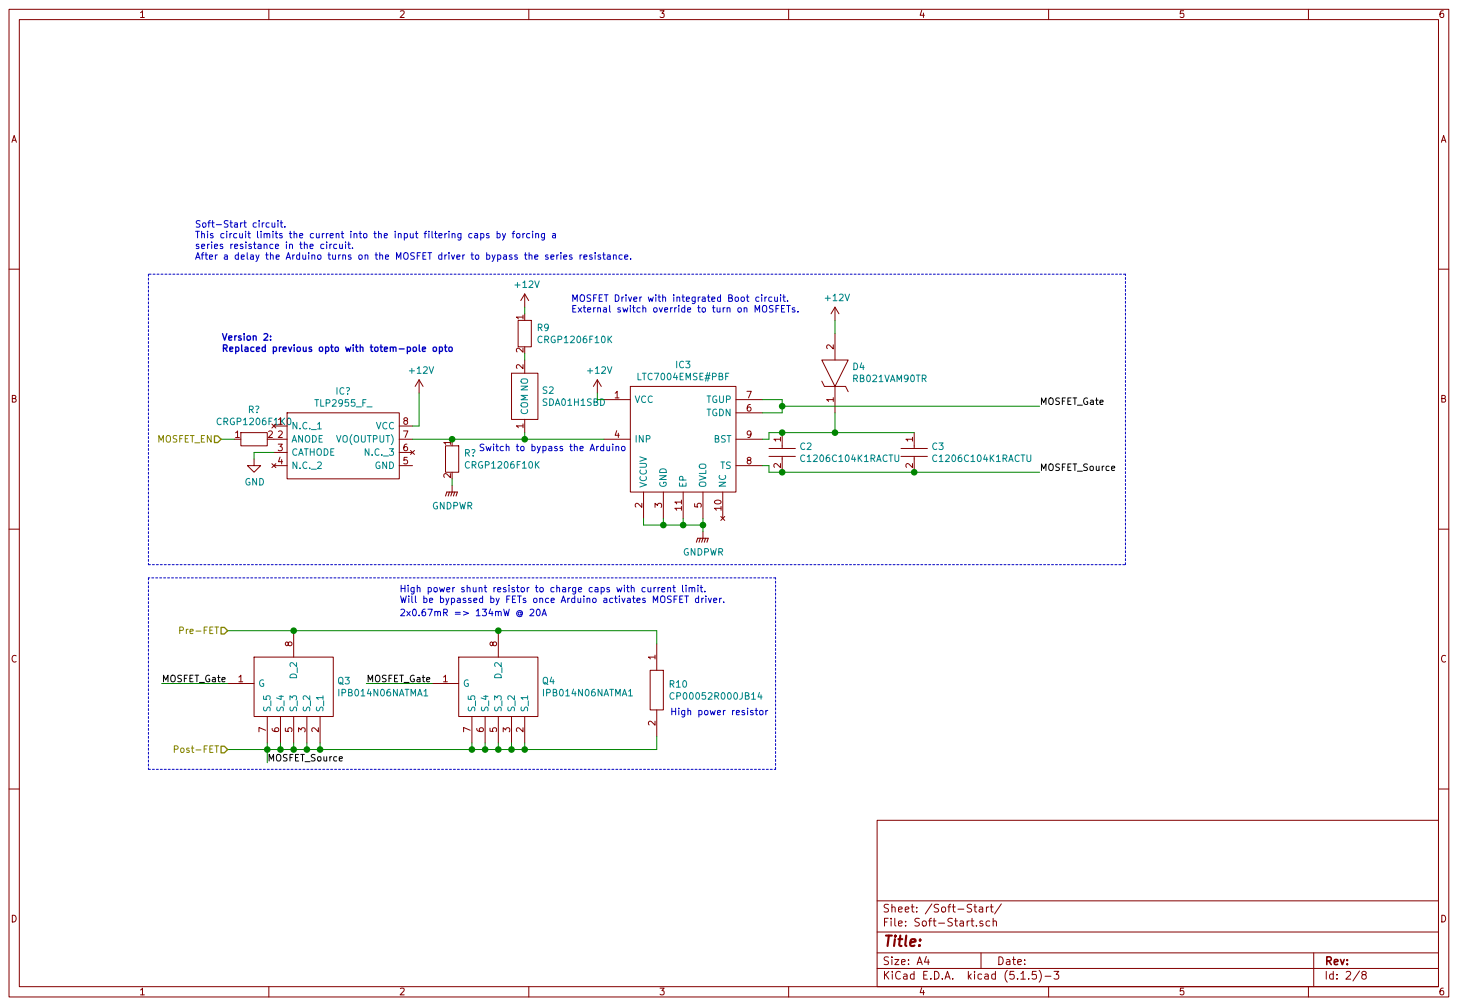
[picture p414: page 2]

MOSFET Driver with integrated Boot circuit. External switch override to turn on MOSFETs. High power resistor
IPB014N06NATMA1 +12V
LTC7004EMSE#PBF COM

Switch to bypass the Arduino Soft-Start circuit. This circuit limits the current into the input filtering caps by forcing a series resistance in the circuit. After a delay the Arduino turns on the MOSFET driver to bypass the series resistance.

5 TGDN 6 TGUP 7 TS 8 BST 9

2x0.67mR => 134mW @ 20A High power shunt resistor to charge caps with current limit.
Will be bypassed by FETs once Arduino activates MOSFET driver.

Id: 2/8 Title: File: Soft-Start.sch Sheet: /Soft-Start/

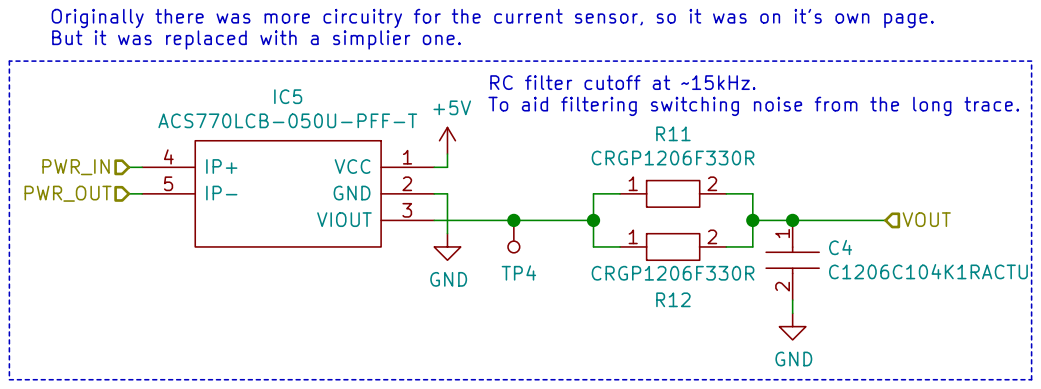
[picture p415: page 3]

PWR_OUT Originally there was more circuitry for the current sensor, so it was on it's own page.

Id: 3/8 Title: File: Current-Sensor.sch Sheet: /Current-Sensor/

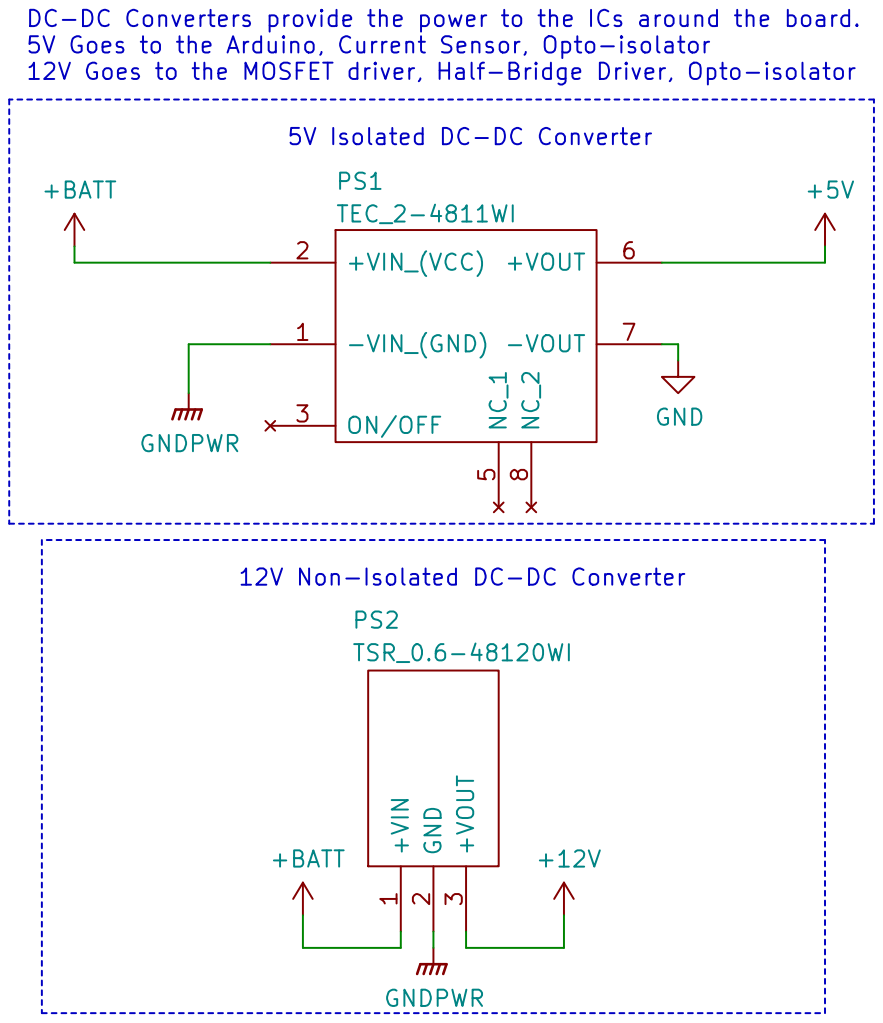
[picture p416: page 4]

12V Non-Isolated DC-DC Converter DC-DC Converters provide the power to the ICs around the board.
5V Goes to the Arduino, Current Sensor, Opto-isolator
12V Goes to the MOSFET driver, Half-Bridge Driver, Opto-isolator 5V Isolated DC-DC Converter

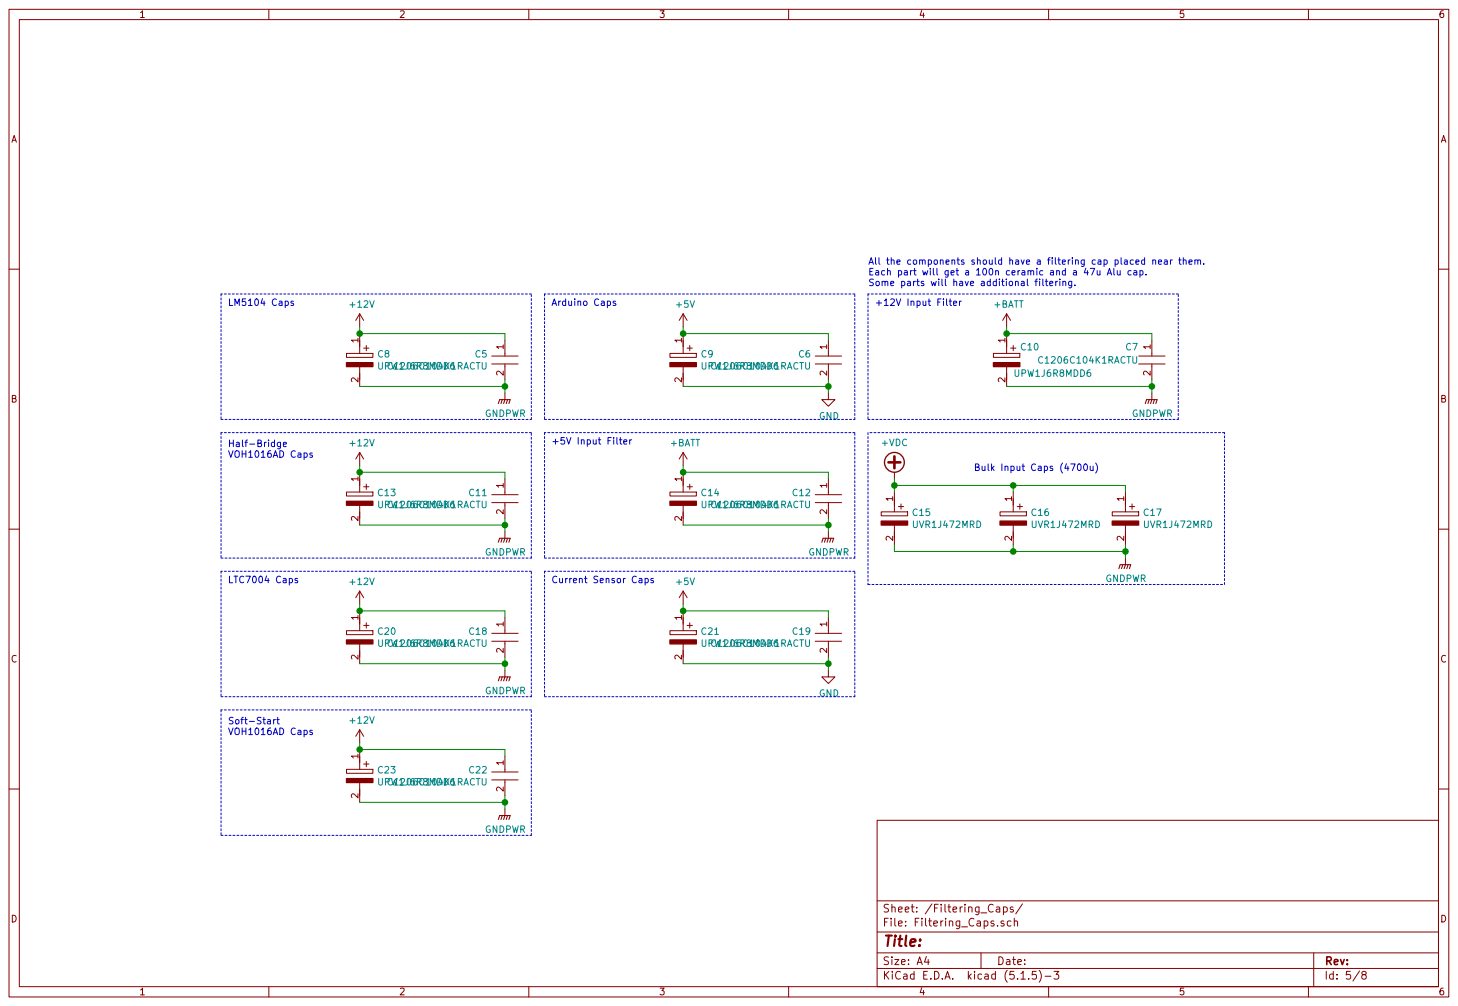
[picture p417: page 5]

All the components should have a filtering cap placed near them.
Each part will get a 100n ceramic and a 47u Alu cap.
Some parts will have additional filtering.
+12V Input Filter

Half-Bridge
VOH1016AD Caps
LTC7004 Caps Soft-Start VOH1016AD Caps

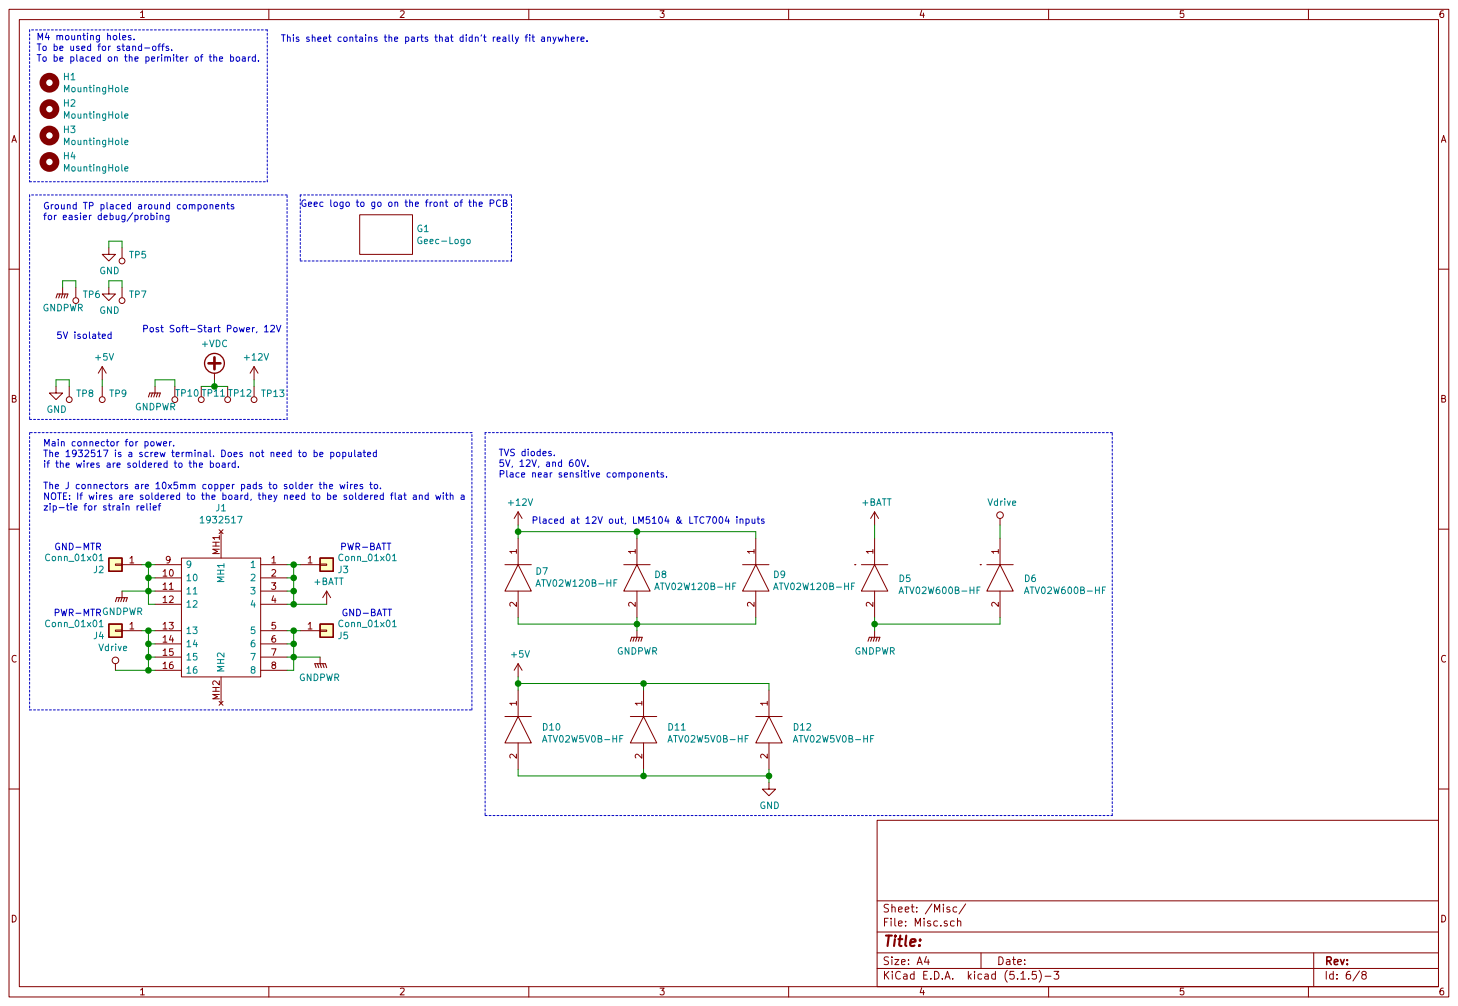
[picture p418: page 6]

Placed at 12V out, LM5104 & LTC7004 inputs TVS diodes. 5V, 12V, and 60V. Place near sensitive components. 5V isolated M4 mounting holes. To be used for stand-offs. To be placed on the perimiter of the board.
This sheet contains the parts that didn't really fit anywhere. PWR-MTR

PWR-BATT GND-BATT Post Soft-Start Power, 12V Ground TP placed around components
for easier debug/probing

Main connector for power.
The 1932517 is a screw terminal. Does not need to be populated
if the wires are soldered to the board. The J connectors are 10x5mm copper pads to solder the wires to.

NOTE: If wires are soldered to the board, they need to be soldered flat and with a
zip-tie for strain relief

Id: 6/8 Title: File: Misc.sch Sheet: /Misc/

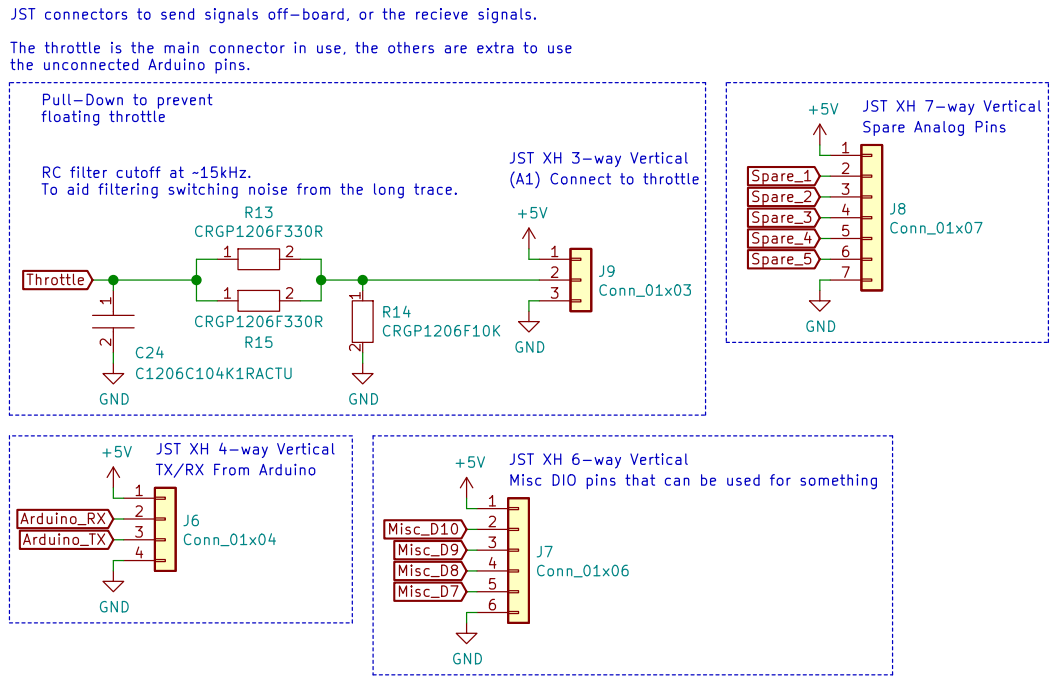
[picture p419: page 7]

JST connectors to send signals off-board, or the recieve signals. The throttle is the main connector in use, the others are extra to use

the unconnected Arduino pins.

Pull-Down to prevent

Spare Analog Pins TX/RX From Arduino

JST XH 3-way Vertical
(A1) Connect to throttle

JST XH 4-way Vertical

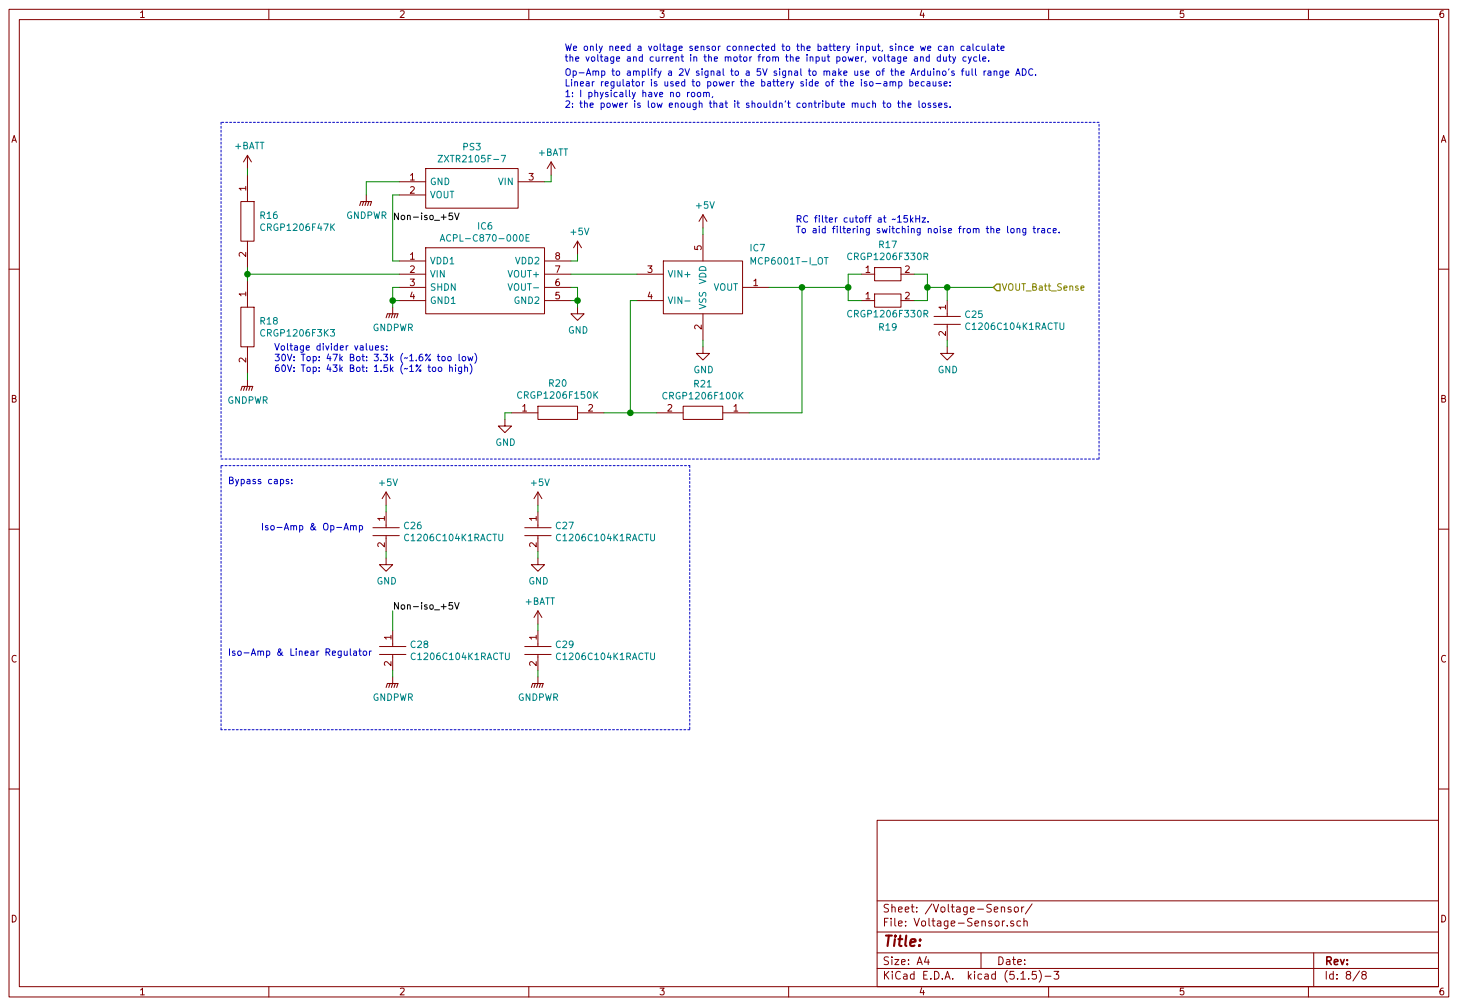
[picture p420: page 8]

the voltage and current in the motor from the input power, voltage and duty cycle.
Op-Amp to amplify a 2V signal to a 5V signal to make use of the Arduino's full range ADC.
Linear regulator is used to power the battery side of the iso-amp because:
1: I physically have no room,
2: the power is low enough that it shouldn't contribute much to the losses.

Voltage divider values:
30V: Top: 47k Bot: 3.3k (1.6% too low)
60V: Top: 43k Bot: 1.5k (1% too high)

Sheet: /Voltage-Sensor/ GND GNDPWR

Iso-Amp & Op-Amp

File: Voltage-Sensor.sch
Id: 8/8 Title:
