cononinator/GeecPE2526/Altium/NewPowerElec/GeecPC/Project Outputs for GeecPC/PowerController.pdf

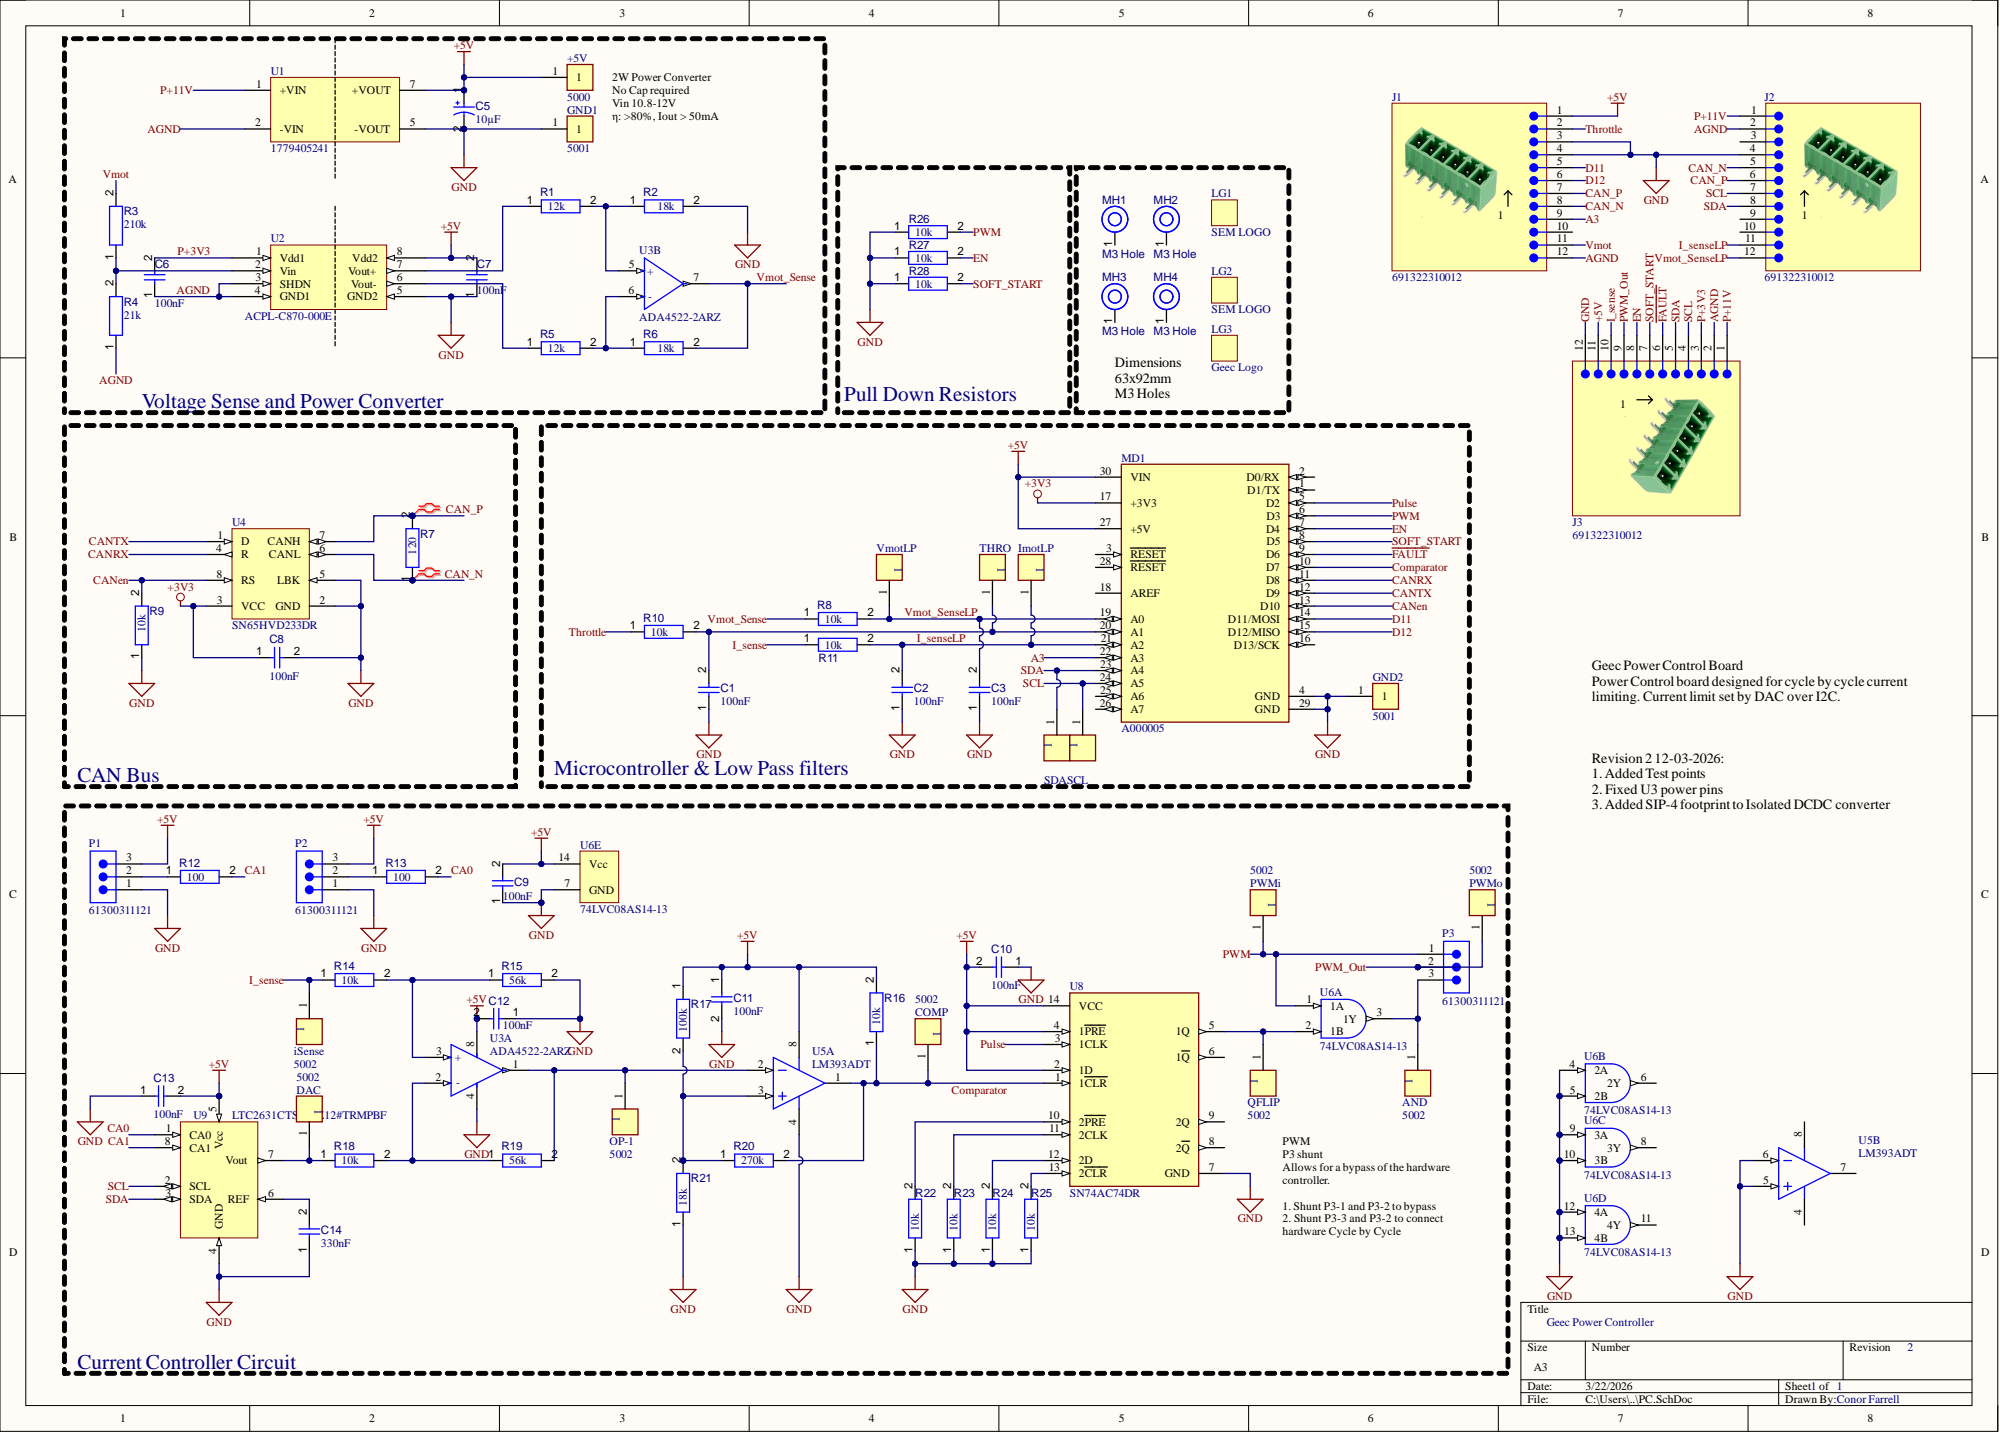
[picture p421: page 1]

AGND
Voltage Sense and Power Converter

Geec Power Control Board
Power Control board designed for cycle by cycle current
limiting. Current limit set by DAC over I2C.

Revision 2 12-03-2026:
1. Added Test points
2. Fixed U3 power pins
3. Added SIP-4 footprint to Isolated DCDC converter

Microcontroller & Low Pass filters

PWM
P3 shunt
Allows for a bypass of the hardware
controller.

1. Shunt P3-1 and P3-2 to bypass
2. Shunt P3-3 and P3-2 to connect
hardware Cycle by Cycle

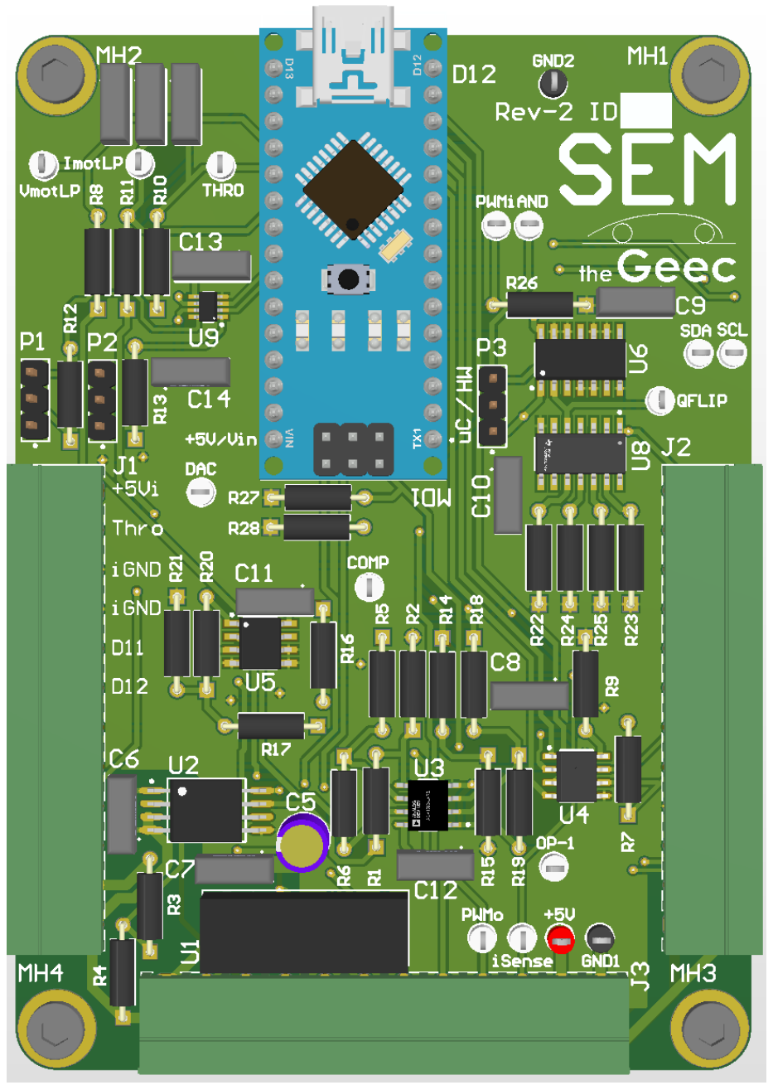
[picture p422: page 2]

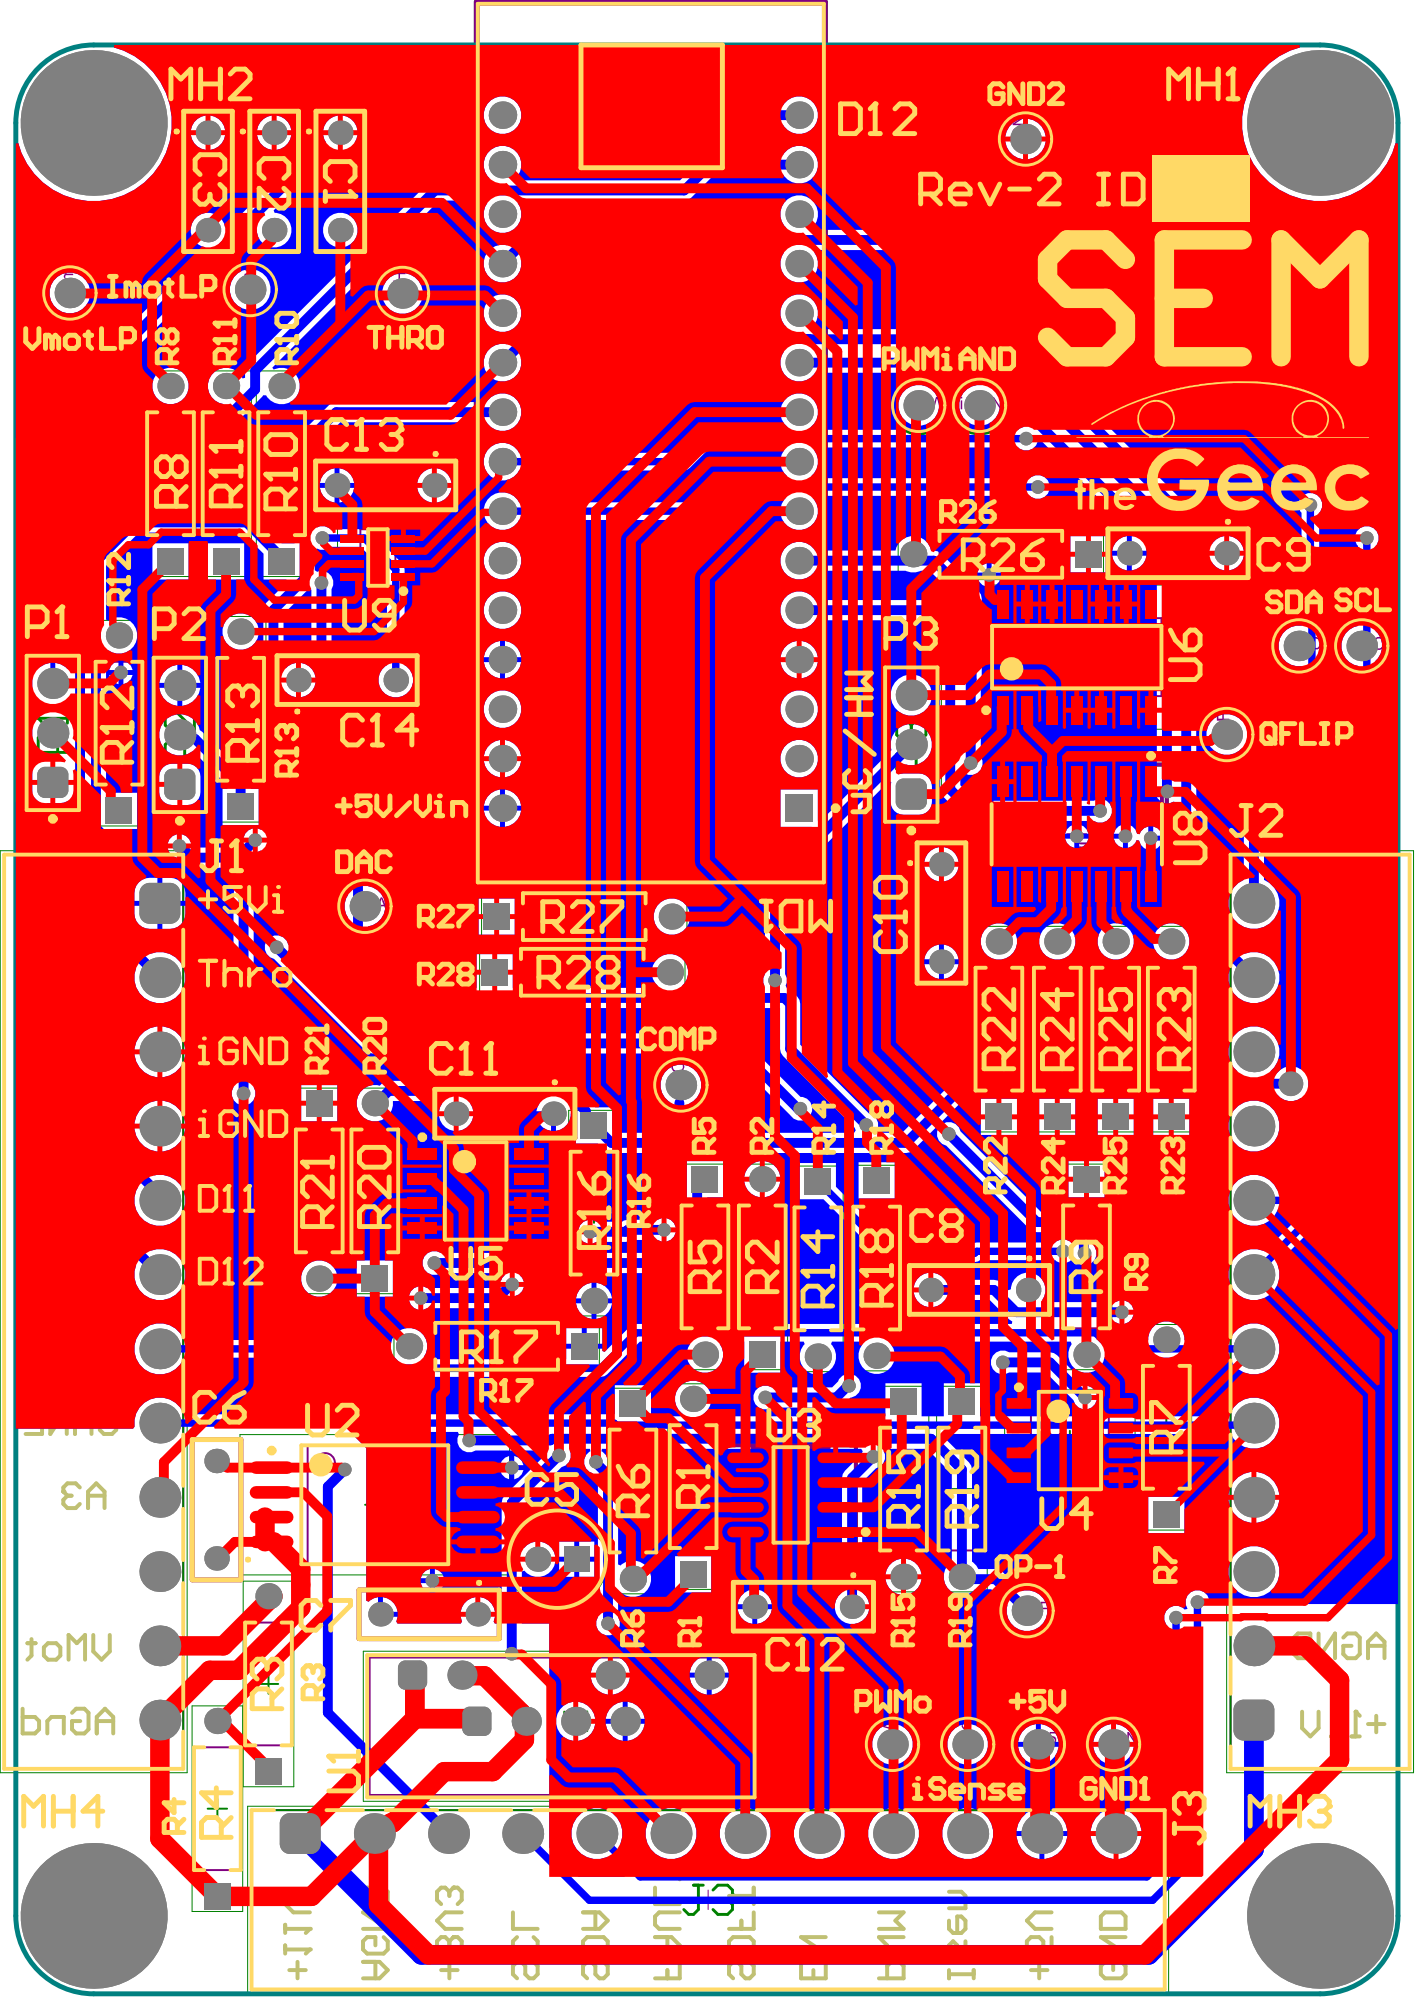
[picture p423: page 3]

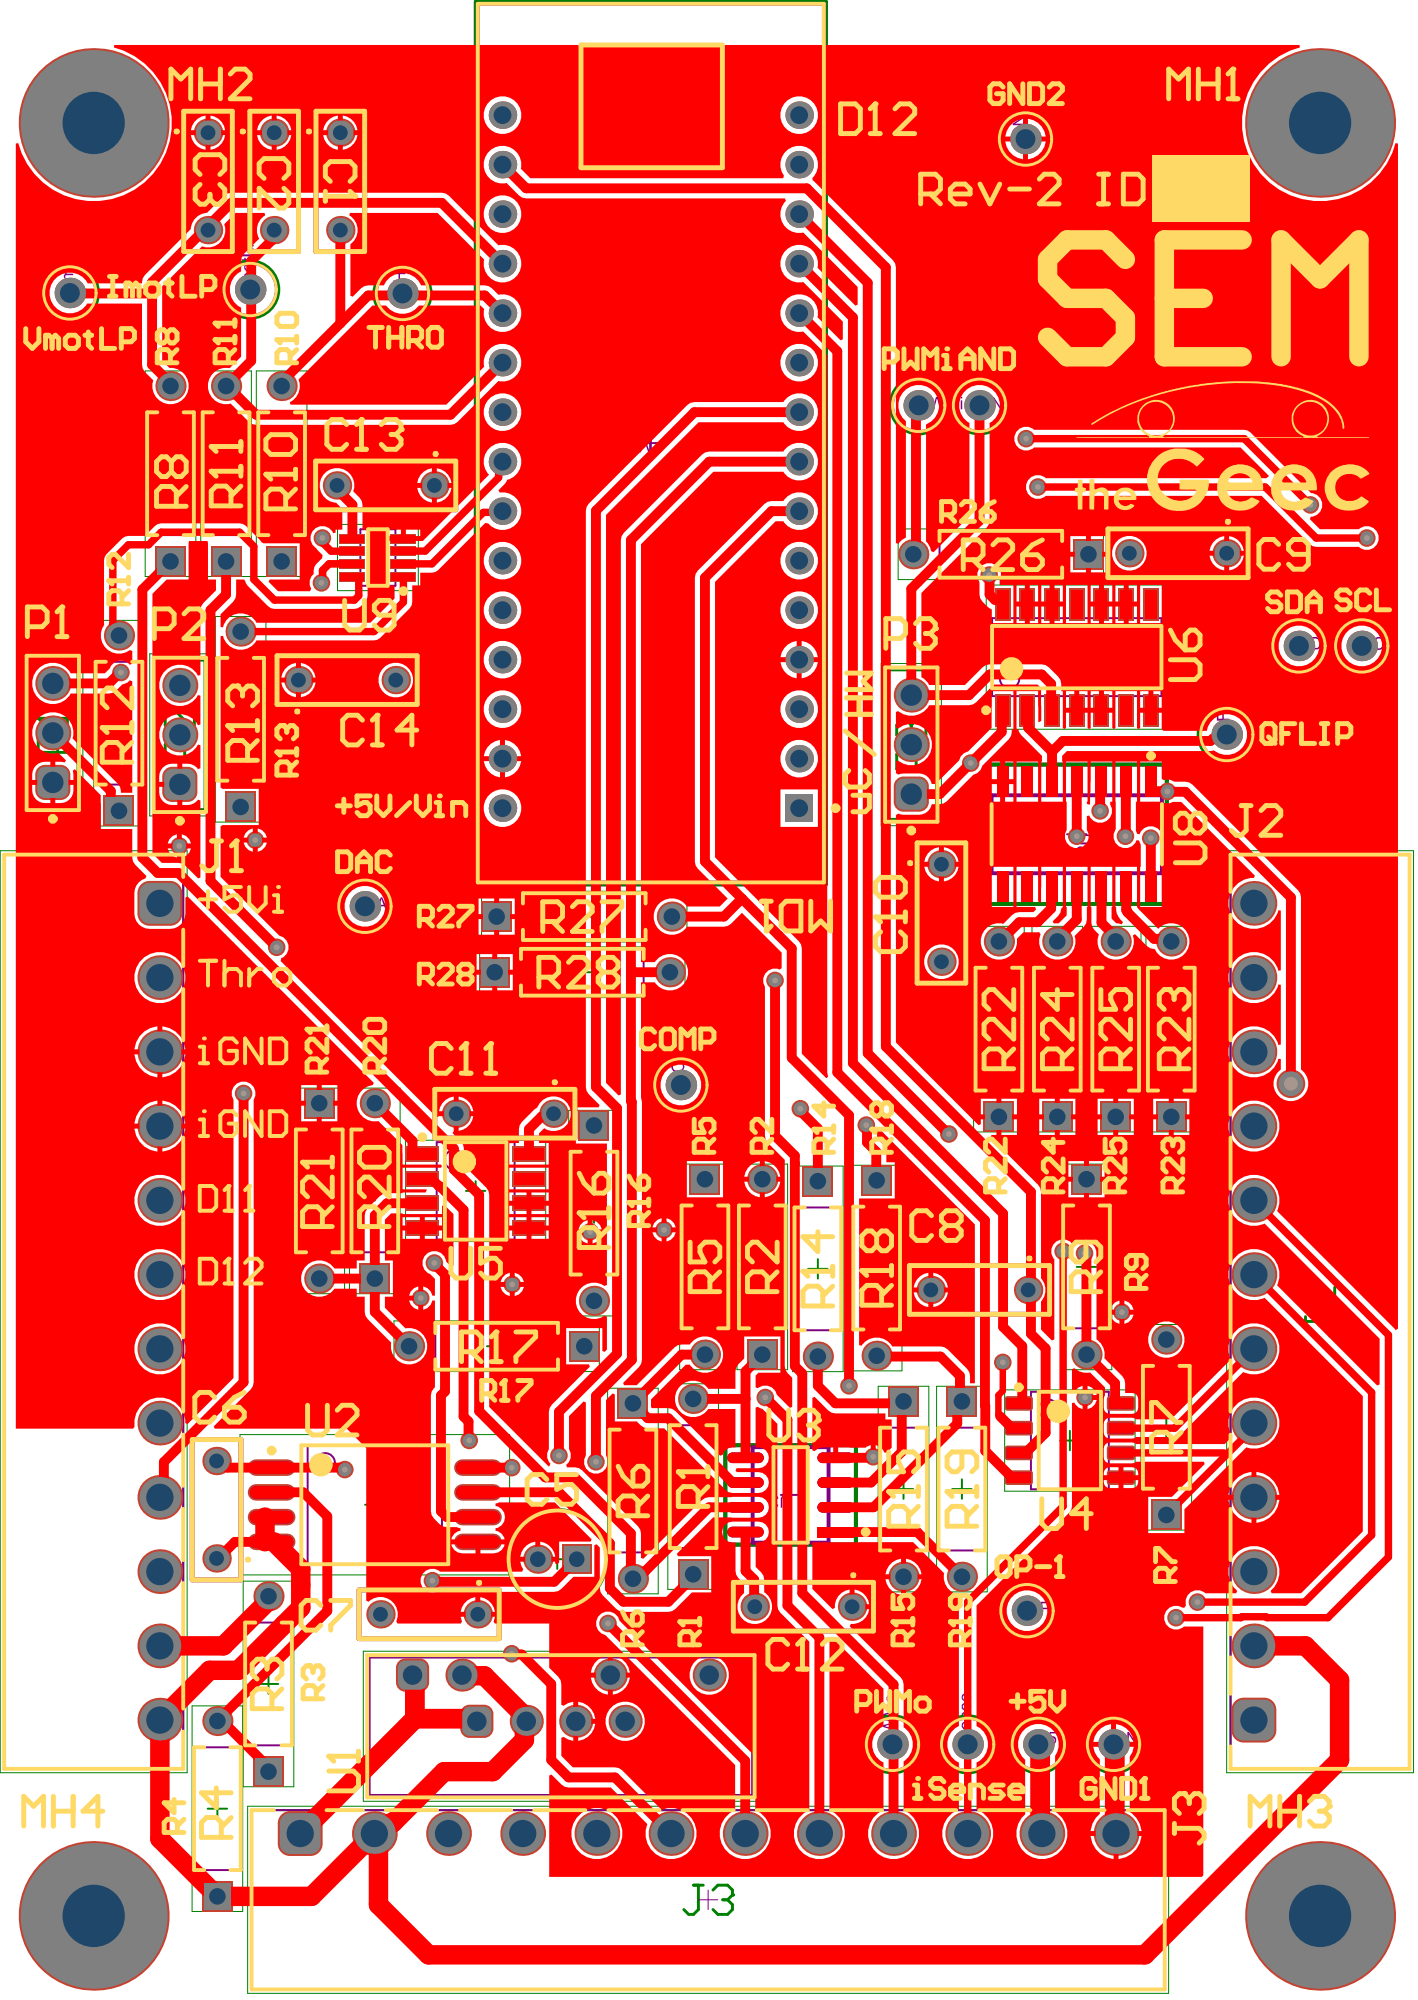
[picture p424: page 4]

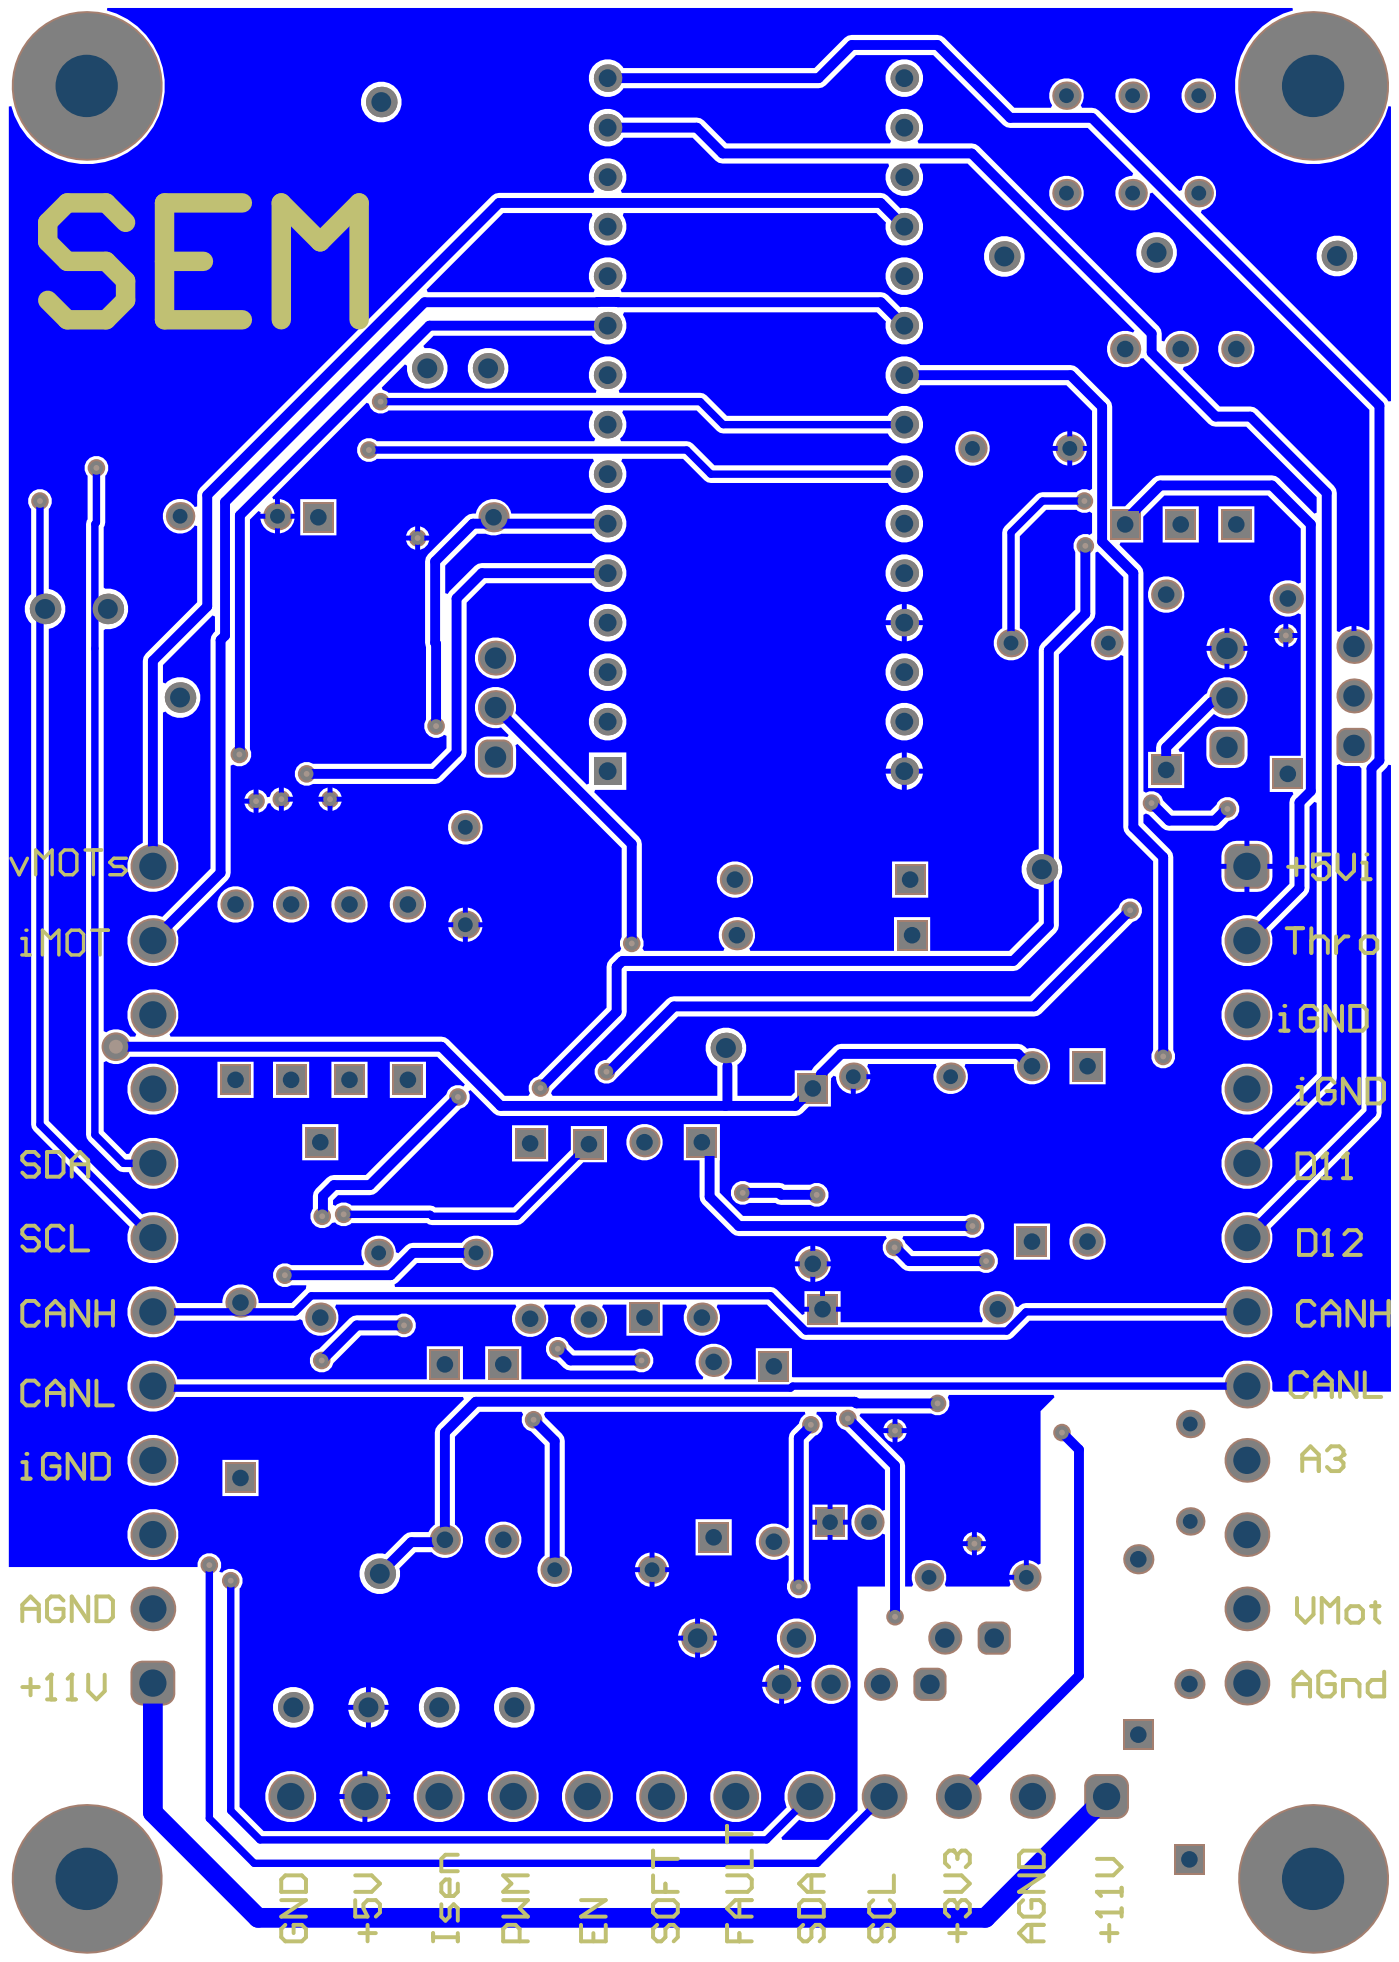
[picture p425: page 5]
