cononinator/GeecPE2526/Orders/BMS_Order.pdf

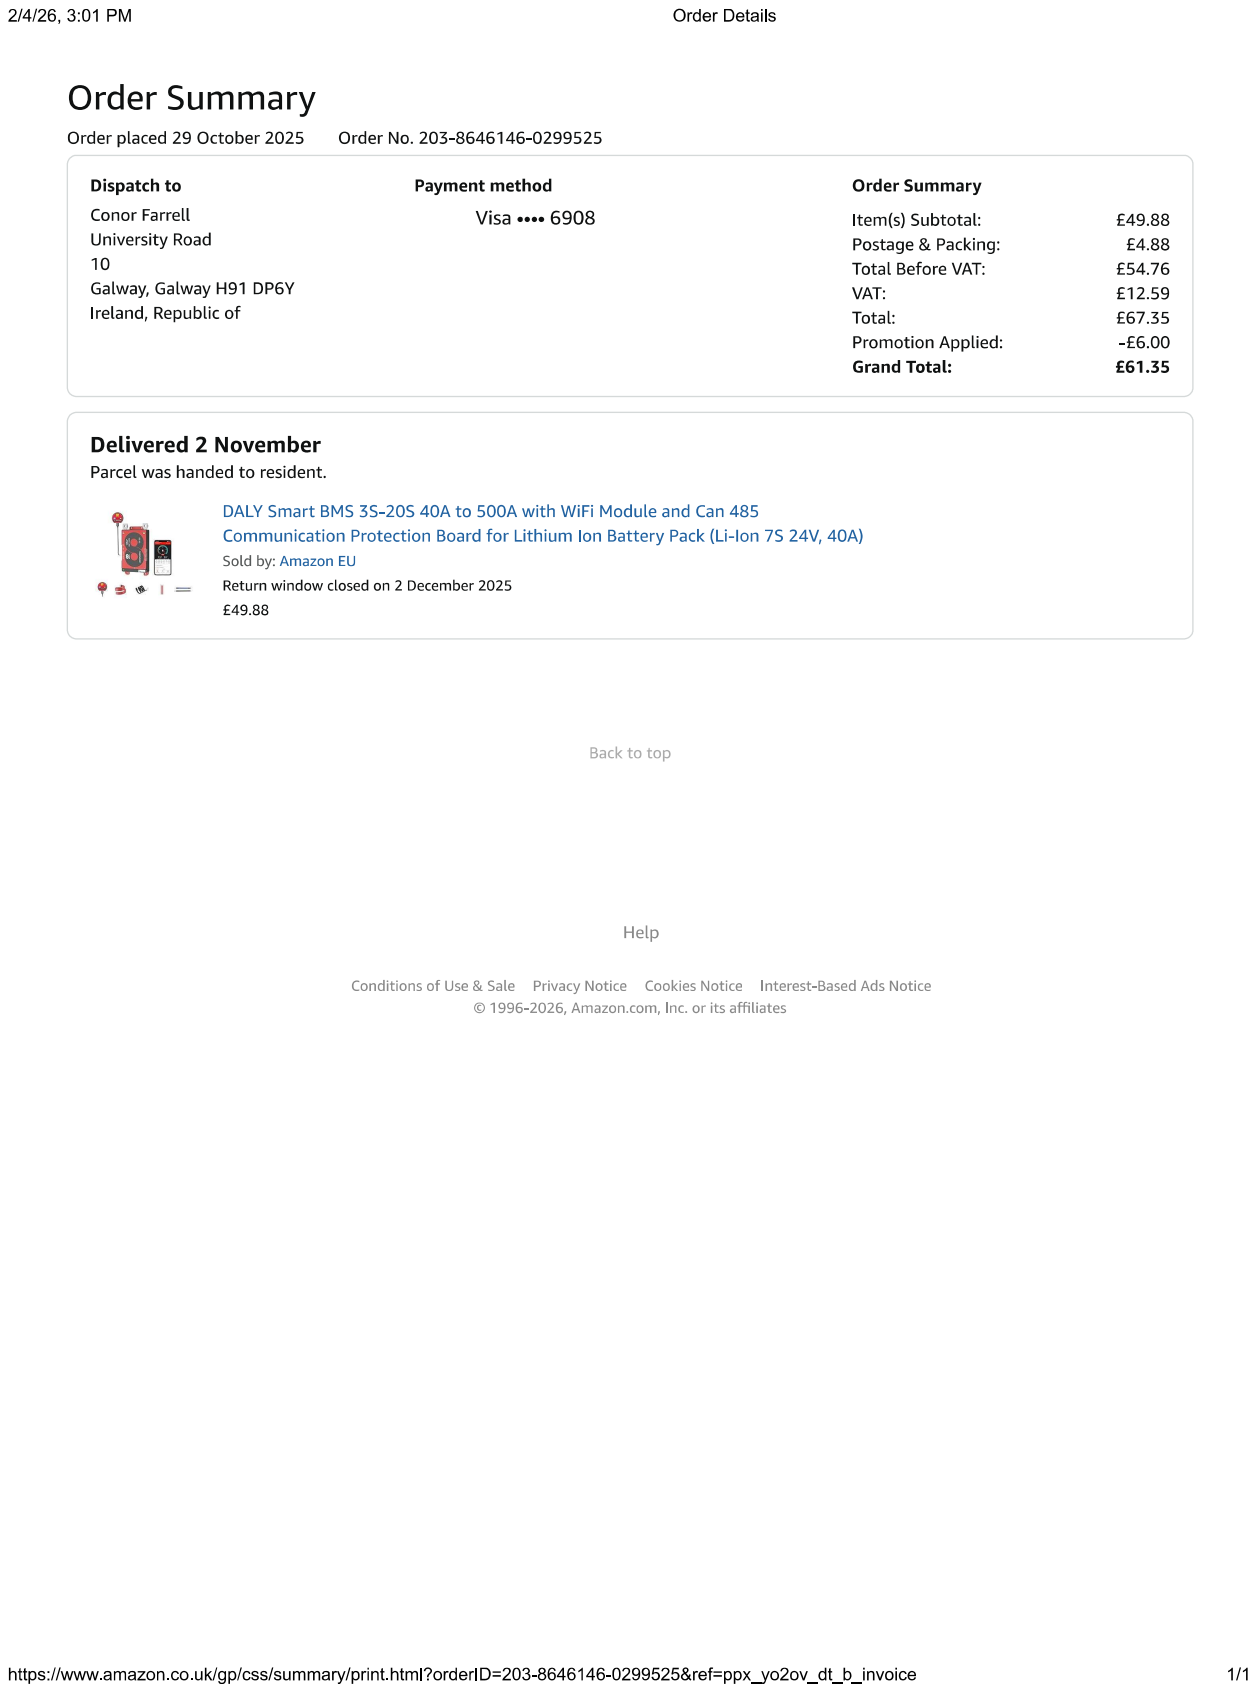
[picture p428: page 1]
