cononinator/GeecPE2526/Orders/Import_Tax.pdf

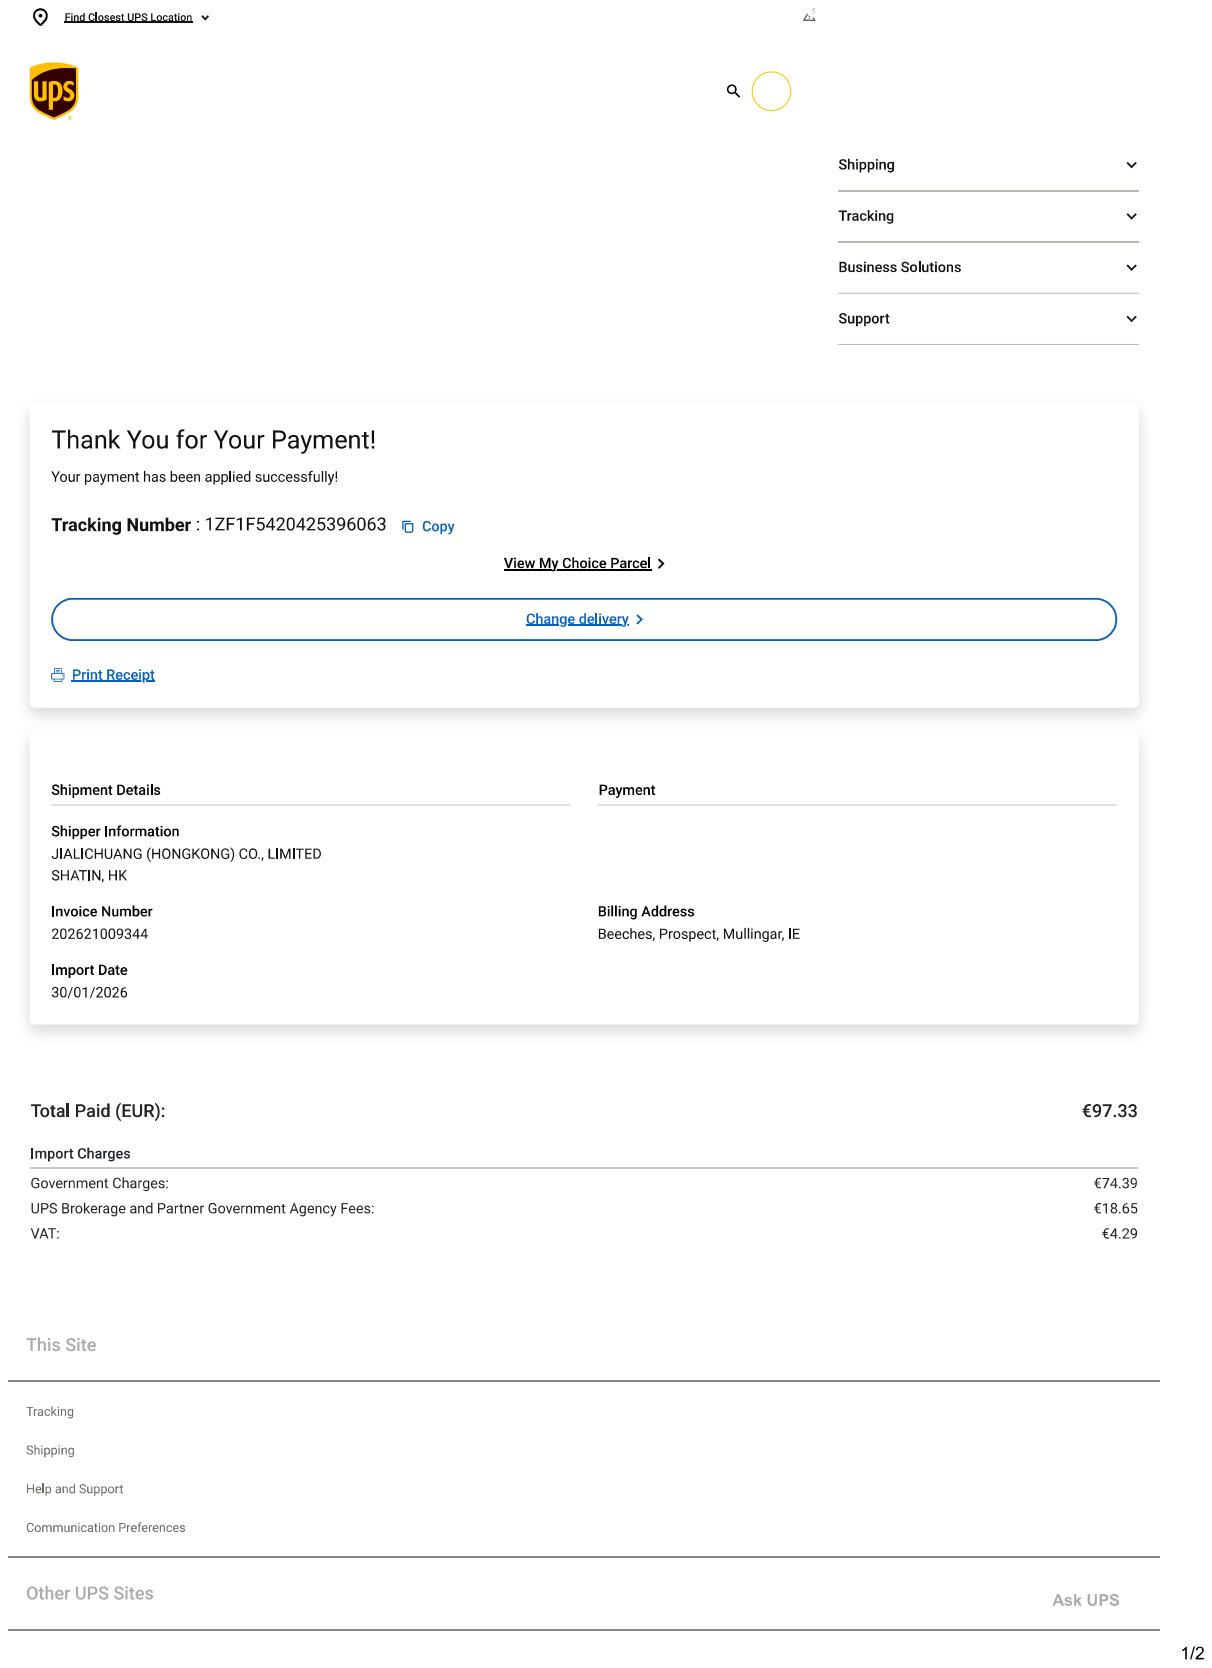
[picture p429: page 1]

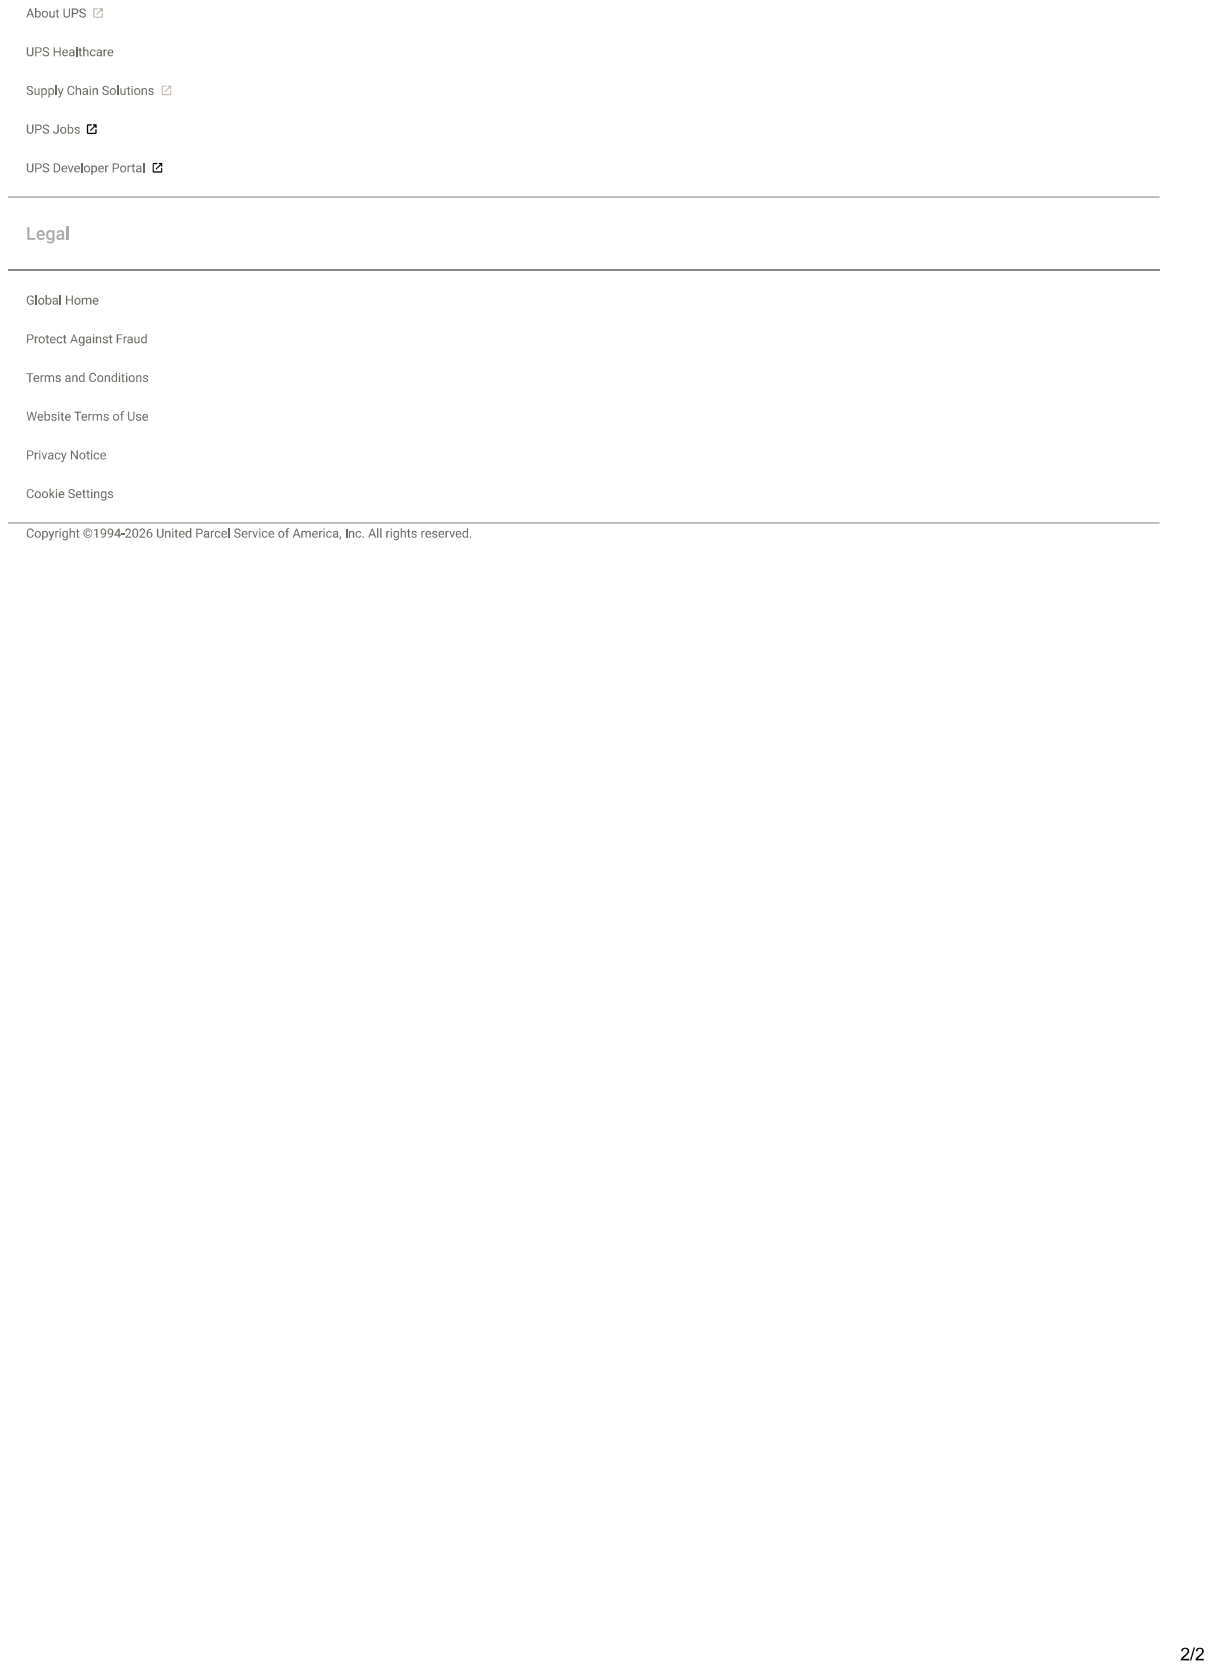
[picture p430: page 2]
