cononinator/GeecPE2526/Altium/NewPowerElec/GeecPE/Project Outputs for GeecPE/AssemblyDrawing.pdf

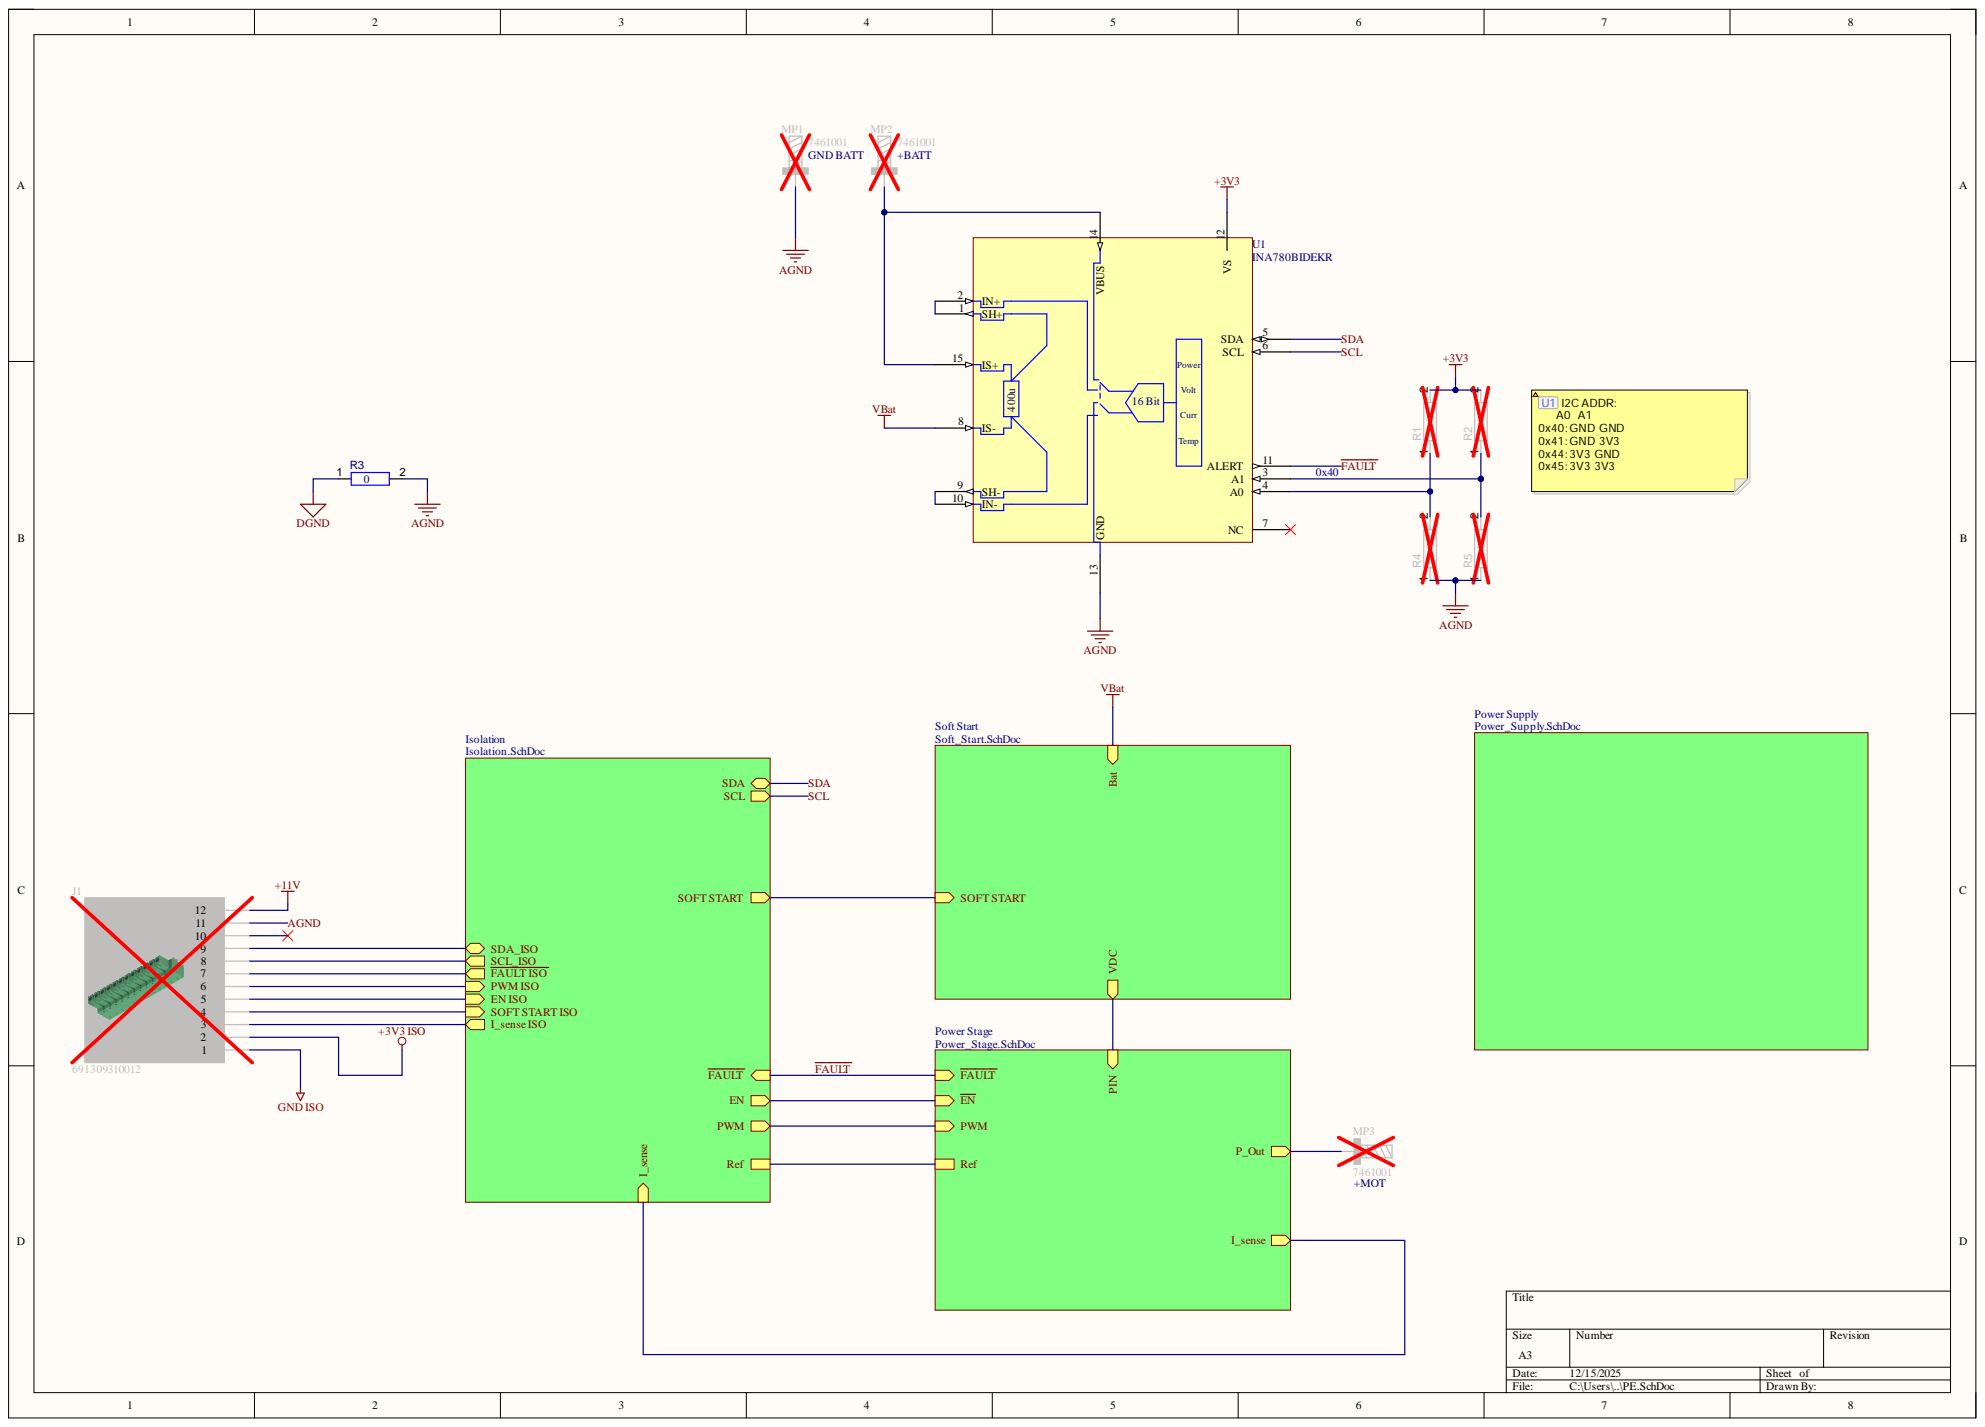
[picture p431: page 1]

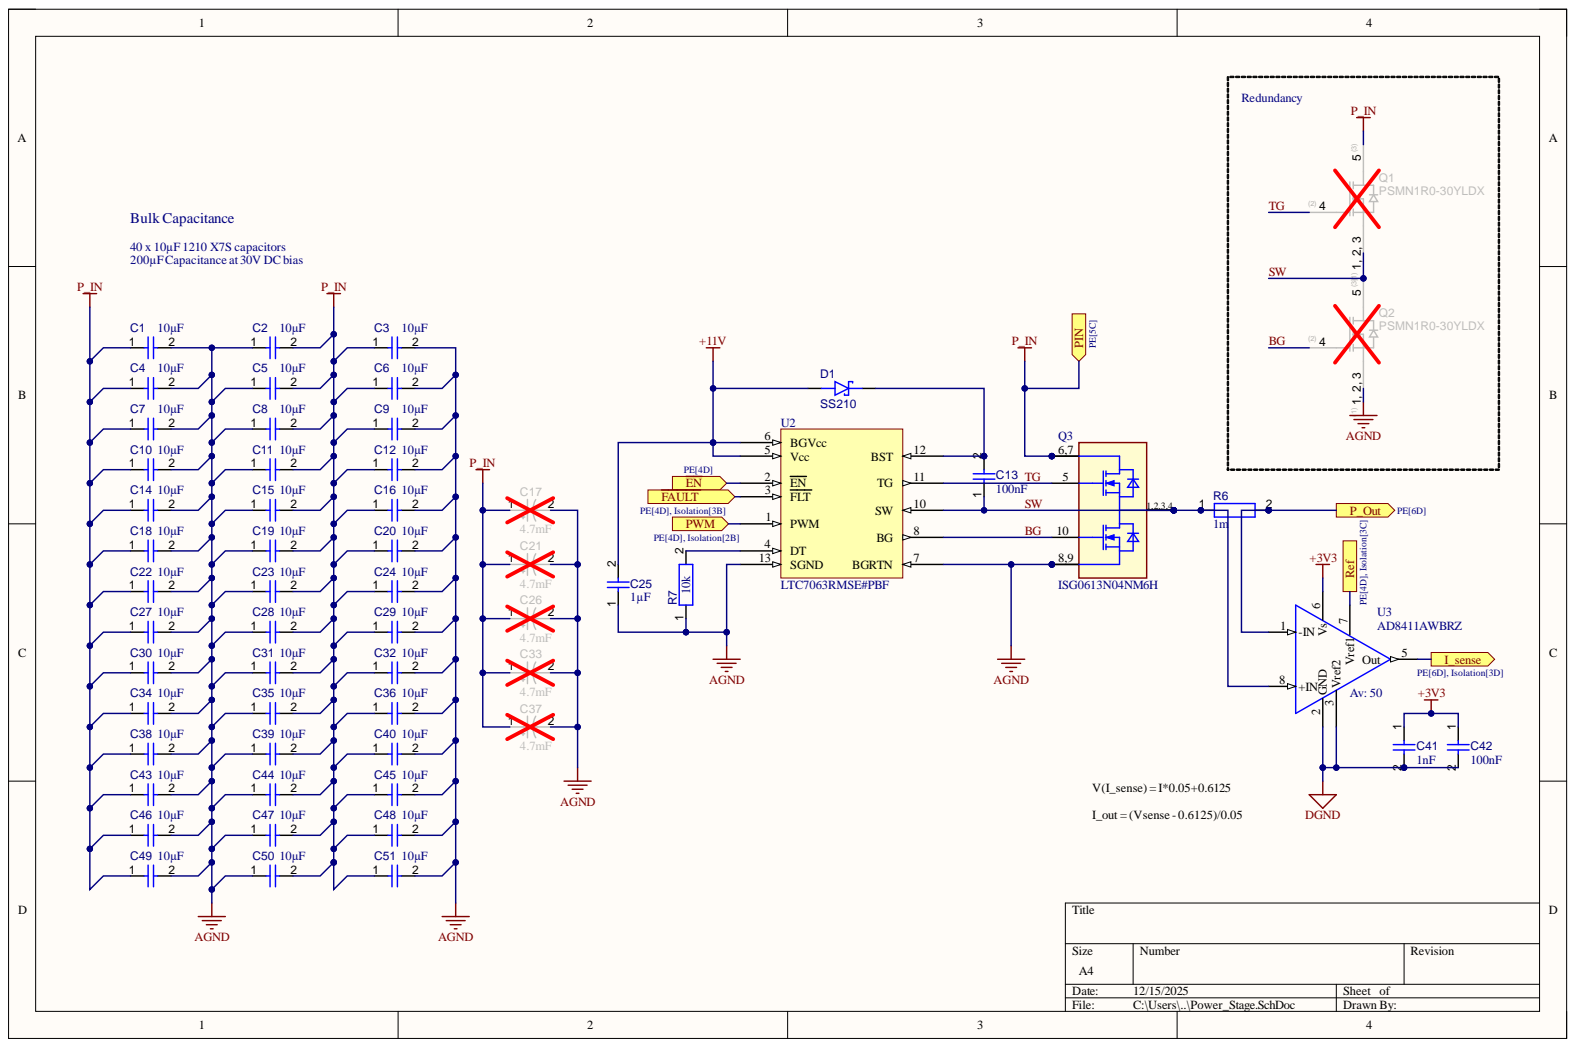
[picture p432: page 2]

WBG 8 10

Siz e A4 | Numb e r | R evisio n

Da te : 12/15/20 2 5 | She et of
File : C:\Use rs\. .\Powe r_S ta g e . S c hD o c | Dr awn B y :

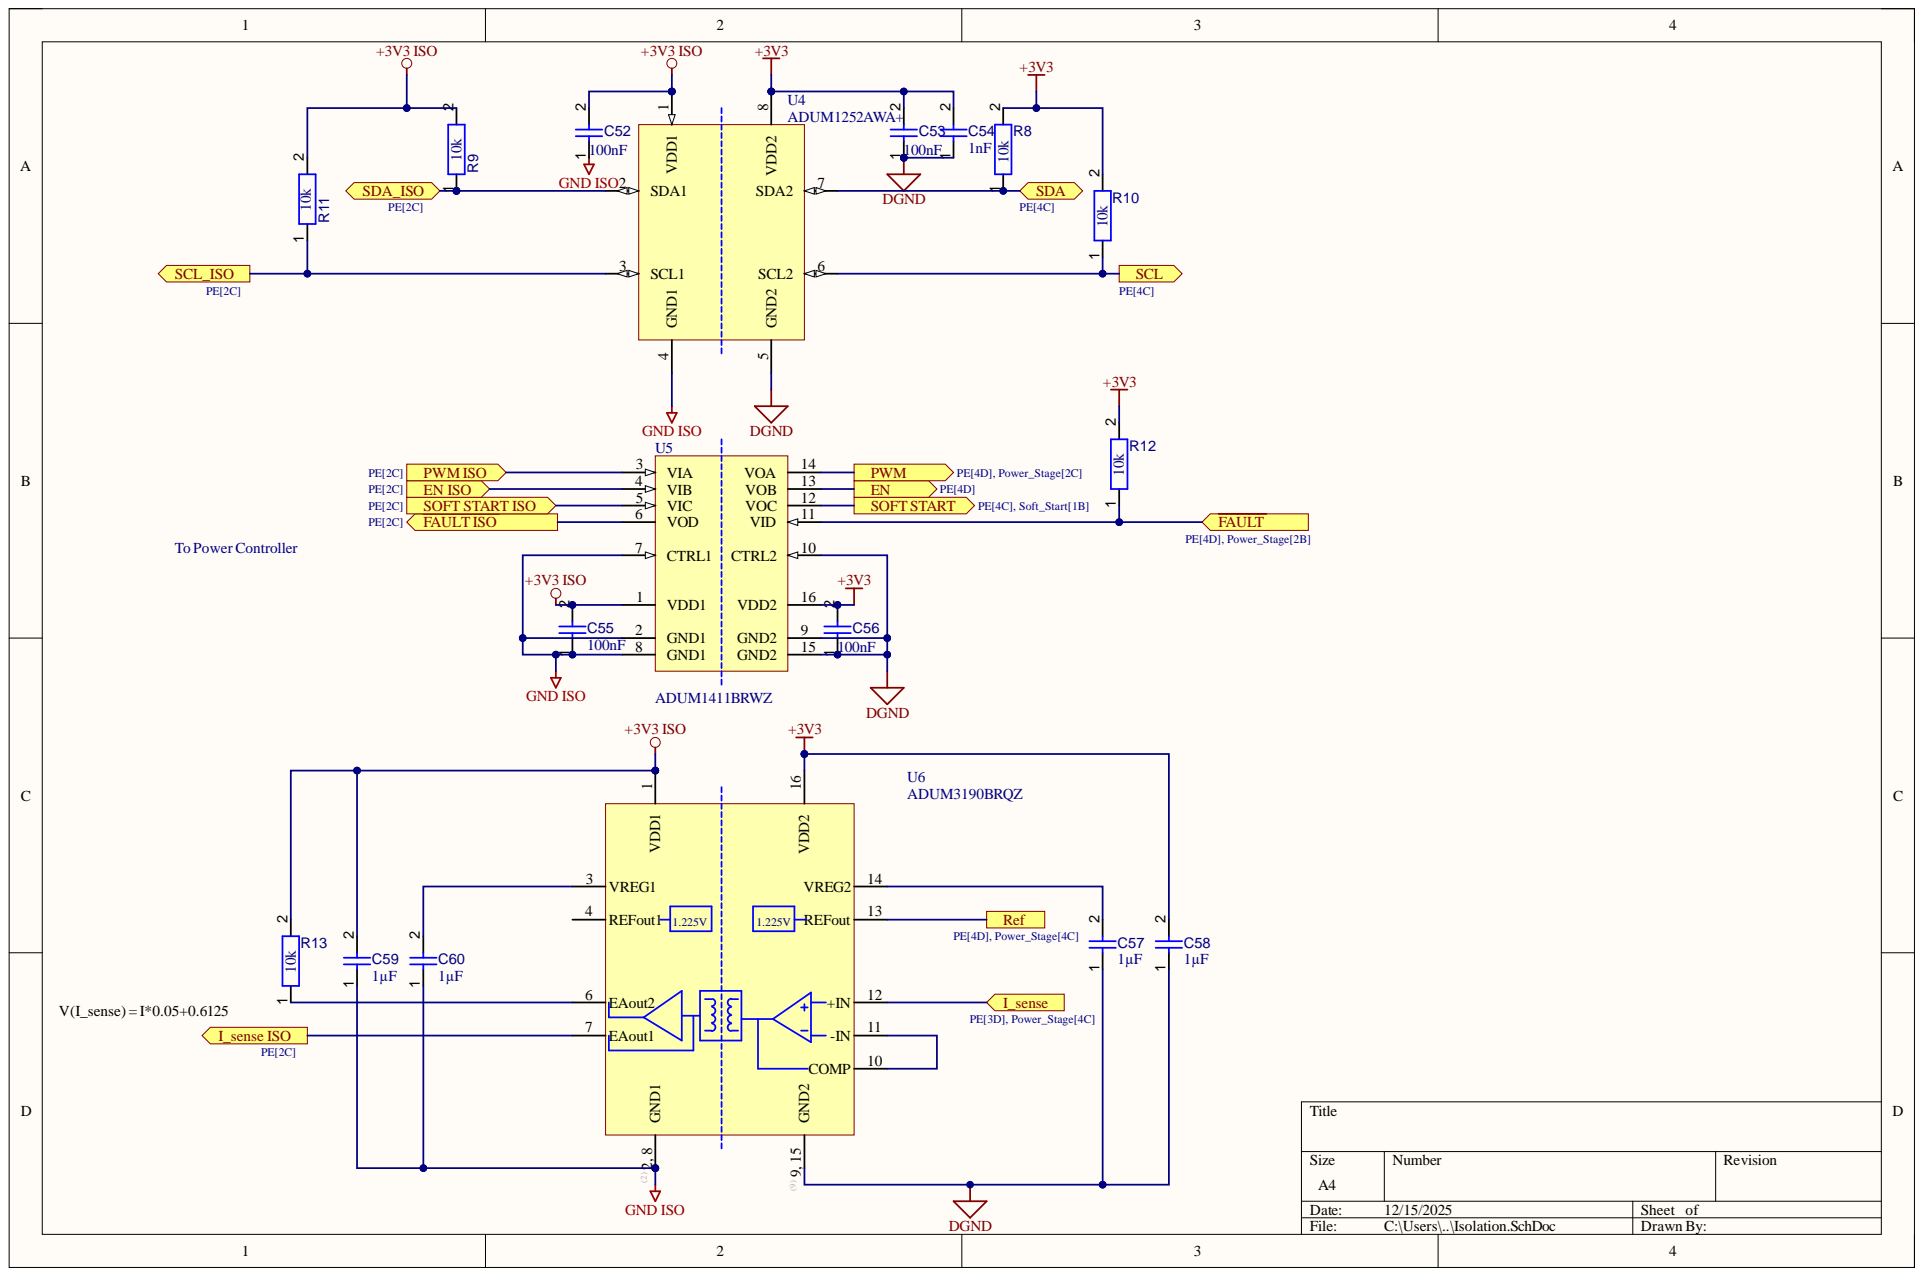
[picture p433: page 3]

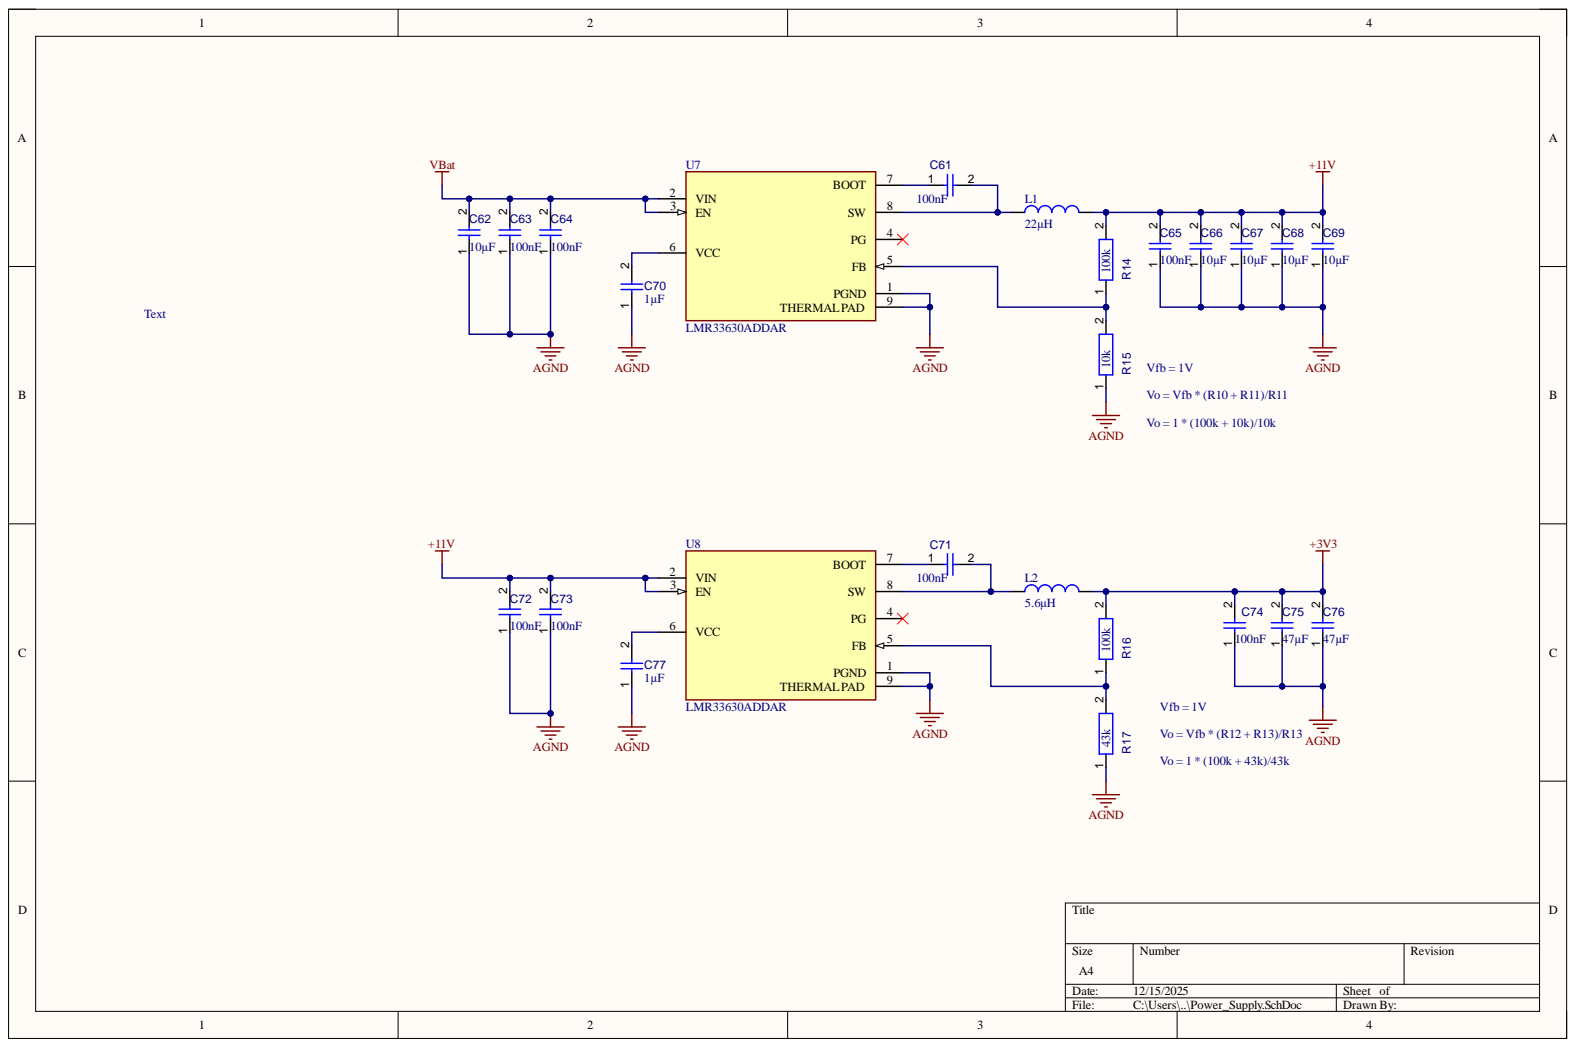
[picture p434: page 4]

Siz e A4 | Numb e r | R evisio n

Da te : 12/15/20 2 5 | She et of
File : C:\Use rs\. .\Powe r_Supp ly. S c hD o c | Dr awn B y :

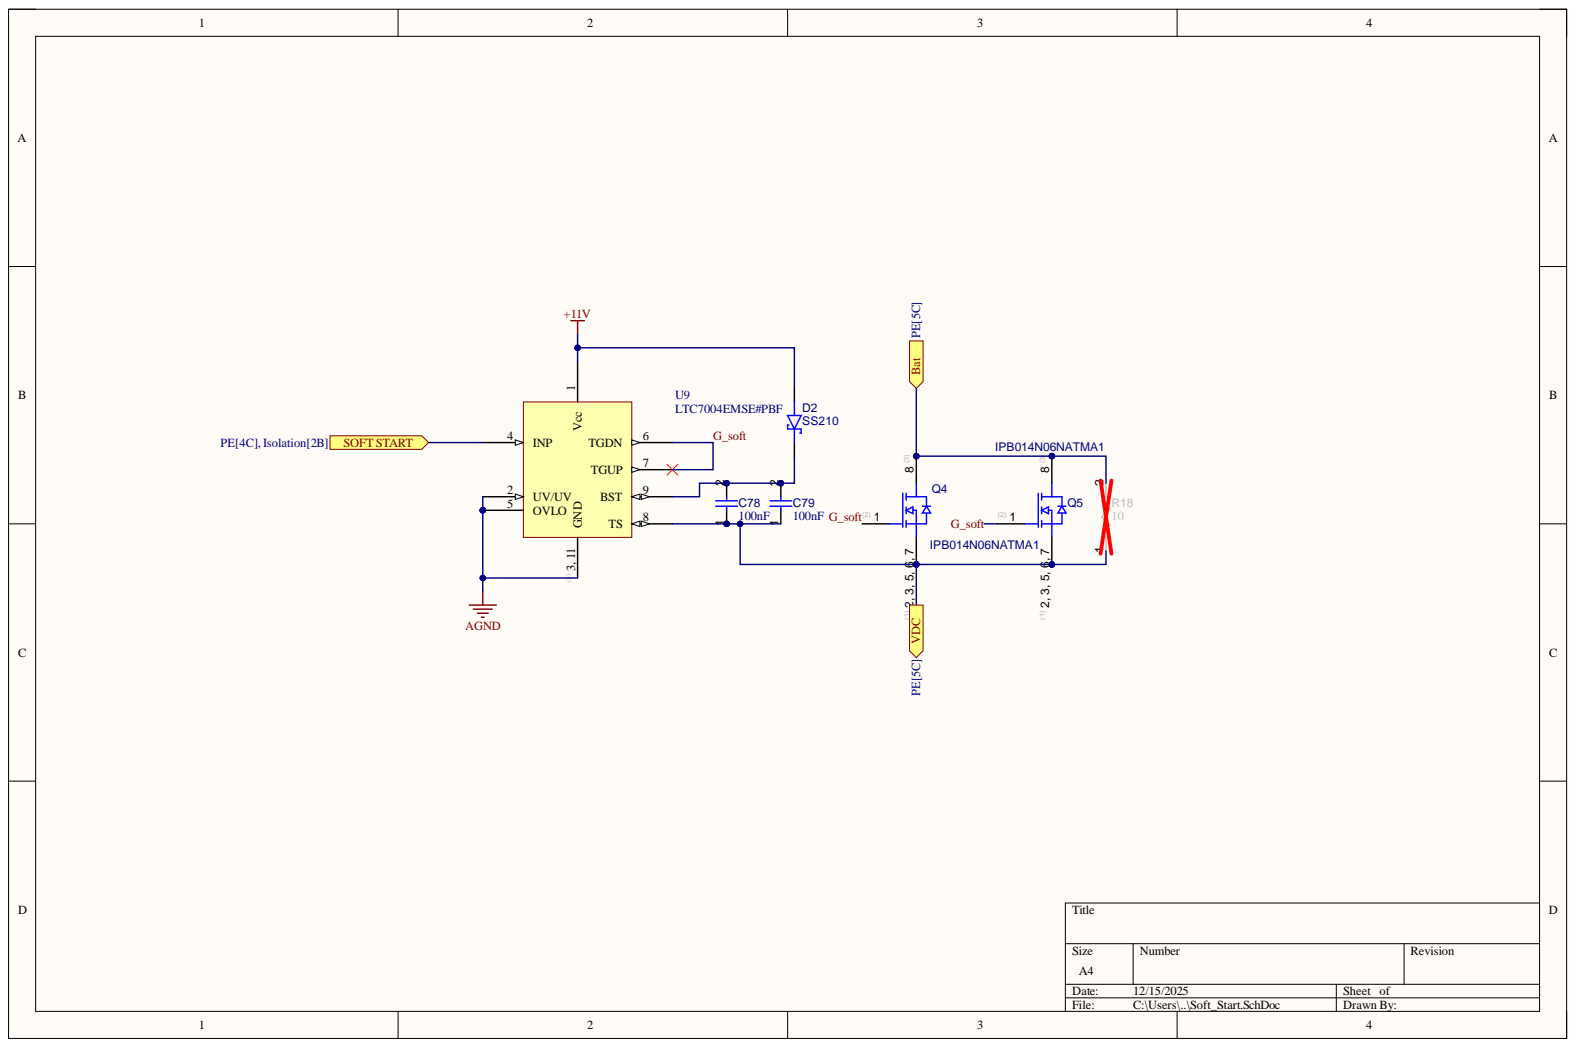
[picture p435: page 5]

Bat PE[5C] VDC PE[5C]

Siz e A4 | Numb e r | R evisio n

Da te : 12/15/20 2 5 | She et of
File : C:\Use rs\. .\Soft_Sta r t . S c hD o c | Dr awn B y :
