cononinator/GeecPE2526/Altium/GeecOisinPE/GeecOisinPE/Project Outputs for GeecOisinPE/Job1.PDF

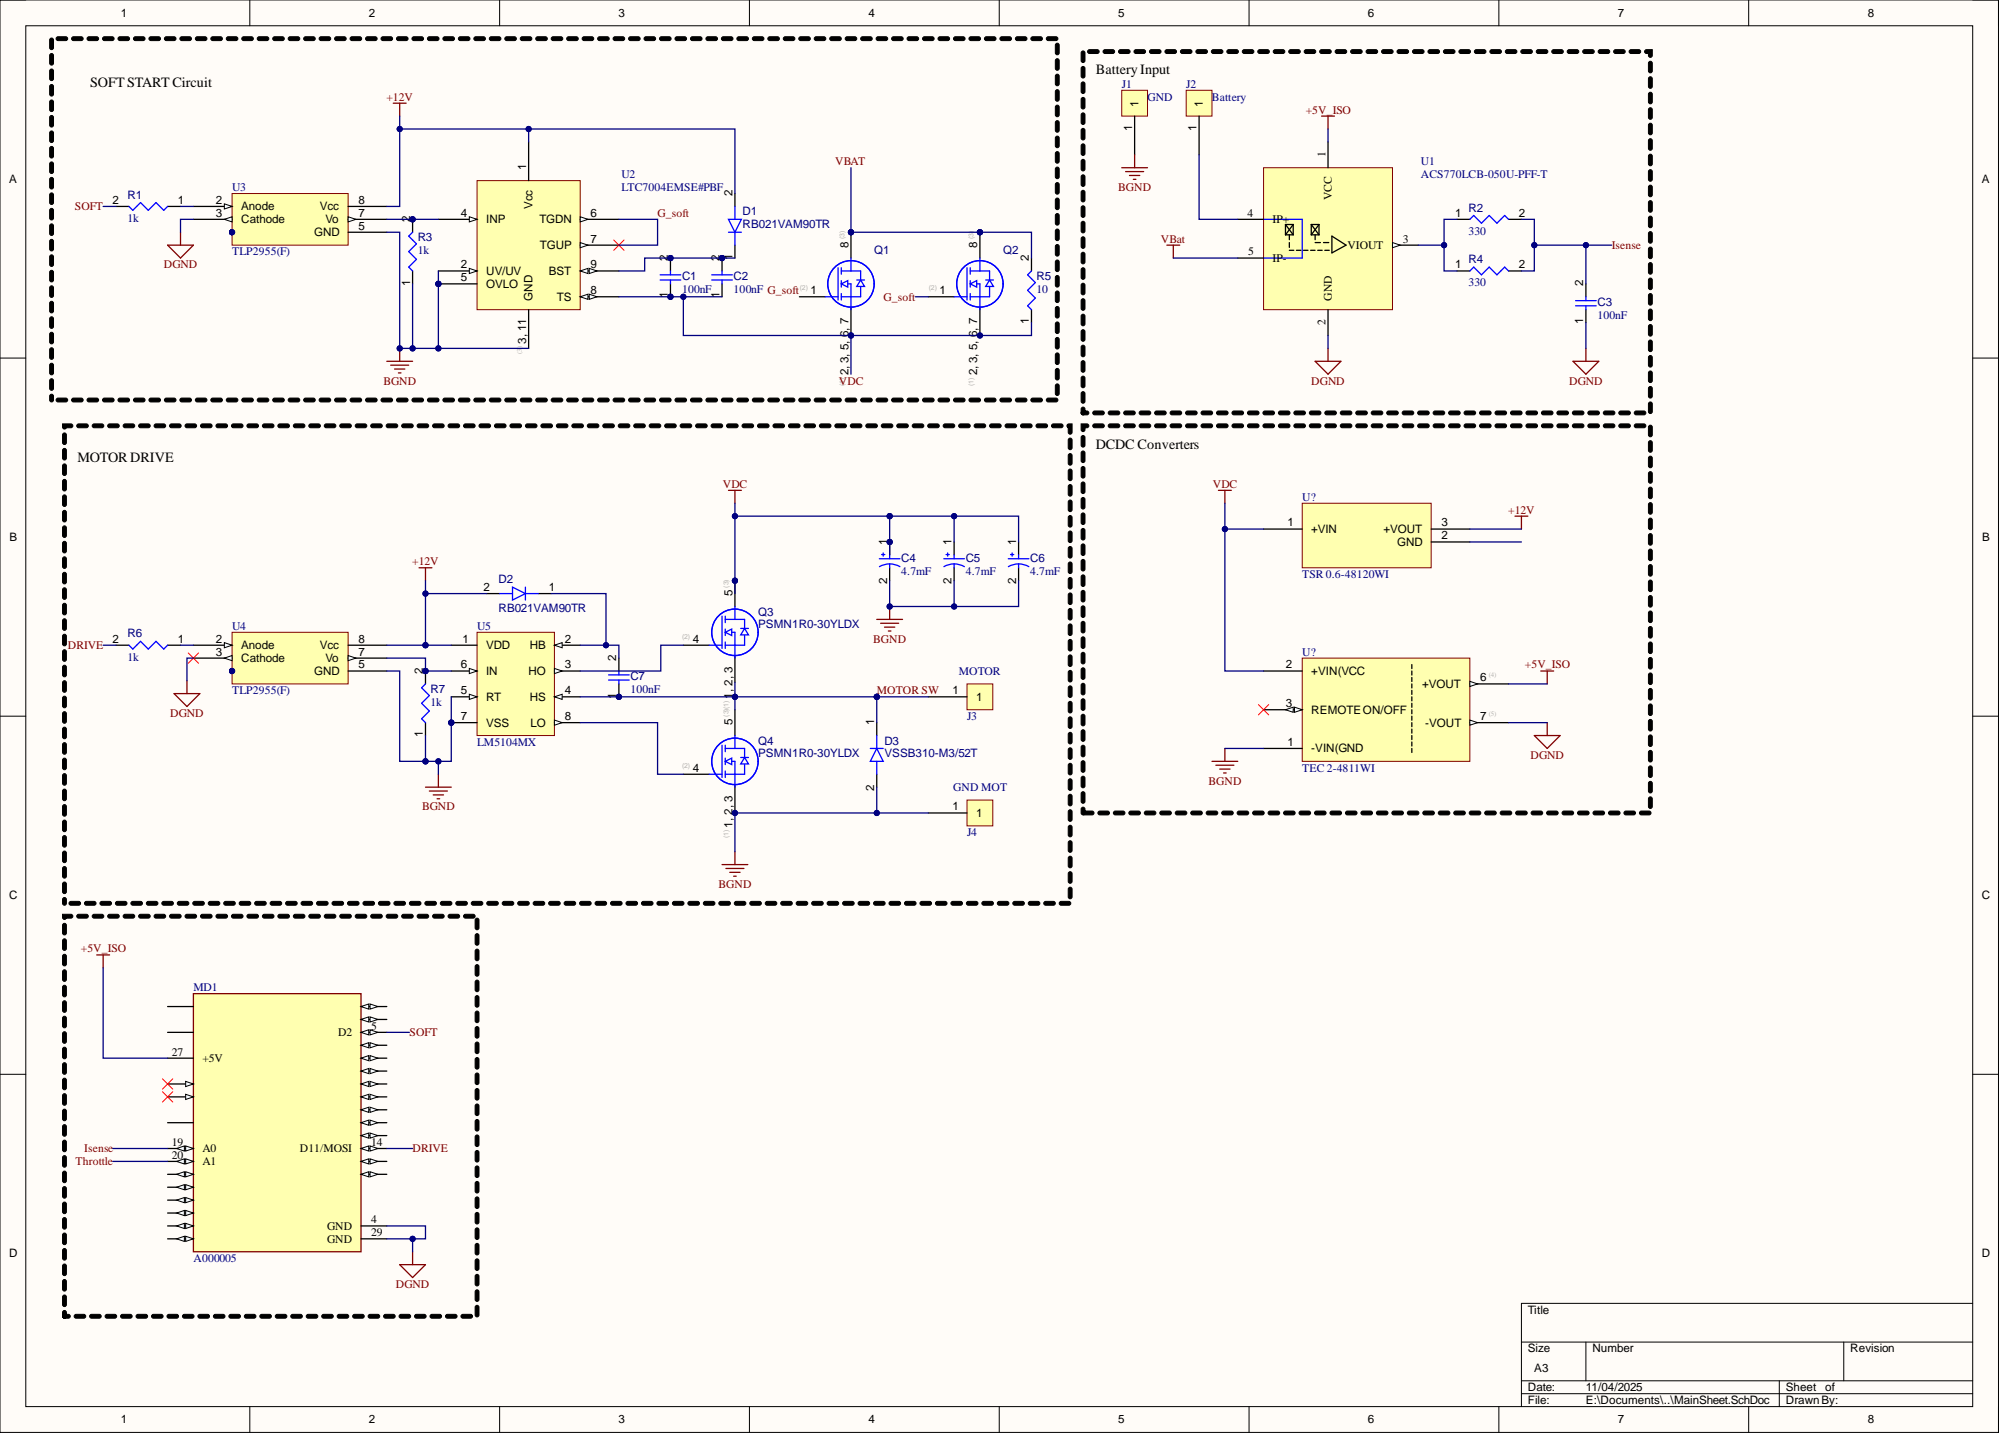
[picture p436: page 1]
