cononinator/GeecPE2526/Simulation/Motor/MotorTest.asc

B1: bv; V=I(V_SENSE_1)*K_torque
B2: bv; V=I(V_SENSE_3)*K_emf*22
B4: bi2; I=I(V_SENSE_2)/22
L1: ind; 72µ
L2: ind; {Mot_inertia}; Rser=0
L3: ind; 100m; Rser=0
R1: res; 0.103
R2: res; 300n
R3: res; 1m
V1: voltage; {I_noload*K_torque}
V2: voltage; PULSE(0 24 0 2 2)
V3: voltage; 2
V_SENSE_1: voltage; 0
V_SENSE_2: voltage; 0
V_SENSE_3: voltage; 0
Named nets: 0
.tran 4
For Model:
Current = speed in rad/s
Voltage = Torque in Nm
Inductor = Inertial Source kgm2
Resistor = viscous friction 
To apply a torque apply a voltage source acting against the Voltage source
 
https://www.precisionmicrodrives.com/ab-025
.param L_MOTOR=72u R_MOTOR=103m K_speed=25.970 K_emf={1/K_speed} Mot_inertia=54u I_noload=0.236 K_torque=38.5m
