cononinator/GeecPE2526/Simulation/Draft7.asc

M1: nmos; BS170
R1: res
V1: voltage; 3.3
V2: voltage; 3.3
V3: voltage
Named nets: 0
