cononinator/GeecPE2526/Simulation/optocoupler.asc

Q1: WL-OCPT_Series_816
R1: res; 510
R2: res; 10k
R3: res; 270k
R4: res; 1Meg
R5: res; 10k
R6: res; 10k
R7: res; 1Meg
R8: res; 1Meg
U1: 4N25
U2: PC817A
V1: voltage; PULSE(0 11 0 1m 1m 100m 1s)
V2: voltage; 3.3
Named nets: 0, Vout, Vin, Vbase, Vcc, Vout2, Vout3
.tran 5
