cononinator/GeecPE2526/Simulation/Draft6.asc

R1: res; 10k
R2: res; 56k
R3: res; 10k
R4: res; 56k
U1: ADA4522
V1: voltage; 5
V2: voltage; PULSE(1 2 1n 100m 100m 10m 220m)
V3: voltage; PULSE(1.1 1.8 1 10n 10n 10 20)
Named nets: 0, 5V, Output, DAC, I_Sense
.tran 2
