cononinator/GeecPE2526/Simulation/Draft5.asc

L1: ind; 70µ; Rser=0.159
R1: res; 10
R2: res; 1m
V1: voltage; PULSE(0 20 0 10n 10n 20u 0.0000714286)
Named nets: 0
.tran 1m startup uic
