cononinator/GeecPE2526/Simulation/Draft4.asc

C1: cap; 4.2m
R1: res; 10
V1: voltage; 29
Named nets: 0
.tran 1 startup
