cononinator/GeecPE2526/Simulation/GeecHalf-Bridge.asc

A1: and; Vhigh=3.3 Vlow=0
A2: dflop; Vhigh=3.3 Vlow=0
A3: inv; Vhigh=3.3 Vlow=0
C1: cap; 0.1µ; V=100 Irms=1.2 Rser=0.0758696 Lser=0 mfg="KEMET" pn="C1206C104K1RAC" type="X7R"
C2: cap; 470µ; V=50 Irms=1.776 Rser=0.0575 Lser=6.978n mfg="Würth Elektronik" pn="860160678030 WCAP-ATLL 13x20" type="Al electrolytic"
C3: cap; 20µ
C6: cap; 1µ
C7: cap; 1µ
C8: cap; 1µ
C9: cap; 1µ
C10: cap; 22p
C11: cap; 30n
C12: cap; 1n
C13: cap; 1n
C16: WCAP-CSGP_25V_DCbias
D1: schottky; MBRS360
D2: TVSdiode; UFZV36B
D3: TVSdiode; UFZV36B
L2: ind; 5n
L5: ind; 70µ; Rser=0.103
R1: res; 1m; tol=1 pwr=3
R2: res; 10
R3: res; 40.2K; tol=1 pwr=0.1
R4: res; 10
R5: res; 51k
R6: res; 0
R7: res; 0
R8: res; 330
R9: res; 10k
R10: res; 100k
R11: res; 10k
R12: res; 10k
R13: res; 10
R14: res; 10
U1: AD8411A
U2: Halfbridge_NMOS
U3: LTC7063
U4: ADuM3190
U6: MAX9095
V1: voltage; 27
V2: voltage; 12
V3: voltage; 3.3
V4: voltage; PULSE(0 3.3 0 1n 1n {1/(FREQ*1.05)} {1/FREQ})
V5: voltage; PULSE(0 3.3 1m 1n 1n 4m)
V7: voltage; PULSE(0.5476 1.5 1.5m 1m 1m 1m 5m)
V9: voltage; PULSE(0 3.3 0 1n 1n 1u {1/FREQ*1.05})
Named nets: 0, Mot, RetMot, Cbulk, +12V, +3V3, Vref1, Vref2, Iout, Clock, D-Q, PWMIN, PWM, CLR, COMP, Iiso2, Iiso, out, Vin, V_Iref
.tran 0 6m 1m startup
.INCLUDE MOSFETS\\OptiMOS6\\OptiMOS6_40V_Halfbridges_LTSpice.lib
.options reltol=1e-3 abstol=5u
.INCLUDE ADuM3190\\ADuM3190B.sub
.param FREQ=30k
Gate DRIVE
OUTPUT & CSA
Gate DRIVE
INPUT
Current Limiting
I_cut: V7 = 0.0492(I_Shunt) + 1.225/2
.meas TRAN E_out INTEG V(out)*I(R2) FROM 1.5ms TO 2.5ms
.meas TRAN E_in INTEG V(Vin)*I(V1) FROM 1.5ms TO 2.5ms
