cononinator/GeecPE2526/Simulation/Draft2.asc

C1: cap; 1µ
C2: cap; 1µ
C3: cap; 1µ
C4: cap; 1µ
R1: res; 12k
R2: res; 10
R3: res; 12k
U1: AD8411A
U2: ADuM3190
V1: voltage; 3.3
V2: voltage; PULSE(10 30 0 50u 50u 0 100u)
Named nets: 0
.tran 10m
.INCLUDE ADuM3190\\ADuM3190B.sub
