cononinator/GeecPE2526/Simulation/Draft3.asc

A1: dflop; Vhigh=3.3 Vlow=0
V1: voltage; PULSE(0 3.3 10u 1n 1n 10n {1/20k})
V2: voltage; PULSE(0 3.3 0 1n 1n 1u {1/20k})
V3: voltage; 3.3
Named nets: 0
.tran 100u
