cononinator/GeecPE2526/Simulation/FETTest.asc

R1: res; 10
R2: res; 10
R3: res; 10
R4: res; 2
R5: res; 2
R_VIN_Ser: res; 1m
U1: Halfbridge_NMOS
V1: voltage; PULSE(0 34 100u 10n 10n 100u {200u-20n})
V2: voltage; PULSE(0 10 0 10n 10n 100u {200u-20n})
V3: voltage; 24
Named nets: 0
.tran 1m
.INCLUDE MOSFETS\\OptiMOS6\\OptiMOS6_40V_Halfbridges_LTSpice.lib
.options reltol=1e-3 abstol=1u
