cononinator/GeecPE2526/Simulation/GaN.asc

C1: cap; 100n
C2: cap; 5m
L1: ind; 72µ
R1: res; 0.75
U2: EPC23101_model
U4: EPCGaN; EPC2001
V1: voltage; 0.5
V2: voltage; 5
V3: voltage; 27.8
X1: PWMGen
Named nets: Vin, 0, DRIVE
.inc EPC\\EPC23101\\EPC23101_model.net
.inc EPC\\EPCGaNLibrary.lib
.tran 0 30m 10m
