cononinator/GeecPE2526/Simulation/LM5104.asc

C1: cap; 0.1µ; V=6.3 Irms=1.2 Rser=0.0758696 Lser=0 mfg="KEMET" pn="C1206C104K9RAC" type="X7R"
D1: schottky; RB021VAM90
R1: res; 5.6k
R2: res; 10k
U1: lm5104
U2: PSMN1R2-30YLD
U3: PSMN1R2-30YLD
V1: voltage; 12
V2: voltage; 27.8
V3: voltage; 0.25
X1: PWMGen
Named nets: 0, In, +12V, Supply, Out
.tran 10m
