cononinator/GeecPE2526/Simulation/PWMTest.asc

R1: res; 10k
R2: res; 10k
V1: voltage; 0.5
X2: PWMGen
Named nets: 0, PWMH, PWML
.tran 0 1ms 0
