cononinator/GeecPE2526/Simulation/Soft Start/LT4256-1.asc

C1: cap; 47n
C2: cap; 10n
C3: cap; 4700µ; V=50 Irms=3.355 Rser=0.015 Lser=9.7n mfg="Würth Elektronik" pn="860010683032 WCAP-ATG8 22x41" type="Al electrolytic"
C4: cap; .1µ
Q1: nmos; IPB016N06L3
R1: res; 51k
R2: res; 10k
R3: res; 10
R4: res; 100
R5: res; 1.5m
R6: res; 36.5K
R7: res; 4.02K
R8: res; 27K
R9: res; 1
Rload: res; 100k
S1: sw
U1: LT4256-1
V1: voltage; PWL(0 0 2.7m 0 2.701m 29)
V2: voltage; PWL(0 0 270m 0 270.1m 5)
Named nets: 0
.tran 500m startup
.model SW SW(Ron=1m Roff=100Meg Vt=3)
