cononinator/GeecPE2526/Simulation/Soft Start/LT4363-1.asc

C1: cap; 47n
C2: cap; 6.8µ
C3: cap; 300µ
C4: cap; 0.1µ
D1: zener; 1N5371B
Q1: nmos; IRLR2908
R1: res; 10
R2: res; 15m
R5: res; 1K
R6: res; 604K
R7: res; 23.2K
Rload: res; 100
U1: LT4363-1
V1: voltage; EXP(0 60 200m 10m 205m 150m)
V2: voltage; 40
Named nets: 0, IN, OUT, Fault, Timer
.tran 2 startup
