cononinator/GeecPE2526/Simulation/Soft Start/LTC4380-4.asc

C1: cap; 47n
C2: cap; 0.2µ
C4: cap; .1µ
Cload: cap; 4.7m
D1: zener; 1N5371B
Q1: nmos; IPB011N04N
R1: res; 10
R2: res; 1m
R3: res; 10K
R4: res; 100
R5: res; 200k
R6: res; 1
R7: res; 51k
Rload: res; 100k
S1: sw
U1: LTC4380-4
V1: voltage; PWL(0 0 2.7m 0 2.701m 29)
V2: voltage; PWL(0 0 270m 0 270.1m 5)
V3: voltage; PULSE(4 0 0.5 10n 10n .4 1)
Named nets: 0, OUT, IN
.tran 1
.model SW SW(Ron=1m Roff=100Meg Vt=3)
