cononinator/GeecPE2526/Simulation/Soft Start/LTC7004.asc

C1: cap; 4700µ; V=63 Irms=3.43 Rser=0.0248 Lser=20.343n mfg="Würth Elektronik" pn="861020786024 WCAP-AIG5 35x30" type="Al electrolytic"
C2: cap; .1µ
D1: diode; RF071MM2S
M1: nmos; IPB019N06L3
R1: res; 100k
R2: res; 10
U1: LTC7004
V1: voltage; 10
V2: voltage; PULSE(0 8 200m 10n 10n 50m 500m)
V3: voltage; 29
Named nets: 0, OUT, IN
.tran 500m startup
