cononinator/GeecPE2526/Simulation/EPC/Example EPC2619.asc

C1: cap; 10µ
L1: ind; 1.5µ; Rser=1u
L2: ind; {CSI}
L3: ind; {CSI}
R1: res; 0.0007
R1d: res; 1µ
R1g: res; 1µ
R2: res; 1m
R2d: res; 1µ
R2g: res; 1µ
R5: res; 0.00049
R11: res; 0.5
R11gd: res; {RGD_PD}
R12: res; 1.8
R12gd: res; {RGD_PU}
R21: res; 0.5
R21gd: res; {RGD_PD}
R22: res; 1.8
R22gd: res; {RGD_PU}
RLoad: res; {Vin*dutyCycle/Iout}
Rq1: res; 0.00197
Rq2: res; 0.00036
S1: sw; MYSW
S2: sw; MYSW
S11: sw; GD_PD
S12: sw; GD_PU
S21: sw; GD_PD
S22: sw; GD_PU
U1: EPCGaN; EPC2619; Temp={Tj1}
U2: EPCGaN; EPC2619; Temp={Tj1}
V1: voltage; {Vin}
V3: voltage; {CSI_DISABLE}
V5: voltage; {CSI_DISABLE}
V15: voltage; 5
V16: voltage; PULSE(0 5 0 1n 1n {dutyCycle/freq} {1/freq})
V25: voltage; 5
V26: voltage; PULSE(0 5 {dutyCycle/freq+tdead} 1n 1n {1/freq-dutyCycle/freq-2*tdead} {1/freq})
Named nets: Vsw, Vdc, VG_HS, VG_LS, 0, Vout, U1_S, U2_S, IN_HS, IN_LS, VHS, VLS, Vsw1
.tran 0 0.6ms {0.6m-10/{freq}}
.param Vin=48 dutyCycle=0.25 Iout=16 freq=500000 tdead=10n Tj1=100
.temp {Tj1}
.ic V(Vout)={Vin*dutyCycle} V(VG_HS,Vsw)=0 V(VG_LS)=0 V(Vdc)=Vin  I(L1)=Iout V(C2)=5
.param RGD_PU=0.7 RGD_PD=0.4
*uP1966e driver
.option noopiter
.param CSI=100pH
.param CSI_DISABLE=0
.model MYSW SW(Ron=1m Roff=1Meg Vt=0.5 Vh=0.1)
.meas TRAN Phs AVG V(VG_HS,U1_S)*I(R1g)+V(Vdc,U1_S)*I(R1d)
.meas TRAN Pls AVG V(VG_LS,U2_S)*I(R2g)+V(Vsw,U2_S)*I(R2d)
.meas Pgd_hs AVG -V(IN_HS,Vsw)*I(V15)
.meas Pgd_ls AVG -V(IN_LS)*I(V25)
.meas Ptot param Phs+Pgd_hs+Pls+Pgd_ls
.meas Pin AVG -V(Vdc)*I(V1)
.meas Pout AVG V(Vout)*I(RLoad)
.meas Ploss param Pin-Pout
.meas Eff param Pout/Pin
.meas trg1 WHEN V(VHS)=2.5 RISE=9
.meas tr1 WHEN V(Vsw)={Vin*0.15} RISE=1 TD=trg1
.meas tr2 WHEN V(Vsw)={Vin*0.85} RISE=1 TD=tr1
.meas TRAN Ion FIND I(R1d) AT=tr2
.meas tI1 WHEN I(R1d)=Ion/20 RISE=1 TD=trg1
.meas trise_ns param (tr2-tr1)*1e9
.meas tf1 WHEN V(Vsw)={Vin*0.85} FALL=1 TD=(tr2+dutyCycle/freq*0.8)
.meas tf2 WHEN V(Vsw)={Vin*0.15} FALL=1 TD=tf1
.meas tI2 WHEN I(R1d)=Ion/20 FALL=1 TD=tf1
.meas tfall_ns param (tf2-tf1)*1e9
.meas dVdtON param Vin*0.7/trise_ns
.meas dVdtOFF param Vin*0.7/tfall_ns
.meas Eon INTEG V(Vdc,U1_S)*I(R1d)*1e6 FROM (tI1-trise_ns/1e9*1) TO (tr2+trise_ns/1e9*2)
.meas Eoff INTEG V(Vdc,U1_S)*I(R1d)*1e6 FROM (tf1-tfall_ns/1e9*1) TO (tI2+tfall_ns/1e9*2)
.meas Pon param (Eon/1e6*{freq})
.meas Poff param (Eoff/1e6*{freq})
.meas Pchs param (Phs-Pon-Poff)
.meas pldcr AVG V(Vsw1,Vsw)*I(R1)
*Gate driver model can be added here
.model GD_PU SW(Ron=1m Roff=1Meg Vt=2.5 Vh=0)
.model GD_PD SW(Ron=1Meg Roff=1m Vt=2.5 Vh=0)
EPC90153 DC resistance (VIN)
EPC90153 DC resistance (GND)
EPC90153 DC resistance (SW)
