cononinator/GeecPE2526/Simulation/PWMGen/PWMGen.asc

A3: and; vhigh=3.3 vlow=0
A4: and; vhigh=3.3 vlow=0
A6: diffschmitt; vhigh=3.3 vlow=0 vt=0 vh=0
C3: cap; {CDT}
C4: cap; {CDT}
D3: diode; 1N4148
D4: diode; 1N4148
R3: EuropeanResistor; 1k
R4: EuropeanResistor; 1k
R5: res; 150
R6: res; 150
V2: voltage; PULSE(0 1 0 {1/FREQ} 0 0 {1/FREQ})
Named nets: 0, Vset, PWMH, PWML
.param DT=100n CDT={DT/(0.069*1k)} FREQ=20k
