cononinator/GeecPE2526/Simulation/EPC/EPC23101/EPC23101_sim.asc

C1: cap; 47µ
C2: cap; 100n
L1: ind; 2.2µ; Ipk=25.6 Rser=0.0082 Rpar=0 Cpar=0 mfg="Vishay" pn="IHLP4040DZ01-2R2"
R1: res; 2.4
R2: res; 1k
R3: res; 25
U1: EPCGaN; EPC2361
U2: EPC23101_model
VHSin: voltage; PULSE(0 3.3 5u 1n 1n 245n 1u)
VLSin: voltage; PULSE(0 3.3 5.26u 1n 1n 725n 1u)
VVdd5: voltage; PULSE(0 5 0.5u 10u 1n 0.9 1)
VVin: voltage; 48
Named nets: 0, VDC, HSin, LSin, Vdd5, Vin, Vboot, SW, LGOut, Vdd_int, SWa
.tran 0 400u 0 10n
.include EPC23101_model.net
.temp 25
.include EPCGaNLibrary.lib
