cononinator/GeecPE2526/Simulation/EPC/EPC23102/EPC23102_Behavioral_Model_LTSPICE/EPC23102_sim.asc

C1: cap; 47µ
C2: cap; 100n
C3: cap; 100n
C4: cap; 10µ; Rser=1m
I1: load; PULSE(7 0 2m 10ns 10ns 5ms)
L1: ind; 73µ; Ipk=25.6 Rser=0.0082 Rpar=0 Cpar=0
L2: ind; 100n; Rser=10m
R1: res; 1.5
U1: EPC23102_model
VHSin: voltage; PULSE(0 3.3 5u 1n 1n 8.25u 33u)
VLSin: voltage; PULSE(0 3.3 13.4u 1n 1n 24u 33u)
VVdd5: voltage; PULSE(0 5 0.5u 10u 1n 0.9 1)
VVin: voltage; 48; Rser=10m
Named nets: 0, VDC, HSin, LSin, Vdd5, Vin, Vboot, SW, Vdd_int
.tran 0 5m 2n 10n uic
.temp 50
.include EPC23102_model.net
