cononinator/GeecPE2526/(list of files, drawings)

Other design files:
Altium/GeecOisinPE/GeecOisinPE/GeecOisinPE.PrjPcb
Altium/GeecOisinPE/GeecOisinPE/MainSheet.SchDoc
Altium/GeecOisinPE/GeecOisinPE/PCB1.PcbDoc
Altium/NewPowerElec/GeecPC/GeecPC.PrjPcb
Altium/NewPowerElec/GeecPC/PC.SchDoc
Altium/NewPowerElec/GeecPC/PowerController.PcbDoc
Altium/NewPowerElec/GeecPE/GeecPE.PrjPcb
Altium/NewPowerElec/GeecPE/Isolation.SchDoc
Altium/NewPowerElec/GeecPE/Mechanical.SchDoc
Altium/NewPowerElec/GeecPE/PE.SchDoc
Altium/NewPowerElec/GeecPE/Power_Stage.SchDoc
Altium/NewPowerElec/GeecPE/Power_Supply.SchDoc
Altium/NewPowerElec/GeecPE/PowerElec.PcbDoc
Altium/NewPowerElec/GeecPE/Soft_Start.SchDoc
Simulation/LM5113/LM5113_PSPICE_TRANS_16AUG2018/LM5113.OLB
Simulation/LM5113/LM5113_PSPICE_TRANS_16AUG2018/LM5113_TRANS.DSN
Simulation/LM5113/LM5113_PSPICE_TRANS_16AUG2018/LM5113_TRANS.opj
