cononinator/GeecPE2526/Code/DAQ/geec-daq/I2C_CAN.ino

#include "I2C_CAN.h"

namespace {
void i2cCanBeginWire()
{
#if defined(ARDUINO_ARCH_ESP32)
    Wire.begin((int)SDA, (int)SCL);
    Wire.setClock(100000);
    Wire.setTimeOut(50);
#else
    Wire.begin();
#endif
}
}


I2C_CAN::I2C_CAN(unsigned char __addr)
{
    IIC_ADDR = __addr;
}

void I2C_CAN::begin()
{
    i2cCanBeginWire();
}

void I2C_CAN::IIC_CAN_SetReg(unsigned char __reg, unsigned char __len, unsigned char *__dta)
{
    Wire.beginTransmission(IIC_ADDR);
    Wire.write(__reg);
    for(int i=0; i<__len; i++)
    {
        Wire.write(__dta[i]);
    }
    Wire.endTransmission();
    
}

void I2C_CAN::IIC_CAN_SetReg(unsigned char __reg, unsigned char __dta)
{
    Wire.beginTransmission(IIC_ADDR);
    Wire.write(__reg);
    Wire.write(__dta);
    Wire.endTransmission();
}

bool I2C_CAN::IIC_CAN_GetReg(unsigned char __reg, unsigned char *__dta)
{
    if(__dta == NULL)
    {
        return 0;
    }

    Wire.beginTransmission(IIC_ADDR);
    Wire.write(__reg);
    if(Wire.endTransmission(false) != 0)
    {
        return 0;
    }

    size_t count = Wire.requestFrom((uint8_t)IIC_ADDR, (uint8_t)1);
    if(count < 1 || !Wire.available())
    {
        return 0;
    }

    *__dta = Wire.read();
    return 1;
    
}

bool I2C_CAN::IIC_CAN_GetReg(unsigned char __reg, int len, unsigned char *__dta)
{
    if(__dta == NULL || len <= 0)
    {
        return 0;
    }

    Wire.beginTransmission(IIC_ADDR);
    Wire.write(__reg);
    if(Wire.endTransmission(false) != 0)
    {
        return 0;
    }

    size_t count = Wire.requestFrom((uint8_t)IIC_ADDR, (uint8_t)len);
    if(count < (size_t)len)
    {
        while(Wire.available())
        {
            Wire.read();
        }
        return 0;
    }
    
    int __len = 0;
    
    while(Wire.available() && __len < len)
    {
        __dta[__len++] = Wire.read();
    }
    
    return (len == __len);
}


byte I2C_CAN::begin(byte speedset)                                      // init can
{
    i2cCanBeginWire();
    
    IIC_CAN_SetReg(REG_BAUD, speedset);
    delay(10);
    
    unsigned char __speed = 0;
    
    if(IIC_CAN_GetReg(REG_BAUD, &__speed))
    {
        if(speedset == __speed)return 1;
        
    }
    
    delay(100);
    return 0;
}

byte I2C_CAN::init_Mask(byte num, byte ext, unsigned long ulData)       // init Masks
{
    unsigned char dta[5];
    
    dta[0] = ext;
    dta[1] = 0xff & (ulData >> 24);
    dta[2] = 0xff & (ulData >> 16);
    dta[3] = 0xff & (ulData >> 8);
    dta[4] = 0xff & (ulData >> 0);
    
    unsigned char mask = (num == 0) ? REG_MASK0 : REG_MASK1;
    
    IIC_CAN_SetReg(mask, 5, dta);
    delay(50);

    return CAN_OK;
}

byte I2C_CAN::init_Filt(byte num, byte ext, unsigned long ulData)       // init filters
{
    unsigned char dta[5];
    
    dta[0] = ext;
    dta[1] = 0xff & (ulData >> 24);
    dta[2] = 0xff & (ulData >> 16);
    dta[3] = 0xff & (ulData >> 8);
    dta[4] = 0xff & (ulData >> 0);
    
    unsigned char filt = (7+num)*0x10;
    
    IIC_CAN_SetReg(filt, 5, dta);
    delay(50);

    return CAN_OK;
}

byte I2C_CAN::sendMsgBuf(unsigned long id, byte ext, byte rtr, byte len, byte *buf)     // send buf
{
    if(buf == NULL || len > 8)
    {
        return CAN_FAILTX;
    }

    unsigned char dta[16];
    
    dta[0] = 0xff & (id >> 24);
    dta[1] = 0xff & (id >> 16);
    dta[2] = 0xff & (id >> 8);
    dta[3] = 0xff & (id >> 0);
    
    dta[4] = ext;
    dta[5] = rtr;
    
    dta[6] = len;
    
    for(int i=0; i<len; i++)
    {
        dta[7+i] = buf[i];
    }
    
    dta[15] = makeCheckSum(dta, 15);
    
    IIC_CAN_SetReg(REG_SEND, 16, dta);

    return CAN_OK;
}

byte I2C_CAN::sendMsgBuf(unsigned long id, byte ext, byte len, byte *buf)               // send buf
{
    return sendMsgBuf(id, ext, 0, len, buf);

}

byte I2C_CAN::readMsgBuf(byte *len, byte *buf)                          // read buf
{
    return readMsgBufID(&m_ID, len, buf);
}

byte I2C_CAN::readMsgBufID(unsigned long *ID, byte *len, byte *buf)     // read buf with object ID
{
    //IIC_CAN_GetReg(unsigned char __reg, int len, unsigned char *__dta)
    unsigned long id = 0;
    
    unsigned char dta[16];
    
    IIC_CAN_GetReg(REG_RECV, 16, dta);
    
    unsigned char __checksum = makeCheckSum(dta, 15);
    
    if(__checksum == dta[15])           // checksum ok
    {
        id = dta[0];
        id <<= 8;
        id += dta[1];
        id <<= 8;
        id += dta[2];
        id <<= 8;
        id += dta[3];
        
        *ID = id;
        
        m_ID  = id;
        m_EXT = dta[4];
        m_RTR = dta[5];
        
        *len = dta[6];
        
        //Serial.print("readMsgBufID, len = ");
        //Serial.println(*len);
        
        if(*len > 8)return 0;
        
        for(int i=0; i<*len; i++)
            buf[i] = dta[7+i];
        
        return 1;
    }
    else 
    {
        //Serial.println("CHECKSUM ERROR");
        return 0;
    }
}

byte I2C_CAN::checkReceive(void)                                        // if something received
{
    unsigned char num = 0;
    
    if(IIC_CAN_GetReg(REG_DNUM, &num))
    {
        if(num > 0)
        {
            return CAN_MSGAVAIL;
        }
    }
    
    return 0;
}

byte I2C_CAN::checkError(void)                                          // if something error
{
    return 0;
}

unsigned long I2C_CAN::getCanId(void)                                   // get can id when receive
{
    return m_ID;
}

byte I2C_CAN::isRemoteRequest(void)                                     // get RR flag when receive
{
    return m_RTR;
}

byte I2C_CAN::isExtendedFrame(void)                                     // did we recieve 29bit frame?
{
    return m_EXT;
}

unsigned char I2C_CAN::makeCheckSum(unsigned char *dta, int len)
{
    unsigned long sum = 0;
    for(int i=0; i<len; i++)sum += dta[i];
    
    if(sum > 0xff)
    {
        sum = ~sum;
        sum += 1;
    }
    
    sum  = sum & 0xff;
    return sum;
}

// END FILE
