cononinator/GeecPE2526/Code/DynoTesting/run_dyno_sweep_gui.py

#!/usr/bin/env python3
"""
run_dyno_sweep_gui.py — GUI for closed-loop dyno sweep test with live plotting

Provides real-time data visualization and parameter input.
Port configuration is done via the GUI; CLI args are optional pre-fills.

Usage:
    python run_dyno_sweep_gui.py
    python run_dyno_sweep_gui.py --port COM3 --dyno-port COM4
"""

import serial
import time
import pandas as pd
import argparse
import sys

try:
    from PyQt5.QtWidgets import (
        QApplication, QMainWindow, QWidget, QGridLayout, QLabel, QVBoxLayout,
        QHBoxLayout, QPushButton, QSpinBox, QDoubleSpinBox, QLineEdit,
        QPlainTextEdit, QCheckBox, QSizePolicy
    )
    from PyQt5.QtCore import QThread, pyqtSignal, Qt
    from PyQt5.QtGui import QFont
    import pyqtgraph as pg
    import pyqtgraph.exporters
except ImportError as e:
    print(f"Missing dependencies: {e}")
    print("Install with: pip install PyQt5 pyqtgraph pandas pyserial")
    sys.exit(1)


def parse_sensor_line(line):
    """Parse sensor data line from firmware.
    Expected format: DATA,Voltage,Current,Power,Energy,Temperature,MotorVoltage,MotorCurrent,MeasuredDutyCycle,TargetDutyCycle[,WheelSpeed]
    WheelSpeed (km/h via CAN from DAQ) is optional — present in firmware builds with CAN enabled.
    """
    try:
        parts = line.strip().split(',')
        if len(parts) >= 10 and parts[0] == "DATA":
            return {
                "Voltage": float(parts[1]),
                "Current": float(parts[2]),
                "Power": float(parts[3]),
                "Energy": float(parts[4]),
                "Temperature": float(parts[5]),
                "MotorVoltage": float(parts[6]),
                "MotorCurrent": float(parts[7]),
                "MeasuredDutyCycle": float(parts[8]),
                "TargetDutyCycle": float(parts[9]),
                "WheelSpeed": float(parts[10]) if len(parts) >= 11 else None,
            }
    except ValueError:
        pass
    return None


def parse_dyno_line(line):
    """Parse dyno data line.
    Expected format: $<timestamp_ms> <dyno_rpm> <car_rpm> <torque_Nm> <power_W>;
    Converts RPM to km/h using wheel radius 235mm (from Dyno.ino carWheelDiameter=470mm).
    """
    try:
        line = line.strip()
        if line.startswith("$") and line.endswith(";"):
            parts = line[1:-1].split()
            if len(parts) == 5:
                # Convert RPM to km/h: speed_kmh = rpm * (2*PI*radius) / 60 * 3.6
                # With radius=0.235m: speed_kmh = rpm * 0.0886
                rpm_to_kmh = 0.0886
                dyno_rpm = float(parts[1])
                car_rpm = float(parts[2])
                return {
                    "Dyno_Timestamp_ms": float(parts[0]),
                    "Dyno_Speed_kmh":    dyno_rpm * rpm_to_kmh,
                    "Car_Speed_kmh":     car_rpm * rpm_to_kmh,
                    "Dyno_Torque_Nm":    float(parts[3]),
                    "Dyno_Power_W":      float(parts[4]),
                }
    except ValueError:
        pass
    return None


def mktimestamp():
    return time.strftime("%Y%m%d-%H%M%S")


# ─────────────────────────────────────────────
# Parameter dialog
# ─────────────────────────────────────────────

class ParameterDialog(QMainWindow):
    """Dialog to gather test parameters from user."""

    parameters_accepted = pyqtSignal(float, float, float)

    def __init__(self, parent=None):
        super().__init__(parent)
        self.setWindowTitle("DynoSweep Parameters")
        self.resize(400, 200)

        central = QWidget()
        self.setCentralWidget(central)
        layout = QVBoxLayout(central)

        # Current limit
        hbox1 = QHBoxLayout()
        hbox1.addWidget(QLabel("Current Limit (A):"))
        self.spin_current = QDoubleSpinBox()
        self.spin_current.setMinimum(0.1)
        self.spin_current.setMaximum(100.0)
        self.spin_current.setValue(20.0)
        self.spin_current.setSingleStep(0.5)
        hbox1.addWidget(self.spin_current)
        hbox1.addStretch()
        layout.addLayout(hbox1)

        # Min speed
        hbox2 = QHBoxLayout()
        hbox2.addWidget(QLabel("Min Speed (km/h):"))
        self.spin_min = QDoubleSpinBox()
        self.spin_min.setMinimum(0)
        self.spin_min.setMaximum(200)
        self.spin_min.setValue(10)
        self.spin_min.setSingleStep(1)
        hbox2.addWidget(self.spin_min)
        hbox2.addStretch()
        layout.addLayout(hbox2)

        # Max speed
        hbox3 = QHBoxLayout()
        hbox3.addWidget(QLabel("Max Speed (km/h):"))
        self.spin_max = QDoubleSpinBox()
        self.spin_max.setMinimum(0)
        self.spin_max.setMaximum(200)
        self.spin_max.setValue(20)
        self.spin_max.setSingleStep(1)
        hbox3.addWidget(self.spin_max)
        hbox3.addStretch()
        layout.addLayout(hbox3)

        # Buttons
        hbox_buttons = QHBoxLayout()
        btn_start = QPushButton("Start Test")
        btn_cancel = QPushButton("Cancel")
        btn_start.clicked.connect(self._on_start)
        btn_cancel.clicked.connect(self.close)
        hbox_buttons.addWidget(btn_start)
        hbox_buttons.addWidget(btn_cancel)
        layout.addLayout(hbox_buttons)
        layout.addStretch()

    def _on_start(self):
        current = self.spin_current.value()
        min_sp = self.spin_min.value()
        max_sp = self.spin_max.value()

        if current <= 0 or max_sp <= min_sp:
            return

        self.parameters_accepted.emit(current, min_sp, max_sp)
        self.close()


# ─────────────────────────────────────────────
# Sweep worker (runs in a QThread)
# ─────────────────────────────────────────────

class DynoSweepWorker(QThread):
    """Runs the dyno sweep in a separate thread."""

    status = pyqtSignal(str)
    raw_line = pyqtSignal(str)           # every raw line from firmware serial port
    data_updated = pyqtSignal(dict)
    sweep_done = pyqtSignal(list, str)  # (results, timestamp)

    def __init__(self, port, baudrate, dyno_port, dyno_baudrate,
                 current_limit, min_speed, max_speed, num_repeats=5,
                 use_wheel_speed=False):
        super().__init__()
        self.port = port
        self.baudrate = baudrate
        self.dyno_port = dyno_port
        self.dyno_baudrate = dyno_baudrate
        self.current_limit = current_limit
        self.min_speed = min_speed
        self.max_speed = max_speed
        self.num_repeats = num_repeats
        self.use_wheel_speed = use_wheel_speed
        self._stop_flag = False

    def stop(self):
        self._stop_flag = True

    def run(self):
        try:
            ser = serial.Serial(self.port, self.baudrate, timeout=1)
            self.status.emit(f"Connected to {self.port} at {self.baudrate} baud.")
        except serial.SerialException as e:
            self.status.emit(f"ERROR: {e}")
            return

        dyno_ser = None
        if self.dyno_port:
            try:
                dyno_ser = serial.Serial(self.dyno_port, self.dyno_baudrate, timeout=0)
                self.status.emit(f"Dyno connected to {self.dyno_port} at {self.dyno_baudrate} baud.")
            except serial.SerialException as e:
                self.status.emit(f"ERROR (dyno): {e}")
                ser.close()
                return

        time.sleep(2)
        ser.reset_input_buffer()
        if dyno_ser:
            dyno_ser.reset_input_buffer()

        # Enable serial control (firmware defaults to throttle mode)
        ser.write(b"M\n")
        time.sleep(0.1)

        # Set current limit
        self.status.emit(f"Setting current limit to {self.current_limit} A...")
        ser.write(f"C {self.current_limit}\n".encode())
        time.sleep(0.2)

        all_samples = []
        results = []
        test_start_time = time.time()

        last_speed_kmh    = 0.0
        last_voltage      = 0.0
        last_motor_current = 0.0
        last_power        = 0.0
        last_motor_voltage = 0.0
        last_dyno_torque  = 0.0
        last_dyno_power   = 0.0
        last_wheel_speed  = 0.0

        def emit_update(ts):
            self.data_updated.emit({
                "time":          ts,
                "speed":         last_wheel_speed if self.use_wheel_speed else last_speed_kmh,
                "voltage":       last_voltage,
                "current":       last_motor_current,
                "power":         last_power,
                "motor_voltage": last_motor_voltage,
                "dyno_torque":   last_dyno_torque,
                "dyno_power":    last_dyno_power,
            })

        try:
            for repeat in range(self.num_repeats):
                if self._stop_flag:
                    break

                # Reset power meter energy at start of repeat
                ser.write(b"R\n")
                time.sleep(0.1)

                self.status.emit(f"[{repeat + 1}/{self.num_repeats}] Accelerating...")

                # Phase 1: Accelerate
                ser.write(b"100\n")
                accel_start = time.time()
                accel_samples = []
                accel_dyno = []
                max_speed_reached = False
                dyno_buf = ""

                while (time.time() - accel_start) < 60.0 and not self._stop_flag:
                    if ser.in_waiting:
                        line = ser.readline().decode('utf-8', errors='ignore').strip()
                        if line:
                            self.raw_line.emit(line)
                        data = parse_sensor_line(line)
                        if data:
                            data["Phase"] = "Accelerating"
                            data["Repeat"] = repeat + 1
                            data["CurrentLimit_A"] = self.current_limit
                            data["Timestamp_s"] = time.time() - test_start_time
                            accel_samples.append(data)
                            all_samples.append(data)

                            last_voltage       = data["Voltage"]
                            last_motor_current = data["MotorCurrent"]
                            last_power         = data["Power"]
                            last_motor_voltage = data["MotorVoltage"]
                            if data["WheelSpeed"] is not None:
                                last_wheel_speed = data["WheelSpeed"]
                            emit_update(data["Timestamp_s"])

                            # Use wheel speed for max speed detection when toggled
                            if self.use_wheel_speed and last_wheel_speed >= self.max_speed and not max_speed_reached:
                                max_speed_reached = True
                                ser.write(b"0\n")  # Stop motor immediately

                    if dyno_ser and dyno_ser.in_waiting:
                        dyno_buf += dyno_ser.read(dyno_ser.in_waiting).decode('utf-8', errors='ignore')
                        while '\n' in dyno_buf:
                            line, dyno_buf = dyno_buf.split('\n', 1)
                            data = parse_dyno_line(line.strip())
                            if data:
                                data["Timestamp_s"] = time.time() - test_start_time
                                accel_dyno.append(data)
                                all_samples.append(data)

                                last_speed_kmh   = data["Car_Speed_kmh"]
                                last_dyno_torque = data["Dyno_Torque_Nm"]
                                last_dyno_power  = data["Dyno_Power_W"]
                                emit_update(data["Timestamp_s"])

                                # Use dyno speed for max speed detection when not using wheel speed
                                if not self.use_wheel_speed and data["Car_Speed_kmh"] >= self.max_speed and not max_speed_reached:
                                    max_speed_reached = True
                                    ser.write(b"0\n")  # Stop motor immediately

                    if max_speed_reached:
                        break

                    time.sleep(0.01)

                # Phase 2: Coast down
                self.status.emit(f"[{repeat + 1}/{self.num_repeats}] Coasting...")
                ser.write(b"S\n")
                coast_start = time.time()
                coast_samples = []
                coast_dyno = []
                current_speed = None

                while (time.time() - coast_start) < 120.0 and not self._stop_flag:
                    if ser.in_waiting:
                        line = ser.readline().decode('utf-8', errors='ignore').strip()
                        if line:
                            self.raw_line.emit(line)
                        data = parse_sensor_line(line)
                        if data:
                            data["Phase"] = "Coasting"
                            data["Repeat"] = repeat + 1
                            data["CurrentLimit_A"] = self.current_limit
                            data["Timestamp_s"] = time.time() - test_start_time
                            coast_samples.append(data)
                            all_samples.append(data)

                            last_voltage       = data["Voltage"]
                            last_motor_current = data["MotorCurrent"]
                            last_power         = data["Power"]
                            last_motor_voltage = data["MotorVoltage"]
                            if data["WheelSpeed"] is not None:
                                last_wheel_speed = data["WheelSpeed"]
                                if self.use_wheel_speed:
                                    current_speed = last_wheel_speed
                            emit_update(data["Timestamp_s"])

                    if dyno_ser and dyno_ser.in_waiting:
                        dyno_buf += dyno_ser.read(dyno_ser.in_waiting).decode('utf-8', errors='ignore')
                        while '\n' in dyno_buf:
                            line, dyno_buf = dyno_buf.split('\n', 1)
                            data = parse_dyno_line(line.strip())
                            if data:
                                last_speed_kmh   = data["Car_Speed_kmh"]
                                last_dyno_torque = data["Dyno_Torque_Nm"]
                                last_dyno_power  = data["Dyno_Power_W"]
                                data["Timestamp_s"] = time.time() - test_start_time
                                coast_dyno.append(data)
                                all_samples.append(data)
                                if not self.use_wheel_speed:
                                    current_speed = last_speed_kmh
                                emit_update(data["Timestamp_s"])

                            if current_speed is not None and current_speed < self.min_speed:
                                break

                    if current_speed is not None and current_speed < self.min_speed:
                        break

                    time.sleep(0.01)

                # Summarize repeat
                repeat_samples = accel_samples + coast_samples + accel_dyno + coast_dyno
                if repeat_samples:
                    results.append({
                        "Repeat": repeat + 1,
                        "CurrentLimit_A": self.current_limit,
                        "MinSpeed_kmh": self.min_speed,
                        "MaxSpeed_kmh": self.max_speed,
                        "SamplesCollected": len(repeat_samples),
                    })

        except Exception as e:
            self.status.emit(f"ERROR: {e}")

        finally:
            self.status.emit("Stopping system...")
            ser.write(b"S\n")
            time.sleep(0.5)
            ser.close()

            if dyno_ser and dyno_ser.is_open:
                dyno_ser.close()

            ts = mktimestamp()
            if all_samples:
                df = pd.DataFrame(all_samples)
                filename = f"dyno_sweep_{ts}.csv"
                df.to_csv(filename, index=False)
                self.status.emit(f"Results saved to {filename}")

            self.sweep_done.emit(results, ts)


# ─────────────────────────────────────────────
# Main window
# ─────────────────────────────────────────────

class DynoSweepWindow(QMainWindow):
    def __init__(self, port="", baudrate=115200, dyno_port="", dyno_baudrate=9600):
        super().__init__()
        self.setWindowTitle("DynoSweep Closed-Loop Test")
        self.resize(1400, 900)

        pg.setConfigOption("background", "w")
        pg.setConfigOption("foreground", "k")

        central = QWidget()
        self.setCentralWidget(central)
        layout = QVBoxLayout(central)

        # ── Connection panel ──────────────────────────────────────────────────
        conn_row = QHBoxLayout()

        conn_row.addWidget(QLabel("Firmware Port:"))
        self.edit_port = QLineEdit()
        self.edit_port.setPlaceholderText("e.g. COM3")
        self.edit_port.setMaximumWidth(120)
        if port:
            self.edit_port.setText(port)
        conn_row.addWidget(self.edit_port)

        conn_row.addWidget(QLabel("Baud:"))
        self.spin_baud = QSpinBox()
        self.spin_baud.setRange(1200, 2000000)
        self.spin_baud.setValue(baudrate)
        self.spin_baud.setMaximumWidth(90)
        conn_row.addWidget(self.spin_baud)

        conn_row.addSpacing(20)

        conn_row.addWidget(QLabel("Dyno Port:"))
        self.edit_dyno_port = QLineEdit()
        self.edit_dyno_port.setPlaceholderText("e.g. COM4 (optional)")
        self.edit_dyno_port.setMaximumWidth(150)
        if dyno_port:
            self.edit_dyno_port.setText(dyno_port)
        conn_row.addWidget(self.edit_dyno_port)

        conn_row.addWidget(QLabel("Dyno Baud:"))
        self.spin_dyno_baud = QSpinBox()
        self.spin_dyno_baud.setRange(1200, 2000000)
        self.spin_dyno_baud.setValue(dyno_baudrate)
        self.spin_dyno_baud.setMaximumWidth(90)
        conn_row.addWidget(self.spin_dyno_baud)

        conn_row.addStretch()
        layout.addLayout(conn_row)

        # ── Status label ──────────────────────────────────────────────────────
        self.status_label = QLabel("Ready. Fill in ports above, then click 'Start Test'.")
        layout.addWidget(self.status_label)

        # ── Buttons ───────────────────────────────────────────────────────────
        hbox_buttons = QHBoxLayout()
        self.btn_start = QPushButton("Start Test")
        self.btn_stop = QPushButton("Stop")
        self.btn_start.clicked.connect(self._on_start_test)
        self.btn_stop.clicked.connect(self._on_stop_test)
        self.btn_stop.setEnabled(False)
        hbox_buttons.addWidget(self.btn_start)
        hbox_buttons.addWidget(self.btn_stop)
        hbox_buttons.addStretch()
        self.chk_wheel_speed = QCheckBox("Use Wheel Speed (CAN)")
        self.chk_wheel_speed.setChecked(False)
        self.chk_wheel_speed.toggled.connect(self._on_wheel_speed_toggled)
        hbox_buttons.addWidget(self.chk_wheel_speed)
        hbox_buttons.addSpacing(20)
        self.chk_log = QCheckBox("Show Serial Log")
        self.chk_log.setChecked(False)
        self.chk_log.toggled.connect(self._on_log_toggled)
        hbox_buttons.addWidget(self.chk_log)
        layout.addLayout(hbox_buttons)

        # ── Plots + log side-by-side ──────────────────────────────────────────
        content_row = QHBoxLayout()

        # Plots — 3×2 grid
        grid = QGridLayout()

        def make_plot(title, x_label, y_label, y_units, color):
            p = pg.PlotWidget(title=title)
            p.setLabel("bottom", x_label, units="s")
            p.setLabel("left", y_label, units=y_units)
            p.showGrid(x=True, y=True, alpha=0.3)
            c = p.plot([], [], pen=pg.mkPen(color, width=2), symbol="o", symbolSize=3)
            return p, c

        self.plot_speed, self.curve_speed = make_plot(
            "Speed (Dyno)", "Time", "Speed", "km/h", "#1f77b4")
        self.plot_power, self.curve_power = make_plot(
            "Electrical Power", "Time", "Power", "W", "#ff7f0e")
        self.plot_current, self.curve_current = make_plot(
            "Motor Current", "Time", "Current", "A", "#2ca02c")
        self.plot_motor_voltage, self.curve_motor_voltage = make_plot(
            "Motor Voltage", "Time", "Voltage", "V", "#9467bd")
        self.plot_dyno_torque, self.curve_dyno_torque = make_plot(
            "Dyno Torque", "Time", "Torque", "Nm", "#8c564b")
        self.plot_dyno_power, self.curve_dyno_power = make_plot(
            "Dyno Power", "Time", "Power", "W", "#e377c2")

        grid.addWidget(self.plot_speed,         0, 0)
        grid.addWidget(self.plot_dyno_torque,   0, 1)
        grid.addWidget(self.plot_current,       1, 0)
        grid.addWidget(self.plot_motor_voltage, 1, 1)
        grid.addWidget(self.plot_power,         2, 0)
        grid.addWidget(self.plot_dyno_power,    2, 1)
        content_row.addLayout(grid, stretch=1)

        # Serial log panel (hidden by default, sits to the right of the plots)
        self.log_widget = QPlainTextEdit()
        self.log_widget.setReadOnly(True)
        self.log_widget.setMaximumBlockCount(2000)  # cap at 2000 lines
        font = QFont("Courier New", 9)
        font.setStyleHint(QFont.Monospace)
        self.log_widget.setFont(font)
        self.log_widget.setMinimumWidth(280)
        self.log_widget.setMaximumWidth(400)
        self.log_widget.setVisible(False)
        content_row.addWidget(self.log_widget)

        layout.addLayout(content_row)

        self.worker = None

        # Data buffers
        self.times          = []
        self.speeds         = []
        self.powers         = []
        self.currents       = []
        self.motor_voltages = []
        self.dyno_torques   = []
        self.dyno_powers    = []

    def _on_start_test(self):
        dialog = ParameterDialog(self)
        dialog.parameters_accepted.connect(self._start_sweep)
        dialog.show()

    def _on_stop_test(self):
        if self.worker and self.worker.isRunning():
            self.worker.stop()
            self.btn_stop.setEnabled(False)

    def _start_sweep(self, current_limit, min_speed, max_speed):
        port      = self.edit_port.text().strip()
        baud      = self.spin_baud.value()
        dyno_port = self.edit_dyno_port.text().strip() or None
        dyno_baud = self.spin_dyno_baud.value()

        if not port:
            self.status_label.setText("Error: Firmware port is required.")
            return

        self.btn_start.setEnabled(False)
        self.btn_stop.setEnabled(True)

        # Reset buffers
        self.times          = []
        self.speeds         = []
        self.powers         = []
        self.currents       = []
        self.motor_voltages = []
        self.dyno_torques   = []
        self.dyno_powers    = []

        self.worker = DynoSweepWorker(
            port, baud, dyno_port, dyno_baud,
            current_limit, min_speed, max_speed, num_repeats=5,
            use_wheel_speed=self.chk_wheel_speed.isChecked()
        )
        self.worker.status.connect(self._on_status)
        self.worker.raw_line.connect(self._on_raw_line)
        self.worker.data_updated.connect(self._on_data_update)
        self.worker.sweep_done.connect(self._on_sweep_done)
        self.worker.start()

    def _on_wheel_speed_toggled(self, checked: bool):
        title = "Speed (Wheel — CAN)" if checked else "Speed (Dyno)"
        self.plot_speed.setTitle(title)

    def _on_log_toggled(self, checked: bool):
        self.log_widget.setVisible(checked)

    def _on_raw_line(self, line: str):
        self.log_widget.appendPlainText(line)

    def _on_status(self, msg: str):
        self.status_label.setText(msg)
        self.log_widget.appendPlainText(f"[STATUS] {msg}")
        print(msg)

    def _on_data_update(self, data: dict):
        self.times.append(data["time"])
        self.speeds.append(data["speed"])
        self.powers.append(data["power"])
        self.currents.append(data["current"])
        self.motor_voltages.append(data["motor_voltage"])
        self.dyno_torques.append(data["dyno_torque"])
        self.dyno_powers.append(data["dyno_power"])

        self.curve_speed.setData(self.times, self.speeds)
        self.curve_power.setData(self.times, self.powers)
        self.curve_current.setData(self.times, self.currents)
        self.curve_motor_voltage.setData(self.times, self.motor_voltages)
        self.curve_dyno_torque.setData(self.times, self.dyno_torques)
        self.curve_dyno_power.setData(self.times, self.dyno_powers)

        self.plot_speed.enableAutoRange()
        self.plot_power.enableAutoRange()
        self.plot_current.enableAutoRange()
        self.plot_motor_voltage.enableAutoRange()
        self.plot_dyno_torque.enableAutoRange()
        self.plot_dyno_power.enableAutoRange()

    def _on_sweep_done(self, results: list, ts: str):
        self.status_label.setText("Test complete. Click 'Start Test' for another cycle.")
        self.btn_start.setEnabled(True)
        self.btn_stop.setEnabled(False)

        # Save plots
        for slug, plot in [
            ("speed",         self.plot_speed),
            ("power",         self.plot_power),
            ("current",       self.plot_current),
            ("motor_voltage", self.plot_motor_voltage),
            ("dyno_torque",   self.plot_dyno_torque),
            ("dyno_power",    self.plot_dyno_power),
        ]:
            filename = f"dyno_sweep_{ts}_{slug}.png"
            exporter = pg.exporters.ImageExporter(plot.plotItem)
            exporter.parameters()["width"] = 1200
            exporter.export(filename)
            print(f"Figure saved: {filename}")


if __name__ == "__main__":
    parser = argparse.ArgumentParser(description="DynoSweep Closed-Loop Test (GUI)")
    parser.add_argument("--port",      type=str, default="",   help="COM port for firmware (pre-fills GUI)")
    parser.add_argument("--baud",      type=int, default=115200, help="Baud rate for firmware")
    parser.add_argument("--dyno-port", type=str, default="",   help="COM port for dyno (pre-fills GUI)")
    parser.add_argument("--dyno-baud", type=int, default=9600,  help="Baud rate for dyno")

    args = parser.parse_args()

    app = QApplication(sys.argv)
    window = DynoSweepWindow(args.port, args.baud, args.dyno_port, args.dyno_baud)
    window.show()

    sys.exit(app.exec_())
