cononinator/GeecPE2526/Code/TestCode/ClosedLoopTest/INA780.ino

#include "INA780.h"

INA780::INA780(uint8_t address) {
    _address = address;
}

void INA780::begin() {
    Wire.begin();
}

bool INA780::isConnected() {
    uint16_t manufacturerID = getManufacturerID();
    return (manufacturerID == 0x5449); // Check against expected manufacturer ID (0x5449 for TI)
}

void INA780::reset() {
    writeRegister(CONFIG_REG, 0x8000); // Set the reset bit
}

uint16_t INA780::readRegister(uint8_t reg) {
    Wire.beginTransmission(_address);
    Wire.write(reg);
    Wire.endTransmission();
    
    Wire.requestFrom(_address, (uint8_t)2);
    uint16_t value = (Wire.read() << 8) | Wire.read();

    return value;
}

uint64_t INA780::readRegister(uint8_t reg, uint8_t length) {
    Wire.beginTransmission(_address);
    Wire.write(reg);
    Wire.endTransmission();
    
    Wire.requestFrom(_address, length);
    uint64_t value = 0;
    for (uint8_t i = 0; i < length; i++) {
        value = (value << 8) | Wire.read();
    }

    return value;
}

void INA780::writeRegister(uint8_t reg, uint16_t value) {
    Wire.beginTransmission(_address);
    Wire.write(reg);
    Wire.write(value >> 8);
    Wire.write(value & 0xFF);
    Wire.endTransmission();
}

float INA780::getBusVoltage() {
    int16_t rawValue = readRegister(VBUS_REG);
    return rawValue * 0.003125; // Conversion factor for bus voltage
}

float INA780::getCurrent() {
    int16_t rawValue = readRegister(CURRENT_REG);
    return rawValue * 0.0024; // Conversion factor for current
}

double INA780::getPower() {
    uint64_t rawValue = readRegister(POWER_REG, 3);
    return rawValue * 0.00048; // Conversion factor for power
}

double INA780::getEnergy() {
    uint64_t rawValue = readRegister(ENERGY_REG, 5);
    return rawValue * 0.00768; // Conversion factor for energy
}

double INA780::getCharge() {
    uint64_t rawValue = readRegister(CHARGE_REG, 5);
    return rawValue * 0.000150; // Conversion factor for charge
}

float INA780::getTemperature() {
    int16_t rawValue = readRegister(DIETEMP_REG);
    rawValue = rawValue >> 4; // Temperature is stored in the upper 12 bits
    return rawValue * 0.125; // Conversion factor for temperature
}

void INA780::setConfig(uint16_t config) {
    writeRegister(CONFIG_REG, config);
}

void INA780::setADCConfig(uint16_t config) {
    writeRegister(ADC_CONFIG_REG, config);
}

// Returns the diagnostic alert register value see datasheet for more information
uint16_t INA780::getDiagAlert() {
    return readRegister(DIAG_ALRT_REG);
}

// Returns the current over limit in A
uint16_t INA780::getCurrentOverLimit() {
    uint16_t value = readRegister(COL_REG);
    return value * 0.0024; // Conversion factor for current limit
}

// Returns the current under limit in A
uint16_t INA780::getCurrentUnderLimit() {
    uint16_t value = readRegister(CUL_REG);
    return value * 0.0024; // Conversion factor for current limit
}

// Returns the bus over voltage limit in V
uint16_t INA780::getBusOverVoltageLimit() {
    uint16_t value = readRegister(BOVL_REG);
    return value * 0.003125; // Conversion factor for bus voltage limit
}

// Returns the bus under voltage limit in V
uint16_t INA780::getBusUnderVoltageLimit() {
    uint16_t value = readRegister(BUVL_REG);
    return value * 0.003125; // Conversion factor for bus voltage limit
}

// Returns the temperature limit in degrees Celsius
uint16_t INA780::getTemperatureLimit() {
    uint16_t value = readRegister(TEMP_LIMIT_REG);
    value = value >> 4; // Temperature limit is stored in the upper 12 bits
    return value * 0.125; // Conversion factor for temperature limit
}

// Returns the power limit in W
uint16_t INA780::getPowerLimit() {
    uint16_t value = readRegister(PWR_LIMIT_REG);
    return value * 0.12288; // Conversion factor for power limit to W
}

// Returns 0x5449 which is TI in ASCII
uint16_t INA780::getManufacturerID() {
    return readRegister(MANUFACTURER_ID_REG);
}

// Sets the current over limit in A
void INA780::setCurrentOverLimit(uint16_t value) {
    writeRegister(COL_REG, value / 0.0024); // Conversion factor for current limit
}

// Sets the current under limit in A
void INA780::setCurrentUnderLimit(uint16_t value) {
    writeRegister(CUL_REG, value / 0.0024); // Conversion factor for current limit
}

// Sets the bus over voltage limit in V
void INA780::setBusOverVoltageLimit(uint16_t value) {
    writeRegister(BOVL_REG, value / 0.003125); // Conversion factor for bus voltage limit
}

// Sets the bus under voltage limit in V
void INA780::setBusUnderVoltageLimit(uint16_t value) {
    writeRegister(BUVL_REG, value / 0.003125); // Conversion factor for bus voltage limit
}

// Sets the temperature limit in degrees Celsius
void INA780::setTemperatureLimit(uint16_t value) {
    value = value/0.125; // Conversion factor for temperature limit
    value = value << 4; // Temperature limit is stored in the upper 12 bits
    writeRegister(TEMP_LIMIT_REG, value);
}

// Sets the power limit in W
void INA780::setPowerLimit(uint16_t value) {
    writeRegister(PWR_LIMIT_REG, value / 0.12288); // Conversion factor for power limit to W
}

/**
 * Sets the averaging and conversion times without losing other settings.
 * @param avg Use enum Averaging (e.g., AVG_16)
 * @param vbusConv Use enum ConversionTime (e.g., CONV_1052us)
 * @param vshntConv Use enum ConversionTime
 */
void INA780::configureADC(Averaging avg, ConversionTime vbusConv, ConversionTime vshntConv) {
    uint16_t currentConf = readRegister(ADC_CONFIG_REG);
    
    // Clear old values (Avg: bits 11-9, Vbus: bits 8-6, Vshnt: bits 5-3)
    currentConf &= 0xF007; 
    
    // Mask in new values
    currentConf |= (avg << 9);
    currentConf |= (vbusConv << 6);
    currentConf |= (vshntConv << 3);
    
    writeRegister(ADC_CONFIG_REG, currentConf);
}

/**
 * Quick method to set just the averaging count.
 */
void INA780::setAveraging(Averaging avg) {
    uint16_t currentConf = readRegister(ADC_CONFIG_REG);
    currentConf &= ~(0x07 << 9); // Clear bits 11-9
    currentConf |= (avg << 9);
    writeRegister(ADC_CONFIG_REG, currentConf);
}

/**
 * Sets the operating mode (e.g., Continuous Shunt & Bus)
 */
void INA780::setMode(OperatingMode mode) {
    uint16_t currentConf = readRegister(ADC_CONFIG_REG);
    currentConf &= 0xFFF0; // Clear bits 3-0 (Mode is stored in lower 4 bits)
    currentConf |= mode;
    writeRegister(ADC_CONFIG_REG, currentConf);
}
