cononinator/GeecPE2526/(commit log)

2025-09-21 Created GaN buck converter based on the LM5113 and programmable PWM module with deadtime
2025-09-23 Added PID function
2025-09-24 Implement current control with PID tuning and motor PWM management
2025-09-26 Removed Diode
2025-09-30 Refactor current control logic and enhance PID output handling with PWM accumulator
2025-09-30 Refactor motor control logic and enhance PID output handling with improved PWM ramping
2025-09-30 Added Power Electronics schematic
2025-09-30 Add test procedure and message protocol for current control verification
2025-10-06 Added files for hierarchical design for PWM generator
2025-10-07 More calculations on EC Motor
2025-10-15 Added models for both current power electronics and previous power electronics
2025-10-17 Refactor code structure for improved readability and maintainability
    [Investigation.xlsx]
2025-10-18 Add motor simulation files and logs for analysis
2025-10-18 Created a justification for a new power electronics board
2025-10-24 Added previous schematic
    [Investigation.xlsx]
2025-11-02 Started PCB work
    [1.csv, 2.csv, GeecOisinPE.PrjPcb, GeecPC.PrjPcb, GeecPE.PrjPcb, MainSheet.SchDoc, PC.SchDoc, PCB1.PcbDoc]
2025-11-04 Added Porject Plan and pdf schematic
2025-11-04 Created a diagram showing current control
2025-11-04 Add ADuM3190 schematic and sub-circuit model files for LTSpice simulation Added diagram showing Isolation ICs that could work on the Power Electronics
2025-11-09 Add project plan and related documents for Modular Power Electronics & Current Control for the Geec
    - Created a new project plan PDF (CF_Plan-v01.pdf) detailing the scope, stakeholders, deliverables, work breakdown structure, work schedule, risk register, and communication strategy.
    - Added an old version of the project plan in Word format (Project Plan - Old.docx) for reference.
    - Deleted the previous project plan document (Project Plan.docx) to streamline documentation.
    - Introduced new Excel files for efficiency comparison and data visualization (Efficiency Comparison.xlsx, amCharts.xlsx, amCharts (1).xlsx).
    - Added a detailed design report for the GeecBuck converter (GeecBuck.pdf) outlin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
    [Efficiency Comparison.xlsx, amCharts (1).xlsx, amCharts.xlsx]
2025-11-10 Refactor Smooth Ramping Code: Adjust minimum and maximum accelerator signals, update maximum motor PWM, and improve target PWM mapping for smoother control. Added Steering Wheel code to fix delay iss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
    [Smooth_Ramping_Code.ino, Steering_Wheel_CLP.ino]
2025-11-14 Add summary results and requirements for Dyno Investigation; update isolation diagram and efficiency comparison files
    - Created SummaryResults.csv to log dyno test results.
    - Added requirements.txt for necessary Python packages (numpy, pandas, matplotlib, scipy).
    - Updated Isolation Diagram.drawio with new version and layout adjustments.
    - Updated Efficiency Comparison.xlsx with new data.
    - Added Isolation Diagram.drawio.png as a visual representation of the isolation diagram.
    [Dyno Test 2 Plan.xlsx, Efficiency Comparison.xlsx, PowerElec.PcbDoc, SummaryResults.csv]
2025-11-16 Added FET files
    [Current_Sense_Amplifier_Comparison_and_Error_Tool.xlsm, LoadRegulation.xlsx]
2025-11-17 Created cycle by cycle current control
2025-11-17 Created DFLOP circuit
2025-11-18 Current Limiter working reliably
2025-11-18 Added TVS diodes and compared different switching frequencies
2025-11-30 Test Commit in Altium
    [PE.SchDoc, PowerElec.PcbDoc]
2025-12-01 Added Potential sims for soft start Added Power Analyser Circuit
    [GeecOisinPE.PrjPcb, GeecPE.PrjPcb, PE.SchDoc, Progress.xlsx]
2025-12-06 Updated PE files
    [PE.SchDoc, PowerElec.PcbDoc]
2025-12-07 Updated schematic
    [GeecPE.PrjPcb, Isolation.SchDoc, PE.SchDoc, PowerElec.PcbDoc, Power_Stage.SchDoc, Power_Supply.SchDoc, Soft_Start.SchDoc]
2025-12-07 Capacitor Excel File
    [Capacitor Requirements.xlsx]
2025-12-08 Added more detail to schematic
    [GeecPE.PrjPcb, Isolation.SchDoc, PE.SchDoc, PowerElec.PcbDoc, Power_Stage.SchDoc]
2025-12-08 AddedcSoft start circuit
2025-12-09 Updated Schematic
    [Capacitor Requirements.xlsx, PowerElec.PcbDoc, Power_Stage.SchDoc]
2025-12-09 Fixed Capacitor
    [Capacitor Requirements.xlsx]
2025-12-10 Updated Schematic with Power Electronics
    [GeecPE.PrjPcb, Isolation.SchDoc, PE.SchDoc, Power_Stage.SchDoc, Soft_Start.SchDoc]
2025-12-10 More additions to the schematic
    [Capacitor Requirements.xlsx, MainSheet.SchDoc, PowerElec.PcbDoc, Power_Stage.SchDoc]
2025-12-12 Added Tasks
    [PE.SchDoc, Power_Stage.SchDoc, Soft_Start.SchDoc]
2025-12-12 annotated schematic
    [GeecPE.PrjPcb, Isolation.SchDoc, PE.SchDoc, PowerElec.PcbDoc, Power_Stage.SchDoc, Power_Supply.SchDoc, Soft_Start.SchDoc]
2025-12-14 Updated Schematic Added Variants for assembly and will add another one for implementation Added Comments and tasks
    [GeecPE.PrjPcb, Isolation.SchDoc, PE.SchDoc, Power_Stage.SchDoc, Power_Supply.SchDoc, Soft_Start.SchDoc]
2025-12-14 Added another task
    [PE.SchDoc]
2025-12-15 Start PCB
    [GeecPE.PrjPcb, Isolation.SchDoc, PE.SchDoc, PowerElec.PcbDoc, Power_Stage.SchDoc, Power_Supply.SchDoc, Soft_Start.SchDoc]
2025-12-15 Started Placement
    [PowerElec.PcbDoc]
2026-01-04 Added LEDs for multiple purposes
    [GeecPE.PrjPcb, Isolation.SchDoc, Mechanical.SchDoc, PE.SchDoc, Power_Stage.SchDoc, Power_Supply.SchDoc, Soft_Start.SchDoc]
2026-01-05 Updated a lot Created a rough layout of parts
    [GeecPE.PrjPcb, PE.SchDoc, Power_Supply.SchDoc, Soft_Start.SchDoc]
2026-01-05 Updated layout
    [GeecPE.PrjPcb, Isolation.SchDoc, PE.SchDoc, Soft_Start.SchDoc]
2026-01-05 Commiting ALtium Files and presentation
    [Bill of Materials-GeecPE(Assembly Variant).xlsx, Capacitor Requirements.xlsx, GeecPE.xlsx, PE.SchDoc, Pick Place for PowerElec(Assembly Variant).csv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]
2026-01-07 More Routing
    [GeecPE.PrjPcb, Isolation.SchDoc, Mechanical.SchDoc, PE.SchDoc, Power_Stage.SchDoc, Power_Supply.SchDoc, Soft_Start.SchDoc]
2026-01-13 Added Isolated Op Amp Verification
    [ADuM3190 Performance.xlsx, GeecPE.PrjPcb, Pick Place for PowerElec(Assembly Variant).csv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]
2026-01-13 Changed the Board shape
    [GeecPE.PrjPcb, Isolation.SchDoc, Power_Stage.SchDoc]
2026-01-13 Updated Equations
    [GeecPE.PrjPcb, Isolation.SchDoc, Power_Stage.SchDoc]
2026-01-13 Restored Power Plaanes
2026-01-14 Added Keepout under inductors
    [GeecPE.PrjPcb]
2026-01-15 copiexd Capacitors requirements
    [Capacitor Requirements - Copy.xlsx]
2026-01-18 Added potential substitues for the Isolation components
    [Isolation.SchDoc, Power_Supply.SchDoc]
2026-01-20 ASSEMBLY VERSION Added substitute parts
    [Isolation.SchDoc, Power_Stage.SchDoc, Power_Supply.SchDoc, Soft_Start.SchDoc]
2026-01-20 All files updated
    [Bill of Materials-GeecPE(Assembly Variant).xlsx, Pick Place for PowerElec(Assembly Variant).csv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]
2026-01-22 Fixed iGND 11V short in Testpoint
2026-01-26 Added test for DAC
    [Comparator.xlsx]
2026-01-26 Updated files Hardware testing
    [ADuM3190 Performance.xlsx, CFProject Budget.xlsx, Capacitor Requirements.xlsx]
2026-02-03 Added the PWM frequency setting back
2026-02-04 Uploade Images
    [1.csv.xlsx, ADuM3190 Performance.xlsx, CFProject Budget.xlsx, Capacitor Requirements.xlsx]
2026-02-07 Uploaded invoices and other details Started the Power Controller PCB
    [Capacitor Requirements.xlsx, CurrentControl.SchDoc, GeecPC.PrjPcb, PC.SchDoc]
2026-02-07 Power Controller Document
2026-02-10 Add INA780 sensor class and Power Meter test implementation
2026-02-10 Add pulldown resistor configuration for MCPWM pins in setup
2026-02-11 PWM resolution 0.03% increments Half bridge appears to work at 100% duty cycle
2026-02-15 Added PowerController schematic
    [CurrentControl.SchDoc, GeecPC.PrjPcb, Power.SchDoc]
2026-02-17 Grounded Excess pins
    [GeecPC.PrjPcb, PC.SchDoc]
2026-02-17 Updated preselect
    [PC.SchDoc]
2026-02-17 Created PCB and started layout
    [GeecPC.PrjPcb, PC.SchDoc]
2026-02-23 Circuit Nearly finished
    [GeecPC.PrjPcb, PC.SchDoc]
2026-02-23 Refactor PWM control to implement ramping behavior for duty cycle adjustments
    - Introduced targetDutyCycle variable to manage desired duty cycle.
    - Added ramping logic in pwmTask to gradually adjust currentDutyCycle towards targetDutyCycle.
    - Updated commandTask to set targetDutyCycle instead of currentDutyCycle directly.
    - Modified watchdogTask to ramp down to 0% on timeout.
    - Enhanced sensorTask output to display both current and target duty cycles.
    - Added new files: PowerFactor.mp4 and scope_25.png for oscilloscope data.
    - Created Draft5.net for LTspice simulation.
2026-02-23 Final PC Version
    [GeecPC.PrjPcb, PC.SchDoc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]
2026-02-23 Manufactured board If possible modify solder mask expansion
    [PowerController.GBL, PowerController.GBO, PowerController.GBP, PowerController.GBS, PowerController.GTL, PowerController.GTO, PowerController.GTP, PowerController.GTS]
2026-02-25 Updated Some files Created a test script to run through the full duty cycle
    [GeecPC.PrjPcb, duty_sweep_results_20260225-112430.csv]
2026-02-25 Add motor current measurement and update sensor data parsing
2026-02-26 Saving raw data
    [duty_sweep_results_20260226-095839.csv]
2026-02-26 Full Experimental run of Duty Cycle Sweep
    [duty_sweep_results_20260226-102921.csv, duty_sweep_results_20260226-102921_raw.csv, duty_sweep_results_20260226-113415.csv, duty_sweep_results_20260226-113415_raw.csv, duty_sweep_results_20260226-114449.csv, duty_sweep_results_20260226-114449_raw.csv, duty_sweep_results_20260226-115720.csv, duty_sweep_results_20260226-115720_raw.csv]
2026-03-01 Add command handling, PWM control, sensor reading, and watchdog tasks
2026-03-03 Add duty sweep result CSV files for investigation
    - Created new CSV files containing duty sweep results with various parameters including SetDutyCycle, MeasuredDutyCycle, Voltage, Current, Power, Energy, Temperature, MotorCurrent, SamplesCount, Dyno RPM, Car RPM, Dyno Torque, Dyno Power, and Dyno Samples Count.
    - Files added:
    - duty_sweep_results_20260226-132431.csv
    - duty_sweep_results_20260226-132654.csv
    - duty_sweep_results_20260226-133023.csv
    - duty_sweep_results_20260226-133459.csv
    - duty_sweep_results_20260226-133929.csv
    [PC.SchDoc, duty_sweep_results_20260226-131941.csv, duty_sweep_results_20260226-132431.csv, duty_sweep_results_20260226-132654.csv, duty_sweep_results_20260226-133023.csv, duty_sweep_results_20260226-133459.csv, duty_sweep_results_20260226-133929.csv]
2026-03-04 Fix DAC address and enhance I2C scanning with status reporting
    [DAQ_Test.ino]
2026-03-04 Refactor GPIO pin definitions and update sensor reading logic for consistency
2026-03-12 Power Controller PCB Rev 2
    [GeecPC.PrjPcb, PC.SchDoc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]
2026-03-12 Rev 2 - 12 Mar 2026 - Added new file and modified existing files for PowerController project. Updated design rule check, gerber files, and project outputs. Also made changes to the schematic preview.
2026-03-20 Add current sensor data and new simulation draft
    - Added a new Excel file `currentSensor.xlsx` for current sensor data.
    - Created a new simulation draft `Draft6.asc` with circuit design including resistors, voltage sources, and an operational amplifier.
    [Comparator-CH1.csv, Comparator-CH2.csv, Comparator-CH3.csv, Comparator-CH4.csv, currentSensor.xlsx, dyno_sweep_20260320-165549.csv, dyno_sweep_20260320-165921.csv, dyno_sweep_20260320-165957.csv]
2026-03-22 Updated some elements
    [GeecPC.PrjPcb, PC.SchDoc]
2026-03-22 Add Power Electronics PDF and enhance dyno sweep data handling
    - Introduced a new PDF document for Power Electronics in the project outputs.
    - Updated the `run_dyno_sweep_gui.py` to maintain the last known values for voltage, motor current, power, and temperature.
    - Emitted updated data during the dyno sweep process to ensure consistent data reporting.
    - Improved the handling of speed and other parameters during acceleration and coast phases.
2026-03-24 Added results of Dyno automated Testing
    [Test-1s_ramp_15A.csv, Test-1s_ramp_15A_45kHz.csv, Test-1s_ramp_15A_60kHz.csv, Test-1s_ramp_25A_30kHzz.csv, Test-1s_ramp_25A_60kHz.csv, Test-2s_ramp_15A.csv, Test-5s_ramp_15A.csv, Test-60s_ramp_15A.csv]
2026-03-24 optocoupler schematic
2026-03-25 moved some files and created final PE code
    [Motor Voltage Calibration.xlsx, dyno_sweep_20260320-165549.csv, dyno_sweep_20260320-165921.csv, dyno_sweep_20260320-165957.csv, dyno_sweep_20260320-170233.csv, dyno_sweep_20260323-113307.csv, dyno_sweep_20260323-113445.csv, dyno_sweep_20260323-113517.csv]
2026-03-26 Mounting Plates for PE
    [Geec PE - Bottom Cover.dxf, GeecPE - Top Cover.dxf]
2026-03-27 Test code doesn't work
    [dyno_sweep_20260326-201657.csv]
2026-03-28 Updated current limits based on oscilliscope results
    [Geec PE - Bottom Cover.dxf, GeecPE - Top Cover.dxf]
2026-03-30 Working Result
    [dyno_sweep_20260327-153340.csv]
2026-03-30 Refactor PWM configuration and add I2C bus scanner functionality
2026-03-31 Update motor voltage calculation in SensorTask and add calibration script for VmotLP
2026-04-01 Default current limit 20A
2026-04-06 Some files for the poster
    [Poster.kicad_pcb, Poster.kicad_sch]
2026-04-07 Test Experiment 07-04-26
    [dyno_sweep_20260407-162331.csv, dyno_sweep_20260407-163411.csv]
2026-04-07 Add run_dyno_sweep_gui executable to distribution
    [dyno_sweep_20260407-170950.csv]
2026-04-07 Added Current calibration from DAC, not 100% accurate but close enough
2026-04-07 Add battery energy capacity estimation tools and analysis plots
    - Introduced `battery_energy_capacity_estimator.py` for estimating battery energy capacity from voltage and current data, including voltage sag compensation and various calculation methods.
    - Added `calculate_battery_energy.py` for a simpler energy calculation using basic integration.
    - Created `battery_analysis.png` for visualizing battery performance metrics.
    - Generated `energy_capacity_summary.csv` to store energy estimation results.
    - Included a simulation schematic in `Draft7.asc` for circuit analysis.
    [DynoResult1.csv, SEM1-Results.csv, energy_capacity_summary.csv]
2026-05-11 Add flow diagram, watchdog task comments, and comparator graphs with images
    [Investigation.xlsx]
2026-05-26 Add sample SD card file and thesis documents
    Added DAQ and Screen Code
    [lap21-(sample_sd_card_file).xlsx]
2026-05-26 Moved old code to a sub folder
    [Dyno Test 2 Plan.xlsx, Geec PE - Bottom Cover.dxf, GeecPE - Top Cover.dxf, SummaryResults.csv, Test-1s_ramp_15A.csv, Test-1s_ramp_15A_45kHz.csv, Test-1s_ramp_15A_60kHz.csv, Test-1s_ramp_25A_30kHzz.csv]
2026-05-27 Uploaded some results
    [dyno_sweep_20260408-094049.csv, dyno_sweep_20260408-095354.csv, dyno_sweep_20260408-095658.csv, dyno_sweep_20260420-132728.csv, dyno_sweep_20260420-134159.csv, dyno_sweep_20260420-142344.csv]
2026-06-24 Updated steering wheel and power electronics to include current mode setting, default 20A limit, secondary 30A limit
